bfrigon/alarm-clock-hardware/README.md

alarm-clock
===========

Project page at http://www.bfrigon.com/posts/projects/alarm-clock
