bfrigon/alarm-clock-hardware/drawings/schematics/README.md

Index
-----

Doc ID     | Part #            | Description
-----------|-------------------|-------------------------------------------------
CLK-SCH-01 | CLK-PC-01         | Led Matrix display board (Model A)
CLK-SCH-02 | CLK-PC-02         | Touch keypad
CLK-SCH-03 | CLK-PC-03         | Motherboard
CLK-SCH-04 | CLK-PC-04         | Left panel PCB
CLK-SCH-05 | CLK-PC-05         | Display (model B) - Segments PCB Schematic
CLK-SCH-06 | CLK-PC-06         | Display (model B) - Dots PCB Schematic
CLK-SCH-07 | CLK-PC-07         | Display (model B) - Base PCB Schematic
CLK-SCH-08 | CLK-PC-08         | Battery interface
CLK-SCH-50 | TST-CLK-PC-03-AUD | Test - PCM2704C + TPA2005 Eval board
CLK-SCH-51 | CLK-PC-01-PROG    | PIC programmer adapter for CLK-PC-01
