bfrigon/alarm-clock-hardware/drawings/design/README.md

Index
-----

Doc ID        | Part #            | Description
--------------|-------------------|-------------------------------------------------
CLK-DWG       | --                | Alarm clock (Model A)
CLK-DWG-MODEL-B | --              | Alarm clock (Model B)
CLK-DWG-01    | CLK-PC-01         | Led Matrix display board dimensions
CLK-DWG-02    | CLK-PC-02         | Touch keypad dimensions
CLK-DWG-03    | CLK-PC-03         | Motherboard dimensions
CLK-DWG-05    | CLK-PC-04         | Left panel PCB dimensions
CLK-DWG-06    | CLK-STR-01        | Display base
CLK-DWG-07    | CLK-OVL-01        | Keypad overlay
CLK-DWG-08    | CLK-PC-05         | Display (model B) - Segments PCB
CLK-DWG-09    | CLK-PC-06         | Display (model B) - Dots PCB
CLK-DWG-10    | CLK-PC-07         | Display (model B) - Base PCB
CLK-DWG-11    | CLK-STR-02        | Speaker holder
CLK-DWG-12    | CLK-PC-08         | Battery interface PCB
CLK-DWG-20    | CLK-AS-05         | Motherboard assembly
CLK-DWG-21    | CLK-AS-04         | Left panel PCB assembly
CLK-DWG-22    | CLK-AS-03         | Display (model A) - LED matrix
CLK-DWG-23    | CLK-AS-01         | Display (model A) - LED matrix PCB assembly
CLK-DWG-24    | CLK-AS-02         | Display (model A) - Assembly
CLK-DWG-25    | --                | Final assembly (Model A)
CLK-DWG-26    | CLK-AS-07         | Display (model B) - Segment PCB Assembly
CLK-DWG-27    | CLK-AS-08         | Display (model B) - Base PCB Assembly
CLK-DWG-28    | CLK-AS-06         | Display (model B) - Assembly
CLK-DWG-29    | CLK-AS-09         | Display (model B) - Dots PCB Assembly
CLK-DWG-30    | --                | Final assembly (Model B)
