bfrigon/alarm-clock-hardware/pcb/battery-interface/README.md

### Battery interface ###

```
Part #  : CLK-PC-08
REV.    : A
```

#### Documents ####

* [Schematic (PDF)](https://raw.githubusercontent.com/bfrigon/project-alarm-clock/master/drawings/schematics/clk-sch-08.pdf)
* [Bill of material](/pcb/battery-interface/bom/bom.md)
