bfrigon/alarm-clock-hardware/pcb/left-panel/README.md

### Left panel ###

```
Part #  : CLK-PC-04
REV.    : A
```

#### Documents ####

* [Schematic (PDF)](https://raw.githubusercontent.com/bfrigon/project-alarm-clock/master/drawings/schematics/clk-sch-04.pdf)
* [Bill of material](/pcb/left-panel/bom/bom.md)

#### 3D render ####

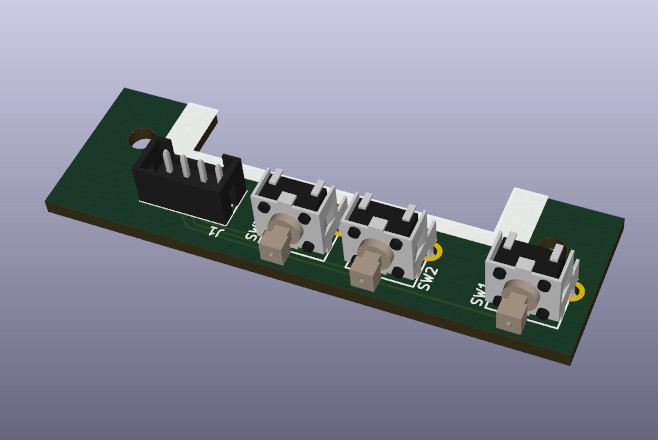
[picture p1: pcb/left-panel/3d/front.jpg]
Front view
