bfrigon/alarm-clock-hardware/pcb/motherboard/README.md

### Motherboard ###

```
Part #  : CLK-PC-03
REV.    : A
```

#### Documents ####

* [Schematic (PDF)](https://raw.githubusercontent.com/bfrigon/project-alarm-clock/master/drawings/schematics/clk-sch-03.pdf)
* [Bill of material](/pcb/motherboard/bom/bom.md)

#### 3D render ####

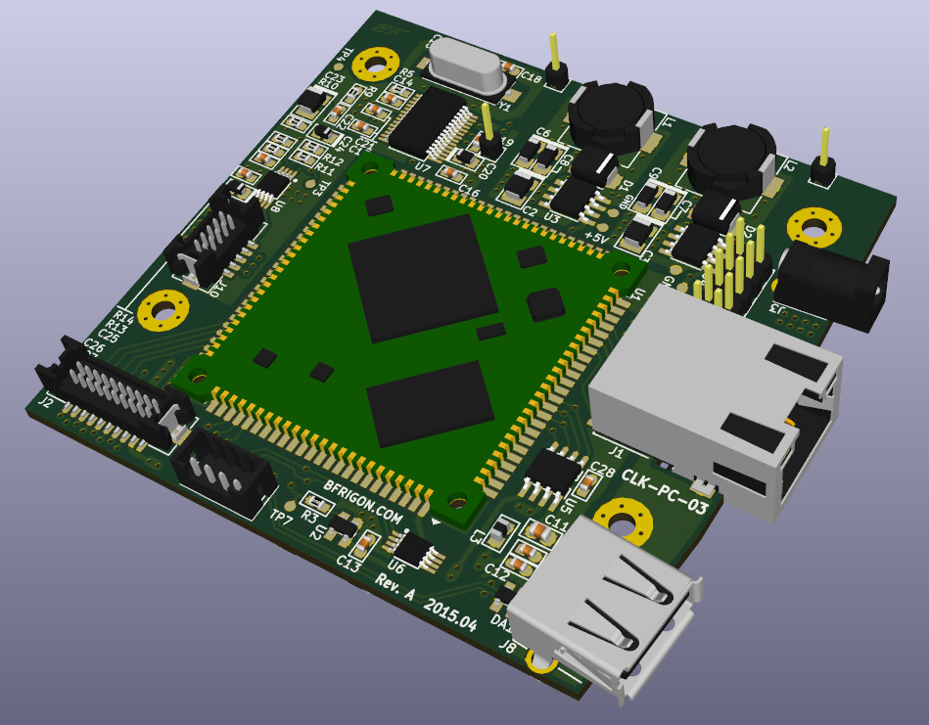
[picture p2: pcb/motherboard/3d/front.jpg]
Front view
