bfrigon/alarm-clock-hardware/docs/notes/psu.md

### Power requirements ###

Description        | 5V        |  3.3V
-------------------|-----------|----------------
USB A (external)   | 500 mA    | --
USB B (internal)   | 500 mA    | --
Display            | --        | 1250 mA
CPU                | --        | 400 mA
Audio DAC          | 50 mA     | --
Amplifier          | 400 mA    | --
Touch keypad       | --        | 65 mA
-------------------|-----------|----------------
Total              | 1450 mA   | 1700mA
-------------------|-----------|---------------
+~25% overhead     | 1800 mA   | 2125mA
