bfrigon/alarm-clock-hardware/drawings/artwork/overlay-rev-a.pdf

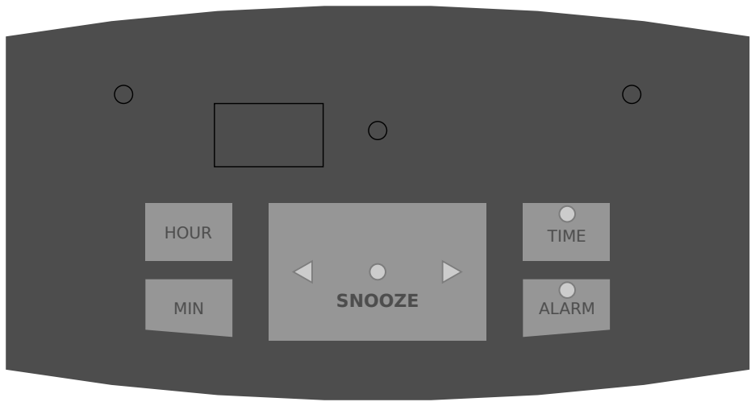
[picture p3: figure]
HOUR; MIN; TIME; ALARM SNOOZE
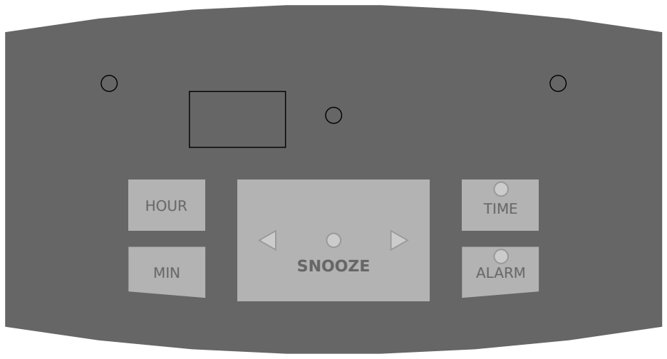
[picture p4: figure]
HOUR; MIN; TIME; ALARM SNOOZE
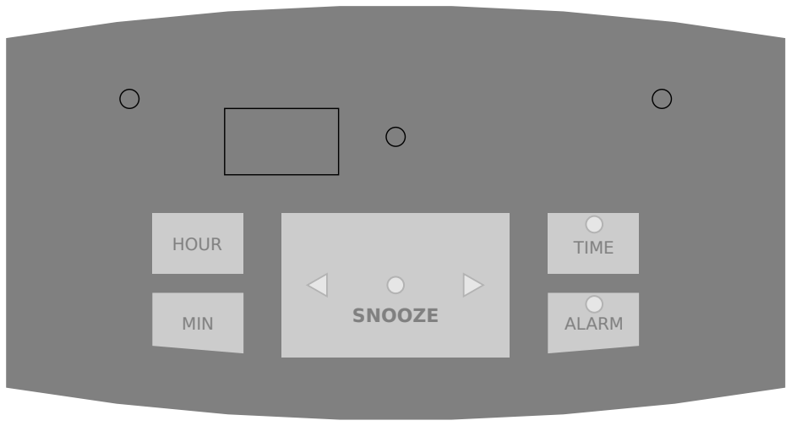
[picture p5: figure]
HOUR; MIN; TIME; ALARM SNOOZE
