bfrigon/alarm-clock-hardware/docs/model-render/concepts/concept.jpg

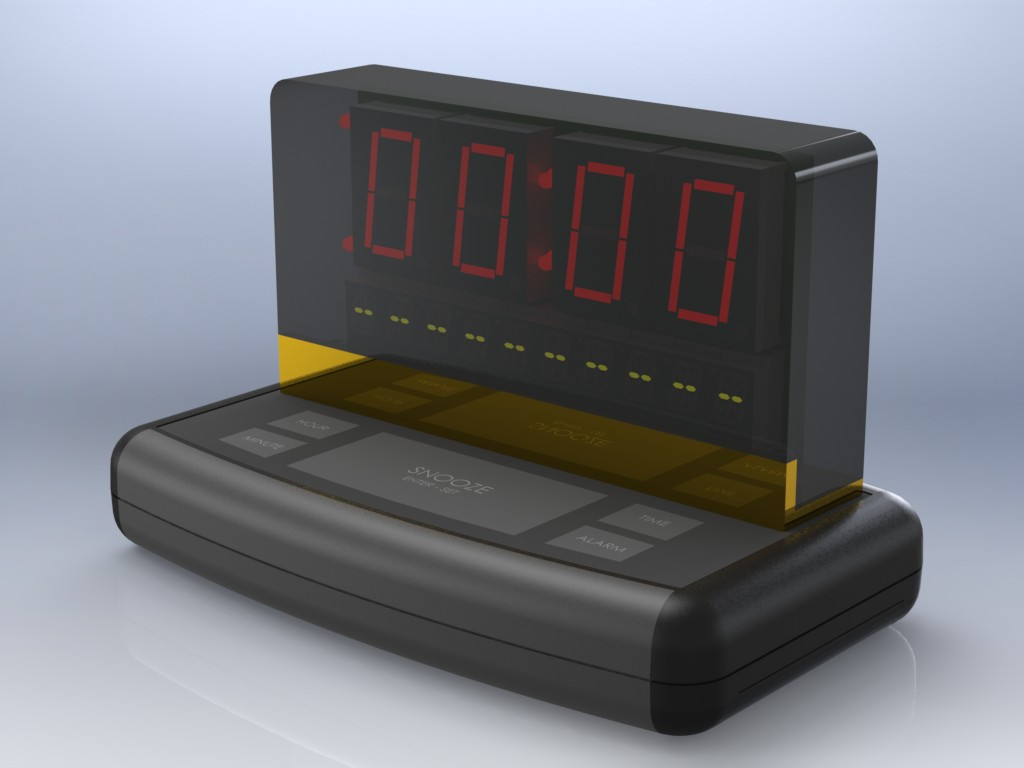
docs/model-render/concepts/concept.jpg
