bfrigon/alarm-clock-hardware/docs/model-render/concepts/concept_3.jpg

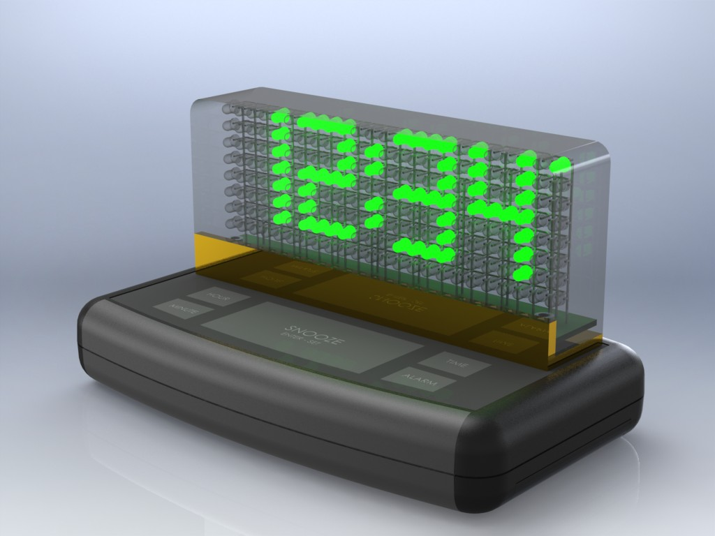
docs/model-render/concepts/concept_3.jpg
