bfrigon/alarm-clock-hardware/docs/model-render/model-a-back.jpg

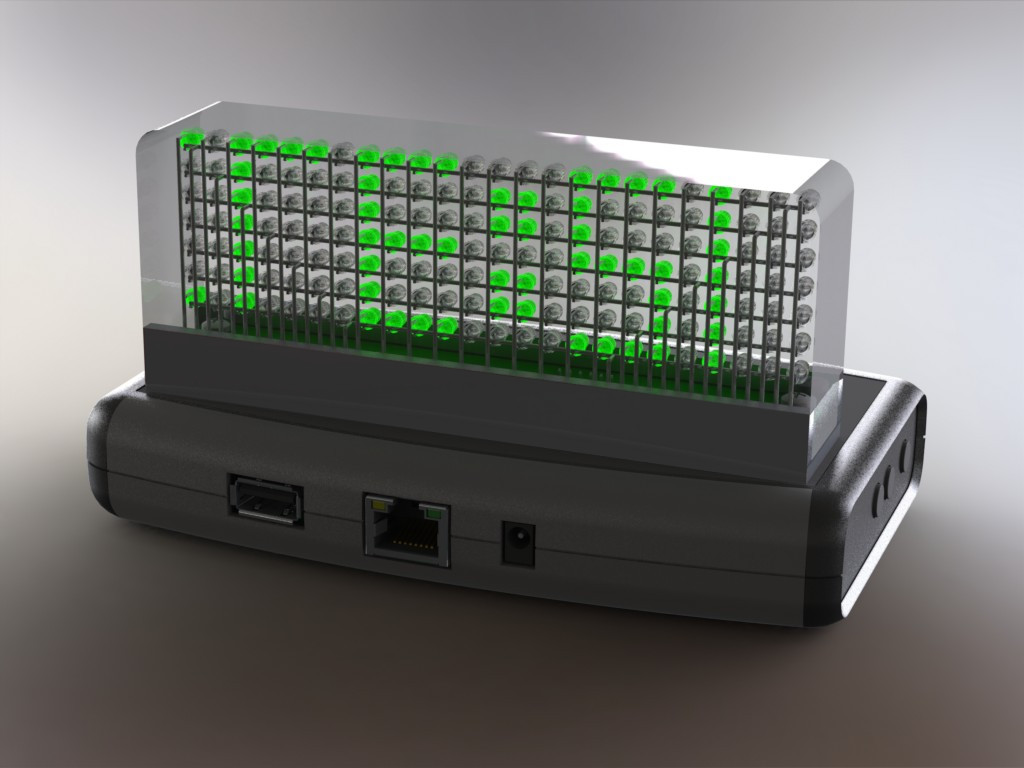
docs/model-render/model-a-back.jpg
