bfrigon/alarm-clock-hardware/docs/model-render/model-a-dark.jpg

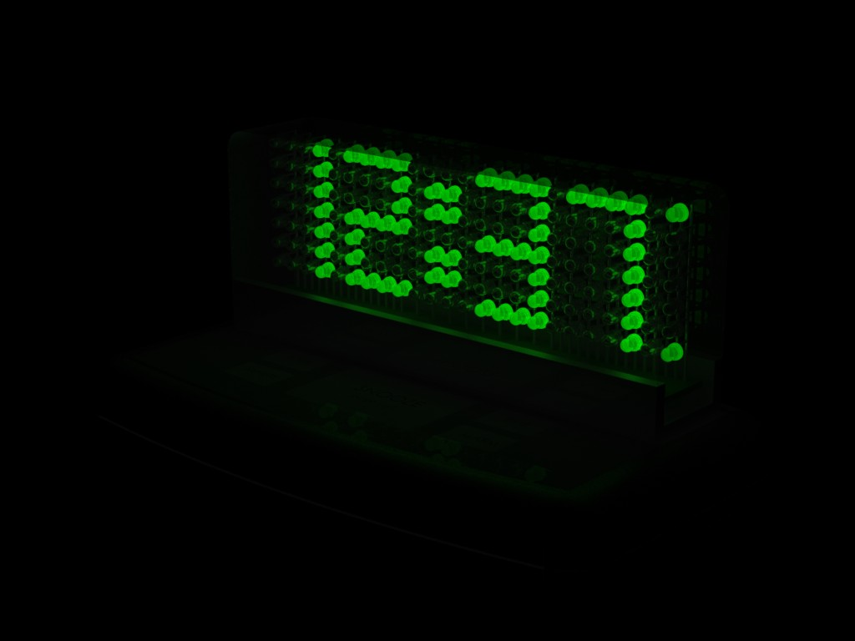
docs/model-render/model-a-dark.jpg
