bfrigon/alarm-clock-hardware/docs/model-render/model-a-mb.jpg

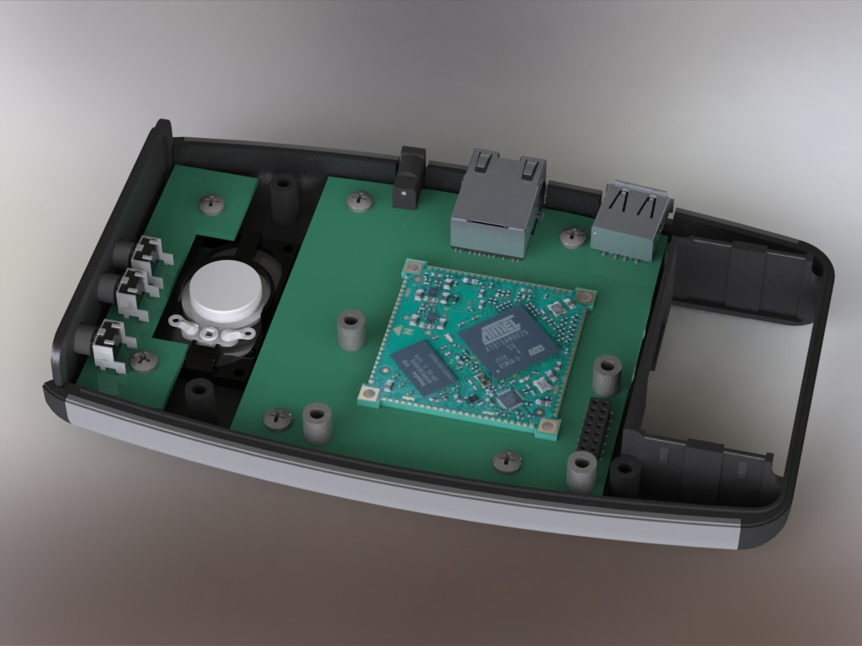
docs/model-render/model-a-mb.jpg
