bfrigon/alarm-clock-hardware/docs/model-render/model-a.jpg

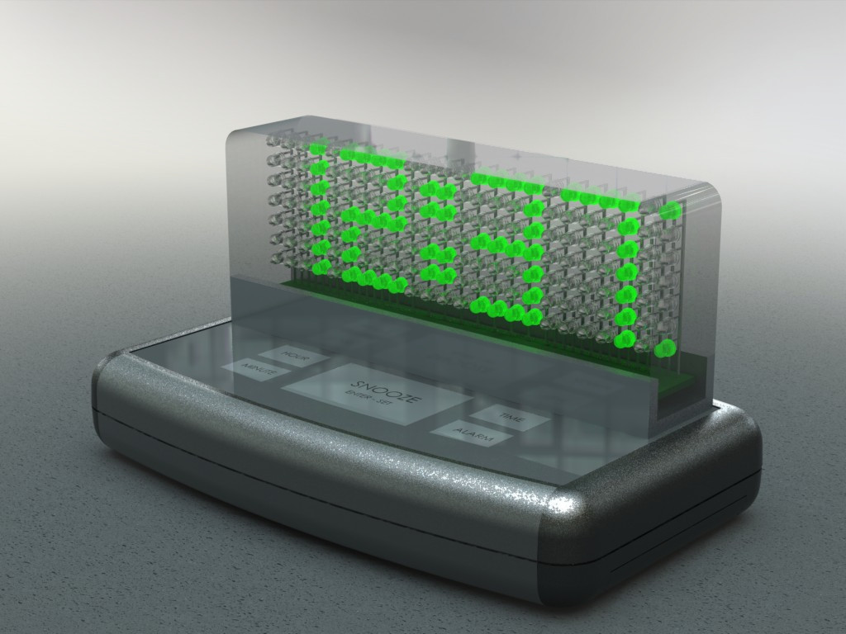
docs/model-render/model-a.jpg
