bfrigon/alarm-clock-hardware/docs/model-render/model-b.jpg

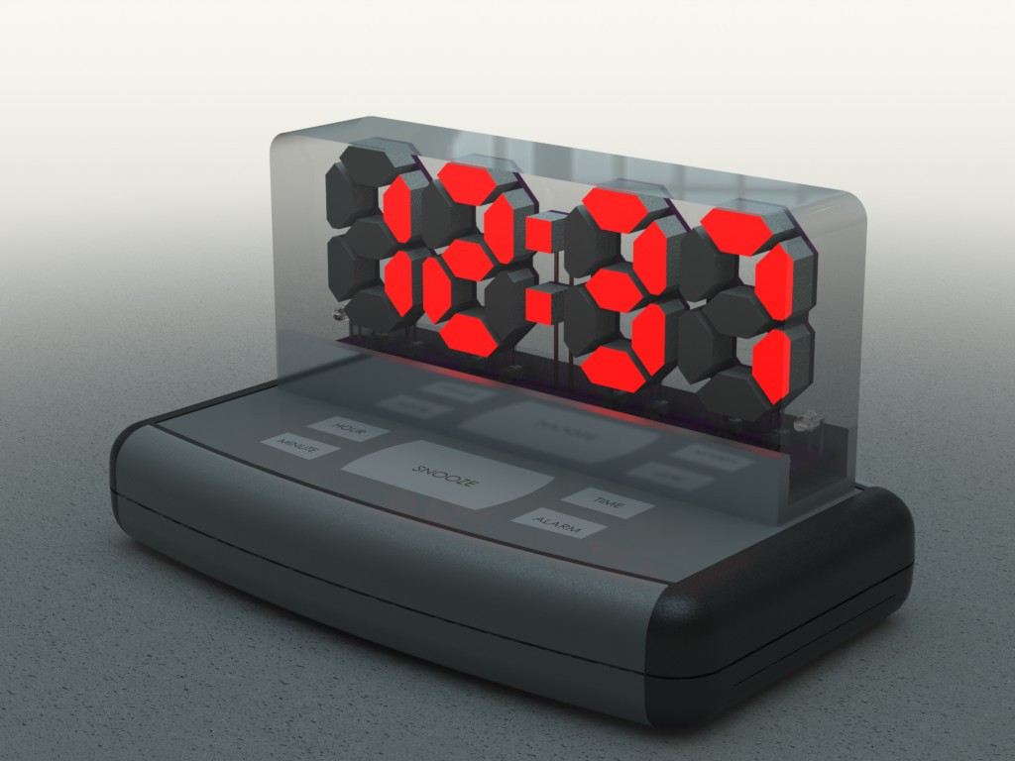
docs/model-render/model-b.jpg
