bfrigon/alarm-clock-hardware/pcb/motherboard/3d/back.jpg

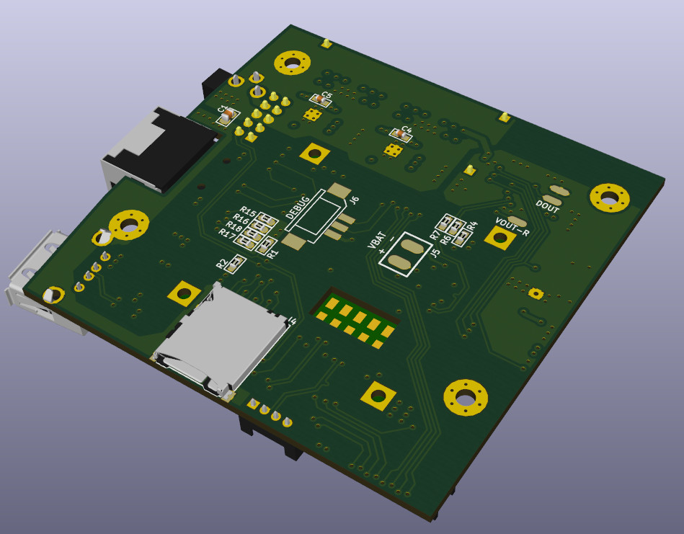
pcb/motherboard/3d/back.jpg
