bfrigon/alarm-clock-hardware/pcb/motherboard/bom/bom.md

### Bill of material ###

```
Date    : Sun 12 Apr 2015
Doc. ID : CLK-SCH-03
Project : Alarm Clock
Title   : Motherboard

Part #  : CLK-PC-03
REV.    : A

Components : 73
```

------------------------------------------------------------------------------------------------------------------------

| Qty | Ref. | Description | Value | Part # | Footprint |
|-----|---|---|---|---|---|
| 3 | J11-J12, J16 | Header - Single Row - 1 Pos | - | 103741-1 | HDR-M-1x01 |
| 1 | J9 | Header - Dual Row - 10 Pos | - | 103777-5 | HDR-M-2x05 |
| 1 | J8 | USB Connector - Type A | - | 292303-1 | USBA-TE-292303-1 |
| 1 | J1 | RJ45 Connector with magnetics and leds | - | 7498011122R | RJ45-WURTH-7498011122R  |
| 1 | J10 | Header - Dual Row - 10 Pos | - | DF13A-10DP-1.25V | DF13A-10DP-1.25 |
| 1 | J2 | Header - Dual Row - 20 Pos | - | DF13A-20DP-1.25V(25) | DF13A-20DP-1.25 |
| 1 | J7 | Header - Single Row - 4 Pos | - | DF3A-4P-2DSA | DF3A-4P-2DSA |
| 1 | J6 | Header - Single Row - 3 Pos | - | DF3DZ-3P-2V21 | DF3DZ-3P-2VXX |
| 1 | J4 | Micro SD card connector | - | DM3AT-SF-PEJM5 | HIROSE-MICROSD-DM3AT-SF |
| 1 | J3 | DC Barrel Jack | - | PJ-013C | CUI-PJ-031CH |
| 1 | U3 | 2A Step-down regulator | - | ADP2302ARDZ-5.0 | SOIC-8-EP |
| 1 | U4 | 3A Step-down regulator | - | ADP2303ARDZ-3.3 | SOIC-8-EP |
| 1 | U1 | AT91SAM9G25 SoM | - | ARIA-G25 | Misc:ARIA-G25 |
| 1 | U2 | 4-Pin Microprocessor Power Supply Supervisors | - | CAT811TTBI-T3 | SOT-143 |
| 1 | U5 | Dual port USB power switch with OC protection | - | LM3526M-H | SOIC-8 |
| 1 | U6 | Digital Temperature Sensor | - | MCP9804 | MSOP8 |
| 1 | U7 | Stereo Audio DAC with USB Interface | - | PCM2704C | SSOP28 |
| 1 | U8 | 1.4W Mono Class-D Audio Amplifier | - | TPA2005 | PPSOP8 |
| 1 | C22 | capacitor | 0.022uF (10V) | - | SMT-0603 |
| 2 | R4-R5 | Resistor | 1.5k | - | SMT-0603 |
| 6 | R11, R14-R18 | Resistor | 100k | - | SMT-0603 |
| 2 | C4-C5 | capacitor | 100nF 25V | - | SMT-0603 |
| 4 | C10, C12-C13, C28 | capacitor | 100nF | - | SMT-0603 |
| 1 | C23 | Electrolytic capacitor | 100uF (10V) | - | SMT-1210 |
| 1 | C11 | capacitor | 100uF | - | SMT-0805 |
| 2 | R1-R2 | Resistor | 10k | - | SMT-0603 |
| 2 | C20, C27 | Electrolytic capacitor | 10uF | - | SMT-0805 |
| 1 | Y1 | Crystal | 12.00 Mhz | - | HC49UP |
| 2 | R12-R13 | Resistor | 150k | - | SMT-0603 |
| 1 | R9 | Resistor | 16 (1%) | - | SMT-0603 |
| 2 | C15, C18 | capacitor | 18pF | - | SMT-0603 |
| 1 | L3 | Inductor | 1A | - | SMT-0805 |
| 1 | R8 | Resistor | 1M | - | SMT-0603 |
| 1 | C1 | capacitor | 1nF (1kV) | - | SMT-0805 |
| 1 | C24 | Electrolytic capacitor | 1uF (10V) | - | SMT-0805 |
| 7 | C14, C16-C17, C19, C21, C25-C26 | capacitor | 1uF | - | SMT-0603 |
| 1 | R3 | Resistor | 2.2k | - | SMT-0603 |
| 2 | R6-R7 | Resistor | 22 | - | SMT-0603 |
| 1 | R10 | Resistor | 330 | - | SMT-0603 |
| 1 | DA1 | TVS Diode Array | CD143A-SR05 | - | SOT-143 |
| 2 | L1-L2 | Inductor | 4.3uH | 7443552430 | SMT:IND-10X10 |
| 2 | D1-D2 | Diode | 30V 2A | B320B-13-F | SMT:DO-214-AA |
| 2 | C2-C3 | Electrolytic capacitor | 100uF (16v) | EMK325ABJ107MM-T | SMT-1210 |
| 2 | C7, C9 | Electrolytic capacitor | 47uF (6.3v) | GRM31CR60J476ME19K | SMT-1206 |
| 2 | C6, C8 | Electrolytic capacitor | 47uF (10v) | LMK316BJ476ML-T | SMT-1206 |
