bfrigon/alarm-clock-hardware/pcb/left-panel/bom/bom.md

### Bill of material ###

```
Date    : Thu 19 Mar 2015
Doc. ID : CLK-SCH-04
Project : Alarm Clock
Title   : Left Panel

Part #  : CLK-PC-04
REV.    : A

Components : 4
```

------------------------------------------------------------------------------------------------------------------------

| Qty | Ref. | Description | Value | Part # | Footprint |
|-----|---|---|---|---|---|
| 1 | J1 | Header - Single Row - 4 Pos | - | DF3A-4P-2DSA | DF3A-4P-2DSA |
| 3 | SW1-SW3 | Momentary SPST switch with ground tabs | - | B3F-3150 | Switches:B3F-315X |
