bfrigon/alarm-clock-hardware/pcb/display-model-a/bom/bom.ods

Bill of material - Title (Rev. A) Part #
Qty. | Part ID | Description | Mfg. SKU | Manufacturer | Package | Value
3
