bfrigon/alarm-clock-hardware/drawings/digits_segments_cuts.dxf

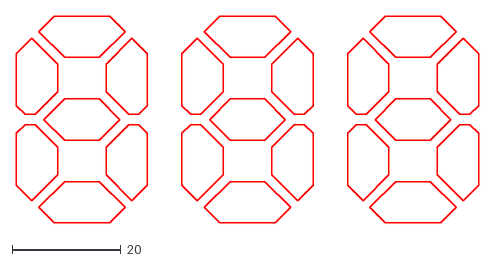
[picture p14: CAD file, 2014-10-28]
drawings/digits_segments_cuts.dxf
85.1 x 38.1
