bfrigon/alarm-clock-hardware/drawings/enclosure_cuts_back.dxf

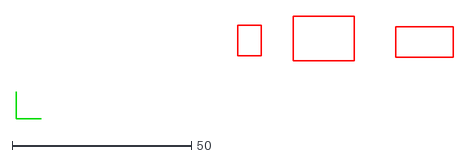
[picture p15: CAD file, 2014-10-28]
drawings/enclosure_cuts_back.dxf
121.8 x 28.7
