bfrigon/alarm-clock-hardware/drawings/design/clk-dwg-24.pdf

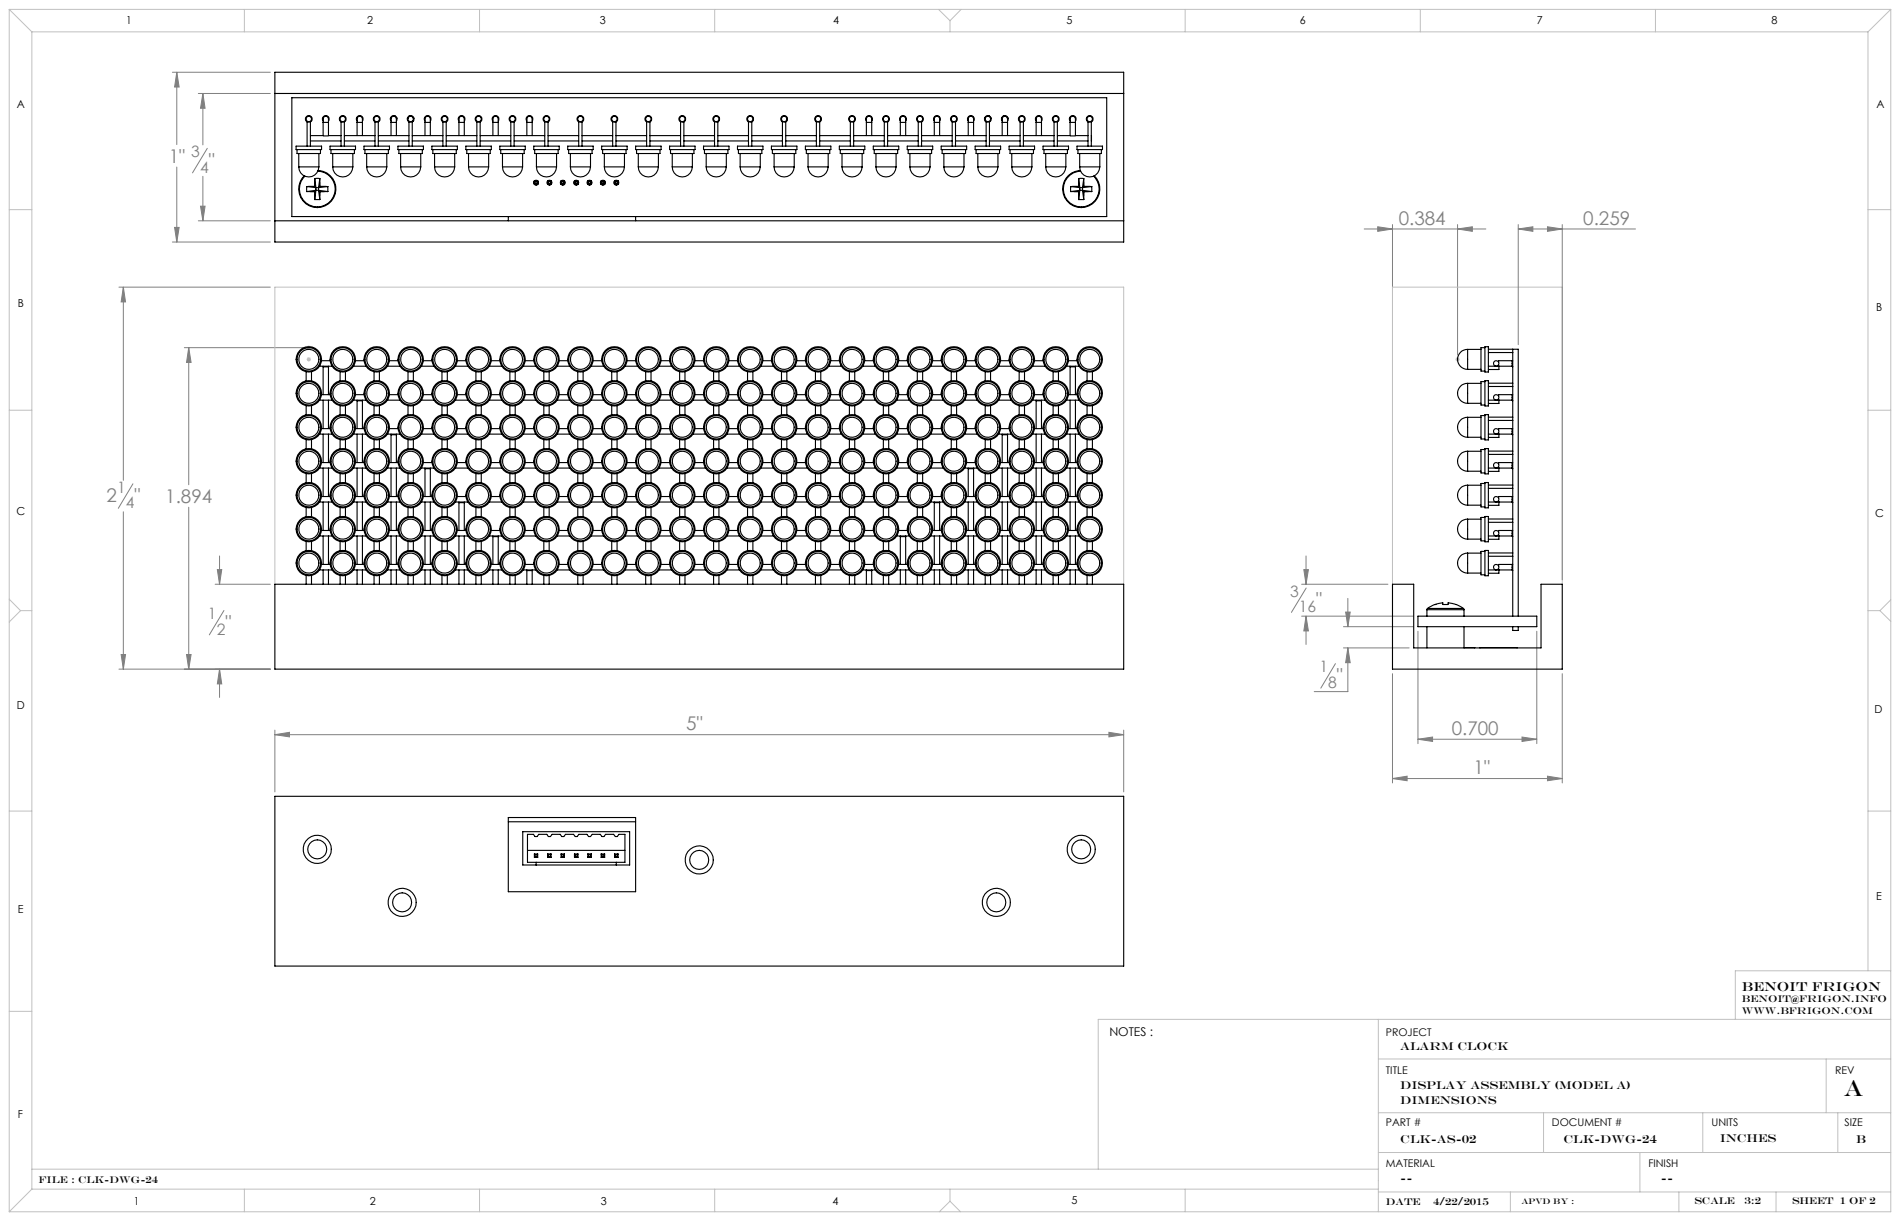
[picture p16: page 1]
SHEET 1 OF 2; Alarm Clock; Display Assembly (Model A); PART #; DOCUMENT #; UNITS; DATE 4/22/2015; SCALE 3:2; NOTES :; APVD BY :

BENOIT FRIGON
benoit@frigon.info
www.bfrigon.com

File : clk-dwg-24

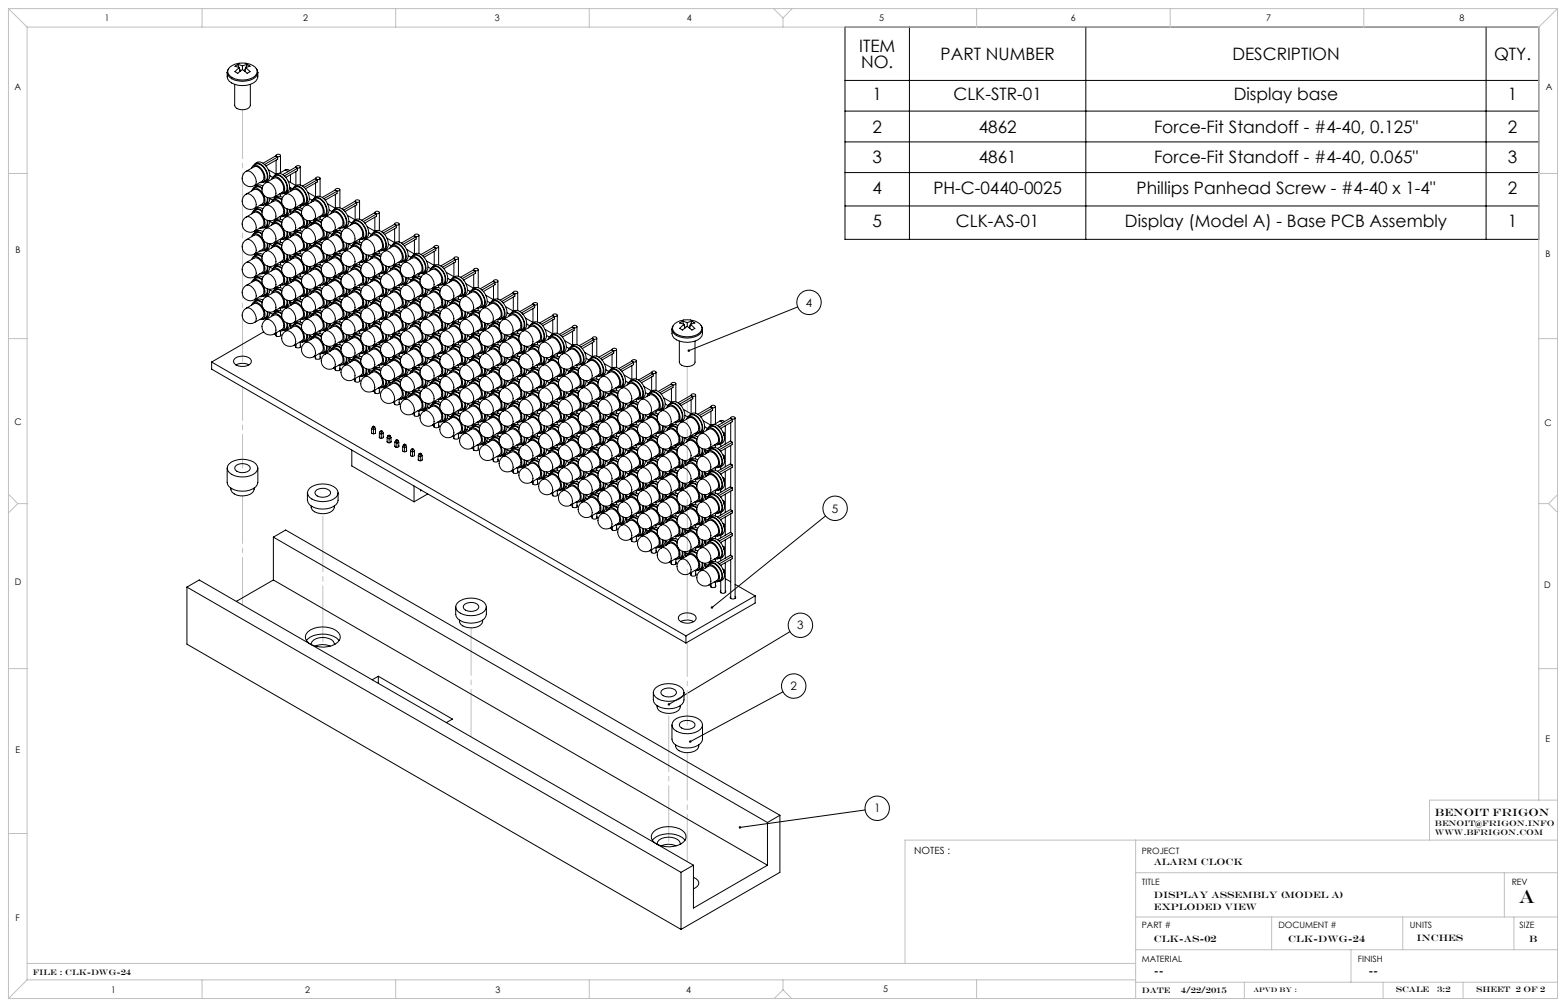
[picture p17: page 2]
SHEET 2 OF 2; Alarm Clock; Display Assembly (Model A); PART #; DOCUMENT #; UNITS; DATE 4/22/2015; SCALE 3:2; NOTES :; Exploded view; APVD BY :

ITEM NO. | PART NUMBER | DESCRIPTION | QTY.

1 | CLK-STR-01 | Display base | 1
2 | 4862 | Force-Fit Standoff - #4-40, 0.125" | 2
3 | 4861 | Force-Fit Standoff - #4-40, 0.065" | 3
4 | PH-C-0440-0025 | Phillips Panhead Screw - #4-40 x 1-4" | 2
5 | CLK-AS-01 | Display (Model A) - Base PCB Assembly | 1

BENOIT FRIGON
benoit@frigon.info
www.bfrigon.com

File : clk-dwg-24
