bfrigon/alarm-clock-hardware/drawings/design/clk-dwg-25.pdf

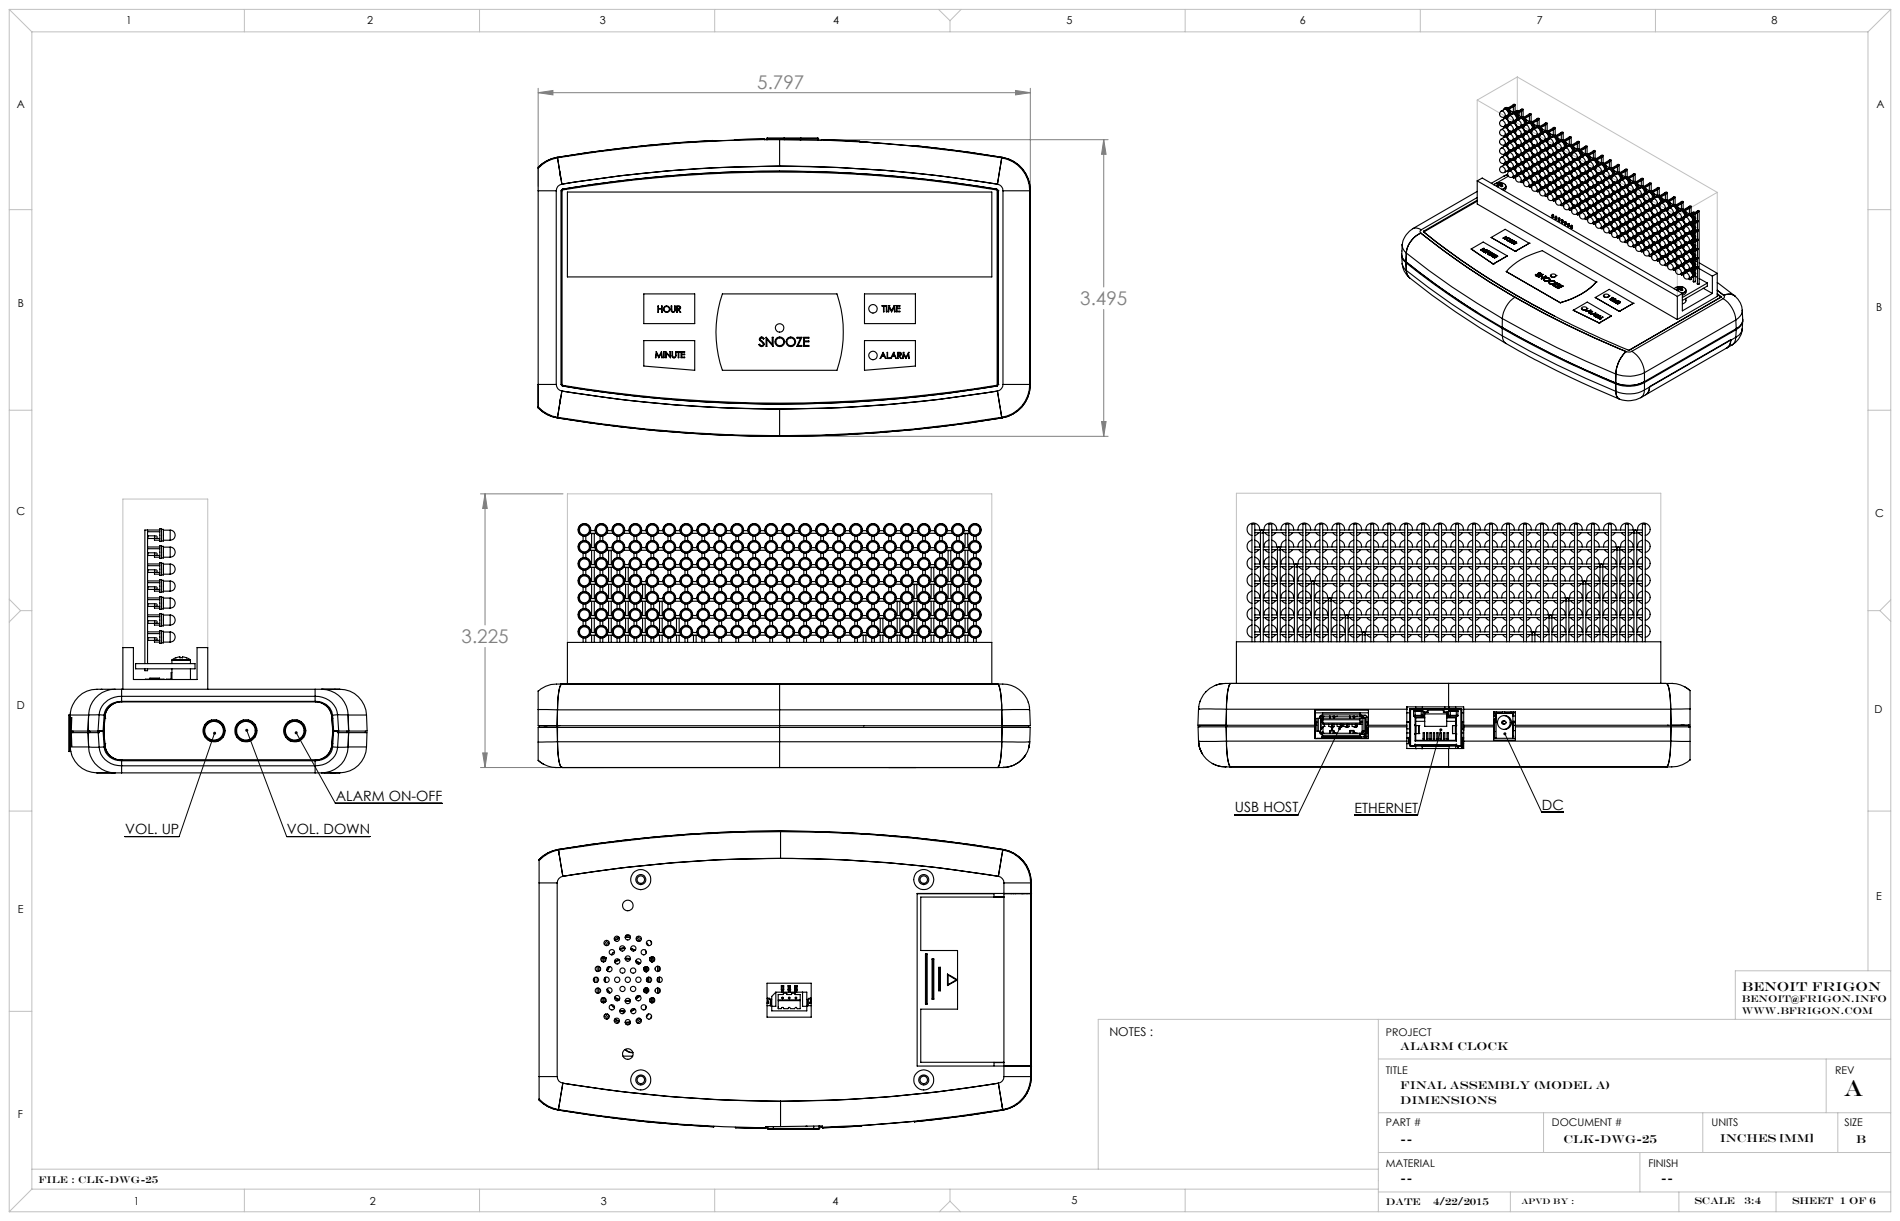
[picture p18: page 1]
VOL. UP; VOL. DOWN; USB HOST; ETHERNET; SHEET 1 OF 6; Alarm Clock; Final assembly (Model A); PART #; DOCUMENT #; UNITS; INCHES [MM]; DATE 4/22/2015; SCALE 3:4; NOTES :; APVD BY :

ALARM ON-OFF

BENOIT FRIGON
benoit@frigon.info
www.bfrigon.com

File : clk-dwg-25

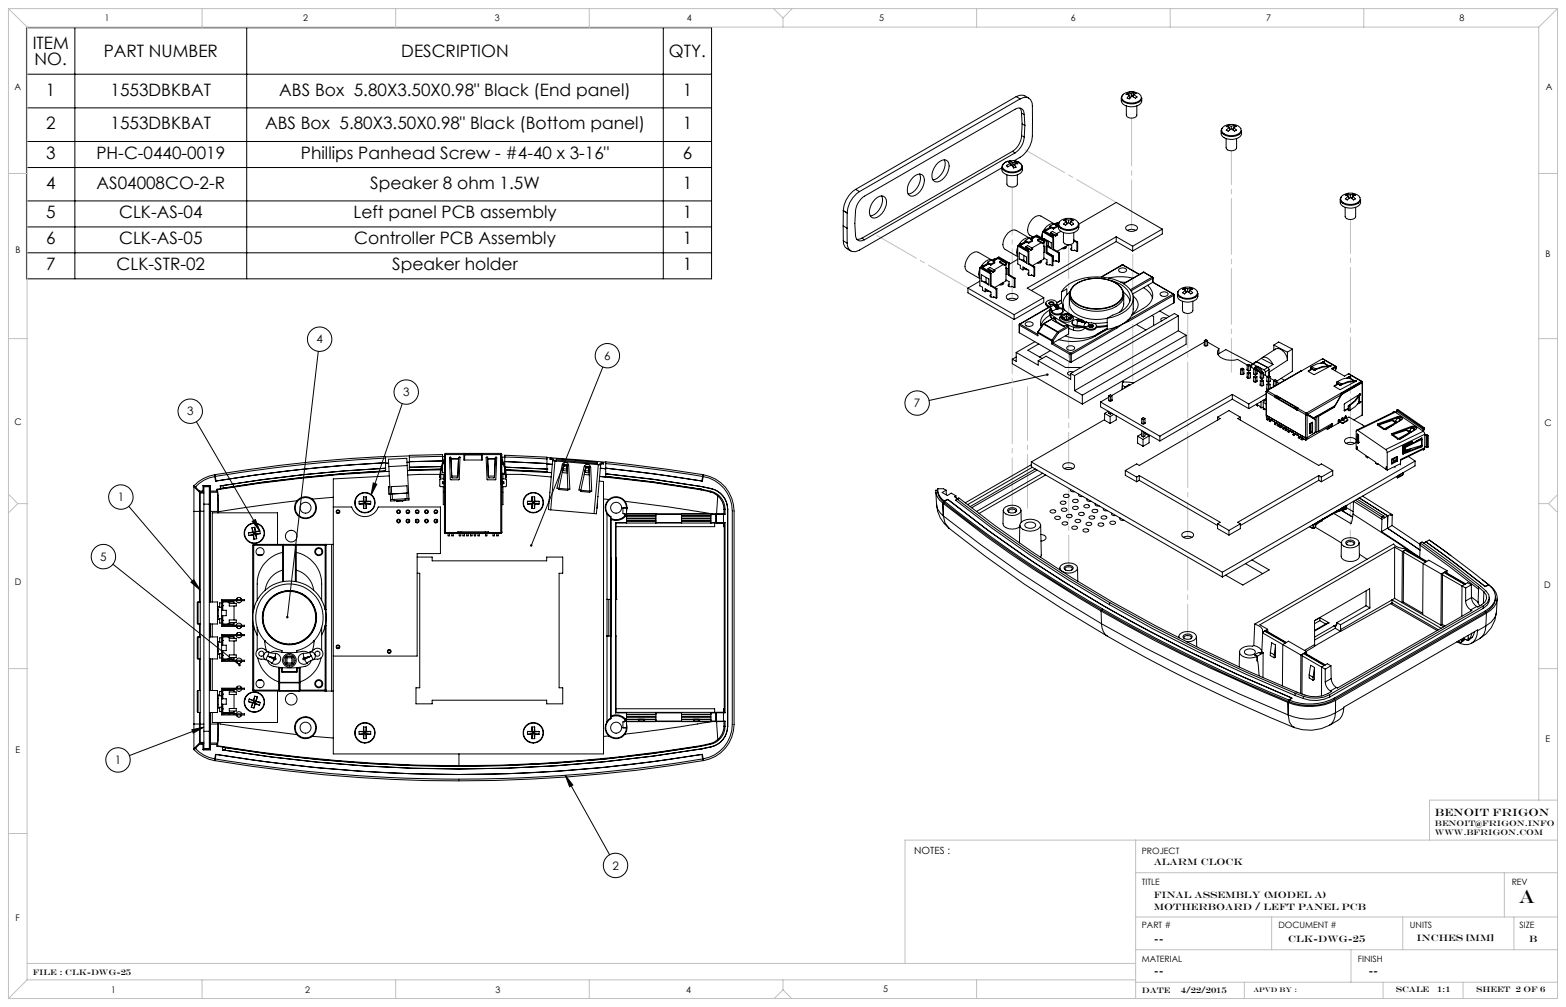
[picture p19: page 2]
SHEET 2 OF 6; DOCUMENT #; UNITS; SCALE 1:1; NOTES :

ITEM NO. | PART NUMBER | DESCRIPTION | QTY.

1 | 1553DBKBAT | ABS Box 5.80X3.50X0.98" Black (End panel) | 1
2 | 1553DBKBAT | ABS Box 5.80X3.50X0.98" Black (Bottom panel) | 1
3 | PH-C-0440-0019 | Phillips Panhead Screw - #4-40 x 3-16" | 6
4 | AS04008CO-2-R | Speaker 8 ohm 1.5W | 1
5 | CLK-AS-04 | Left panel PCB assembly | 1
6 | CLK-AS-05 | Controller PCB Assembly | 1
7 | CLK-STR-02 | Speaker holder | 1

BENOIT FRIGON
benoit@frigon.info
www.bfrigon.com

PROJECT
Alarm Clock
TITLE
Final assembly (Model A)
Motherboard / Left panel PCB
PART #

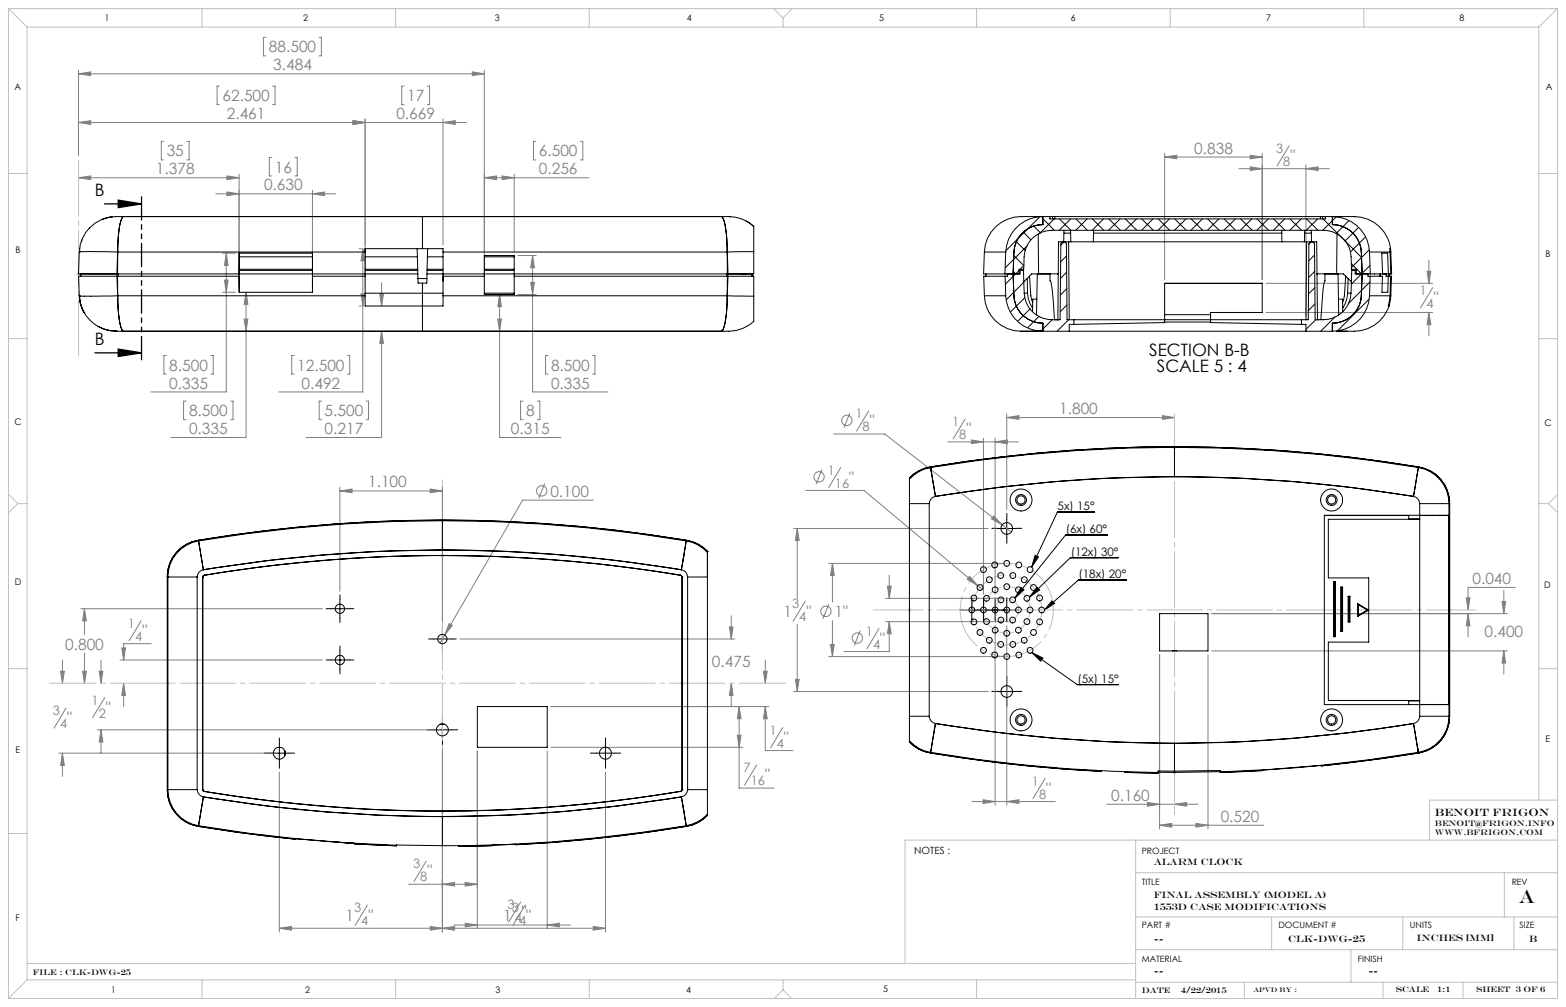
[picture p20: page 3]
SECTION B-B SCALE 5 : 4; SHEET 3 OF 6; DOCUMENT #; UNITS; NOTES :

BENOIT FRIGON
benoit@frigon.info
www.bfrigon.com

PROJECT
Alarm Clock
TITLE
Final assembly (Model A)
1553D Case modifications
PART #

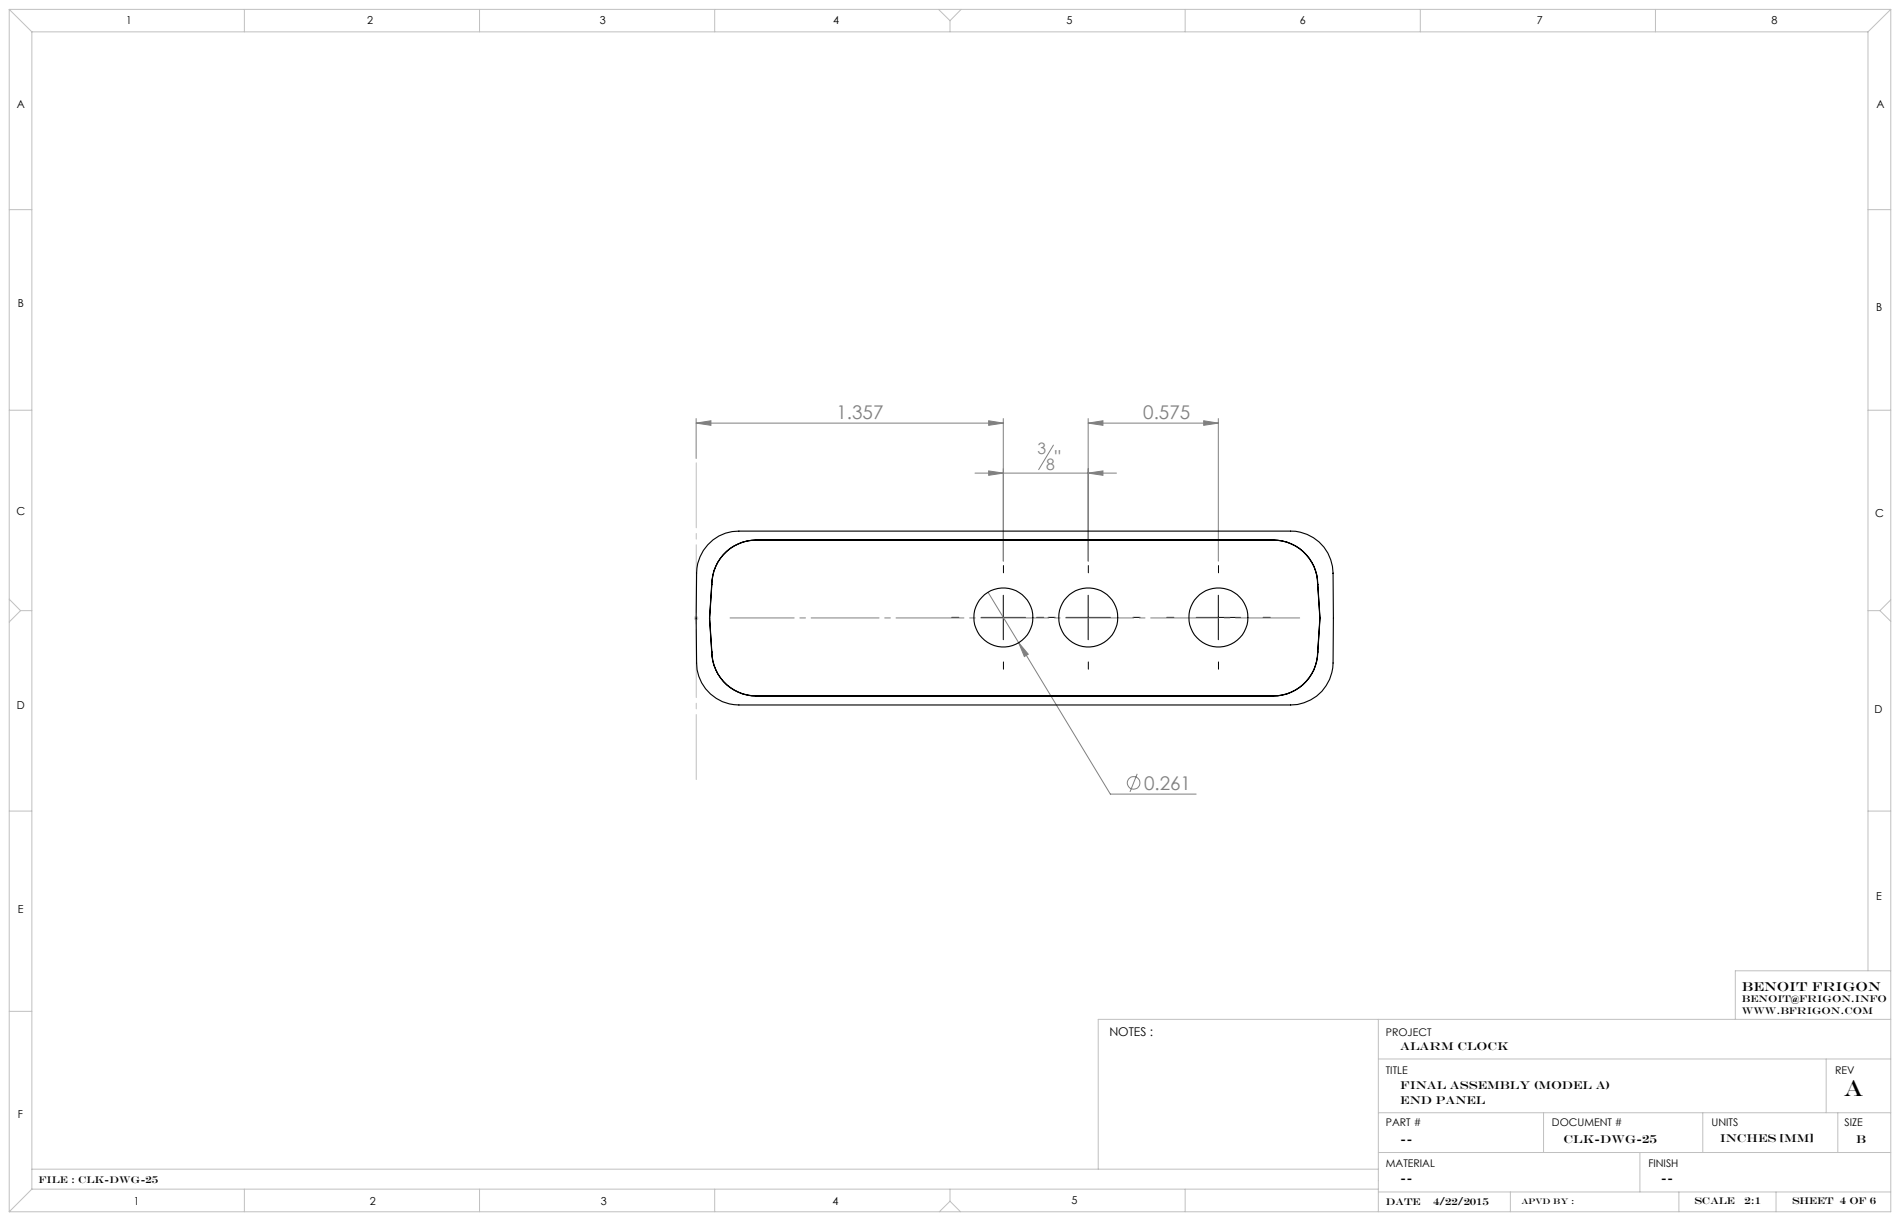
[picture p21: page 4]
SHEET 4 OF 6; DOCUMENT #; UNITS; SCALE 2:1; NOTES :

BENOIT FRIGON
benoit@frigon.info
www.bfrigon.com

PROJECT
Alarm Clock
TITLE
Final assembly (Model A)
End Panel
PART #

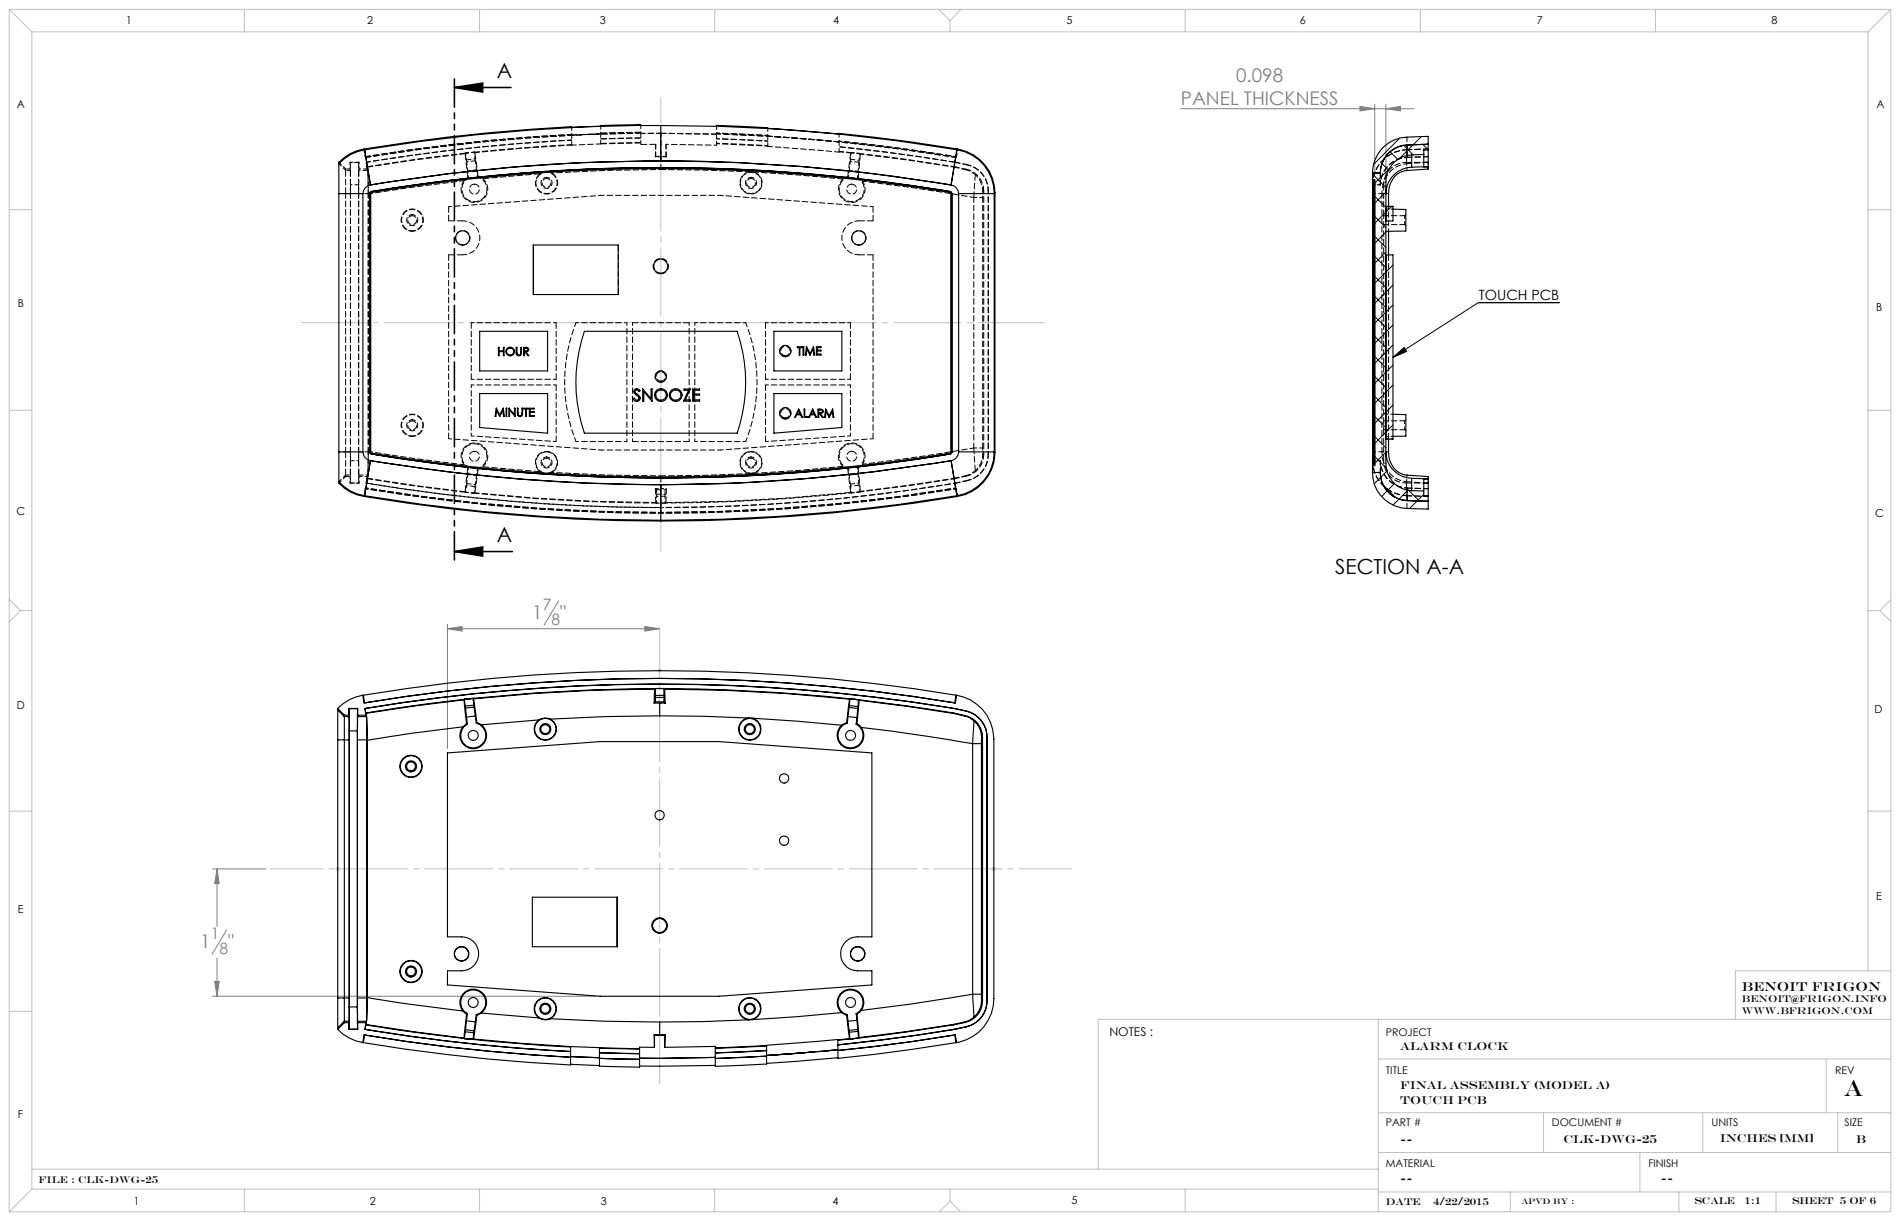
[picture p22: page 5]
PANEL THICKNESS; SECTION A-A; TOUCH PCB; SHEET 5 OF 6; DOCUMENT #; UNITS; NOTES :

BENOIT FRIGON
benoit@frigon.info
www.bfrigon.com

PROJECT
Alarm Clock
TITLE
Final assembly (Model A)
Touch PCB
PART #

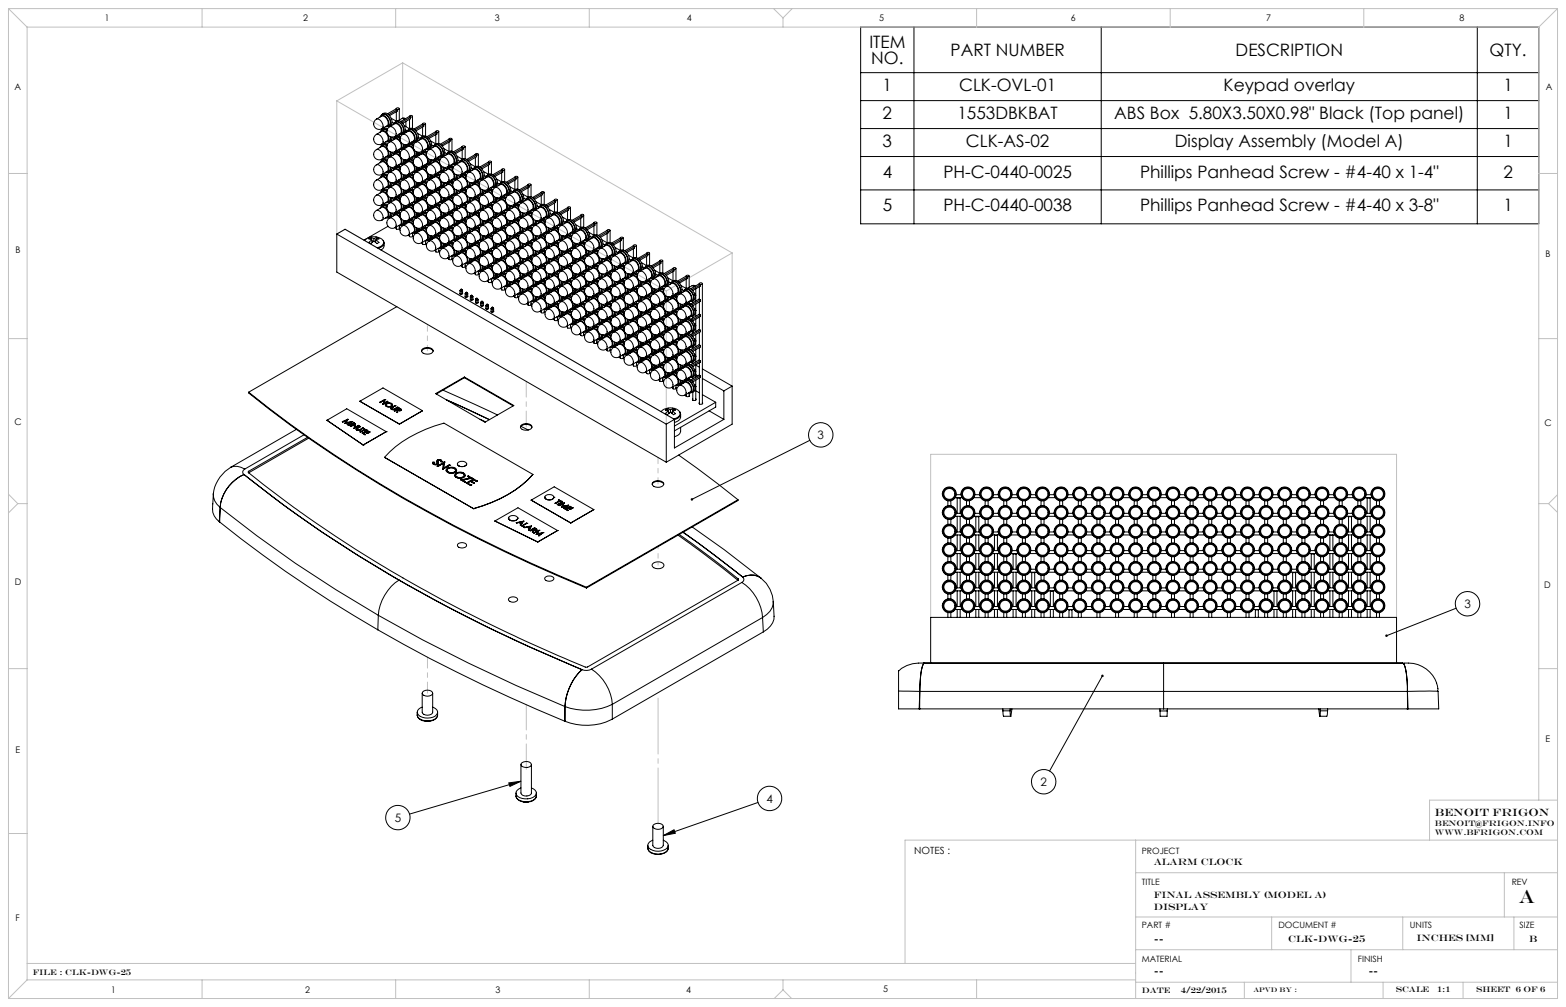
[picture p23: page 6]
SHEET 6 OF 6; DOCUMENT #; UNITS; NOTES :

ITEM NO. | PART NUMBER | DESCRIPTION | QTY.
1 | CLK-OVL-01 | Keypad overlay | 1
2 | 1553DBKBAT | ABS Box 5.80X3.50X0.98" Black (Top panel) | 1
3 | CLK-AS-02 | Display Assembly (Model A) | 1
4 | PH-C-0440-0025 | Phillips Panhead Screw - #4-40 x 1-4" | 2
5 | PH-C-0440-0038 | Phillips Panhead Screw - #4-40 x 3-8" | 1

BENOIT FRIGON
benoit@frigon.info
www.bfrigon.com

PROJECT
Alarm Clock
TITLE
Final assembly (Model A)
Display
PART #
