bfrigon/alarm-clock-hardware/drawings/design/clk-dwg-28.pdf

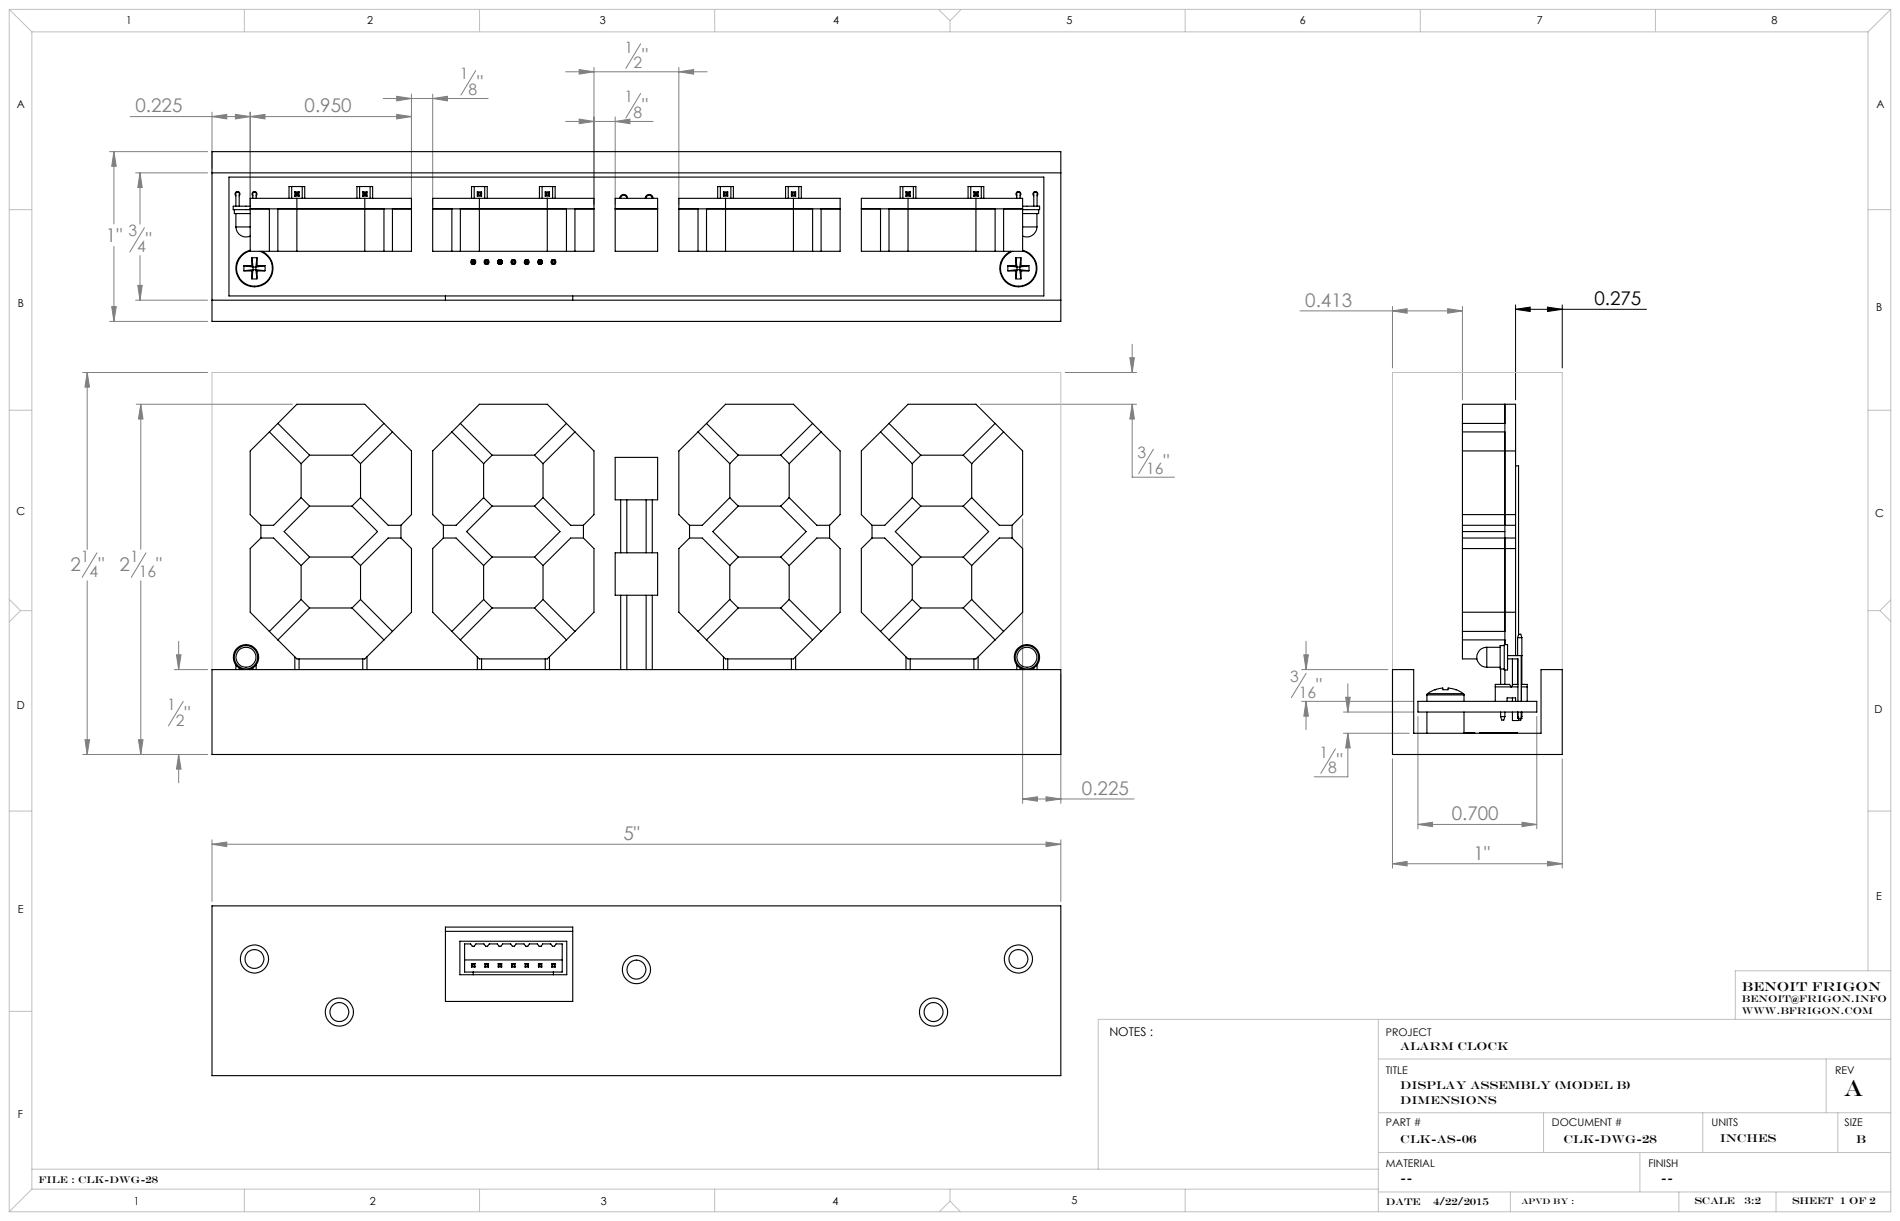
[picture p24: page 1]
SHEET 1 OF 2; Alarm Clock; Display Assembly (Model B); PART #; DOCUMENT #; UNITS; DATE 4/22/2015; SCALE 3:2; NOTES :; APVD BY :

BENOIT FRIGON
benoit@frigon.info
www.bfrigon.com

File : clk-dwg-28

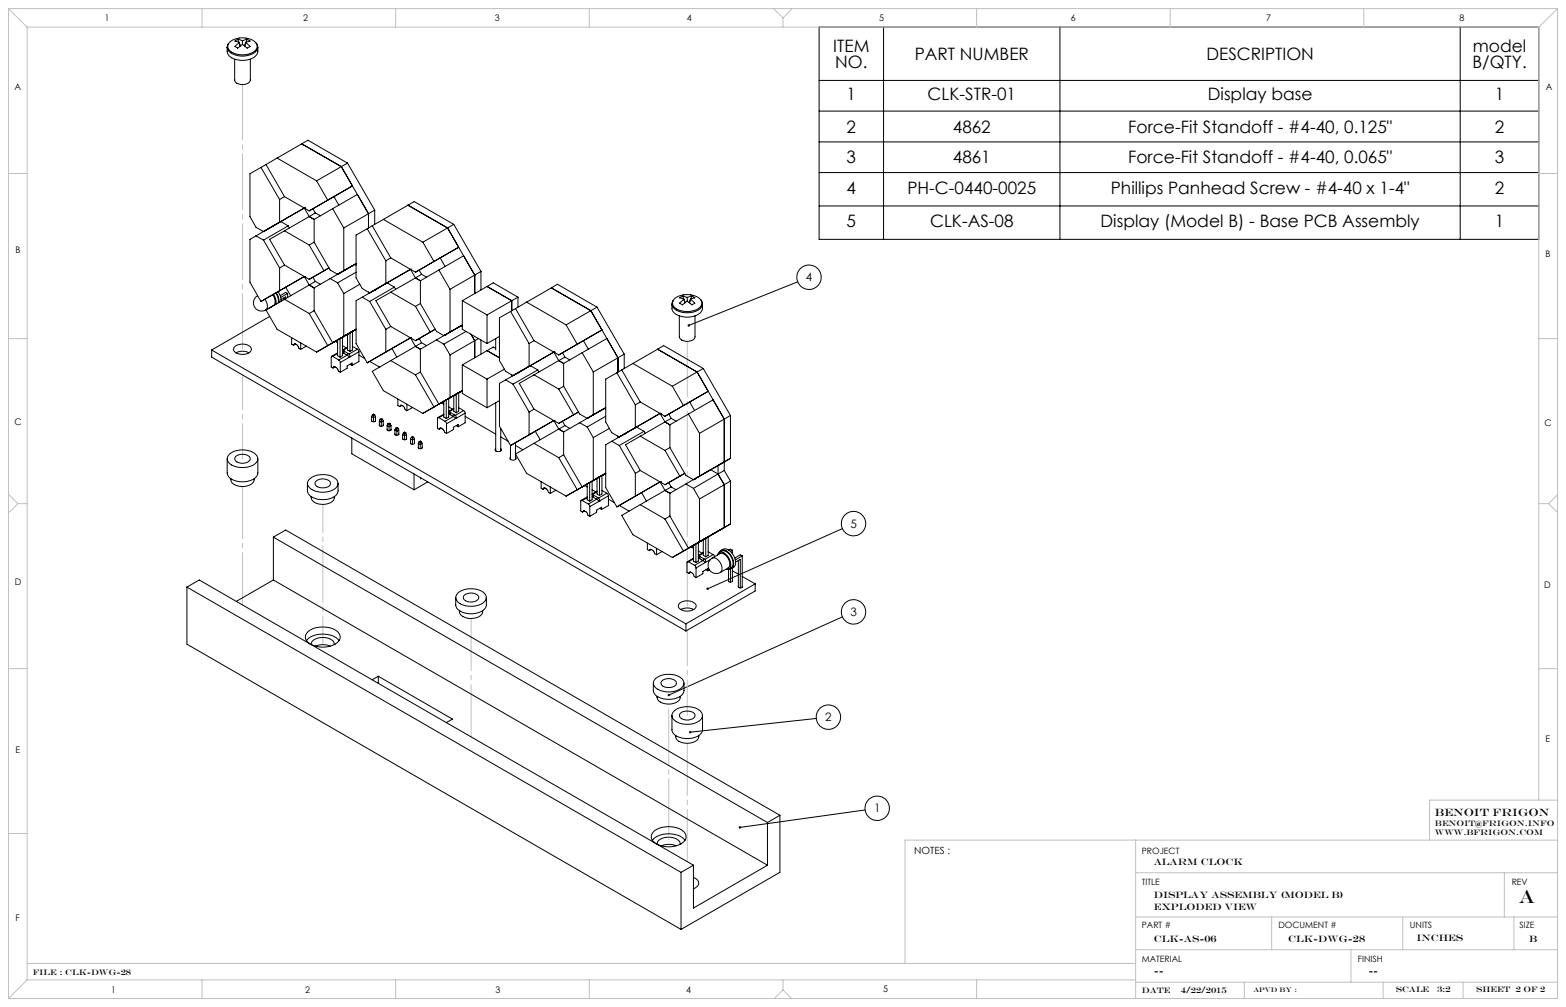
[picture p25: page 2]
SHEET 2 OF 2; Alarm Clock; Display Assembly (Model B); PART #; DOCUMENT #; UNITS; DATE 4/22/2015; SCALE 3:2; NOTES :; Exploded view; APVD BY :

ITEM NO. | PART NUMBER | DESCRIPTION | model B/QTY.

1 | CLK-STR-01 | Display base | 1
2 | 4862 | Force-Fit Standoff - #4-40, 0.125" | 2
3 | 4861 | Force-Fit Standoff - #4-40, 0.065" | 3
4 | PH-C-0440-0025 | Phillips Panhead Screw - #4-40 x 1-4" | 2
5 | CLK-AS-08 | Display (Model B) - Base PCB Assembly | 1

BENOIT FRIGON
benoit@frigon.info
www.bfrigon.com

File : clk-dwg-28
