bfrigon/alarm-clock-hardware/drawings/design/clk-dwg.pdf

VOL. UP; VOL. DOWN; USB HOST; ETHERNET; SHEET 1 OF 6; Alarm Clock; TITLE Final assembly (Model A); REV; PART # --; DOCUMENT #; UNITS; INCHES [MM]; SIZE B; DATE 4/22/2015; CLK-DWG-25; SCALE 3:4; PROJECT; MATERIAL; FINISH; NOTES :; Dimensions; APVD BY :

ALARM ON-OFF

BENOIT FRIGON
benoit@frigon.info
www.bfrigon.com

File : clk-dwg-25

SHEET 2 OF 6; REV; DOCUMENT #; UNITS; SIZE; DATE 4/22/2015; CLK-DWG-25; SCALE 1:1; NOTES :

ITEM NO. | PART NUMBER | DESCRIPTION | QTY.

1 | 1553DBKBAT | ABS Box 5.80X3.50X0.98" Black (End panel) | 1
2 | 1553DBKBAT | ABS Box 5.80X3.50X0.98" Black (Bottom panel) | 1
3 | PH-C-0440-0019 | Phillips Panhead Screw - #4-40 x 3-16" | 6
4 | AS04008CO-2-R | Speaker 8 ohm 1.5W | 1
5 | CLK-AS-04 | Left panel PCB assembly | 1
6 | CLK-AS-05 | Controller PCB Assembly | 1
7 | CLK-STR-02 | Speaker holder | 1

BENOIT FRIGON
benoit@frigon.info
www.bfrigon.com

PROJECT
Alarm Clock
TITLE
Final assembly (Model A)
Motherboard / Left panel PCB
PART #

File : clk-dwg-25

SECTION B-B SCALE 5 : 4; SHEET 3 OF 6; REV; DOCUMENT #; UNITS; SIZE; DATE 4/22/2015; CLK-DWG-25; SCALE 1:1; NOTES :

BENOIT FRIGON
benoit@frigon.info
www.bfrigon.com

PROJECT
Alarm Clock
TITLE
Final assembly (Model A)
1553D Case modifications
PART #

File : clk-dwg-25

SHEET 4 OF 6; REV; DOCUMENT #; UNITS; SIZE; DATE 4/22/2015; CLK-DWG-25; SCALE 2:1; NOTES :

BENOIT FRIGON
benoit@frigon.info
www.bfrigon.com

PROJECT
Alarm Clock
TITLE
Final assembly (Model A)
End Panel
PART #

File : clk-dwg-25

PANEL THICKNESS; SECTION A-A; TOUCH PCB; SHEET 5 OF 6; REV; DOCUMENT #; UNITS; SIZE; DATE 4/22/2015; CLK-DWG-25; SCALE 1:1; NOTES :

BENOIT FRIGON
benoit@frigon.info
www.bfrigon.com

PROJECT
Alarm Clock
TITLE
Final assembly (Model A)
Touch PCB
PART #

File : clk-dwg-25

SHEET 6 OF 6; REV; DOCUMENT #; UNITS; SIZE; DATE 4/22/2015; CLK-DWG-25; SCALE 1:1; NOTES :

ITEM NO. | PART NUMBER | DESCRIPTION | QTY.
1 | CLK-OVL-01 | Keypad overlay | 1
2 | 1553DBKBAT | ABS Box 5.80X3.50X0.98" Black (Top panel) | 1
3 | CLK-AS-02 | Display Assembly (Model A) | 1
4 | PH-C-0440-0025 | Phillips Panhead Screw - #4-40 x 1-4" | 2
5 | PH-C-0440-0038 | Phillips Panhead Screw - #4-40 x 3-8" | 1

BENOIT FRIGON
benoit@frigon.info
www.bfrigon.com

PROJECT
Alarm Clock
TITLE
Final assembly (Model A)
Display
PART #

File : clk-dwg-25

WALL THICKNESS : 1.5mm; EPOXY MIX: 25% CORNSTARCH, 75% CLEAR EPOXY; SHEET 1 OF 1; ALARM CLOCK; TITLE SPEAKER HOLDER; REV; PART # CLK-STR-02; DOCUMENT #; UNITS; SIZE; DATE 2/8/2015; CLK-DWG-11; SCALE 3:1; PROJECT; NOTES :; Dimensions

BENOIT FRIGON
benoit@frigon.info
www.bfrigon.com

File : clk-dwg-11

TRANSLUCENT WHITE EPOXY

0.300 MIN. CLEARANCE; Alarm Clock; TITLE Motherboard; REV; PART # CLK-PC-03; DOCUMENT #; UNITS; INCHES; SIZE; DATE 3/21/2015; CLK-DWG-03; SCALE 3:2; PROJECT; PCB FR-4; NOTES :; Dimensions

TAG | X LOC | Y LOC | SIZE
A1 | 0.05 | 1.15
A2 | 0.05 | 2.60
A3 | 0.70 | 2¹ 2"
A4 | 0.70 | 2.60
A5 | 0.60 | 1.10
A6 | 0.80 | 2¹ 2"
A7 | 0.80 | 2.60
A8 | 0.90 | 2¹ 2"
A9 | 0.90 | 2.60
A10 | 1" | 2¹ 2"
A11 | 1" | 2.60
A12 | 1.10 | 2¹ 2"
A13 | 1.10 | 2.60
B1 | 0.34 | 0.23 | 0.129 THRU ALL
B2 | 0.34 | 2.70
B3 | 2.15 | 0.23

BENOIT FRIGON
benoit@frigon.info
www.bfrigon.com

File : clk-dwg-03

0.040 THRU ALL; REV; DOCUMENT #; UNITS; SIZE; DATE 4/12/2015; CLK-DWG-12; SCALE 3:1; PCB FR4; NOTES :

TAG | X LOC | Y LOC | SIZE
A1 | 0.050 | 0.100
A2 | 0.050 | 1.550

A4 | 0.700 | 1.550
A5 | 0.600 | 0.050
A6 | 0.800 | 1.450
A7 | 0.800 | 1.550
A8 | 0.900 | 1.450
A9 | 0.900 | 1.550
A10 | 1" | 1.450
A11 | 1" | 1.550
A12 | 1.100 | 1.450
A13 | 1.100 | 1.550

BENOIT FRIGON
benoit@frigon.info
www.bfrigon.com

PROJECT
ALARM CLOCK
TITLE
Battery interface PCB
Dimensions
PART #
CLK-PC-08

File : clk-dwg-12

REV; DOCUMENT #; UNITS; SIZE; DATE 4/14/2015; CLK-DWG-20; SCALE 3:2; NOTES :

ITEM NO. | PART NUMBER | MFG | DESCRIPTION | QTY.
1 | 7498011122R | Wurth Electronics | Modular connector - RJ45 - w/ magnetics | 1
2 | Aria G25 | ACME Systems | ARM System-On-Module | 1
3 | DM3AT-SF-PEJM5 | Hirose Electric | Micro SD card connector | 1
4 | PJ-031CH | CUI inc | DC barrel jack - 1.1mm I.D / 3.5 mm O.D | 1
5 | CLK-PC-03 | | Controller PCB | 1
6 | 292303-1 | TE Connectivity | USB Connector - Type A - Through hole | 1
7 | CLK-PC-08 | | Battery interface PCB | 1
8 | 103741-1 | TE Connectivity | 1 pos. header - 0.1" pitch - male | 3
9 | 103777-5 | TE Connectivity | 2 row, 10 pos. header - 0.1" pitch - male | 1
10 | DF3DZ-3P-2V(21) | Hirose Electric | Conn Header 3 Pos 2mm SMT | 1

BENOIT FRIGON
benoit@frigon.info
www.bfrigon.com

PROJECT
Alarm Clock
TITLE
Controller PCB assembly
Components layout
PART #
CLK-AS-05

File : clk-dwg-20

DETAIL A SCALE 6 : 1; REV; DOCUMENT #; UNITS; SIZE; DATE 3/21/2015; CLK-DWG-05; SCALE 5:2; PCB FR-4; NOTES :

BENOIT FRIGON
benoit@frigon.info
www.bfrigon.com

PROJECT
Alarm Clock
TITLE
PCB - Left panel
Dimensions
PART #
CLK-PC-04

File : clk-dwg-05

REV; DOCUMENT #; UNITS; SIZE; CLK-DWG-21; SCALE 2:1; NOTES :

ITEM NO. | PART NUMBER | CompanyName | DESCRIPTION | QTY.

1 | B3F_3150 | Omron | Tactile switch R/A - SPST | 3
2 | B32-2010 | Omron | 6mm Round Keycap for B3F - Black | 3
3 | CLK-PC-04 | | Left panel PCB | 1

BENOIT FRIGON
benoit@frigon.info
www.bfrigon.com

PROJECT
Alarm Clock
TITLE
Left panel PCB Assembly
Components layout
PART #
CLK-AS-04

File : clk-dwg-21

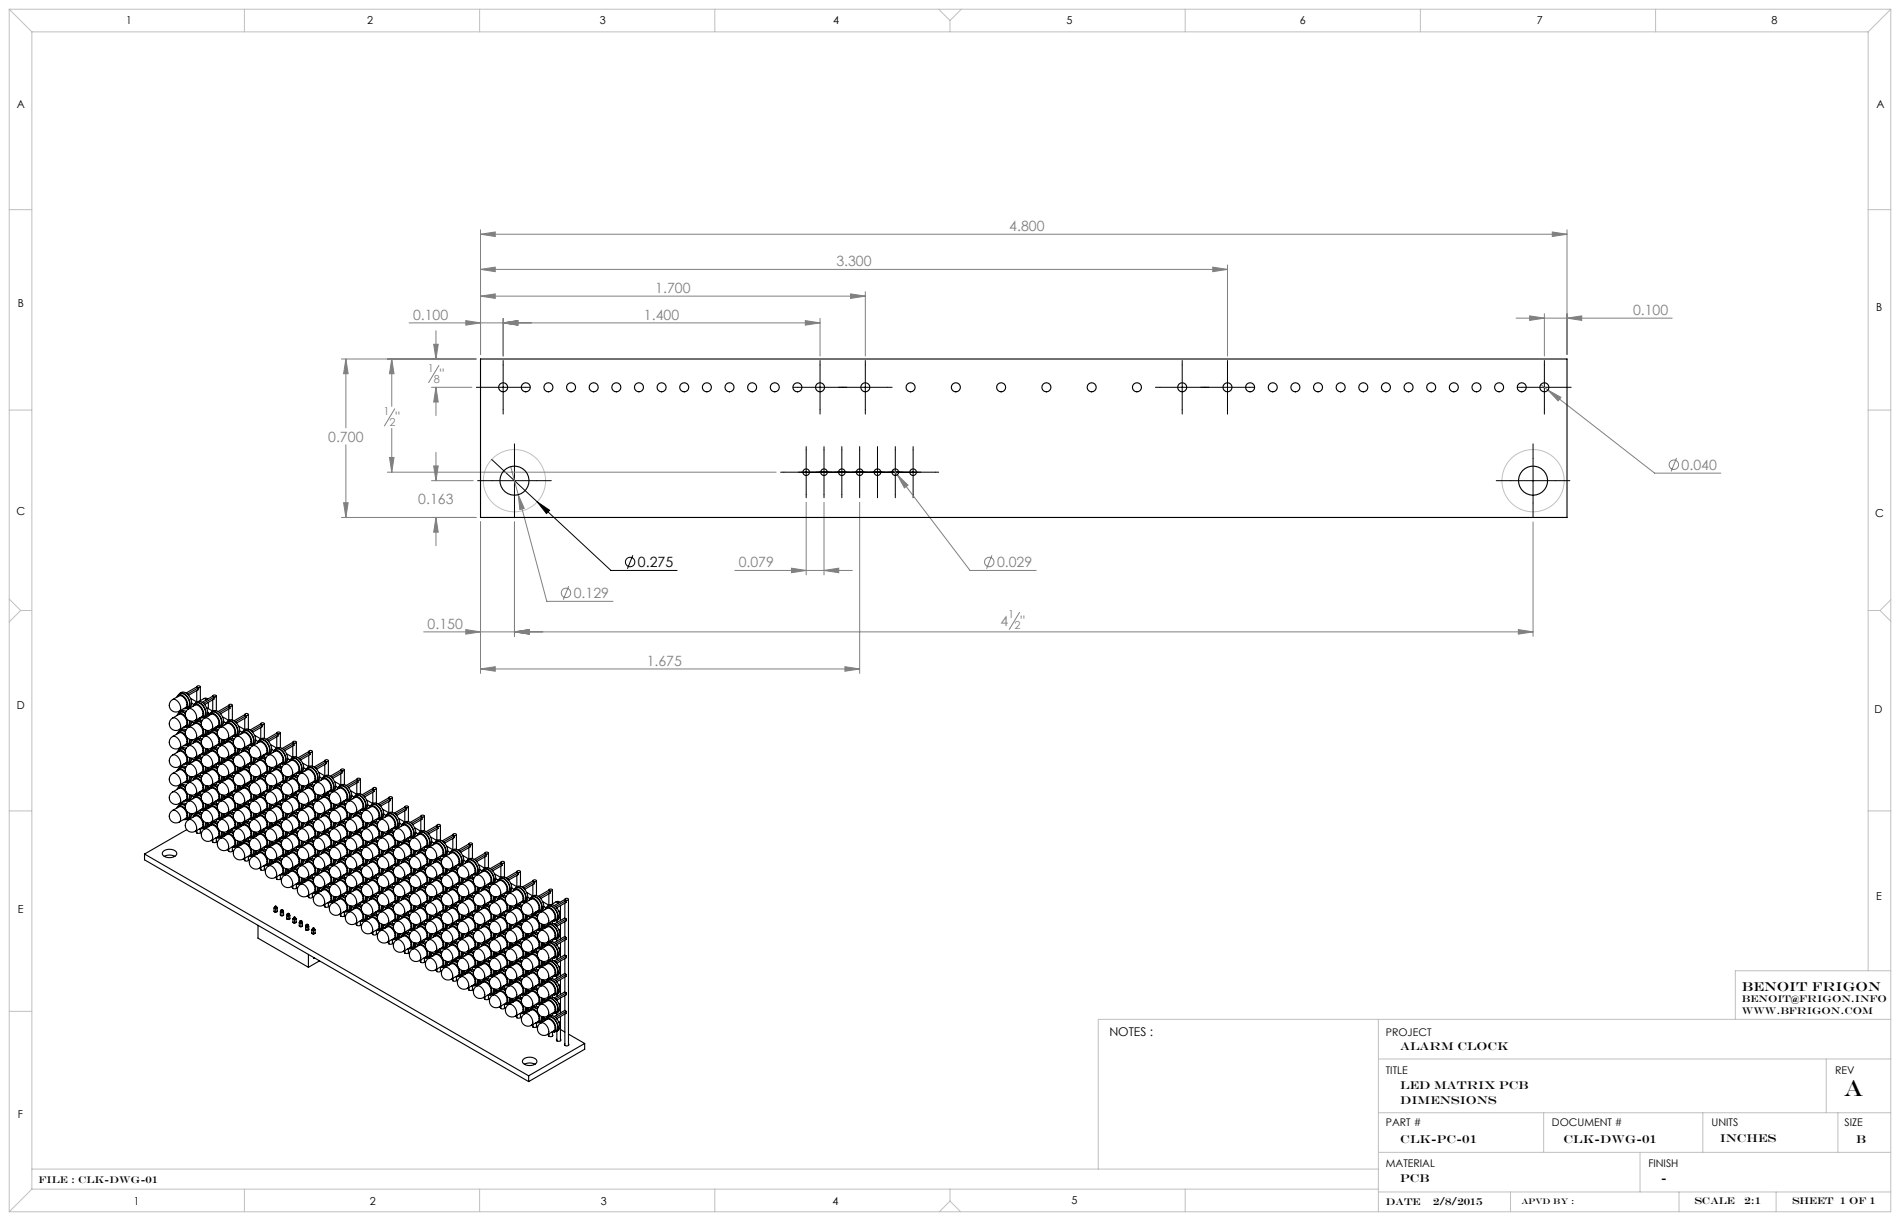
[picture p48: page 13]
REV; DOCUMENT #; UNITS; SIZE; CLK-DWG-01; SCALE 2:1; PCB; NOTES :

BENOIT FRIGON
benoit@frigon.info
www.bfrigon.com

PROJECT
Alarm Clock
TITLE
Led matrix PCB
Dimensions
PART #
CLK-PC-01

File : clk-dwg-01

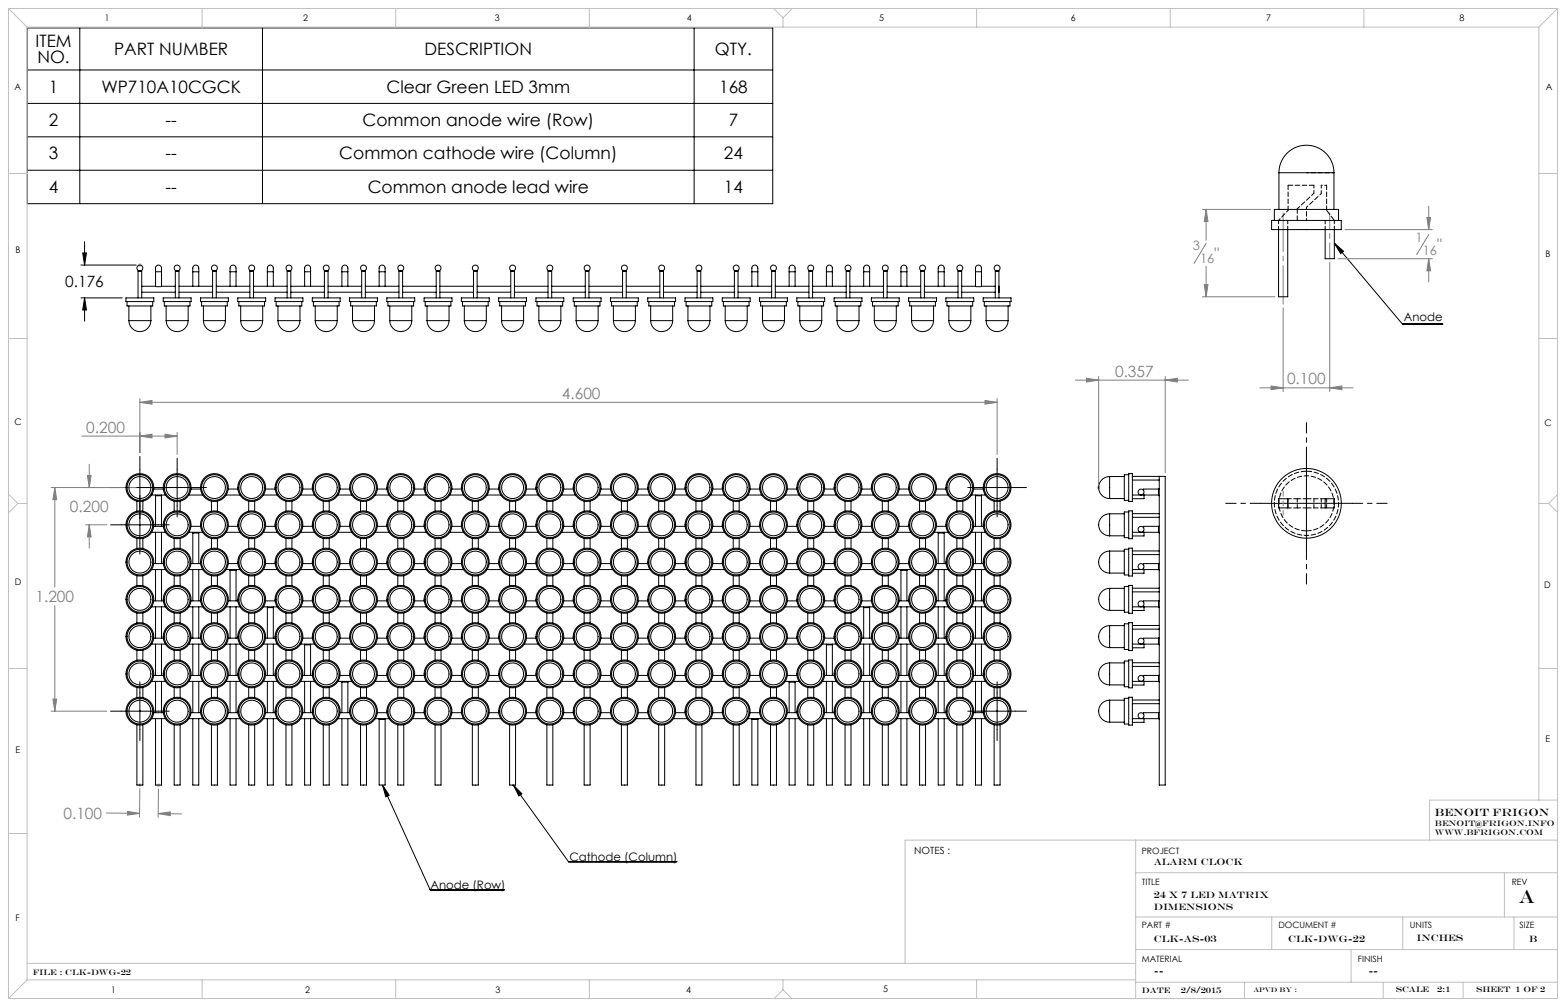
[picture p49: page 14]
Cathode (Column); Anode (Row); Anode; SHEET 1 OF 2; Alarm Clock; TITLE 24 x 7 Led Matrix; REV; PART # CLK-AS-03; DOCUMENT #; UNITS; SIZE; CLK-DWG-22; SCALE 2:1; PROJECT; NOTES :; Dimensions

ITEM NO. | PART NUMBER | DESCRIPTION | QTY.

1 | WP710A10CGCK | Clear Green LED 3mm | 168
2 | -- | Common anode wire (Row) | 7
3 | -- | Common cathode wire (Column) | 24
4 | -- | Common anode lead wire | 14

BENOIT FRIGON
benoit@frigon.info
www.bfrigon.com

File : clk-dwg-22

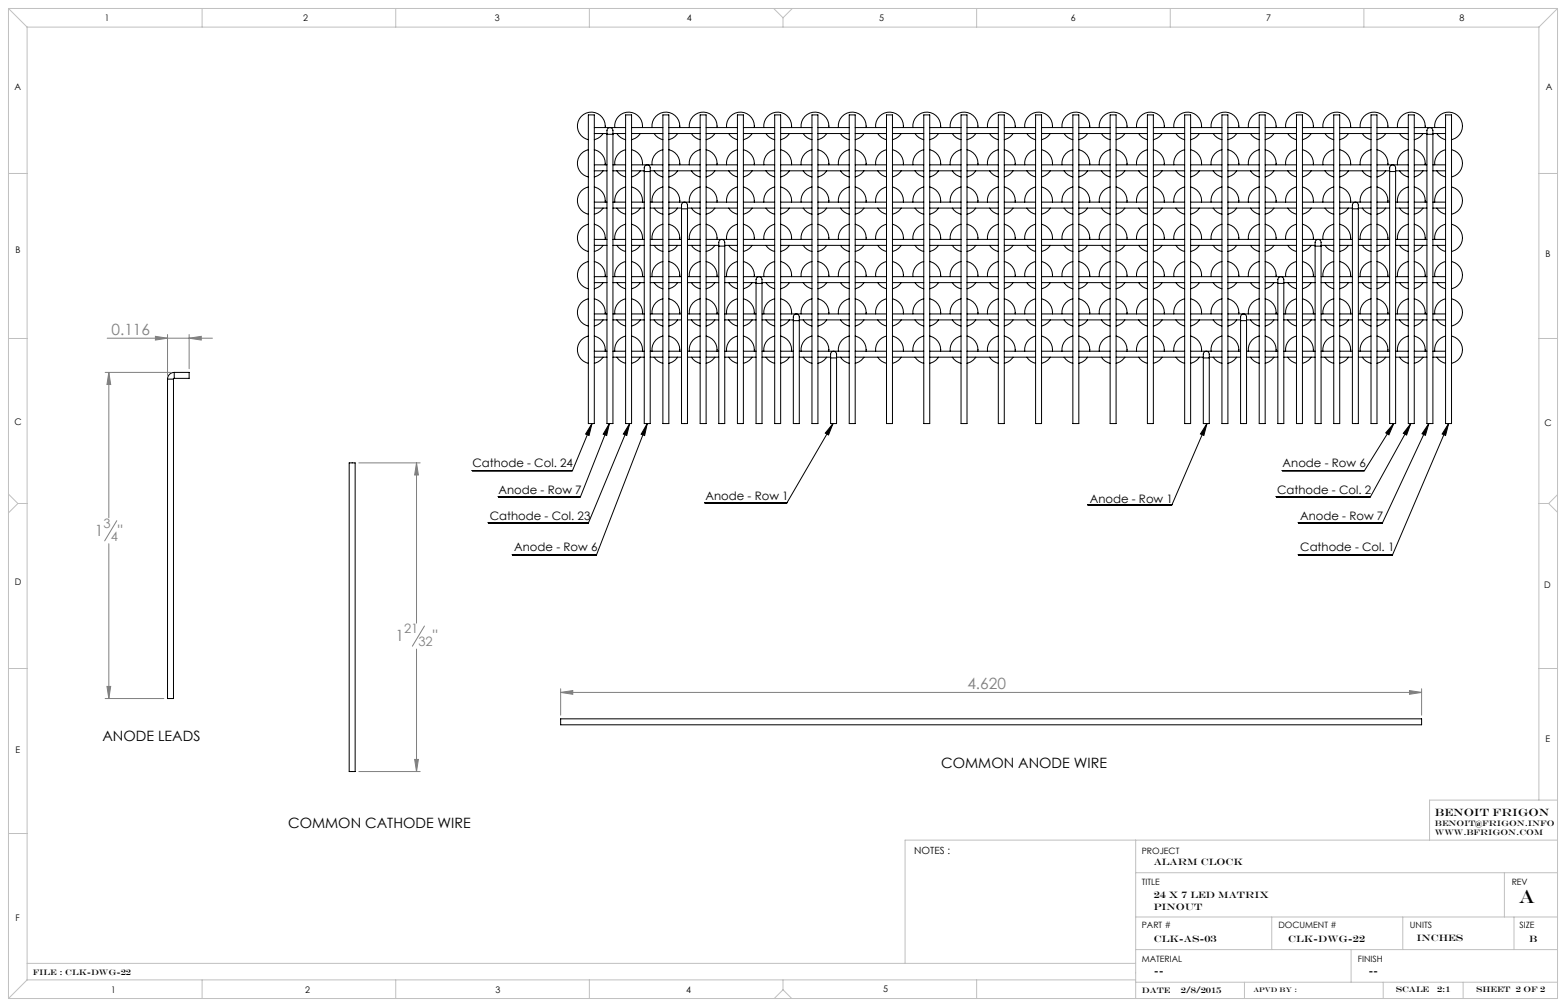
[picture p50: page 15]
Cathode - Col. 24; Cathode - Col. 1; Anode - Row 7; Cathode - Col. 23; Anode - Row 1; Anode - Row 6; ANODE LEADS; SHEET 2 OF 2; Alarm Clock; TITLE 24 x 7 Led Matrix; REV; PART # CLK-AS-03; DOCUMENT #; UNITS; SIZE; CLK-DWG-22; SCALE 2:1; PROJECT; NOTES :; Pinout

Cathode - Col. 2 Anode - Row 1

COMMON ANODE WIRE

COMMON CATHODE WIRE

BENOIT FRIGON
benoit@frigon.info
www.bfrigon.com

File : clk-dwg-22

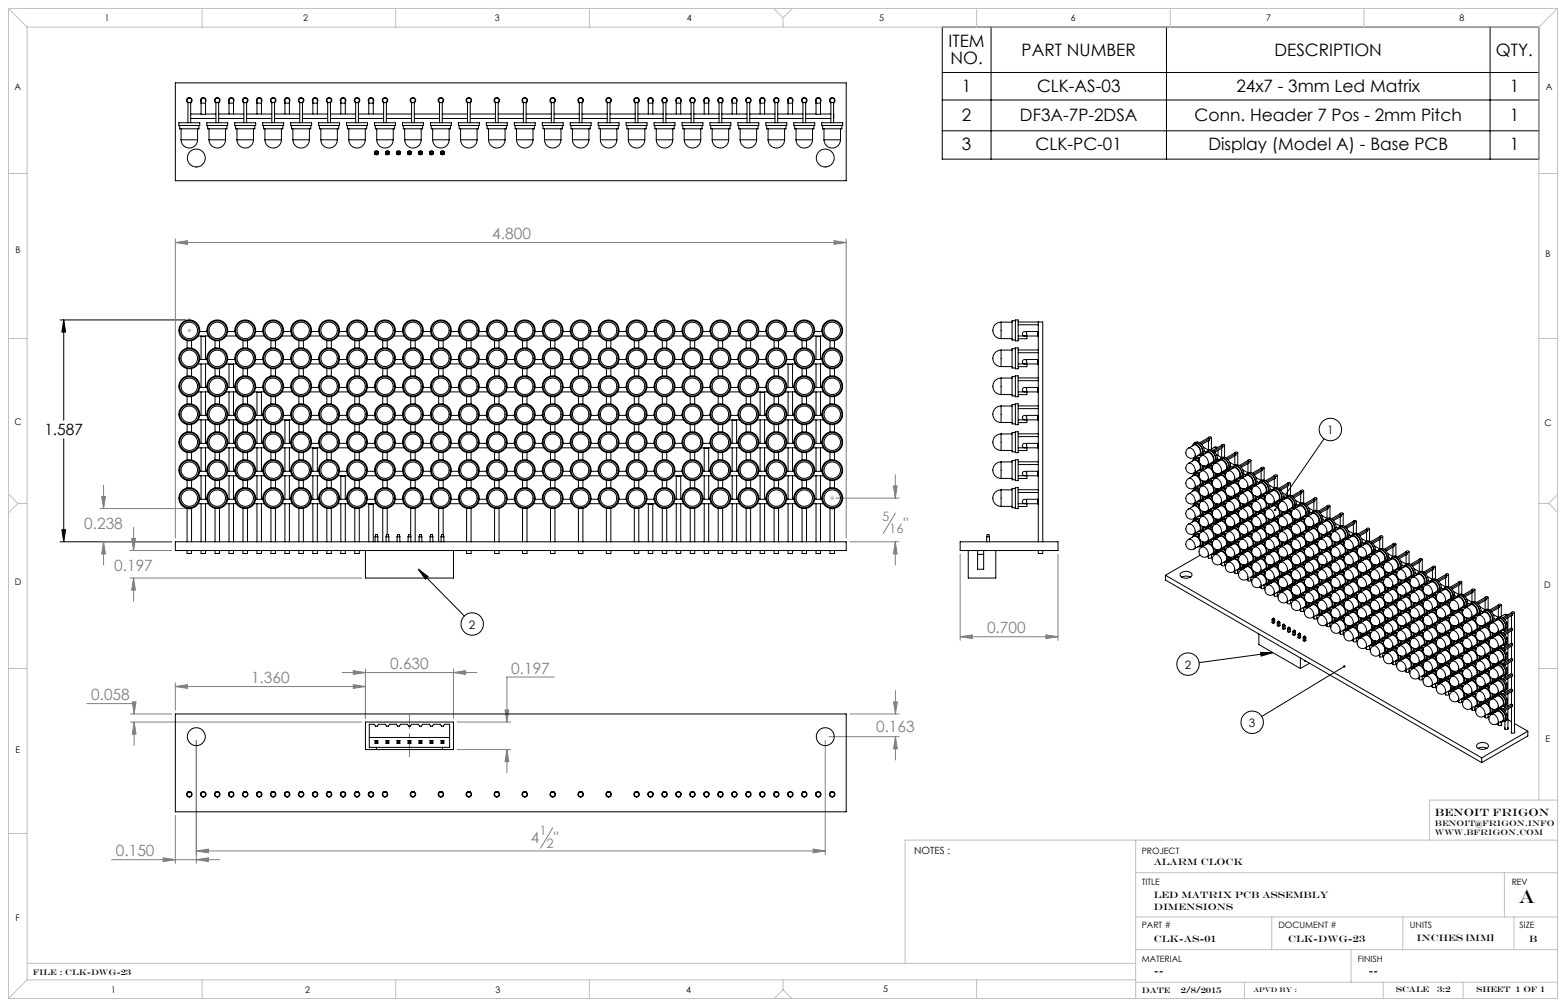
[picture p51: page 16]
REV; DOCUMENT #; UNITS; SIZE; CLK-DWG-23; SCALE 3:2; NOTES :

ITEM NO. | PART NUMBER | DESCRIPTION | QTY.

1 | CLK-AS-03 | 24x7 - 3mm Led Matrix | 1
2 | DF3A-7P-2DSA | Conn. Header 7 Pos - 2mm Pitch | 1
3 | CLK-PC-01 | Display (Model A) - Base PCB | 1

BENOIT FRIGON
benoit@frigon.info
www.bfrigon.com

PROJECT
Alarm Clock
TITLE
Led Matrix PCB Assembly
Dimensions
PART #
CLK-AS-01

File : clk-dwg-23

Alarm Clock; TITLE Display base; REV; PART # CLK-STR-01; DOCUMENT #; UNITS; SIZE; CLK-DWG-06; SCALE 5:2; PROJECT; 1" x 0.5" aluminum "U" channel; NOTES :; Dimensions

TAG | X LOC | Y LOC | SIZE
A1 | 5 16" | 1 4" | 0.166 THRU ALL
A2 | 5 16" | 4³ 4"
B1 | 3 8" | 2¹ 2" | 0.166 THRU ALL 1

BENOIT FRIGON
benoit@frigon.info
www.bfrigon.com

File : clk-dwg-06

SHEET 1 OF 2; REV; DOCUMENT #; UNITS; SIZE; DATE 4/22/2015; CLK-DWG-24; SCALE 3:2; NOTES :

BENOIT FRIGON
benoit@frigon.info
www.bfrigon.com

PROJECT
Alarm Clock
TITLE
Display Assembly (Model A)
Dimensions
PART #
CLK-AS-02

File : clk-dwg-24

SHEET 2 OF 2; REV; DOCUMENT #; UNITS; SIZE; DATE 4/22/2015; CLK-DWG-24; SCALE 3:2; NOTES :

ITEM NO. | PART NUMBER | DESCRIPTION | QTY.

1 | CLK-STR-01 | Display base | 1
2 | 4862 | Force-Fit Standoff - #4-40, 0.125" | 2
3 | 4861 | Force-Fit Standoff - #4-40, 0.065" | 3
4 | PH-C-0440-0025 | Phillips Panhead Screw - #4-40 x 1-4" | 2
5 | CLK-AS-01 | Display (Model A) - Base PCB Assembly | 1

BENOIT FRIGON
benoit@frigon.info
www.bfrigon.com

PROJECT
Alarm Clock
TITLE
Display Assembly (Model A)
Exploded view
PART #
CLK-AS-02

File : clk-dwg-24

SHEET 1 OF 2; Alarm Clock; TITLE Keypad overlay; REV; PART # CLK-OVL-01; DOCUMENT #; UNITS; SIZE; CLK-DWG-07; SCALE 3:2; PROJECT; NOTES :; Cutout

BENOIT FRIGON
benoit@frigon.info
www.bfrigon.com

File : clk-dwg-07

SHEET 2 OF 2; Alarm Clock; TITLE Keypad overlay; REV; PART # CLK-OVL-01; DOCUMENT #; UNITS; SIZE; CLK-DWG-07; SCALE 3:2; PROJECT; NOTES :; Buttons layout

BENOIT FRIGON
benoit@frigon.info
www.bfrigon.com

File : clk-dwg-07

REV; DOCUMENT #; UNITS; SIZE; CLK-DWG-02; SCALE 2:1; PCB FR-4; NOTES :

BENOIT FRIGON
benoit@frigon.info
www.bfrigon.com

PROJECT
Alarm Clock
TITLE
Touch keypad PCB
Dimensions
PART #
CLK-PC-02

File : clk-dwg-02
