bfrigon/alarm-clock-hardware/drawings/schematics/clk-sch-03.pdf

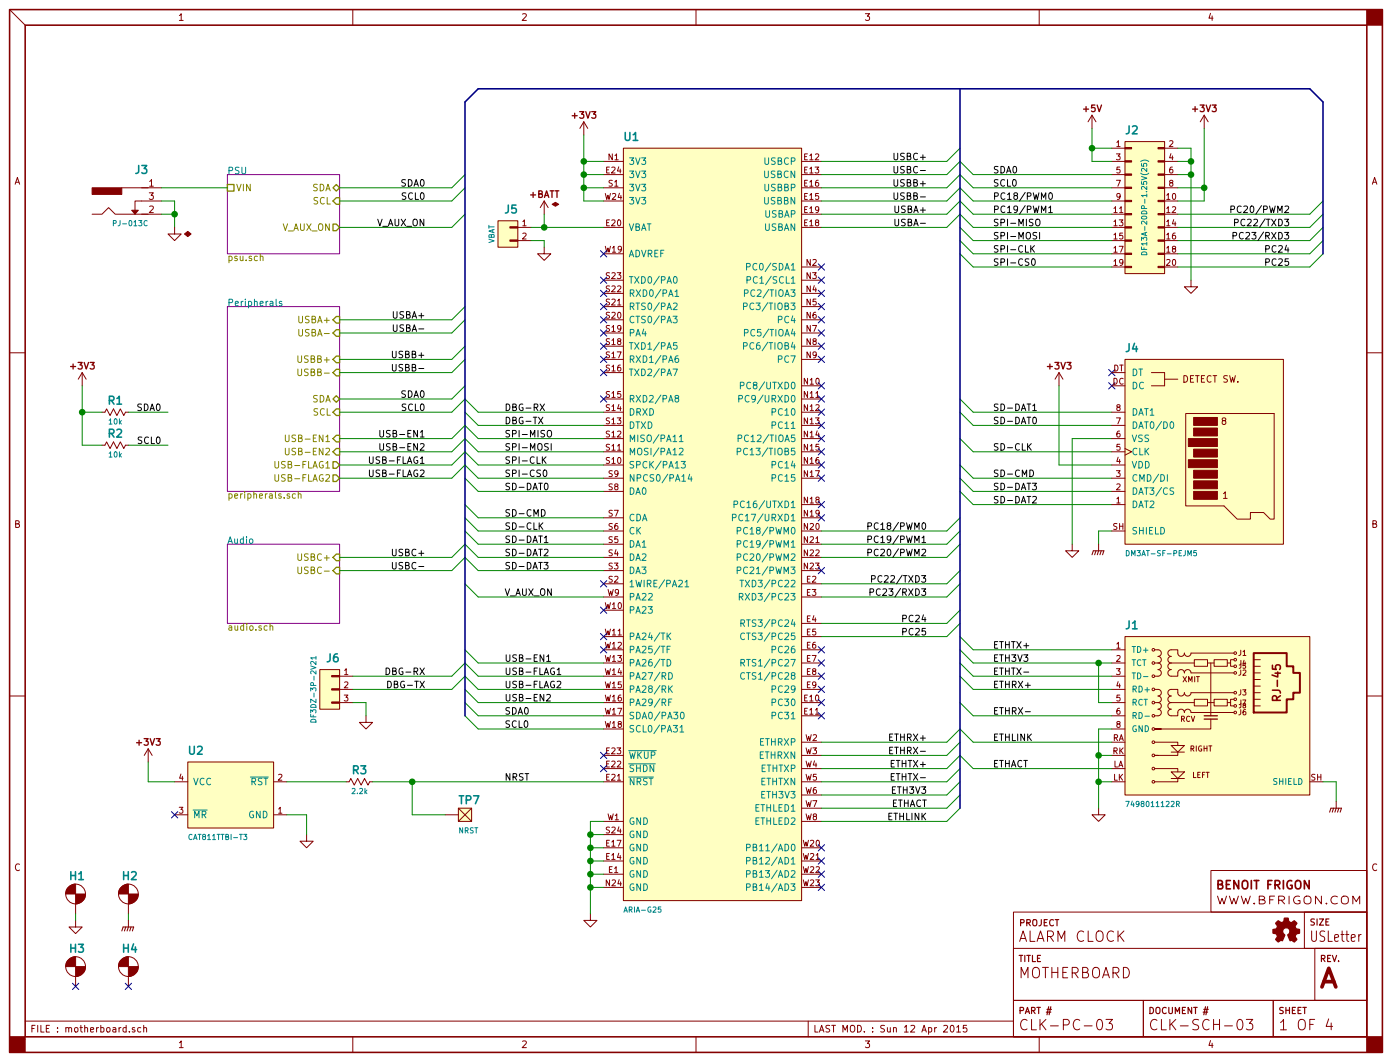
[picture p52: page 1]

2 J5 VBAT DBG-RX DBG-TX

SPI-MOSI SPI-MISO

peripherals.sch USBA+ USBA- USBB+ USBB- SDA

DBG-TX DBG-RX
SD-DAT1 SD-DAT2 SD-DAT3 SD-DAT0 SPI-CS0 SPI-CLK

SD-DAT3 SD-DAT2 SD-CMD

ETHTX+ ETH3V3 ETHTX- ETHRX+ ETHRX- ETHLINK

7498011122R ETHRX+ ETHRX- ETHTX+ ETHTX- ETH3V3 ETHACT ETHLINK

TITLE WWW.BFRIGON.COM

PART # | | A

DOCUMENT # CLK-PC-03 | SHEET CLK-SCH-03

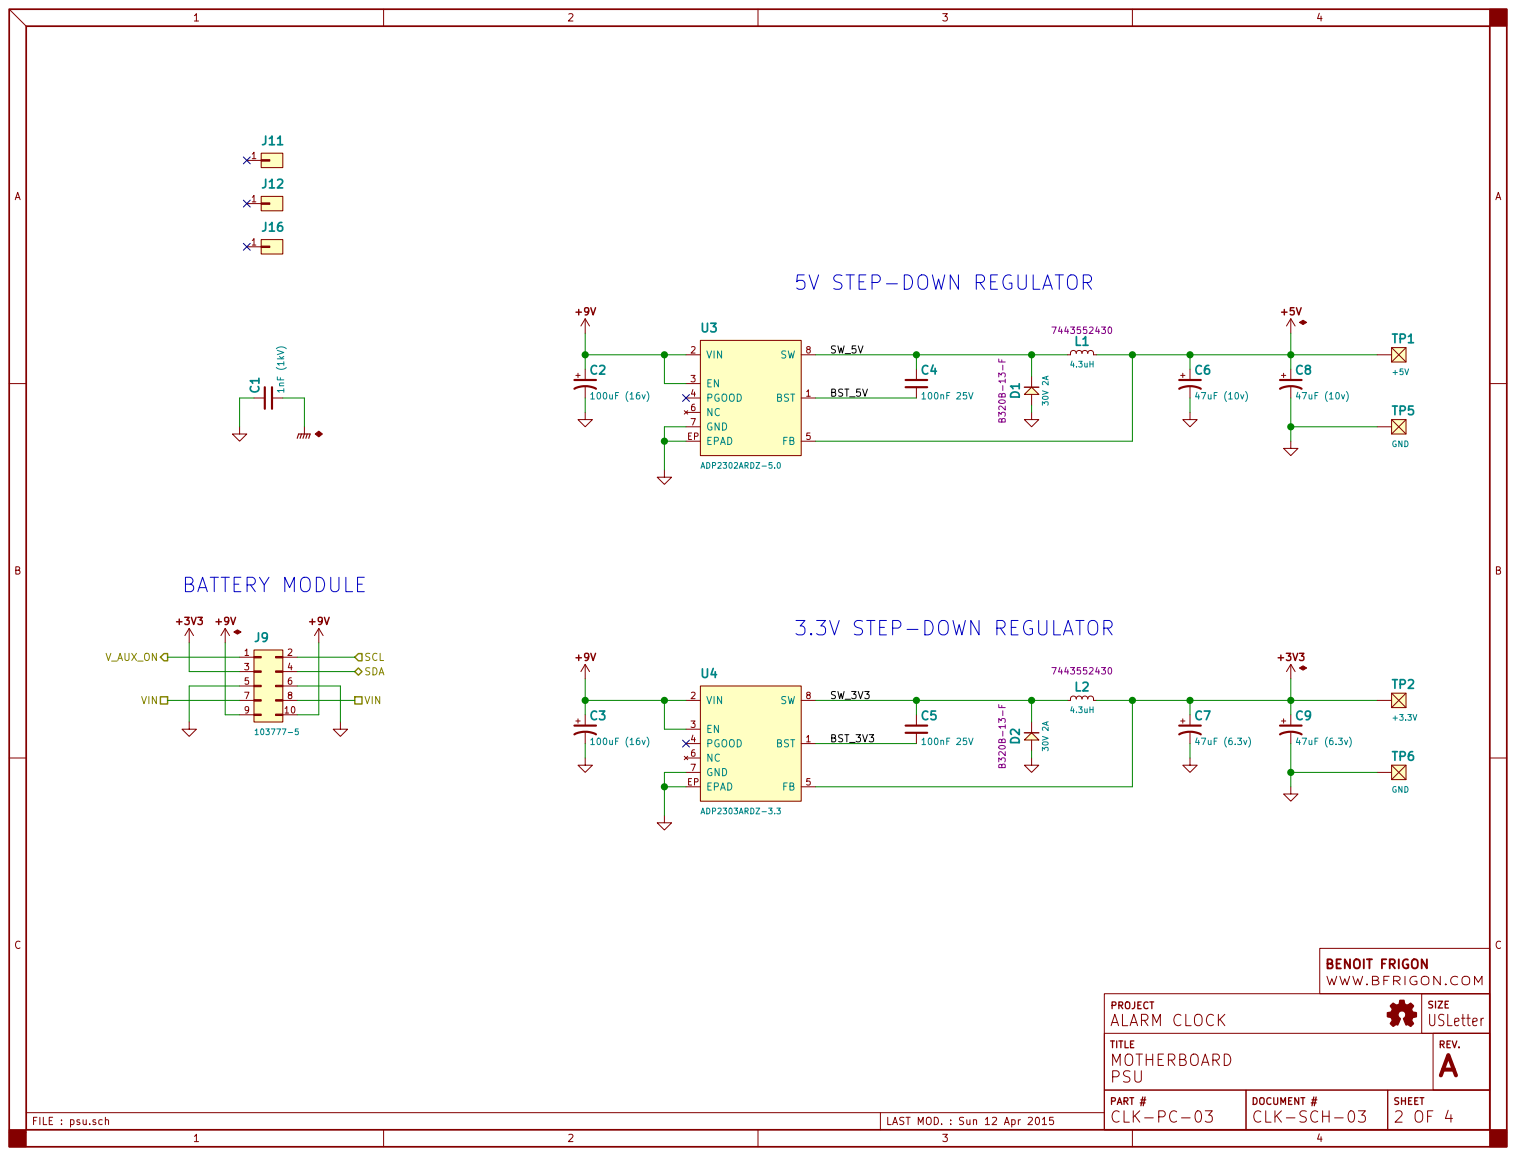
[picture p53: page 2]

GND 5V STEP-DOWN REGULATOR

TITLE WWW.BFRIGON.COM

PART # | A

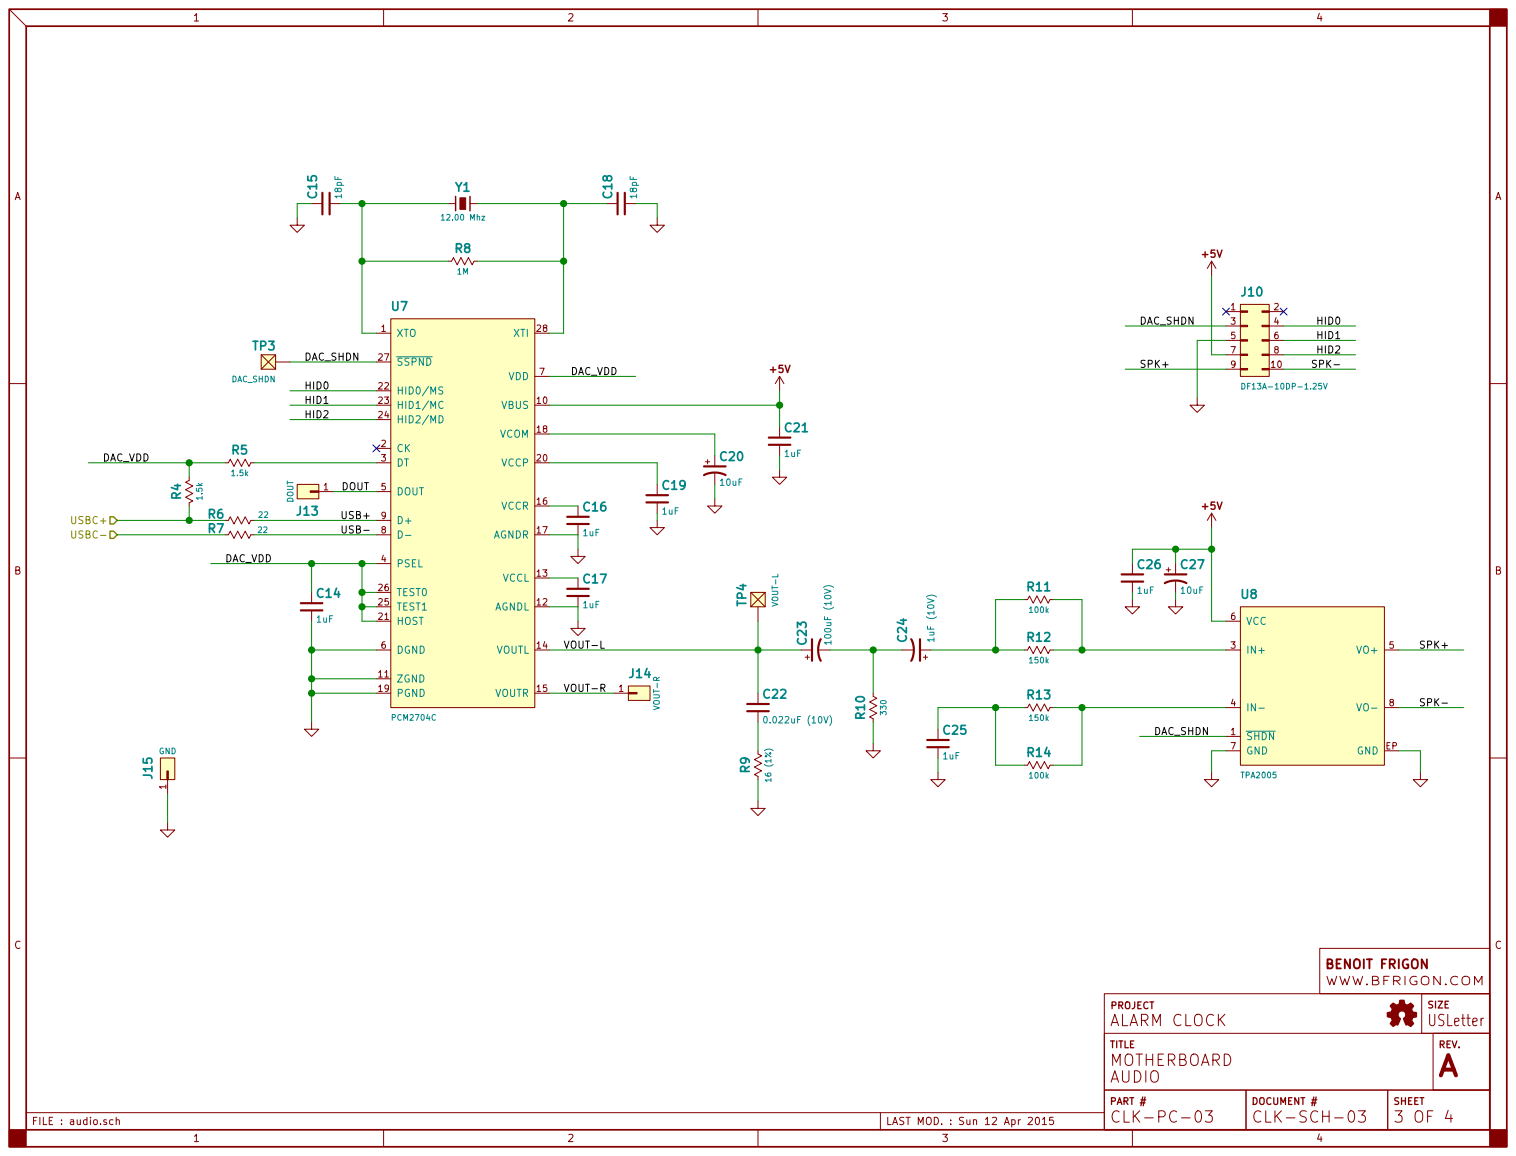
[picture p54: page 3]

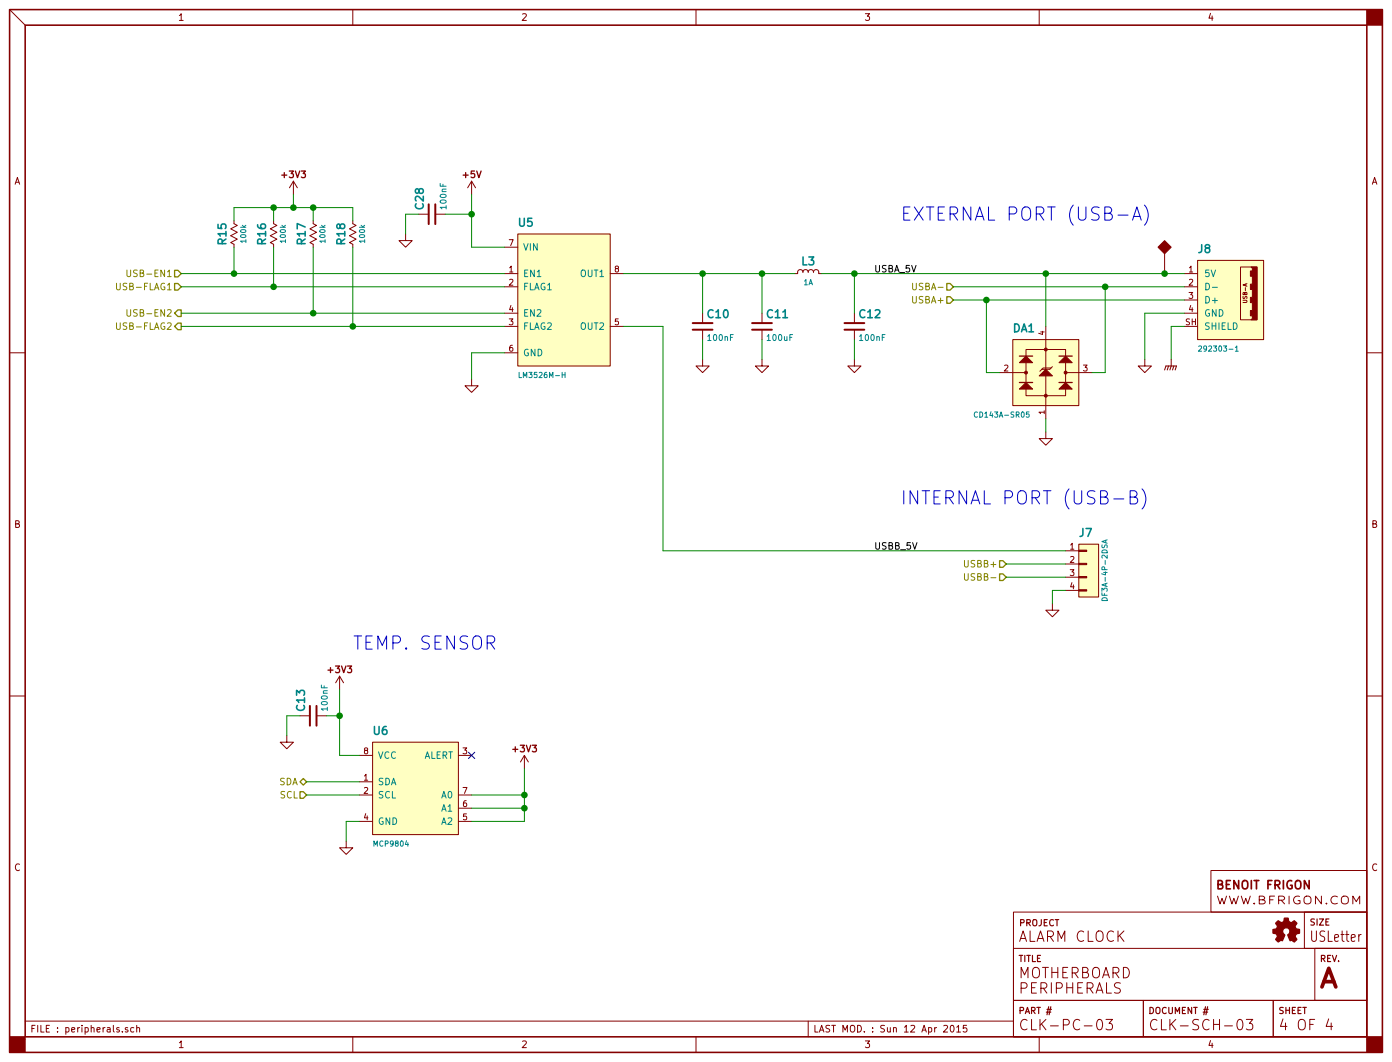
[picture p55: page 4]
