bfrigon/alarm-clock-hardware/drawings/design/clk-dwg-05.pdf

DETAIL A SCALE 6 : 1; SHEET 1 OF 1; DOCUMENT #; UNITS; INCHES [MM]; DATE 3/21/2015; SCALE 5:2; NOTES :; APVD BY :

BENOIT FRIGON
benoit@frigon.info
www.bfrigon.com

PROJECT
Alarm Clock
TITLE
PCB - Left panel
Dimensions
PART #
CLK-PC-04
MATERIAL
PCB FR-4

File : clk-dwg-05
