bfrigon/alarm-clock-hardware/drawings/design/clk-dwg-01.pdf

SHEET 1 OF 1; Alarm Clock; Led matrix PCB; PART #; DOCUMENT #; UNITS; DATE 2/8/2015; SCALE 2:1; NOTES :; APVD BY :

BENOIT FRIGON
benoit@frigon.info
www.bfrigon.com

File : clk-dwg-01
