bfrigon/alarm-clock-hardware/drawings/design/clk-dwg-02.pdf

SHEET 1 OF 1; DOCUMENT #; UNITS; DATE 2/8/2015; SCALE 2:1; NOTES :; APVD BY :

BENOIT FRIGON
benoit@frigon.info
www.bfrigon.com

PROJECT
Alarm Clock
TITLE
Touch keypad PCB
Dimensions
PART #
CLK-PC-02
MATERIAL
PCB FR-4

File : clk-dwg-02
