bfrigon/alarm-clock-hardware/drawings/design/clk-dwg-08.pdf

DETAIL A SCALE 10 : 1; SHEET 1 OF 1; DOCUMENT #; UNITS; DATE 2/8/2015; SCALE 4:1; NOTES :; APVD BY :

BENOIT FRIGON
benoit@frigon.info
www.bfrigon.com

PROJECT
Alarm Clock
TITLE
Display (Model B) - 7-Segment PCB
Dimensions
PART #
CLK-PC-05
MATERIAL
PCB

File : clk-dwg-08
