bfrigon/alarm-clock-hardware/drawings/design/clk-dwg-09.pdf

SHEET 1 OF 1; DOCUMENT #; UNITS; DATE 2/8/2015; SCALE 10:1; NOTES :; APVD BY :

BENOIT FRIGON
benoit@frigon.info
www.bfrigon.com

PROJECT
Alarm Clock
TITLE
Display (Model B) - Dots PCB
Dimensions
PART #
CLK-PC-06
MATERIAL
PCB

File : clk-dwg-09
