bfrigon/alarm-clock-hardware/drawings/design/clk-dwg-11.pdf

WALL THICKNESS : 1.5mm; EPOXY MIX: 25% CORNSTARCH, 75% CLEAR; SHEET 1 OF 1; DOCUMENT #; UNITS; INCHES [MM]; DATE 2/8/2015; SCALE 3:1; NOTES :; APVD BY :

BENOIT FRIGON
benoit@frigon.info
www.bfrigon.com

PROJECT
ALARM CLOCK
TITLE
SPEAKER HOLDER
Dimensions
PART #
CLK-STR-02
MATERIAL
TRANSLUCENT WHITE EPOXY

File : clk-dwg-11
