bfrigon/alarm-clock-hardware/drawings/design/clk-dwg-22.pdf

Cathode (Column); Anode (Row); SHEET 1 OF 2; Alarm Clock; 24 x 7 Led Matrix; PART #; DOCUMENT #; UNITS; DATE 2/8/2015; SCALE 2:1; NOTES :; APVD BY :

ITEM NO. | PART NUMBER | DESCRIPTION | QTY.

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

BENOIT FRIGON
benoit@frigon.info
www.bfrigon.com

File : clk-dwg-22

Cathode - Col. 24; Cathode - Col. 1; Anode - Row 7; Cathode - Col. 23; Anode - Row 1; Anode - Row 6; ANODE LEADS; SHEET 2 OF 2; Alarm Clock; 24 x 7 Led Matrix; PART #; DOCUMENT #; UNITS; DATE 2/8/2015; SCALE 2:1; NOTES :; APVD BY :

Cathode - Col. 2 Anode - Row 1

COMMON ANODE WIRE

COMMON CATHODE WIRE

BENOIT FRIGON
benoit@frigon.info
www.bfrigon.com

File : clk-dwg-22
