bfrigon/alarm-clock-hardware/drawings/schematics/clk-sch-01.pdf

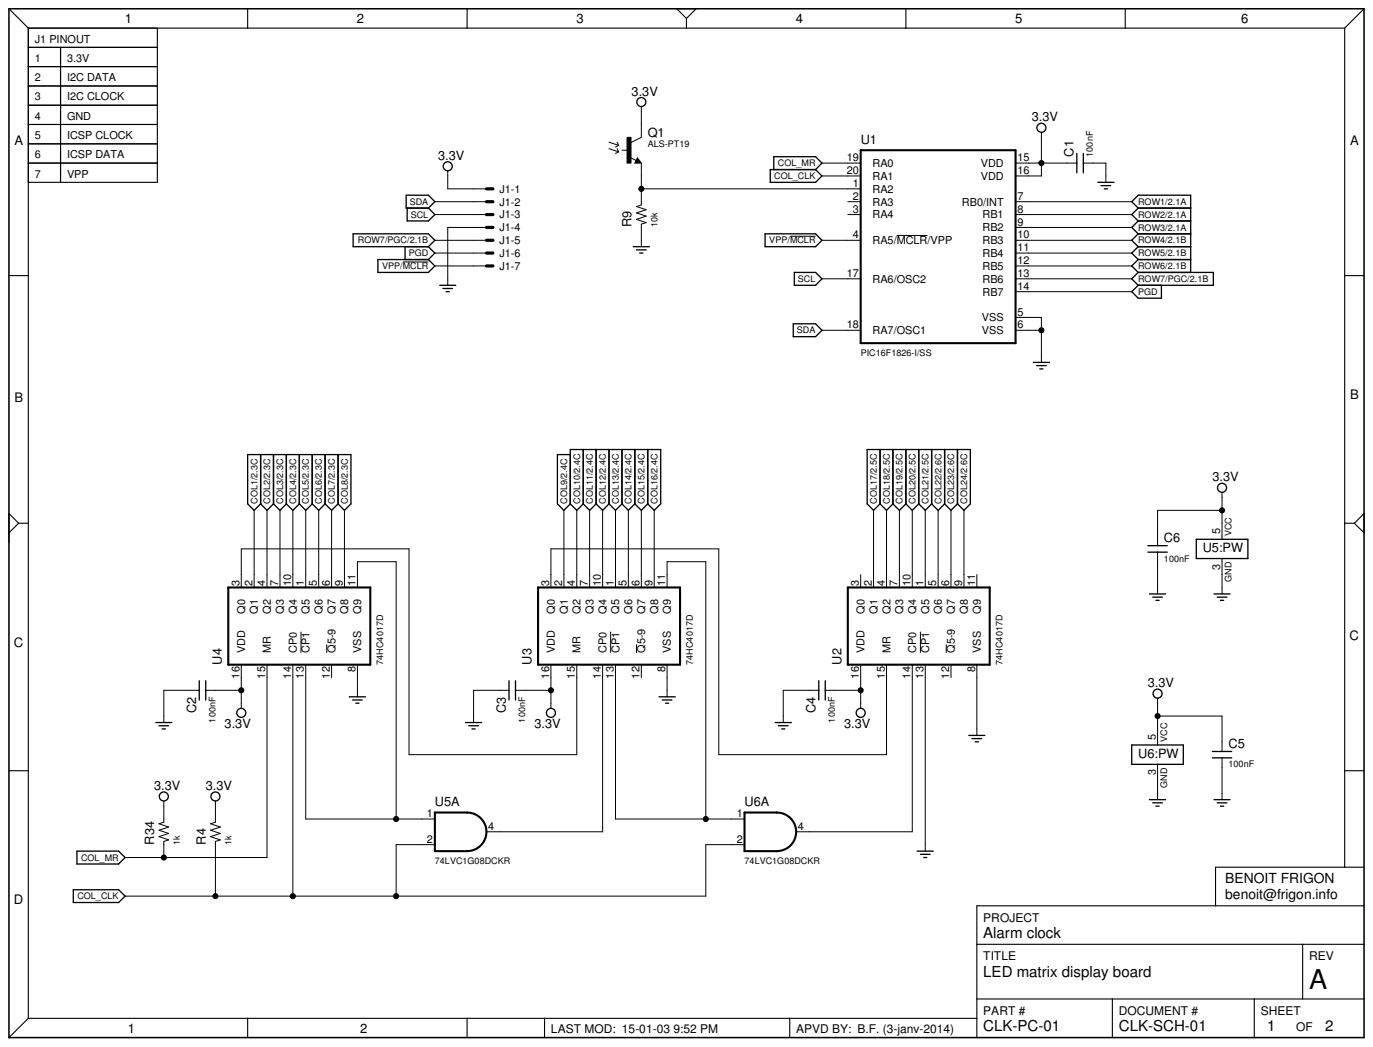
[picture p56: page 1]

J1 PINOUT
1 | 3.3V
2 | I2C DATA
3 | I2C CLOCK GND
5 | ICSP CLOCK
6 | ICSP DATA

PROJECT
Alarm clock
TITLE
LED matrix display board

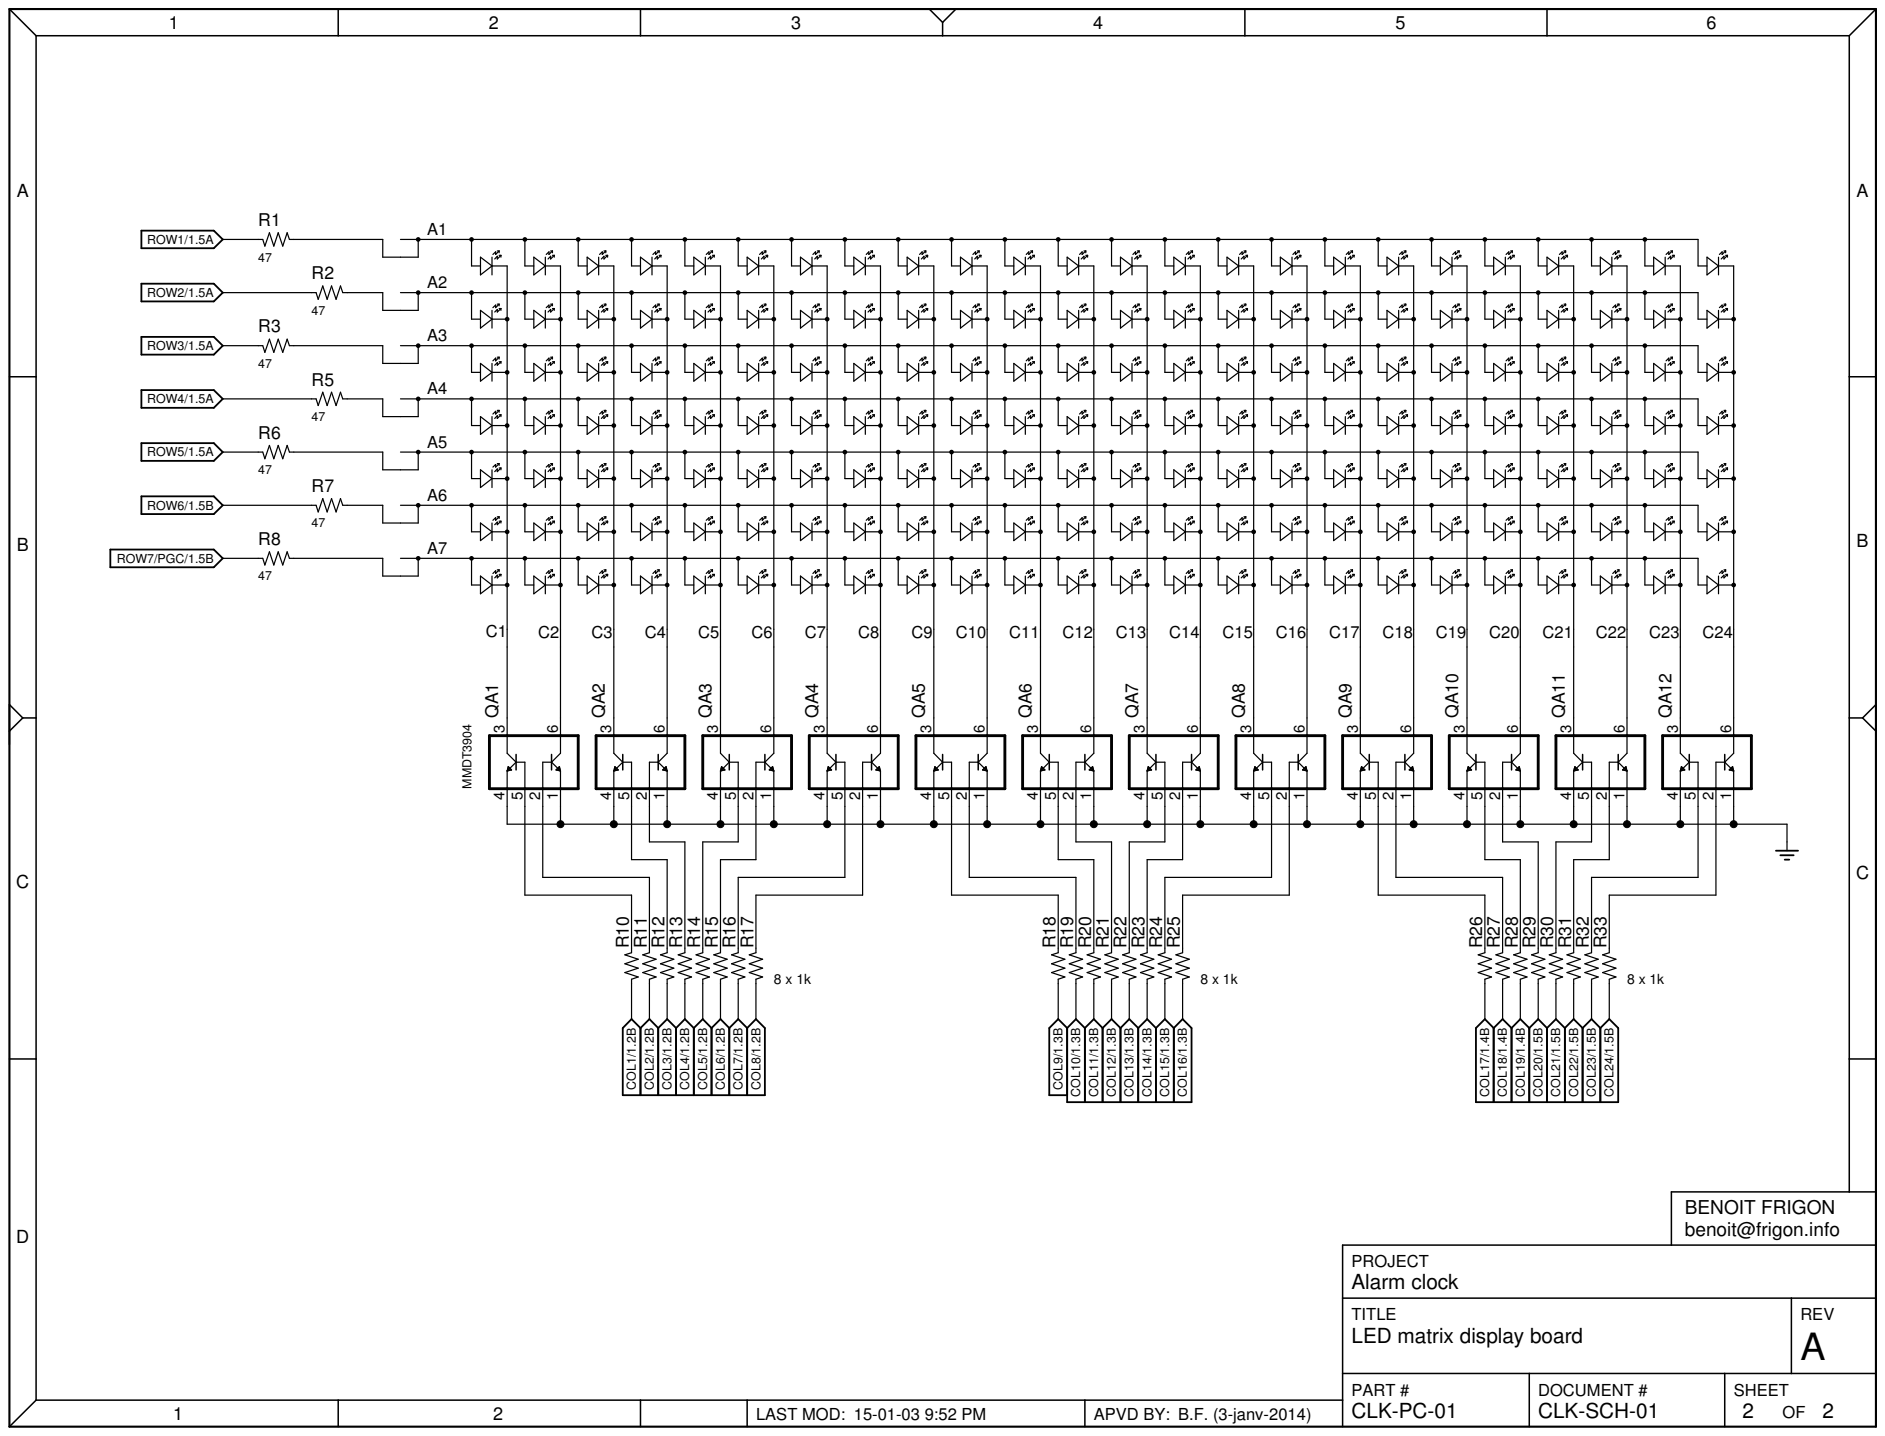
[picture p57: page 2]

PROJECT
Alarm clock
TITLE
LED matrix display board
