bfrigon/alarm-clock-hardware/drawings/schematics/clk-sch-02.pdf

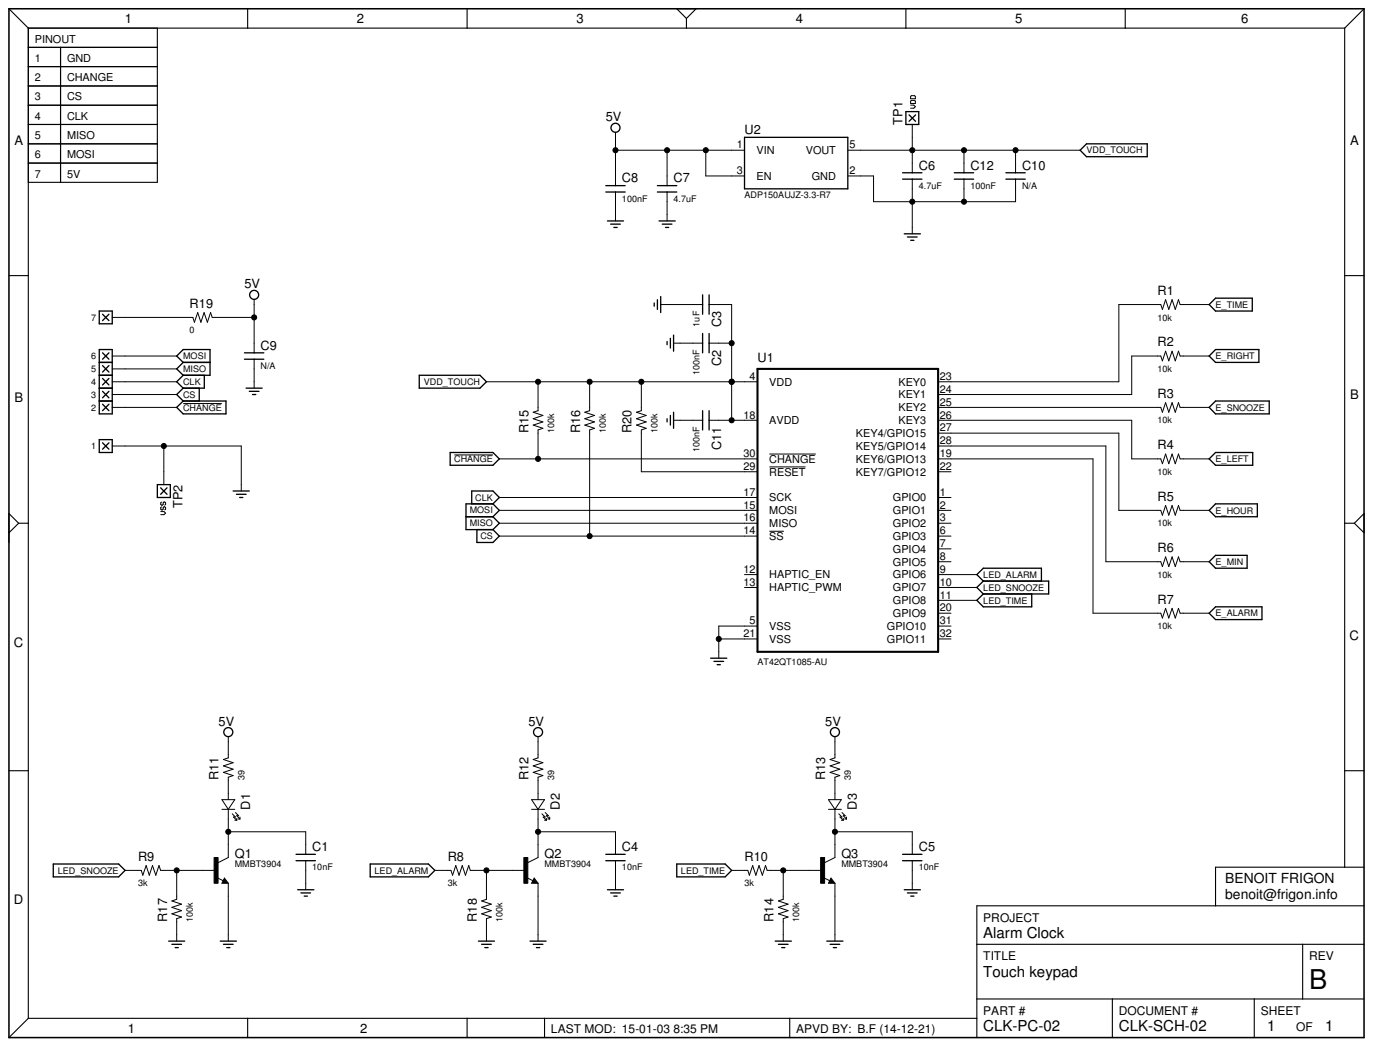
[picture p58: page 1]

PINOUT | 5V
1 | GND
2 | CHANGE CS

5 | CLK MISO MOSI

7 | 5V
