bfrigon/alarm-clock-hardware/drawings/schematics/clk-sch-51.pdf

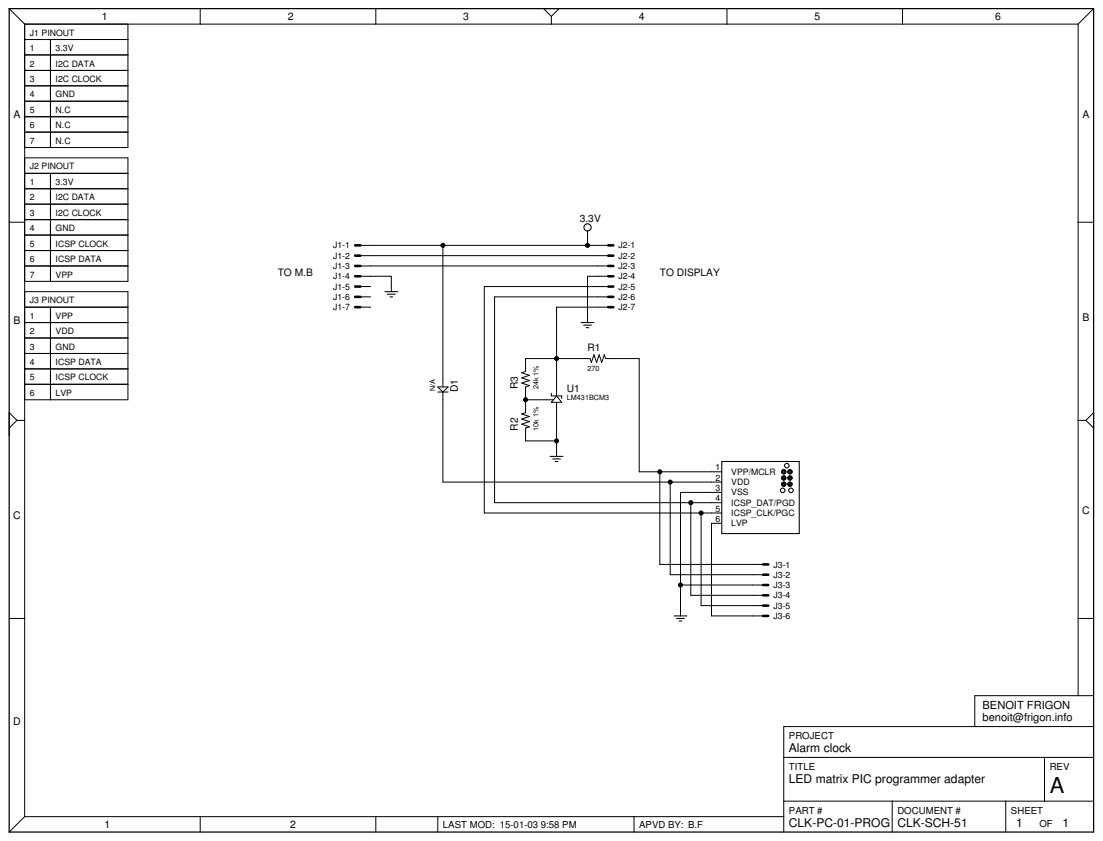
[picture p59: page 1]

J1 PINOUT
1 | 3.3V
2 | I2C DATA
3 | I2C CLOCK GND
5 | N.C
6 | N.C
7 | N.C

5 | ICSP CLOCK
6 | ICSP DATA
7 | VPP

1 | VPP
2 | VDD GND
4 | ICSP DATA
6 | LVP
