bfrigon/alarm-clock-hardware/drawings/schematics/clk-sch-04.pdf

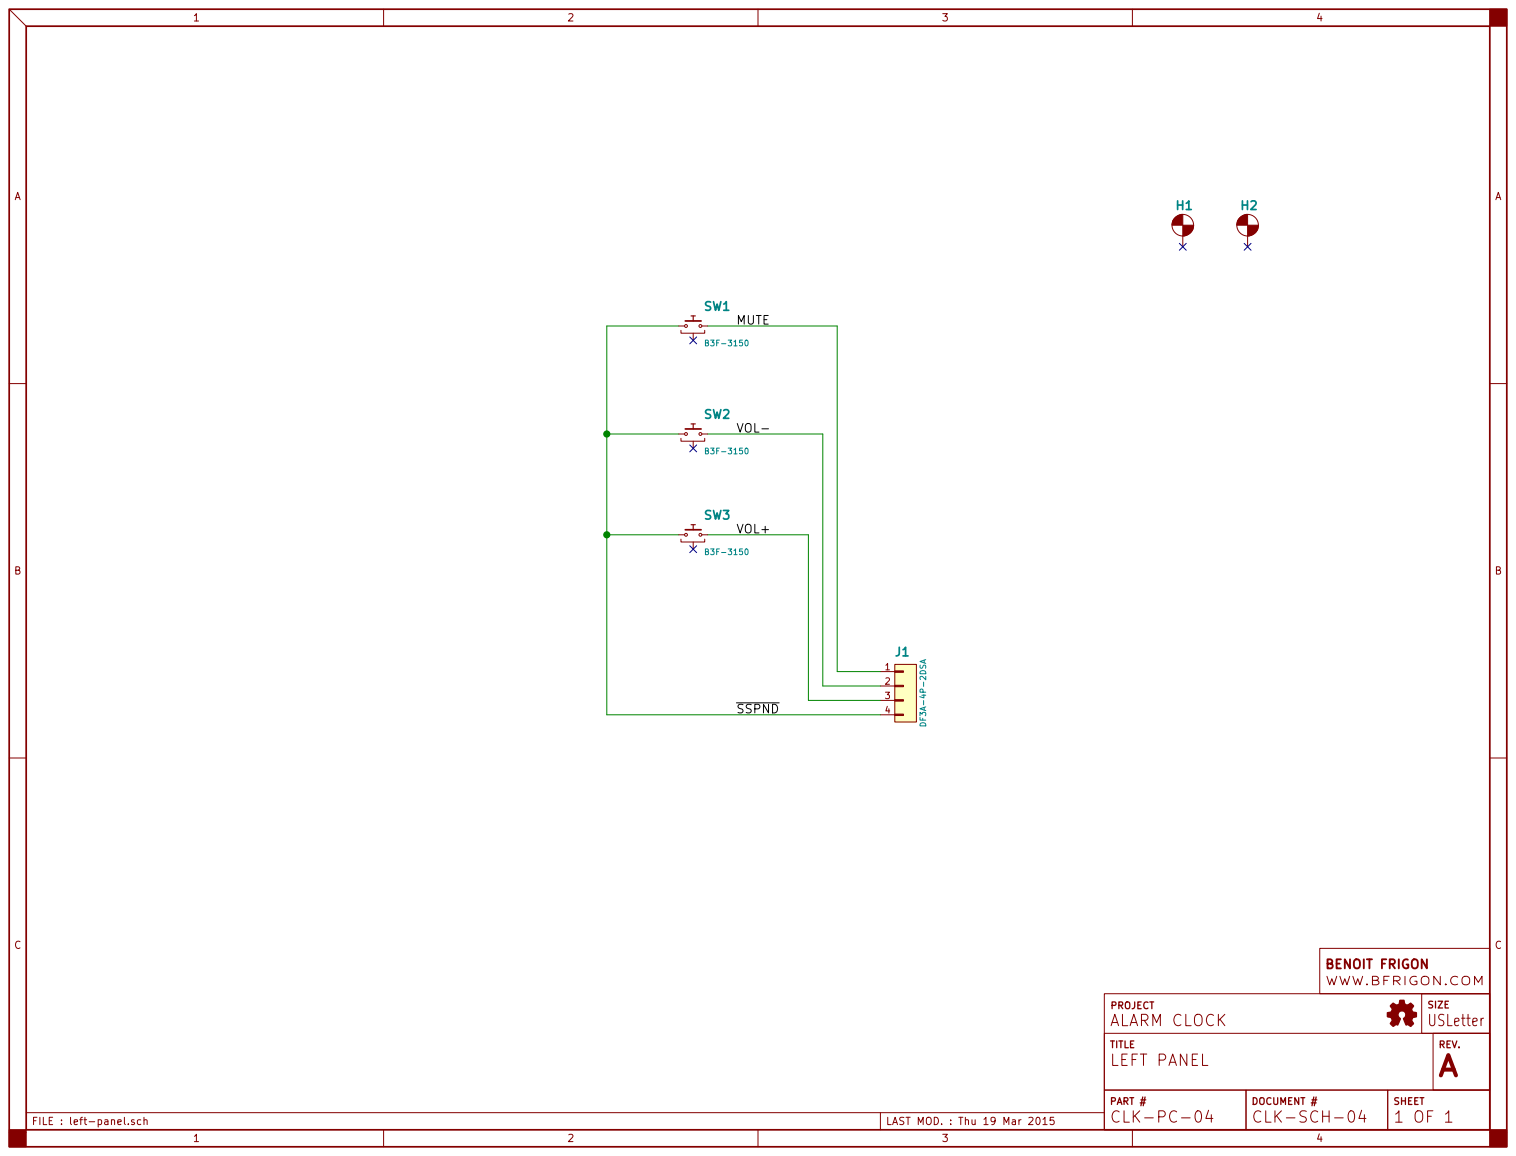
[picture p60: page 1]

TITLE WWW.BFRIGON.COM

REV. PROJECT LEFT PANEL

PART # | | A

DOCUMENT # CLK-PC-04 | SHEET CLK-SCH-04
