bfrigon/alarm-clock-hardware/drawings/design/clk-dwg-03.pdf

MIN. CLEARANCE; SHEET 1 OF 1; Alarm Clock; PART #; DOCUMENT #; UNITS; DATE 3/21/2015; SCALE 3:2; PCB FR-4; NOTES :; APVD BY :

TAG | X LOC | Y LOC | SIZE
A1 | 0.05 | 1.15
A2 | 0.05 | 2.60
A3 | 0.70 | 21 2"
A4 | 0.70 | 2.60
A5 | 0.60 | 1.10
A6 | 0.80 | 21 2"
A7 | 0.80 | 2.60
A8 | 0.90 | 21 2"
A9 | 0.90 | 2.60
A10 | 1" | 21 2"
A11 | 1" | 2.60
A12 | 1.10 | 21 2"
A13 | 1.10 | 2.60
B1 | 0.34 | 0.23 | 0.129 THRU ALL
B2 | 0.34 | 2.70
B3 | 2.15 | 0.23

BENOIT FRIGON
benoit@frigon.info
www.bfrigon.com

File : clk-dwg-03
