bfrigon/alarm-clock-hardware/drawings/design/clk-dwg-06.pdf

SHEET 1 OF 1; Alarm Clock; Display base; PART #; DOCUMENT #; UNITS; DATE 2/8/2015; SCALE 5:2; 1" x 0.5" aluminum "U"; NOTES :; APVD BY :

TAG | X LOC | Y LOC | SIZE
A1 | 5 16" | 1 4" | 0.166 THRU ALL
A2 | 5 16" | 43 4"
B1 | 3 8" | 21 2" | 0.166 THRU ALL 1

BENOIT FRIGON
benoit@frigon.info
www.bfrigon.com

File : clk-dwg-06
