bfrigon/alarm-clock-hardware/drawings/design/clk-dwg-07.pdf

SHEET 1 OF 2; Alarm Clock; Keypad overlay; PART #; DOCUMENT #; UNITS; DATE 2/8/2015; SCALE 3:2; NOTES :; APVD BY :

BENOIT FRIGON
benoit@frigon.info
www.bfrigon.com

File : clk-dwg-07

SHEET 2 OF 2; Alarm Clock; Keypad overlay; PART #; DOCUMENT #; UNITS; DATE 2/8/2015; SCALE 3:2; NOTES :; Buttons layout; APVD BY :

BENOIT FRIGON
benoit@frigon.info
www.bfrigon.com

File : clk-dwg-07
