bfrigon/alarm-clock-hardware/drawings/schematics/clk-sch-05.pdf

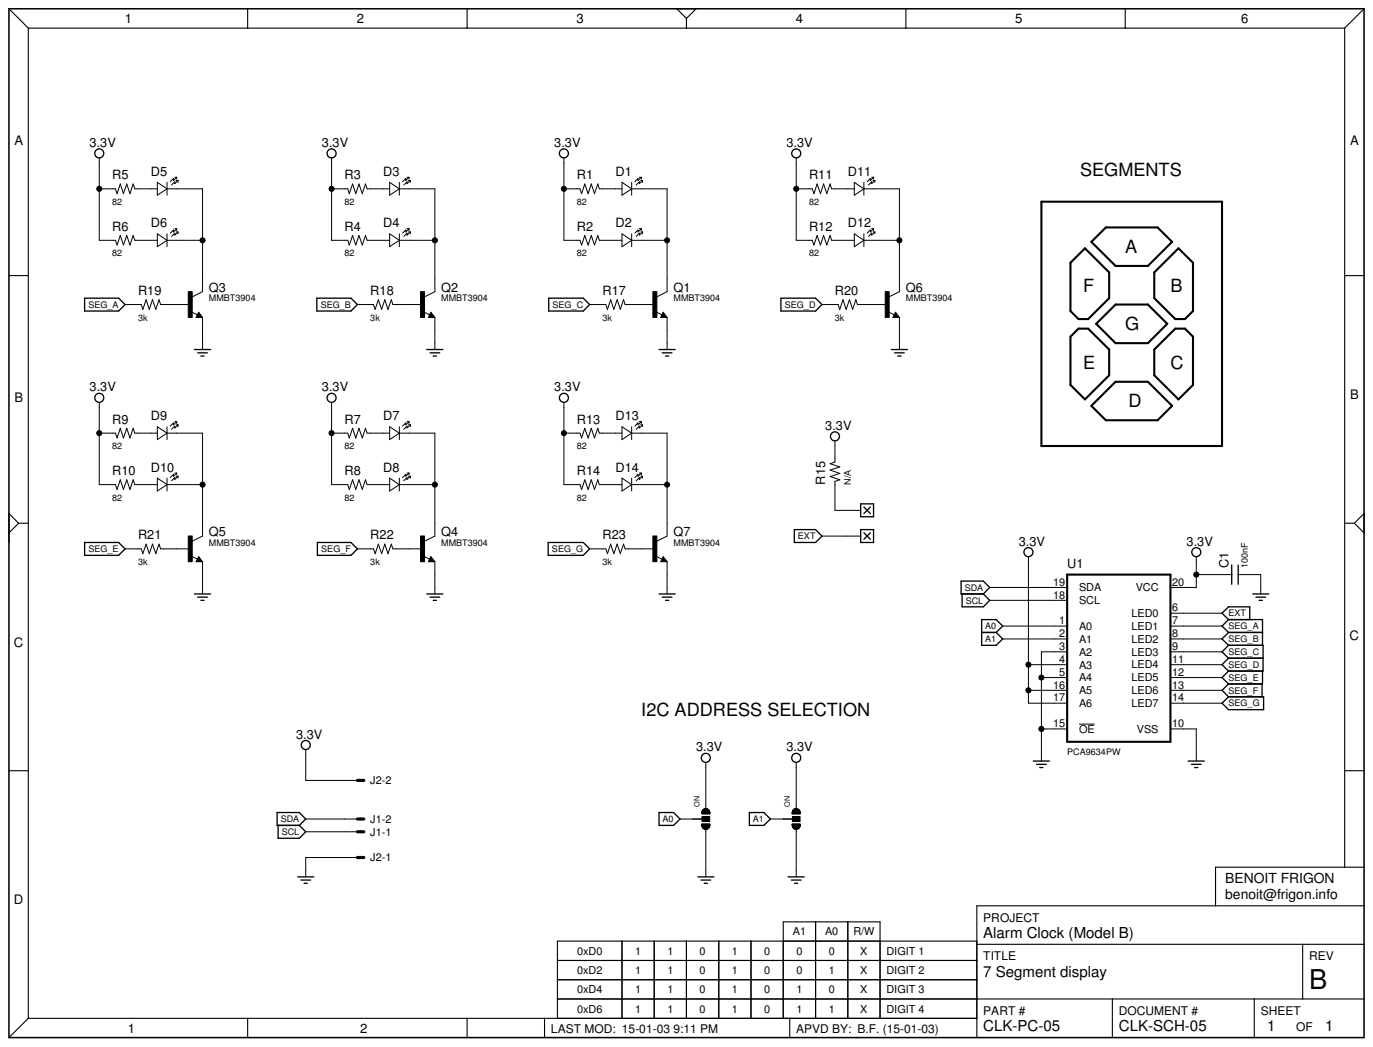
[picture p61: page 1]

0xD0 | 1 | 1 | 0 | 1 | 0 | 0 | 0 | X | | TITLE 7 Segment display | REV B

0xD2 | 1 | 1 | 0 | 1 | 0 0 | 1 0 | 1 1 | X | DIGIT 1 DIGIT 2 DIGIT 3 DIGIT 4
