bfrigon/alarm-clock-hardware/drawings/schematics/clk-sch-06.pdf

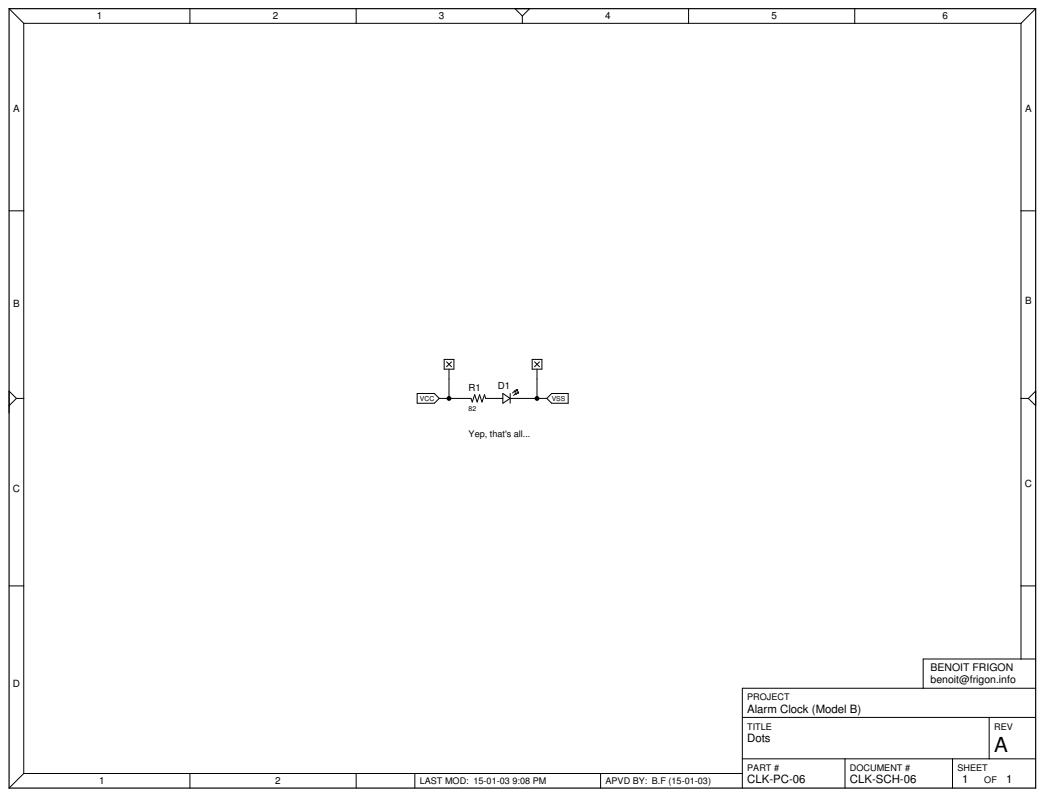
[picture p62: page 1]
