bfrigon/alarm-clock-hardware/drawings/schematics/clk-sch-07.pdf

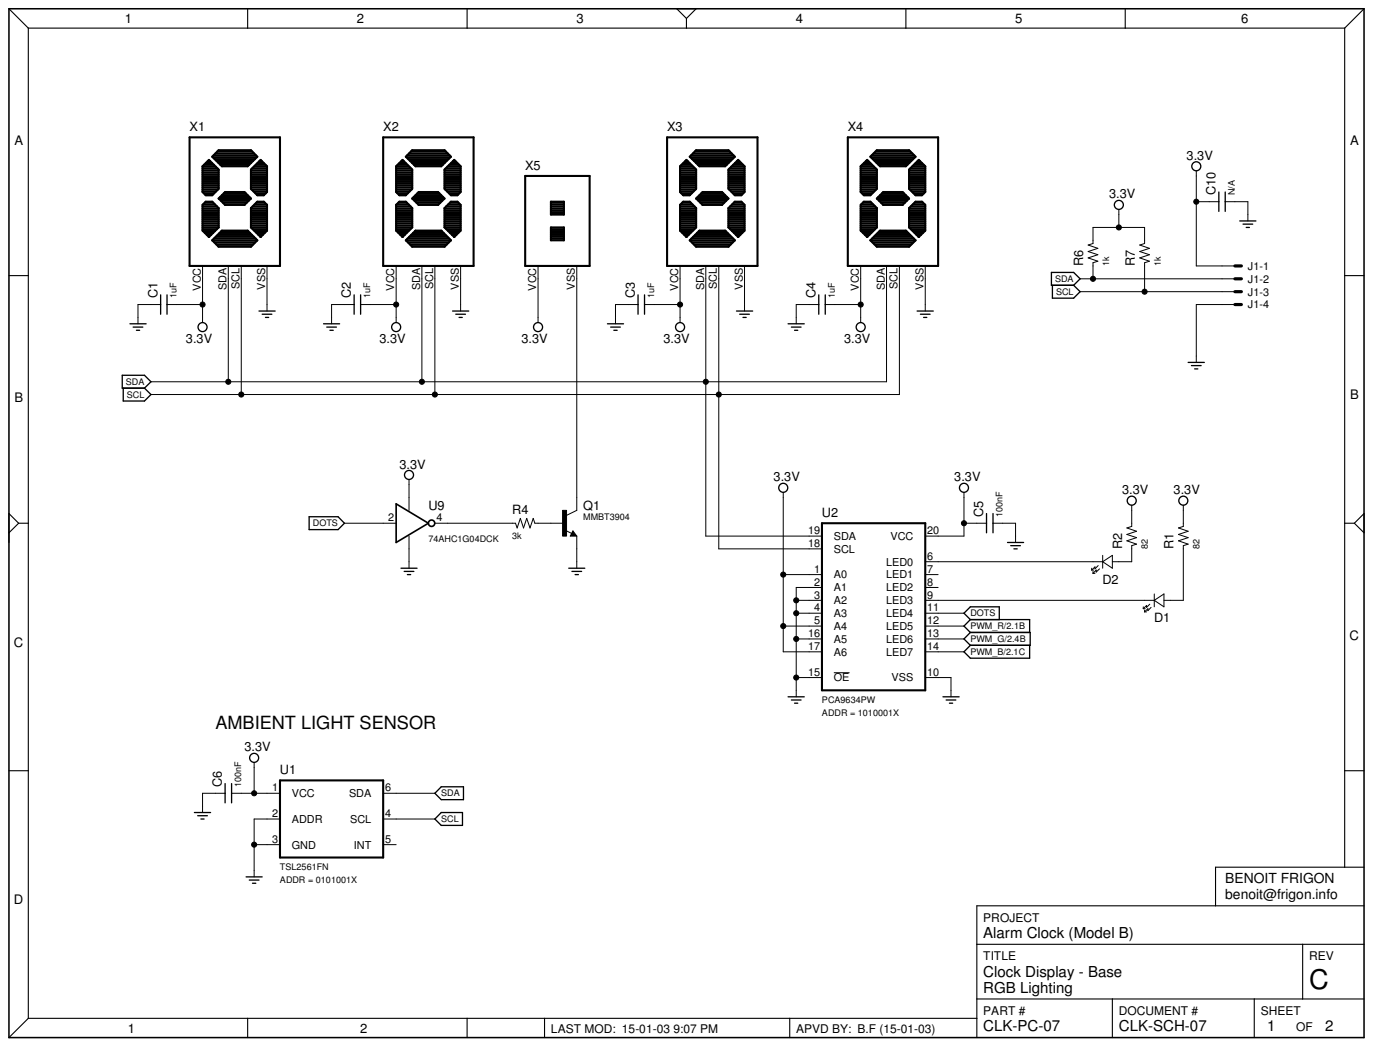
[picture p63: page 1]

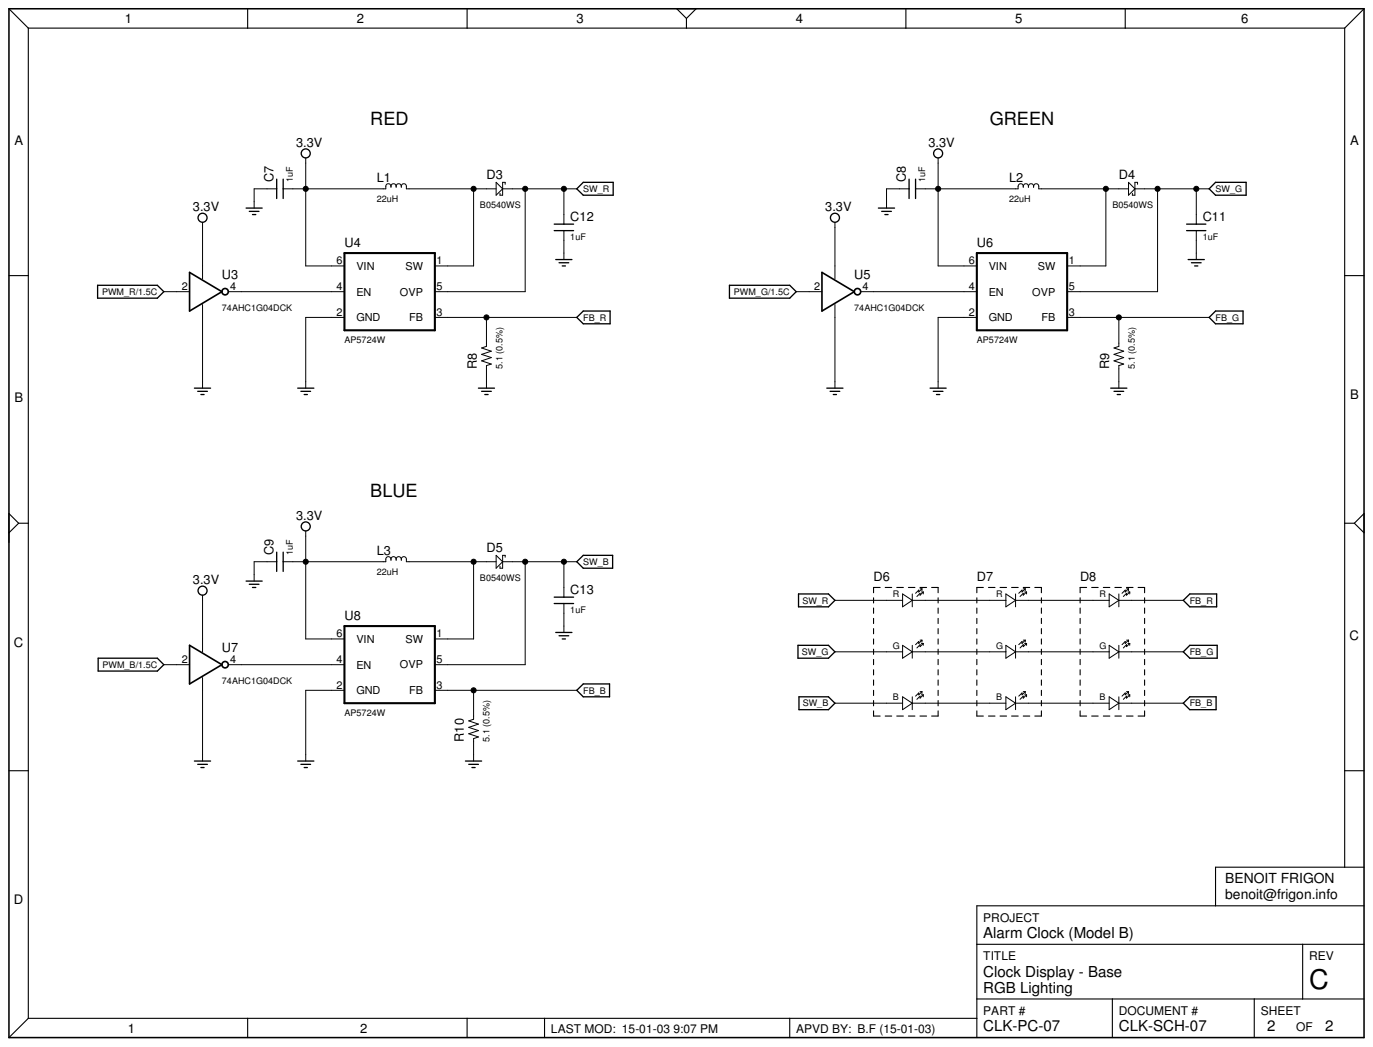
[picture p64: page 2]
