bfrigon/alarm-clock-hardware/drawings/schematics/clk-sch-50.pdf

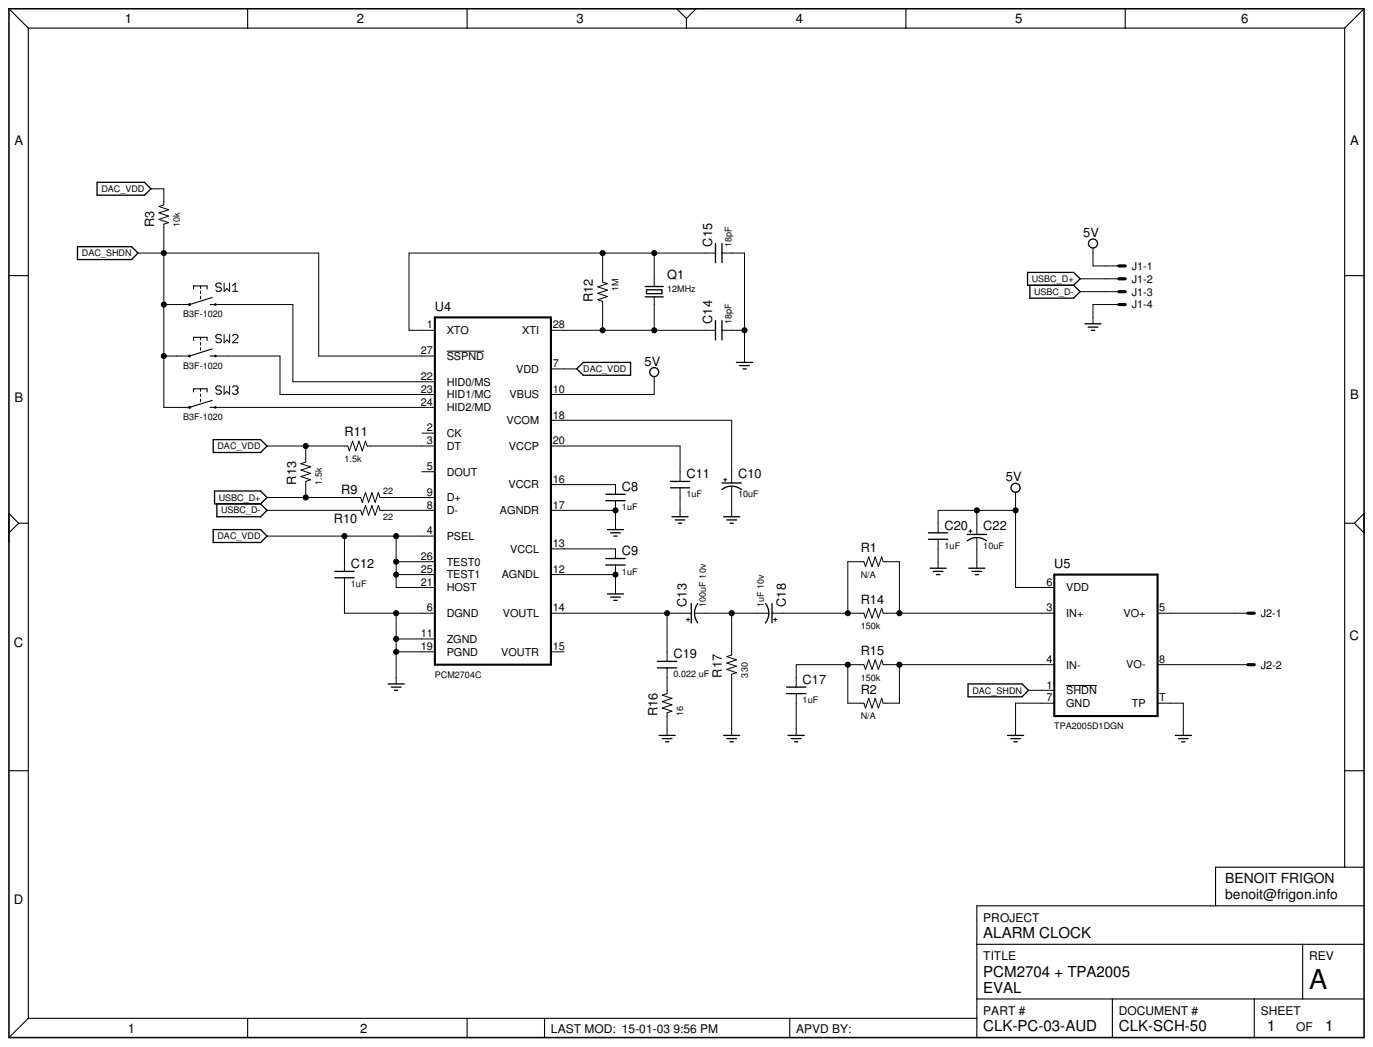
[picture p65: page 1]
