bfrigon/alarm-clock-hardware/pcb/motherboard/motherboard.kicad_pcb

## KiCad design pcb/motherboard/motherboard.kicad_pcb (2015-05-03)

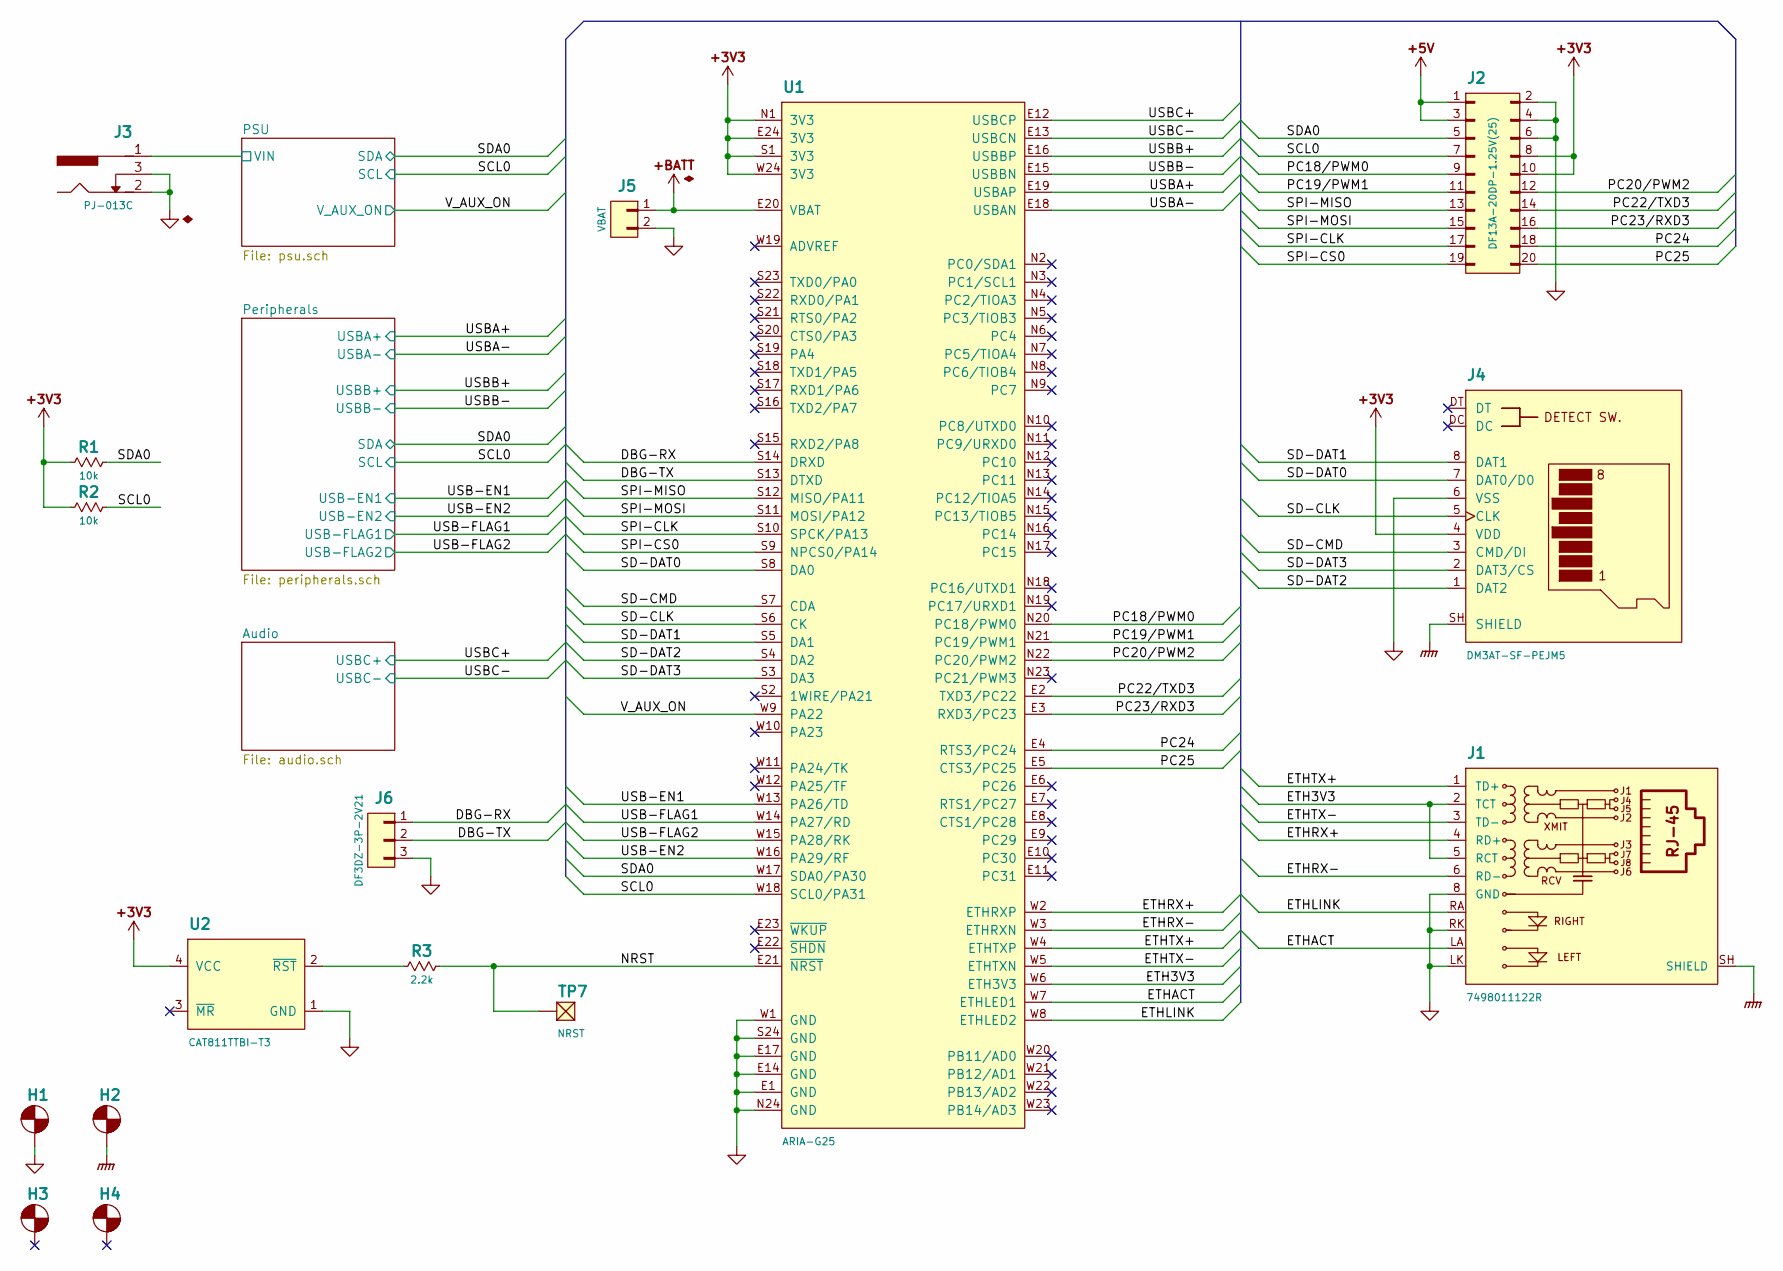
[picture p66: schematic motherboard.sch]

Parts:
H1, H2, H3, H4: Hole; Hole-Screw-#4
J1: 7498011122R; RJ45-WURTH-7498011122R
J2: DF13A-20DP-1.25V(25); DF13A-20DP-1.25
J3: PJ-013C; CUI-PJ-031CH
J4: DM3AT-SF-PEJM5; HIROSE-MICROSD-DM3AT-SF
J5: VBAT; WP-75mil-1x02
J6: DF3DZ-3P-2V21; DF3DZ-3P-2VXX
R1, R2: 10k; R-0603
R3: 2.2k; R-0603
TP7: NRST; TEST-POINT-50
U1: ARIA-G25
U2: CAT811TTBI-T3; SOT-143

Connections:
+BATT: J5.1, U1.E20 (VBAT)
/Audio/USBC+: U1.E12 (USBCP); also elsewhere on the board
/Audio/USBC-: U1.E13 (USBCN); also elsewhere on the board
/DBG-RX: J6.1, U1.S14 (DRXD)
/DBG-TX: J6.2, U1.S13 (DTXD)
/ETH3V3: J1.2 (TCT), J1.5 (RCT), U1.W6 (ETH3V3)
/ETHACT: J1.LA, U1.W7 (ETHLED1)
/ETHLINK: J1.RA, U1.W8 (ETHLED2)
/ETHRX+: J1.4 (RD+), U1.W2 (ETHRXP)
/ETHRX-: J1.6 (RD-), U1.W3 (ETHRXN)
/ETHTX+: J1.1 (TD+), U1.W4 (ETHTXP)
/ETHTX-: J1.3 (TD-), U1.W5 (ETHTXN)
/NRST: R3.2, TP7.1, U1.E21 (~NRST)
/PC18/PWM0: J2.9, U1.N20 (PC18/PWM0)
/PC19/PWM1: J2.11, U1.N21 (PC19/PWM1)
/PC20/PWM2: J2.12, U1.N22 (PC20/PWM2)
/PC22/TXD3: J2.14, U1.E2 (TXD3/PC22)
/PC23/RXD3: J2.16, U1.E3 (RXD3/PC23)
/PC24: J2.18, U1.E4 (RTS3/PC24)
/PC25: J2.20, U1.E5 (CTS3/PC25)
/PSU/SCL: J2.7, R2.2, U1.W18 (SCL0/PA31); also elsewhere on the board
/PSU/SDA: J2.5, R1.2, U1.W17 (SDA0/PA30); also elsewhere on the board
/PSU/VIN: J3.1; also elsewhere on the board
/PSU/V_AUX_ON: U1.W9 (PA22); also elsewhere on the board
/Peripherals/USB-EN1: U1.W13 (PA26/TD); also elsewhere on the board
/Peripherals/USB-EN2: U1.W16 (PA29/RF); also elsewhere on the board
/Peripherals/USB-FLAG1: U1.W14 (PA27/RD); also elsewhere on the board
/Peripherals/USB-FLAG2: U1.W15 (PA28/RK); also elsewhere on the board
/Peripherals/USBA+: U1.E19 (USBAP); also elsewhere on the board
/Peripherals/USBA-: U1.E18 (USBAN); also elsewhere on the board
/Peripherals/USBB+: U1.E16 (USBBP); also elsewhere on the board
/Peripherals/USBB-: U1.E15 (USBBN); also elsewhere on the board
/SD-CLK: J4.5 (CLK), U1.S6 (CK)
/SD-CMD: J4.3 (CMD/DI), U1.S7 (CDA)
/SD-DAT0: J4.7 (DAT0/D0), U1.S8 (DA0)
/SD-DAT1: J4.8 (DAT1), U1.S5 (DA1)
/SD-DAT2: J4.1 (DAT2), U1.S4 (DA2)
/SD-DAT3: J4.2 (DAT3/CS), U1.S3 (DA3)
/SPI-CLK: J2.17, U1.S10 (SPCK/PA13)
/SPI-CS0: J2.19, U1.S9 (NPCS0/PA14)
/SPI-MISO: J2.13, U1.S12 (MISO/PA11)
/SPI-MOSI: J2.15, U1.S11 (MOSI/PA12)
unnamed: R3.1, U2.2 (~RST)

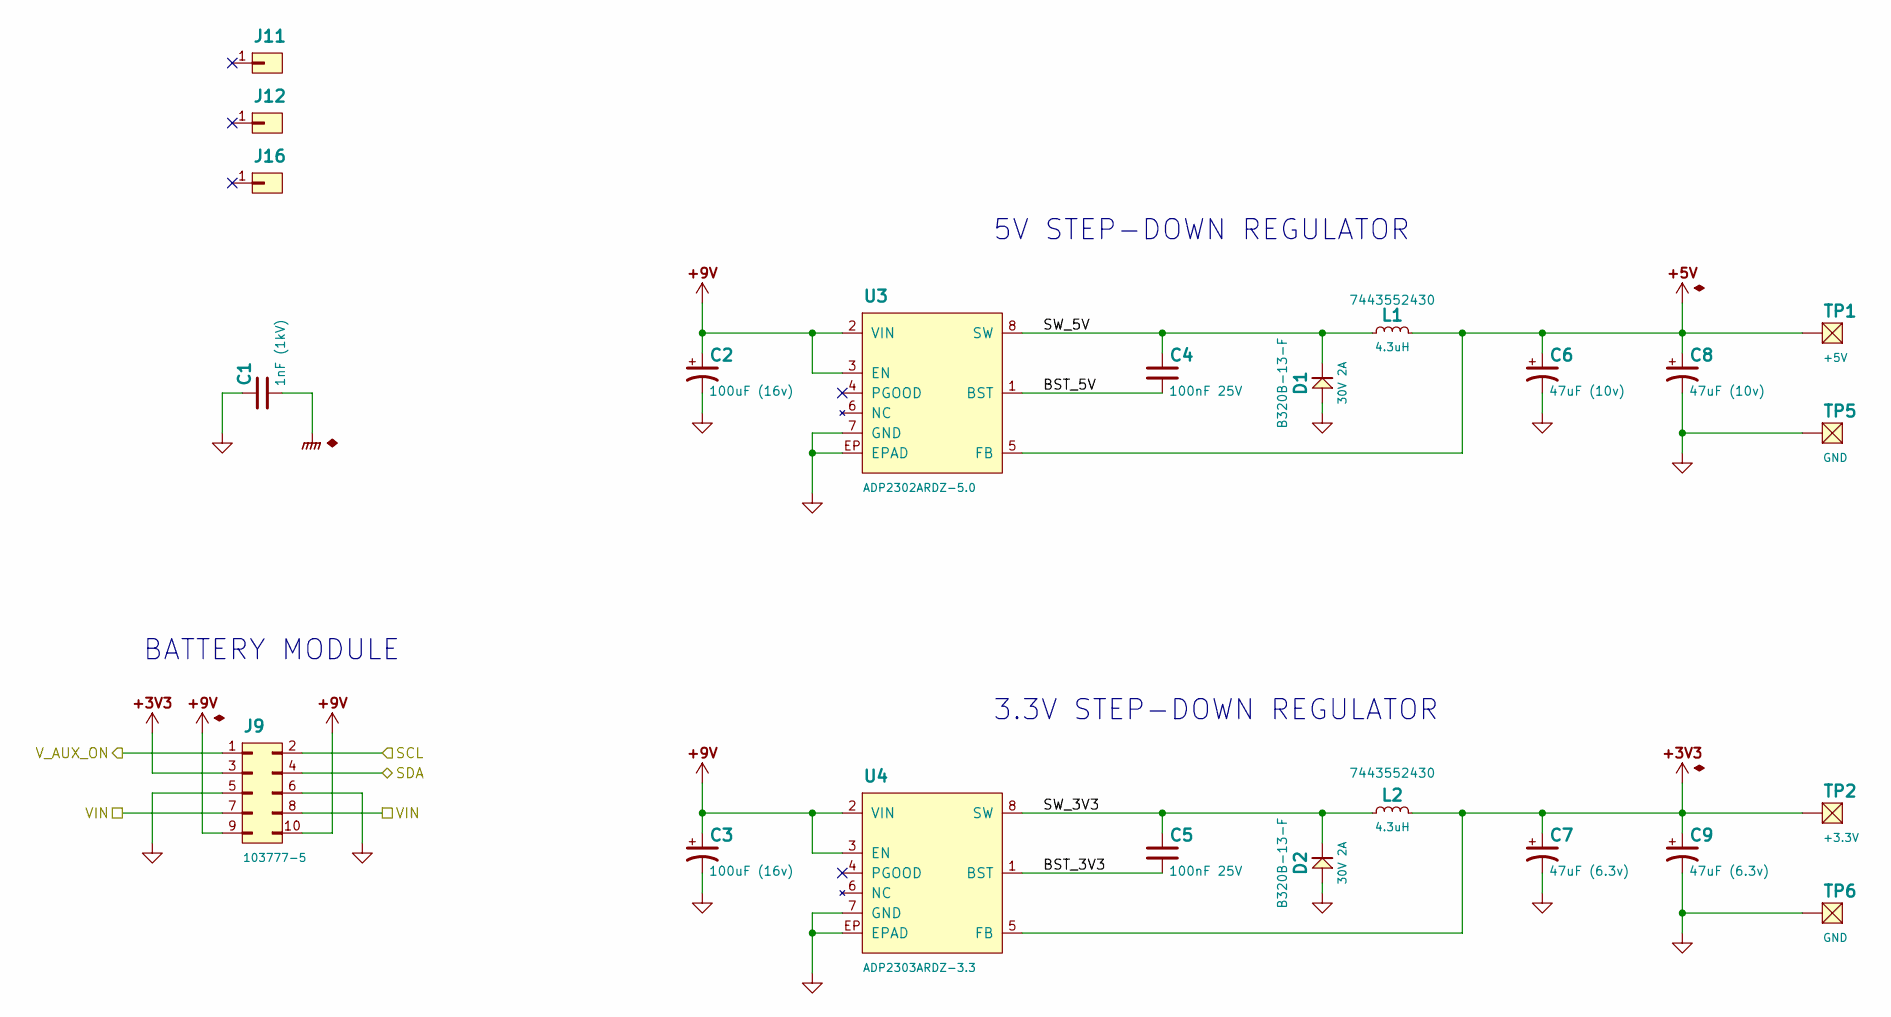
[picture p67: schematic psu.sch, MOTHERBOARD\\nPSU]

Parts:
C1: 1nF (1kV); C-0805
C2, C3: 100uF (16v); CPL-1210; Part EMK325ABJ107MM-T
C4, C5: 100nF 25V; C-0603
C6, C8: 47uF (10v); CPL-1206; Part LMK316BJ476ML-T
C7, C9: 47uF (6.3v); CPL-1206; Part GRM31CR60J476ME19K
D1: 30V 2A; DO-214-AA; PART B320B-13-F
D2: 30V 2A; DO-214-AA; Part B320B-13-F
J9: 103777-5; HDR-M-2x05
J11, J12, J16: 103741-1; HDR-M-1x01
L1, L2: 4.3uH; IND-10X10; PART 7443552430
TP1: +5V; TEST-POINT-50
TP2: +3.3V; TEST-POINT-50
TP5, TP6: GND; TEST-POINT-50
U3: ADP2302ARDZ-5.0; 8-EP
U4: ADP2303ARDZ-3.3; 8-EP

Connections:
/PSU/BST_3V3: C5.1, U4.1 (BST)
/PSU/BST_5V: C4.1, U3.1 (BST)
/PSU/SCL: J9.2; also elsewhere on the board
/PSU/SDA: J9.4; also elsewhere on the board
/PSU/SW_3V3: C5.2, D2.K, L2.1, U4.8 (SW)
/PSU/SW_5V: C4.2, D1.K, L1.1, U3.8 (SW)
/PSU/VIN: J9.7, J9.8; also elsewhere on the board
/PSU/V_AUX_ON: J9.1; also elsewhere on the board

Notes on the sheet:
5V STEP-DOWN REGULATOR
3.3V STEP-DOWN REGULATOR
BATTERY MODULE

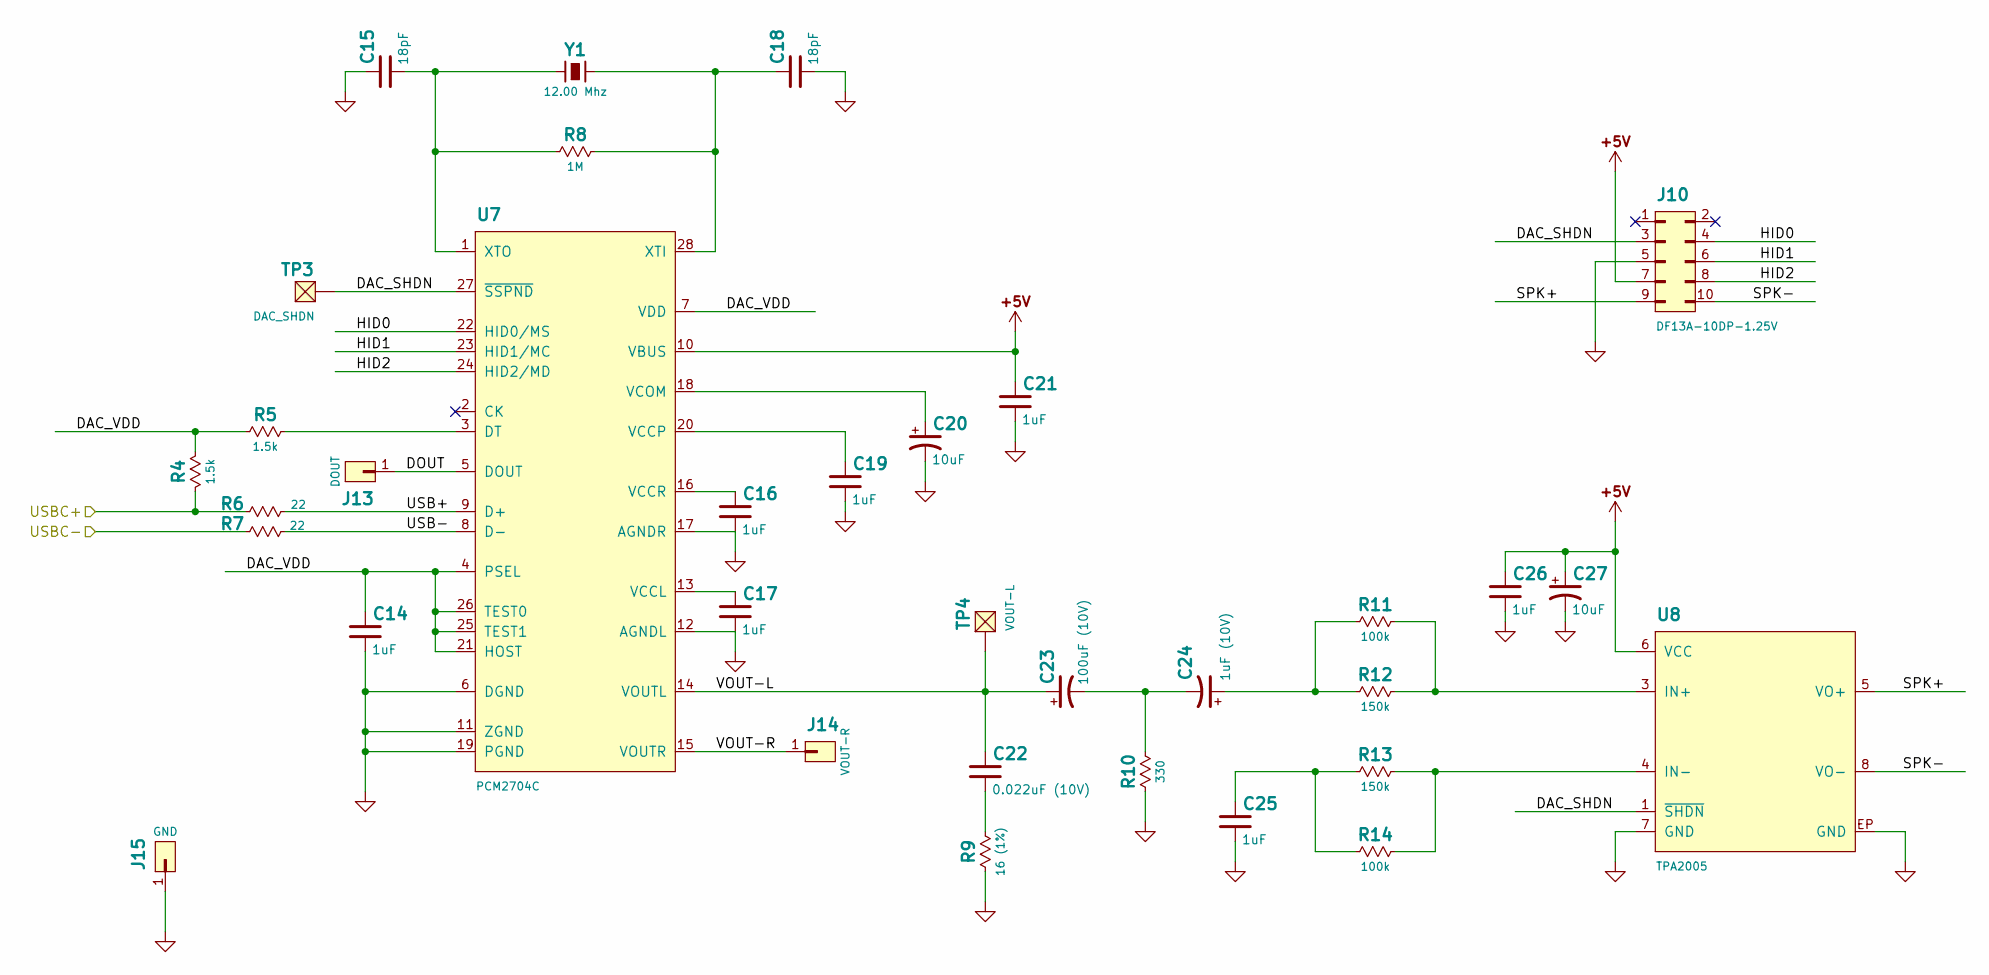
[picture p68: schematic audio.sch, MOTHERBOARD\\nAUDIO]

Parts:
C14, C16, C17, C19, C21, C25, C26: 1uF; C-0603
C15, C18: 18pF; C-0603
C20, C27: 10uF; CPL-0805
C22: 0.022uF (10V); C-0603
C23: 100uF (10V); CPL-1210
C24: 1uF (10V); CPL-0805
J10: DF13A-10DP-1.25V; DF13A-10DP-1.25
J13: DOUT; WP-50mil-1x01
J14: VOUT-R; WP-50mil-1x01
J15: GND; WP-50mil-1x01
R4, R5: 1.5k; R-0603
R6, R7: 22; R-0603
R8: 1M; R-0603
R9: 16 (1%); R-0603
R10: 330; R-0603
R11, R14: 100k; R-0603
R12, R13: 150k; R-0603
TP3: DAC_SHDN; TEST-POINT-50
TP4: VOUT-L; TEST-POINT-50
U7: PCM2704C; SSOP28
U8: TPA2005; PPSOP8
Y1: 12.00 Mhz; HC49UP

Connections:
/Audio/DAC_SHDN: J10.3, TP3.1, U7.27 (~SSPND), U8.1 (~SHDN)
/Audio/DAC_VDD: C14.2, R4.1, R5.1, U7.4 (PSEL), U7.7 (VDD), U7.21 (HOST), U7.25 (TEST1), U7.26 (TEST0)
/Audio/DOUT: J13.1, U7.5 (DOUT)
/Audio/HID0: J10.4, U7.22 (HID0/MS)
/Audio/HID1: J10.6, U7.23 (HID1/MC)
/Audio/HID2: J10.8, U7.24 (HID2/MD)
/Audio/SPK+: J10.9, U8.5 (VO+)
/Audio/SPK-: J10.10, U8.8 (VO-)
/Audio/USB+: R6.2, U7.9 (D+)
/Audio/USB-: R7.2, U7.8 (D-)
/Audio/USBC+: R4.2, R6.1; also elsewhere on the board
/Audio/USBC-: R7.1; also elsewhere on the board
/Audio/VOUT-L: C22.2, C23.A, TP4.1, U7.14 (VOUTL)
/Audio/VOUT-R: J14.1, U7.15 (VOUTR)
unnamed: C15.1, R8.1, U7.1 (XTO), Y1.1
unnamed: C16.2, U7.16 (VCCR)
unnamed: C17.2, U7.13 (VCCL)
unnamed: C18.2, R8.2, U7.28 (XTI), Y1.2
unnamed: C19.2, U7.20 (VCCP)
unnamed: C20.A, U7.18 (VCOM)
unnamed: C22.1, R9.2
unnamed: C23.K, C24.K, R10.2
unnamed: C24.A, R11.1, R12.1
unnamed: C25.2, R13.1, R14.1
unnamed: R5.2, U7.3 (DT)
unnamed: R11.2, R12.2, U8.3 (IN+)
unnamed: R13.2, R14.2, U8.4 (IN-)

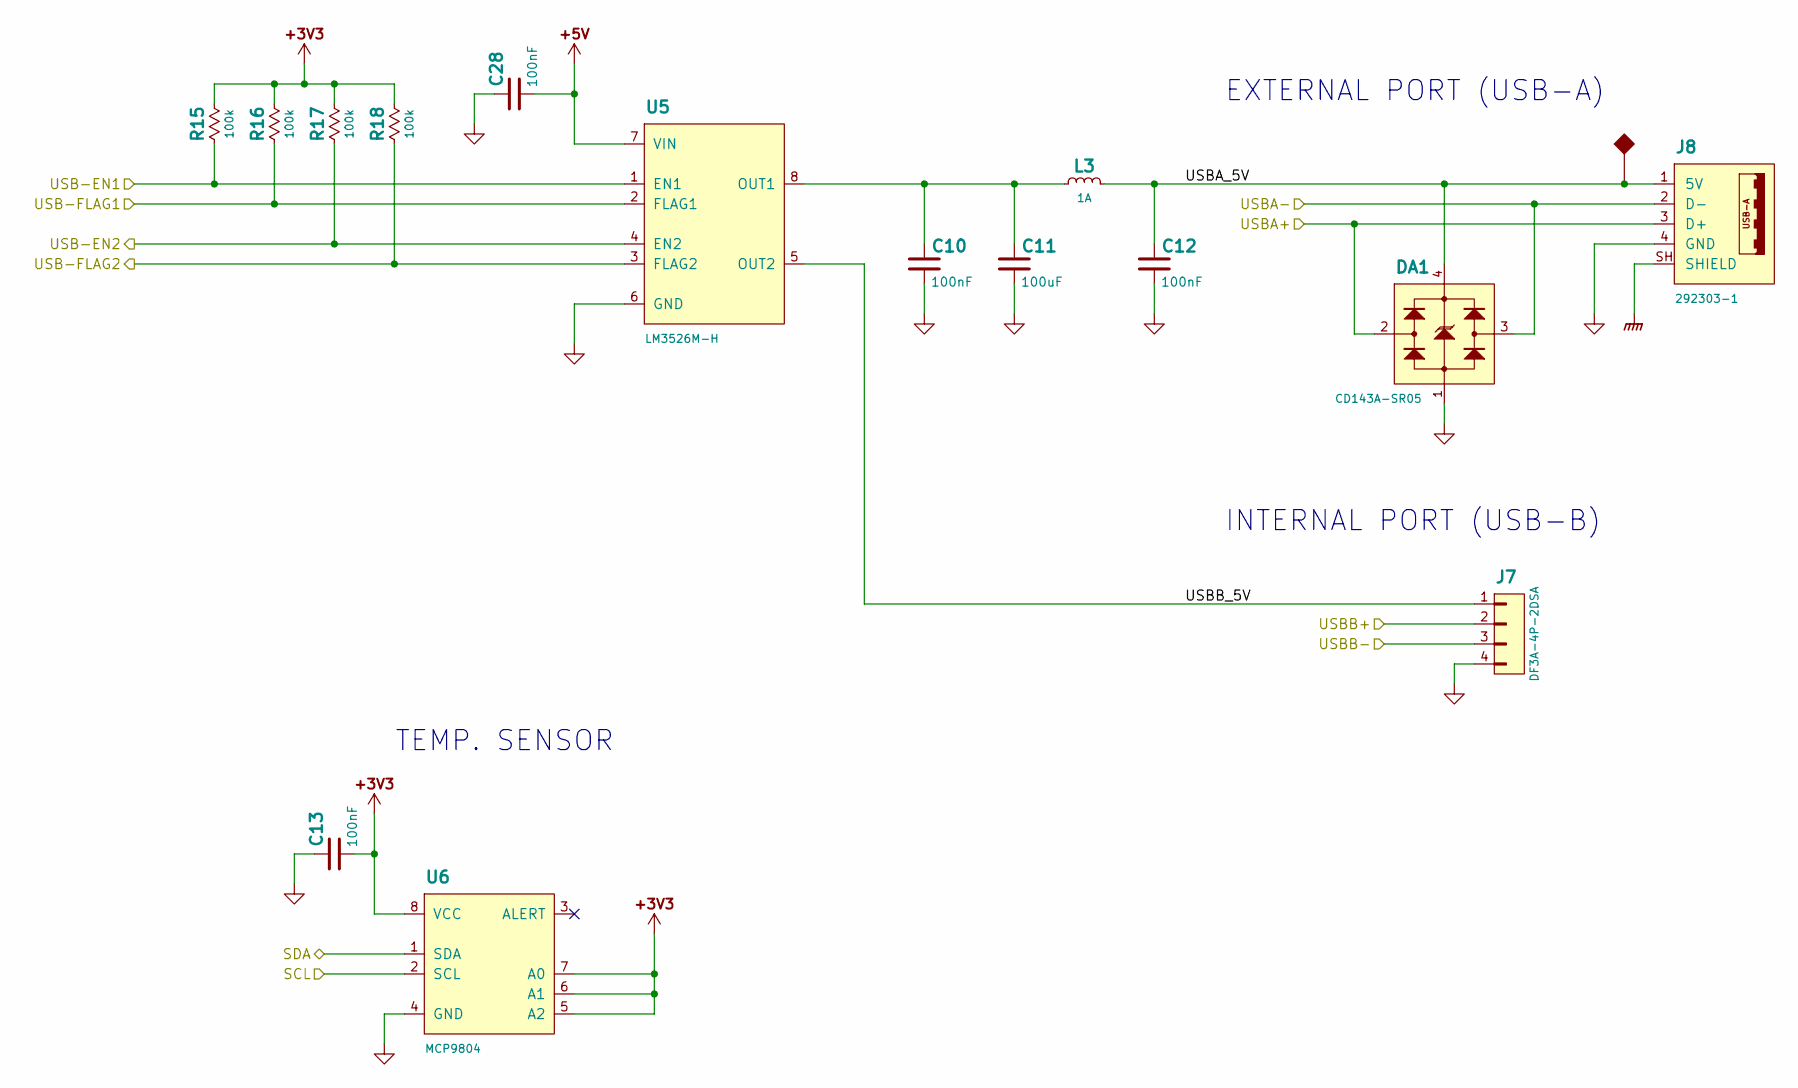
[picture p69: schematic peripherals.sch, MOTHERBOARD\\nPERIPHERALS]

Parts:
C10, C12, C13, C28: 100nF; C-0603
C11: 100uF; C-0805
DA1: CD143A-SR05; SOT-143
J7: DF3A-4P-2DSA
J8: 292303-1; USBA-TE-292303-1
L3: 1A; FER-0805
R15, R16, R17, R18: 100k; R-0603
U5: LM3526M-H; 8
U6: MCP9804; MSOP8

Connections:
/PSU/SCL: U6.2 (SCL); also elsewhere on the board
/PSU/SDA: U6.1 (SDA); also elsewhere on the board
/Peripherals/USB-EN1: R15.1, U5.1 (EN1); also elsewhere on the board
/Peripherals/USB-EN2: R17.1, U5.4 (EN2); also elsewhere on the board
/Peripherals/USB-FLAG1: R16.1, U5.2 (FLAG1); also elsewhere on the board
/Peripherals/USB-FLAG2: R18.1, U5.3 (FLAG2); also elsewhere on the board
/Peripherals/USBA+: DA1.2, J8.3 (D+); also elsewhere on the board
/Peripherals/USBA-: DA1.3, J8.2 (D-); also elsewhere on the board
/Peripherals/USBA_5V: C12.2, DA1.4, J8.1 (5V), L3.2
/Peripherals/USBB+: J7.2; also elsewhere on the board
/Peripherals/USBB-: J7.3; also elsewhere on the board
/Peripherals/USBB_5V: J7.1, U5.5 (OUT2)
unnamed: C10.2, C11.2, L3.1, U5.8 (OUT1)

Notes on the sheet:
INTERNAL PORT (USB-B)
EXTERNAL PORT (USB-A)
TEMP. SENSOR

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
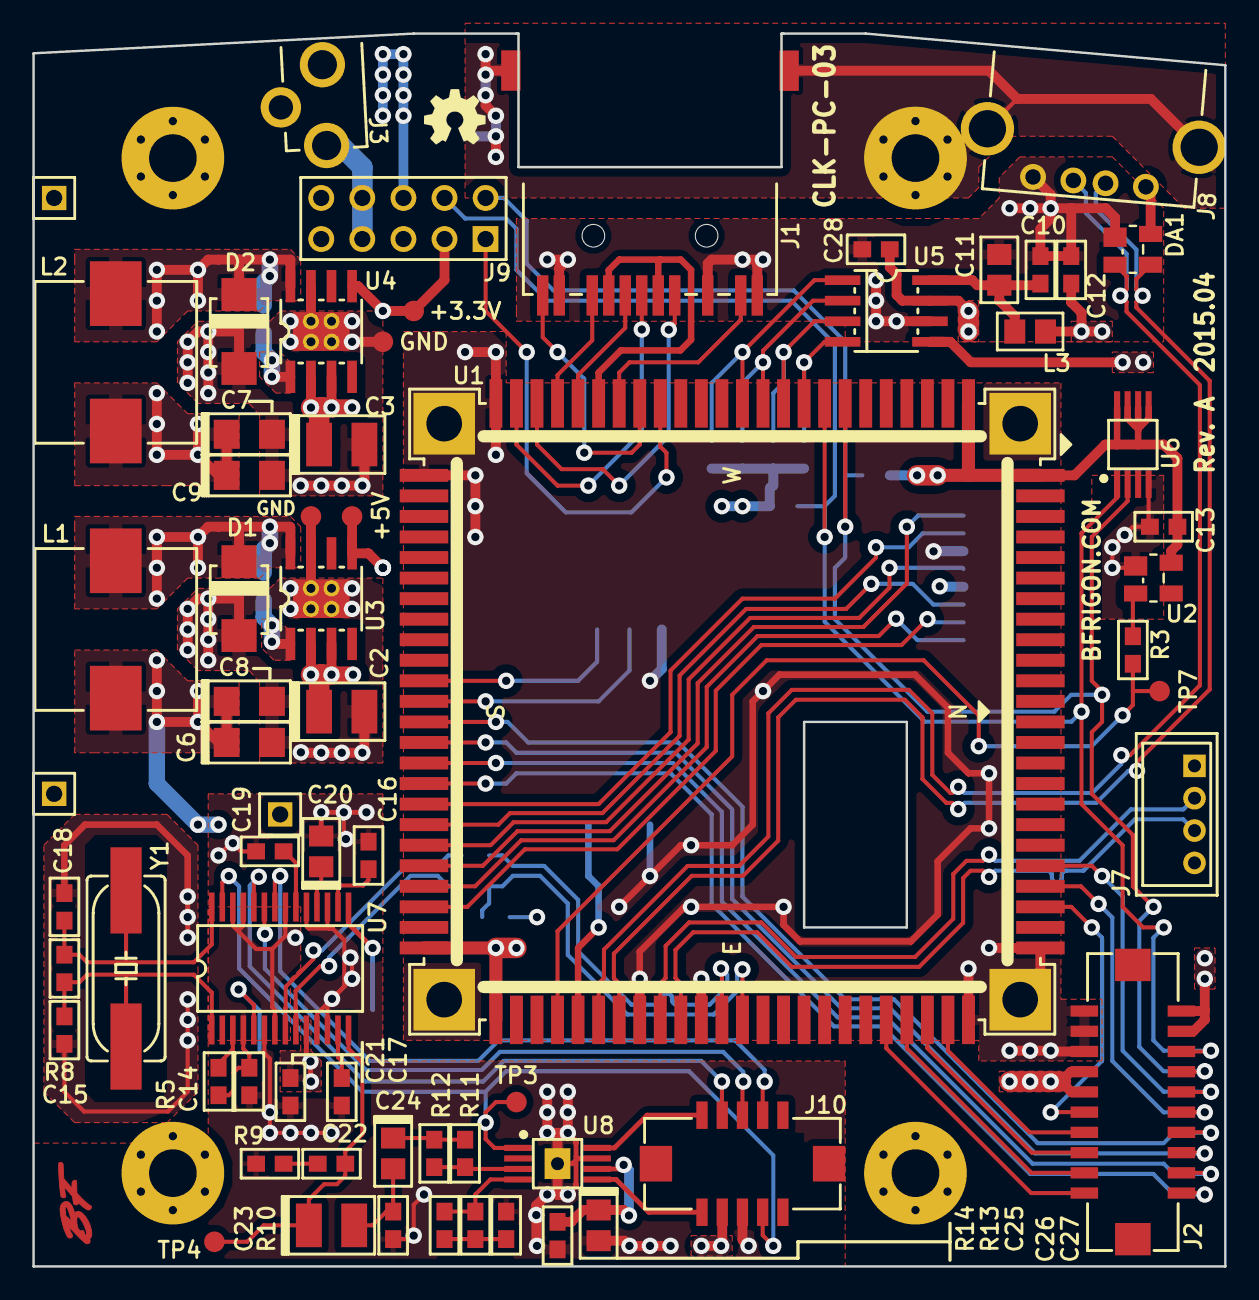
[picture p70: board motherboard.kicad_pcb from above]

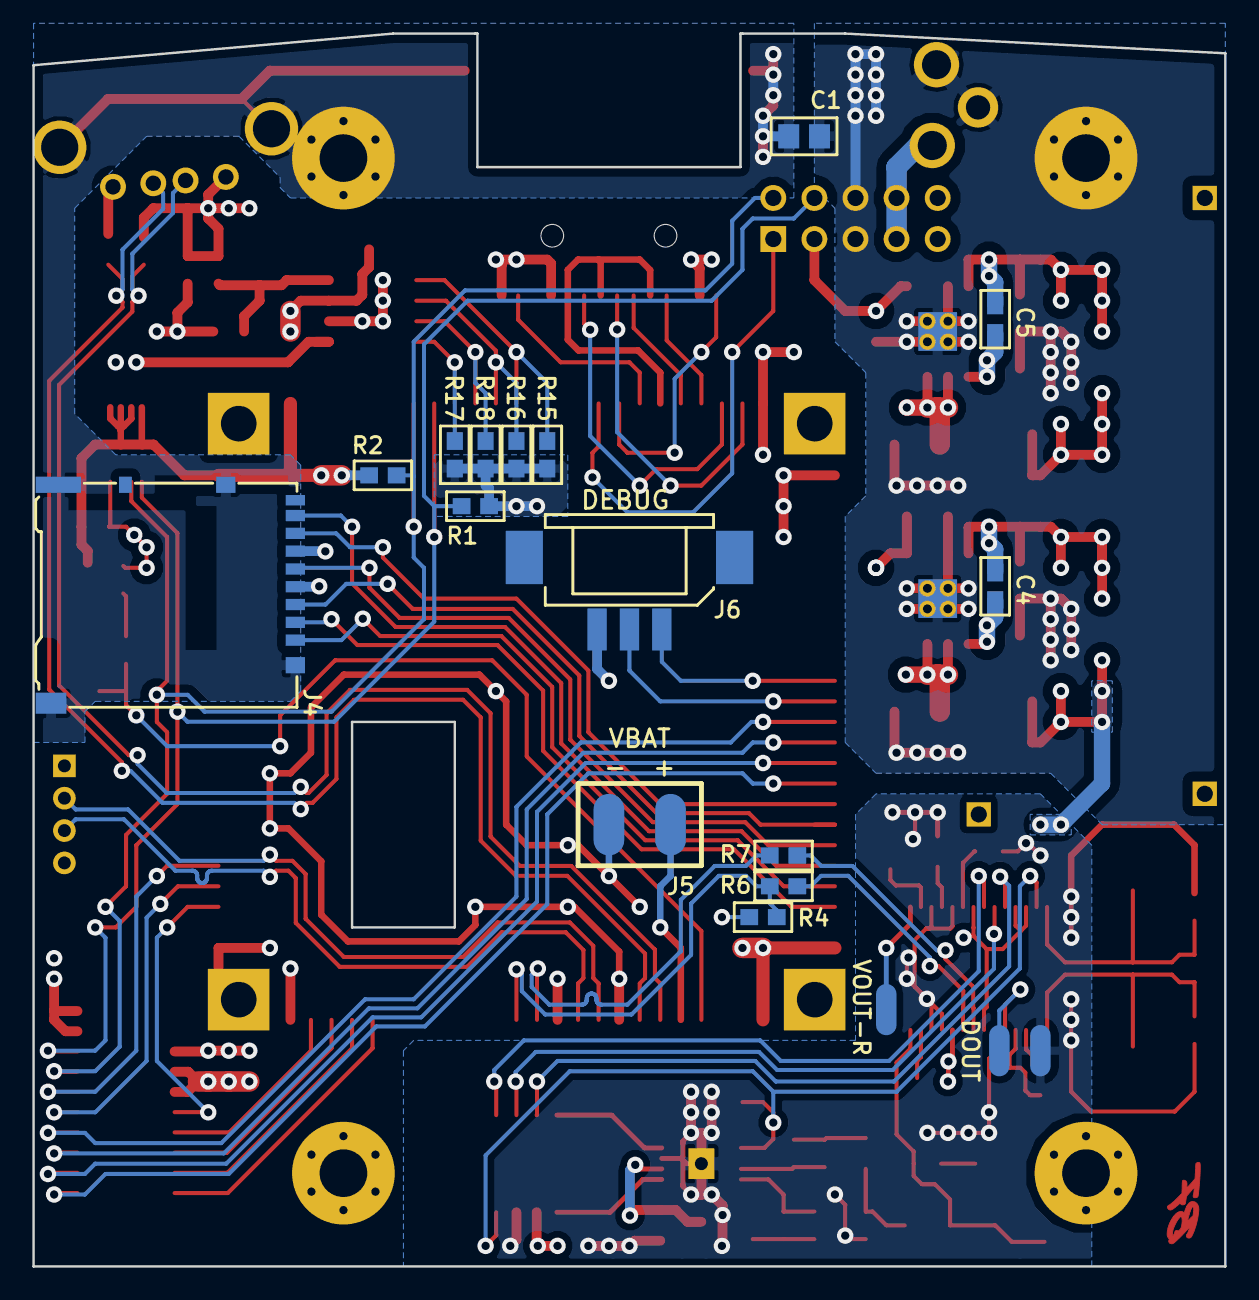
[picture p71: board motherboard.kicad_pcb from below]

Board: 4 copper layers, 73.7 x 76.2 mm, 89 parts (18 on the bottom side), 80 nets.

Other parts of the board:
LOGO-OSHW-150: OSHW; LOGO-OSHW-150
