bfrigon/alarm-clock-hardware/pcb/left-panel/left-panel.kicad_pcb

## KiCad design pcb/left-panel/left-panel.kicad_pcb (2015-04-12)

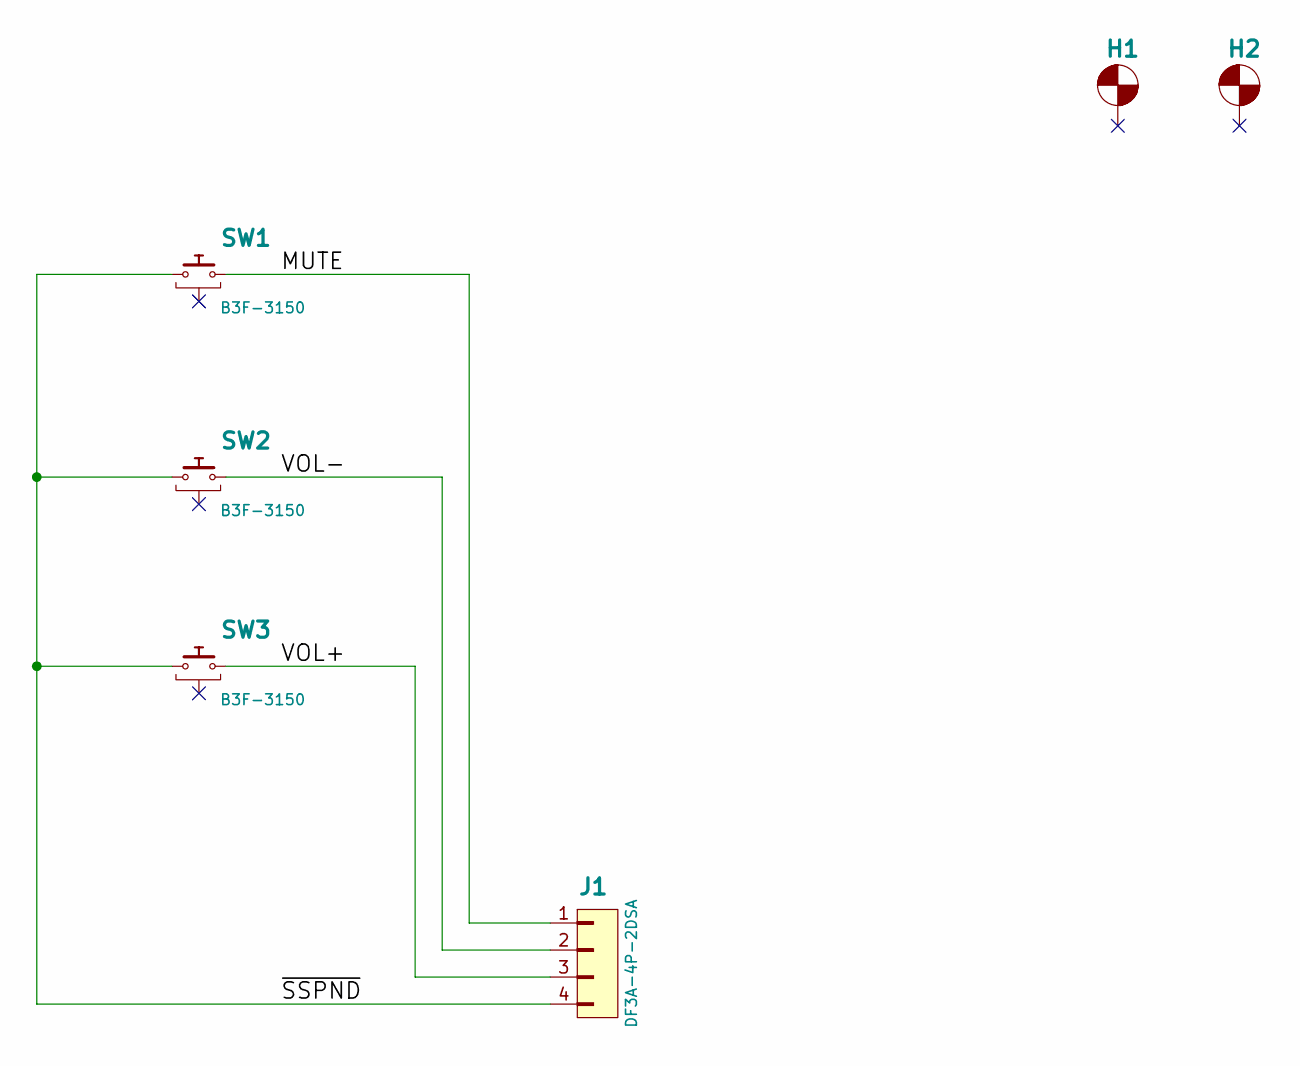
[picture p72: schematic left-panel.sch, LEFT PANEL]

Parts:
H1, H2: Hole; Hole-Screw-NP-#4
J1: DF3A-4P-2DSA
SW1, SW2, SW3: B3F-3150; B3F-315X

Connections:
/MUTE: J1.1, SW1.2
/VOL+: J1.3, SW3.2
/VOL-: J1.2, SW2.2
/~SSPND: J1.4, SW1.1, SW2.1, SW3.1

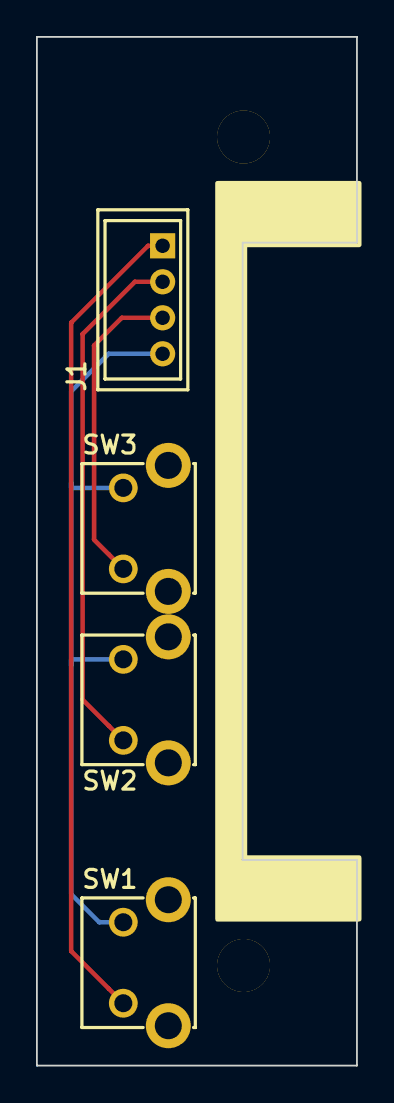
[picture p73: board left-panel.kicad_pcb from above]

Board: 2 copper layers, 17.8 x 57.2 mm, 6 parts (0 on the bottom side), 4 nets.
