bfrigon/alarm-clock-hardware/pcb/old-eagle-files/motherboard/controller.brd

## EAGLE design pcb/old-eagle-files/motherboard/controller.brd (2015-03-19, an earlier design)

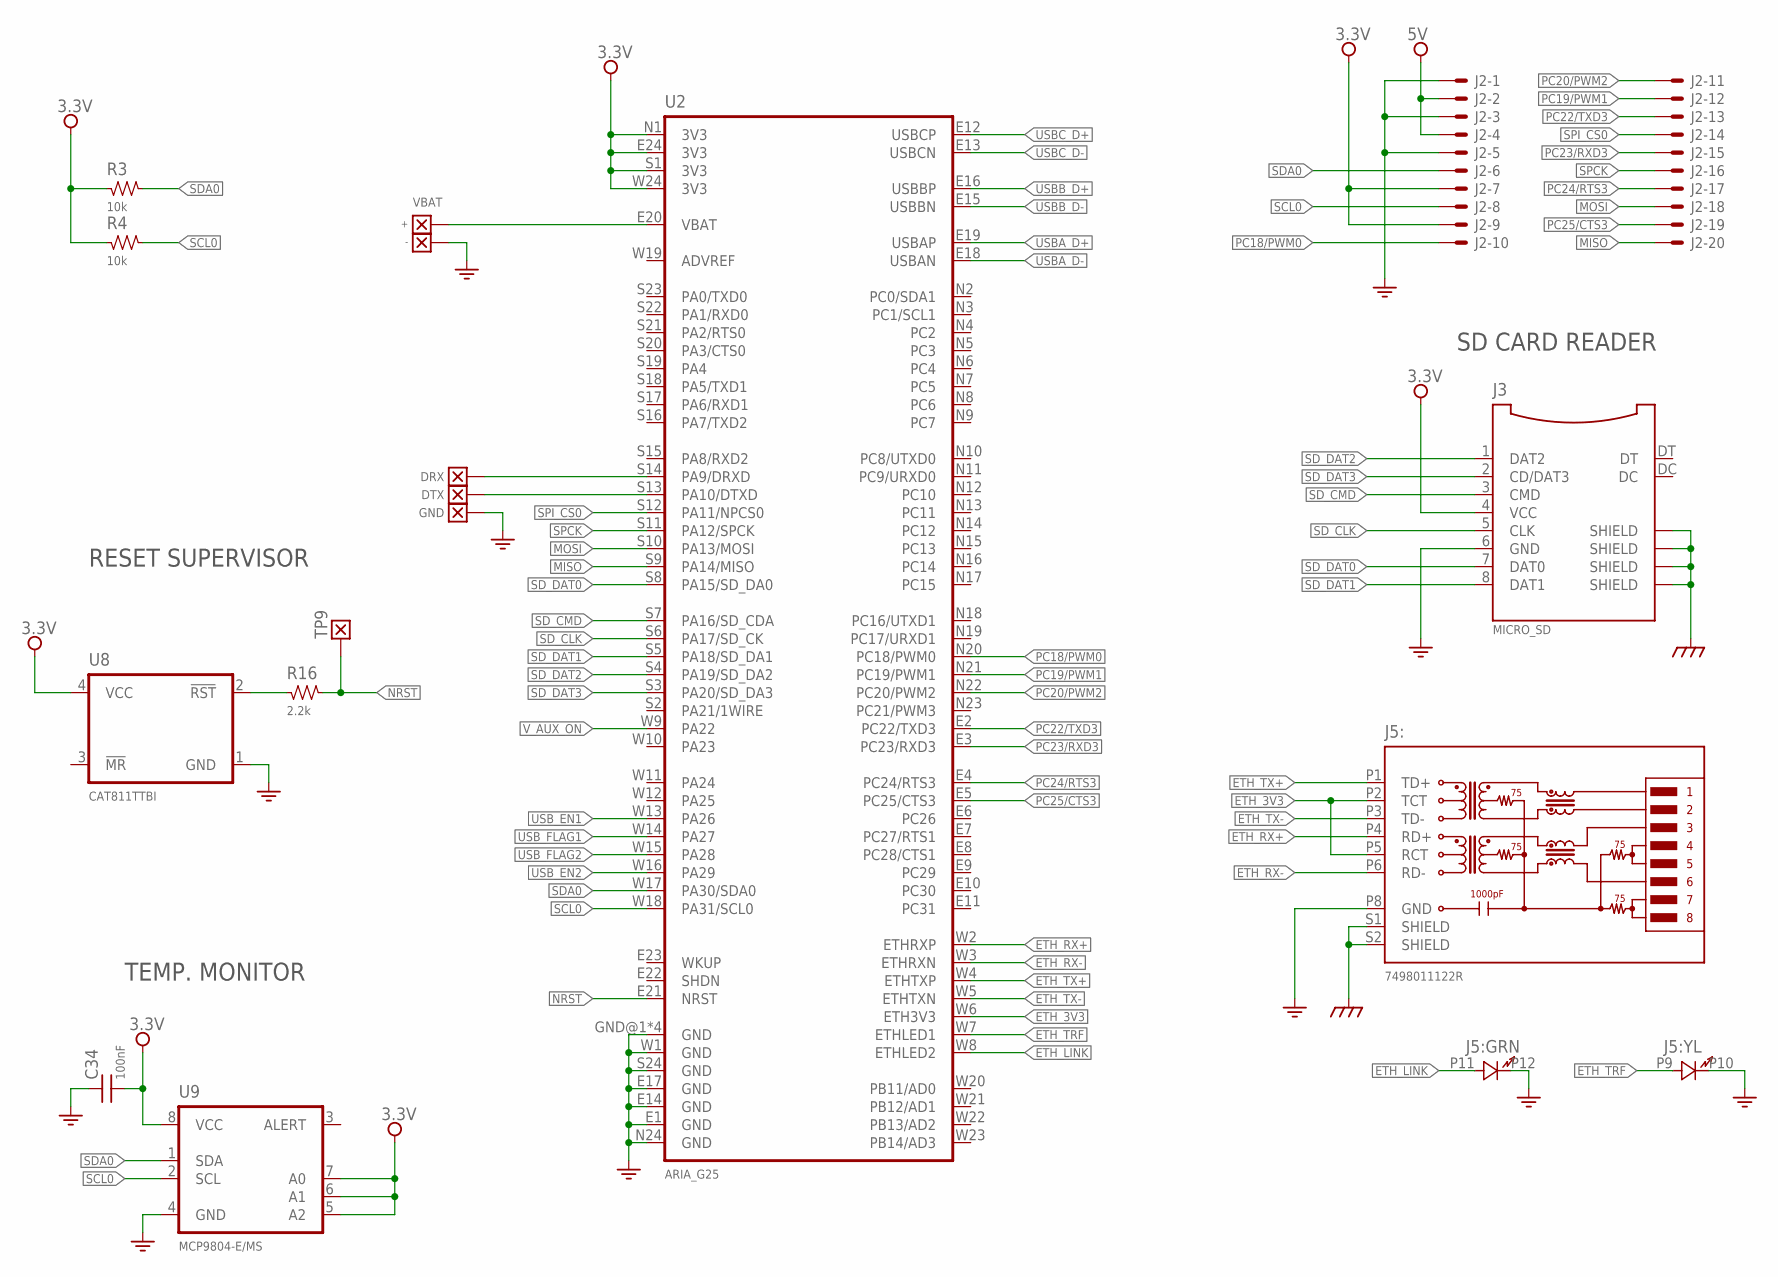
[picture p74: schematic controller.sch, sheet 1, CPU]

Parts:
C34: 100nF; SMD_0603
J2: DL-1.25MM-HEADER-20; DF13A-20DP-1.25
J3: MICRO_SD; 5027020891
J5: 7498011122R
R3, R4: 10k; SMD_0603
R16: 2.2k; SMD_0603
TP1: +; WIRE_SMT_150X75
TP2: -; WIRE_SMT_150X75
TP9: TEST_POINT-050; TP_050
U2: ARIA_G25
U8: CAT811TTBI; SOT143
U9: MCP9804-E/MS; MSOP8
W2: DRX; WIRE_SMT_150X75
W3: DTX; WIRE_SMT_150X75
W4: GND; WIRE_SMT_150X75

Connections:
3.3V: C34.2, J2.7, J2.9, J3.4 (VCC), R3.1, R4.1, U2.E24 (3V3), U2.N1 (3V3), U2.S1 (3V3), U2.W24 (3V3), U8.4 (VCC), U9.5 (A2), U9.6 (A1), U9.7 (A0), U9.8 (VCC); also elsewhere on the board
5V: J2.2, J2.4; also elsewhere on the board
DRX: U2.S14 (PA9/DRXD), W2.1
DTX: U2.S13 (PA10/DTXD), W3.1
EARTH: J3.SHDL@3 (SHIELD), J3.SHLD@1 (SHIELD), J3.SHLD@2 (SHIELD), J3.SHLD@4 (SHIELD), J5.S1 (SHIELD), J5.S2 (SHIELD); also elsewhere on the board
ETH_3V3: J5.P2 (TCT), J5.P5 (RCT), U2.W6 (ETH3V3)
ETH_LINK: J5.P11 (A), U2.W8 (ETHLED2)
ETH_RX+: J5.P4 (RD+), U2.W2 (ETHRXP)
ETH_RX-: J5.P6 (RD-), U2.W3 (ETHRXN)
ETH_TRF: J5.P9 (A), U2.W7 (ETHLED1)
ETH_TX+: J5.P1 (TD+), U2.W4 (ETHTXP)
ETH_TX-: J5.P3 (TD-), U2.W5 (ETHTXN)
GND: C34.1, J2.1, J2.3, J2.5, J3.6 (GND), J5.P8 (GND), J5.P10 (K), J5.P12 (K), TP2.1, U2.E1 (GND), U2.E14 (GND), U2.E17 (GND), U2.GND@1 (GND), U2.GND@2 (GND), U2.GND@3 (GND), U2.GND@4 (GND), U2.N24 (GND), U2.S24 (GND), U2.W1 (GND), U8.1 (GND), U9.4 (GND), W4.1; also elsewhere on the board
MISO: J2.20, U2.S9 (PA14/MISO)
MOSI: J2.18, U2.S10 (PA13/MOSI)
unnamed: TP1.1, U2.E20 (VBAT)
unnamed: R16.1, U8.2 (!RST)
NRST: R16.2, TP9.1, U2.E21 (NRST)
PC18/PWM0: J2.10, U2.N20 (PC18/PWM0)
PC19/PWM1: J2.12, U2.N21 (PC19/PWM1)
PC20/PWM2: J2.11, U2.N22 (PC20/PWM2)
PC22/TXD3: J2.13, U2.E2 (PC22/TXD3)
PC23/RXD3: J2.15, U2.E3 (PC23/RXD3)
PC24/RTS3: J2.17, U2.E4 (PC24/RTS3)
PC25/CTS3: J2.19, U2.E5 (PC25/CTS3)
SCL0: J2.8, R4.2, U2.W18 (PA31/SCL0), U9.2 (SCL); also elsewhere on the board
SDA0: J2.6, R3.2, U2.W17 (PA30/SDA0), U9.1 (SDA); also elsewhere on the board
SD_CLK: J3.5 (CLK), U2.S6 (PA17/SD_CK)
SD_CMD: J3.3 (CMD), U2.S7 (PA16/SD_CDA)
SD_DAT0: J3.7 (DAT0), U2.S8 (PA15/SD_DA0)
SD_DAT1: J3.8 (DAT1), U2.S5 (PA18/SD_DA1)
SD_DAT2: J3.1 (DAT2), U2.S4 (PA19/SD_DA2)
SD_DAT3: J3.2 (CD/DAT3), U2.S3 (PA20/SD_DA3)
SPCK: J2.16, U2.S11 (PA12/SPCK)
SPI_CS0: J2.14, U2.S12 (PA11/NPCS0)
USBA_D+: U2.E19 (USBAP); also elsewhere on the board
USBA_D-: U2.E18 (USBAN); also elsewhere on the board
USBB_D+: U2.E16 (USBBP); also elsewhere on the board
USBB_D-: U2.E15 (USBBN); also elsewhere on the board
USBC_D+: U2.E12 (USBCP); also elsewhere on the board
USBC_D-: U2.E13 (USBCN); also elsewhere on the board
USB_EN1: U2.W13 (PA26); also elsewhere on the board
USB_EN2: U2.W16 (PA29); also elsewhere on the board
USB_FLAG1: U2.W14 (PA27); also elsewhere on the board
USB_FLAG2: U2.W15 (PA28); also elsewhere on the board
V_AUX_ON: U2.W9 (PA22); also elsewhere on the board

Notes on the sheet:
VBAT
RESET SUPERVISOR
TEMP. MONITOR
SD CARD READER

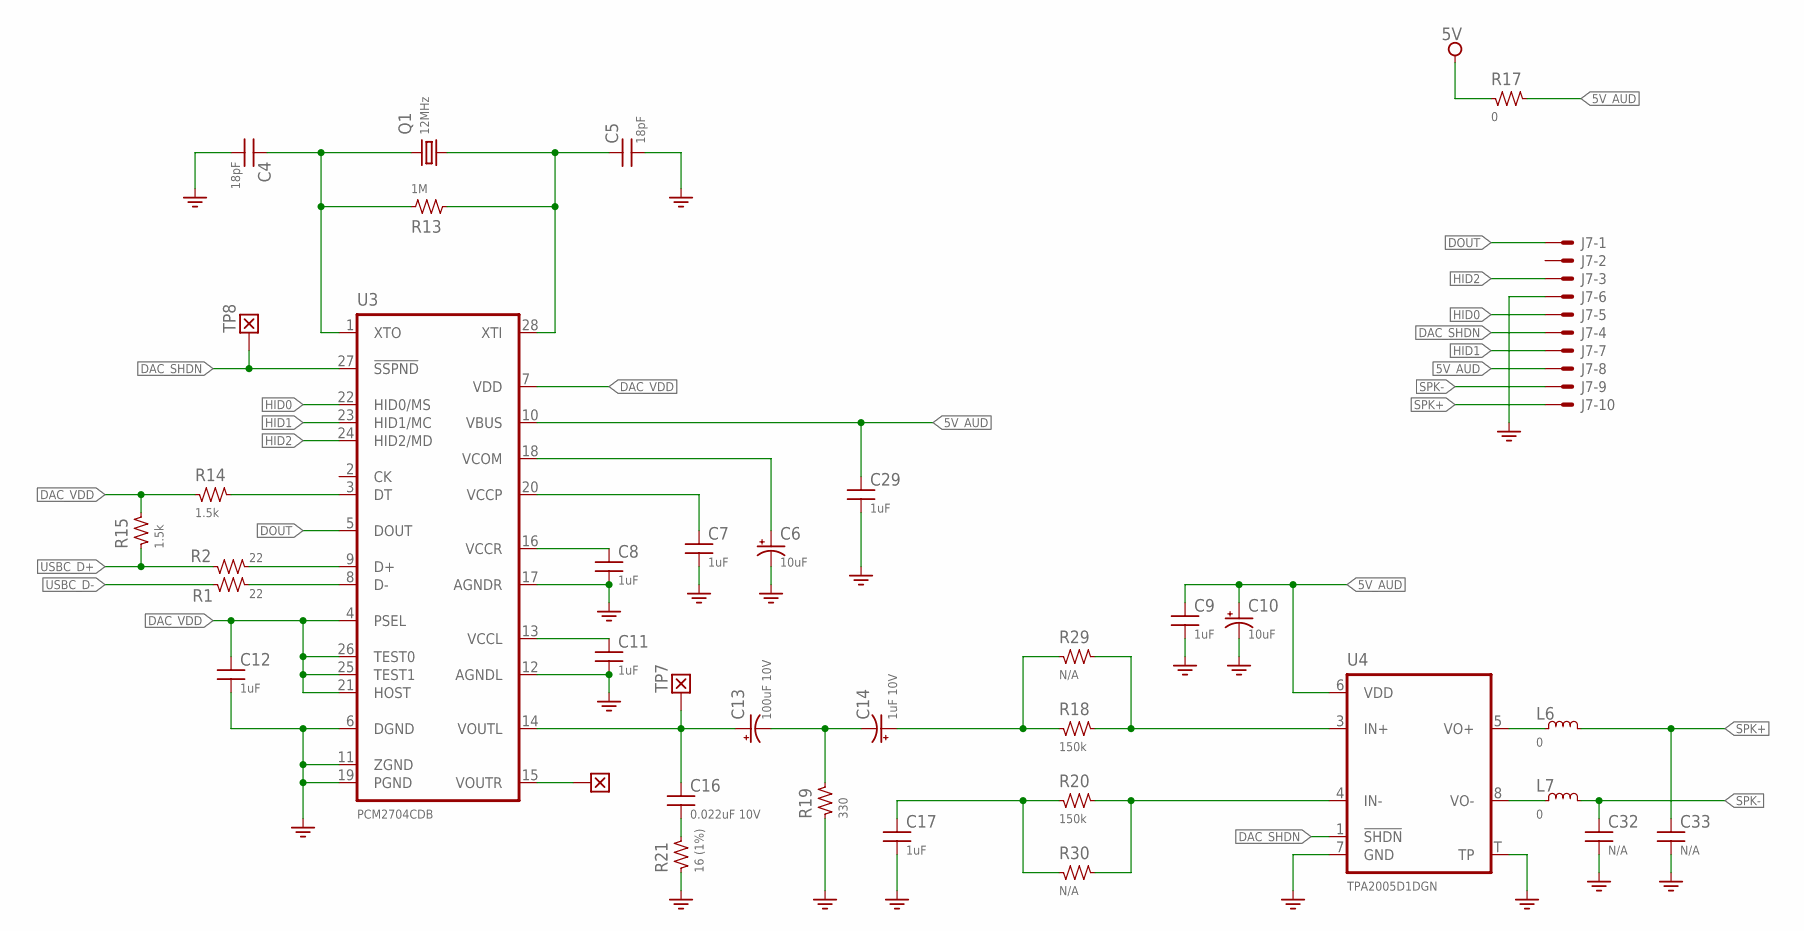
[picture p75: schematic controller.sch, sheet 2, Audio]

Parts:
C4, C5: 18pF; SMD_0603
C6, C10: 10uF; CAP_S0805
C7, C8, C9, C11, C12, C17, C29: 1uF; SMD_0603
C13: 100uF 10V; CAP_S1210
C14: 1uF 10V; CAP_S0805
C16: 0.022uF 10V; SMD_0603
C32, C33: N/A; SMD_0603
J7: DL-1.25MM-HEADER-10; DF13A-10DP-1.25
L6, L7: 0; SMD_0603
Q1: 12MHz; HC49UP
R1, R2: 22; SMD_0603
R13: 1M; SMD_0603
R14, R15: 1.5k; SMD_0603
R17: 0; SMD_1206
R18, R20: 150k; SMD_0603
R19: 330; SMD_0603
R21: 16 (1%); SMD_0603
R29, R30: N/A; SMD_0603
TP7, TP8: TEST_POINT-050; TP_050
U3: PCM2704CDB; SSOP28
U4: TPA2005D1DGN; PPSOP8
W1: WIRE-150X75; WIRE_SMT_150X75

Connections:
5V: R17.1; also elsewhere on the board
5V_AUD: C9.1, C10.+, C29.1, J7.8, R17.2, U3.10 (VBUS), U4.6 (VDD)
DAC_SHDN: J7.4, TP8.1, U3.27 (!SSPND), U4.1 (!SHDN)
DAC_VDD: C12.1, R14.1, R15.2, U3.4 (PSEL), U3.7 (VDD), U3.21 (HOST), U3.25 (TEST1), U3.26 (TEST0)
DOUT: J7.1, U3.5 (DOUT)
GND: C4.2, C5.2, C6.-, C7.2, C8.2, C9.2, C10.-, C11.2, C12.2, C17.2, C29.2, C32.2, C33.2, J7.6, R19.1, R21.1, U3.6 (DGND), U3.11 (ZGND), U3.12 (AGNDL), U3.17 (AGNDR), U3.19 (PGND), U4.7 (GND), U4.T (TP); also elsewhere on the board
HID0: J7.5, U3.22 (HID0/MS)
HID1: J7.7, U3.23 (HID1/MC)
HID2: J7.3, U3.24 (HID2/MD)
unnamed: R2.2, U3.9 (D+)
unnamed: R1.2, U3.8 (D-)
unnamed: C11.1, U3.13 (VCCL)
unnamed: C6.+, U3.18 (VCOM)
unnamed: C7.1, U3.20 (VCCP)
unnamed: C8.1, U3.16 (VCCR)
unnamed: C14.+, R18.1, R29.1
unnamed: R14.2, U3.3 (DT)
unnamed: U3.15 (VOUTR), W1.1
unnamed: L6.1, U4.5 (VO+)
unnamed: L7.1, U4.8 (VO-)
unnamed: R18.2, R29.2, U4.3 (IN+)
unnamed: R20.2, R30.2, U4.4 (IN-)
unnamed: C17.1, R20.1, R30.1
unnamed: C13.-, C14.-, R19.2
unnamed: C16.2, R21.2
SPK+: C33.1, J7.10, L6.2
SPK-: C32.1, J7.9, L7.2
USBC_D+: R2.1, R15.1; also elsewhere on the board
USBC_D-: R1.1; also elsewhere on the board
VOUTL: C13.+, C16.1, TP7.1, U3.14 (VOUTL)
XTI: C5.1, Q1.2, R13.2, U3.28 (XTI)
XTO: C4.1, Q1.1, R13.1, U3.1 (XTO)

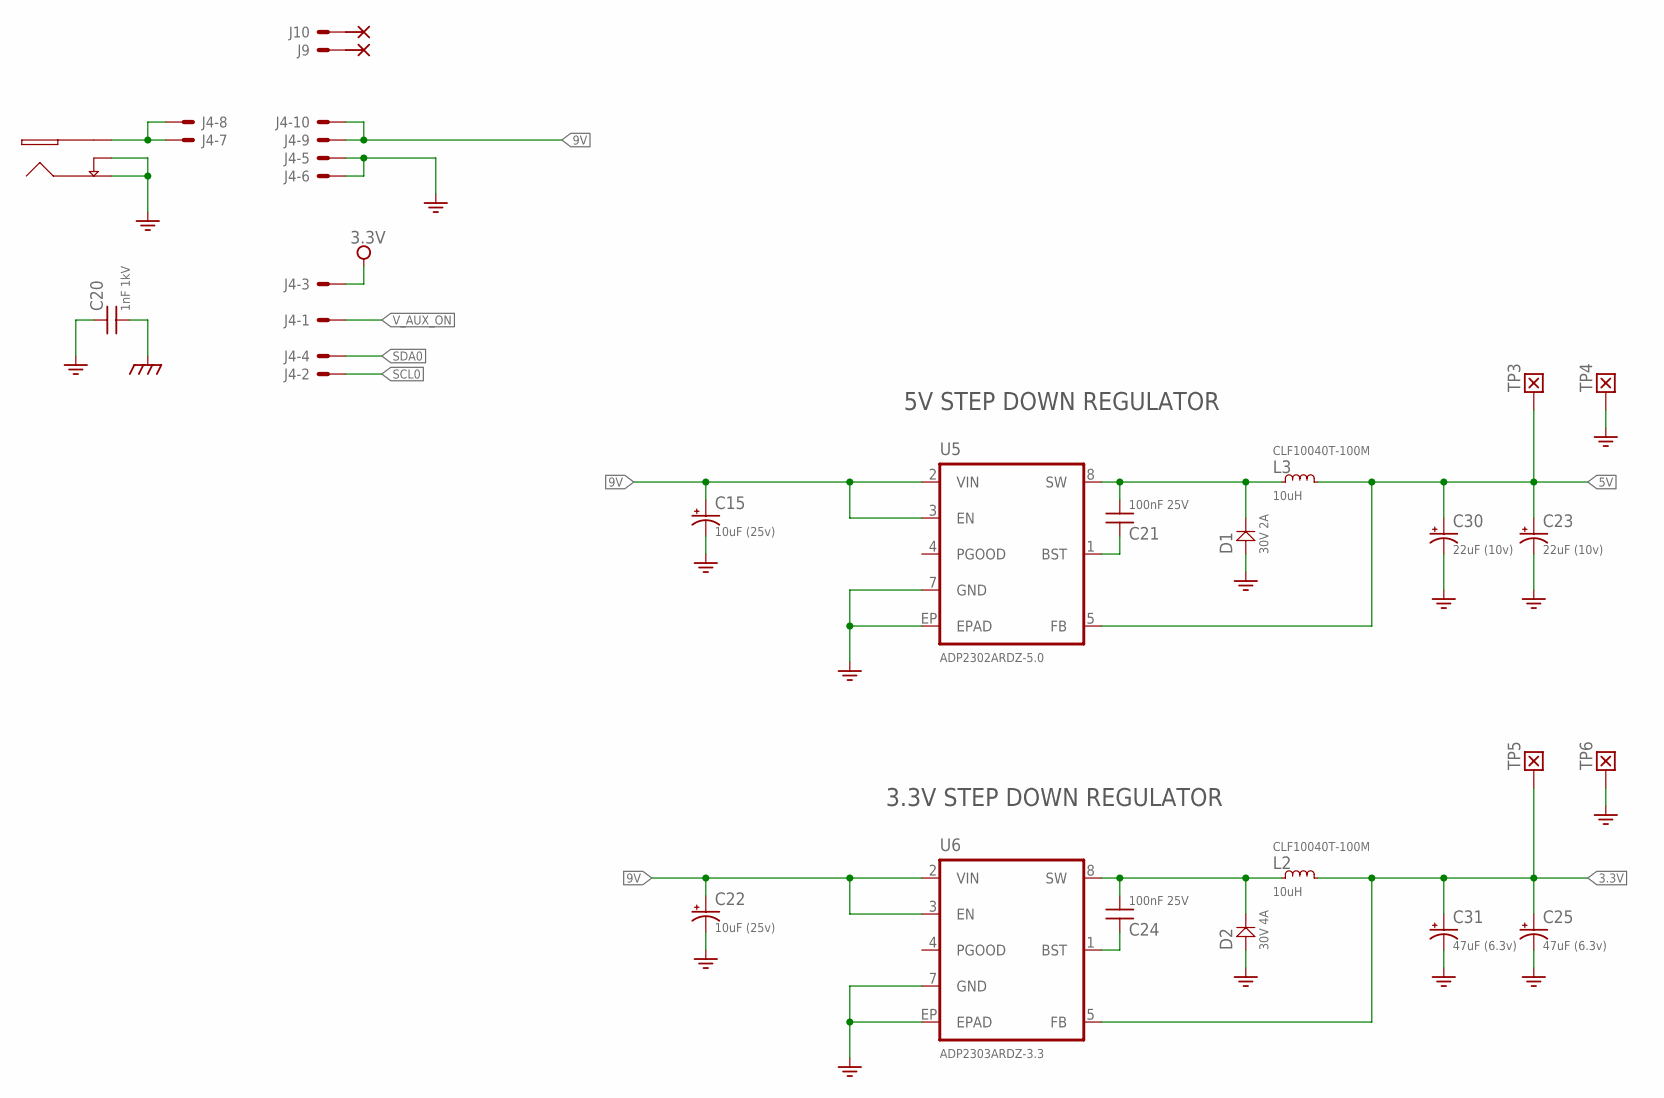
[picture p76: schematic controller.sch, sheet 3, Power supply]

Parts:
C15, C22: 10uF (25v); CAP_S1210; PART_NO TPSB106K025R1800
C20: 1nF 1kV; SMD_0805
C21, C24: 100nF 25V; SMD_0603
C23, C30: 22uF (10v); CAP_S1206; PART_NO TPSA226M010R0900
C25, C31: 47uF (6.3v); CAP_S1206; PART_NO TPSA476K006R0800
D1: 30V 2A; DIODE_DO214-AA
D2: 30V 4A; DIODE_DO214-AA
J4: DL-100-HEADER-10-V; 534206-5
J8: CUI-PJ-013C
J9, J10: SNG-100-HEADER-01-HDR-V; HDR_M_1
L2, L3: 10uH; IND-10X10; PART_NO CLF10040T-100M
TP3, TP4, TP5, TP6: TEST_POINT-050; TP_050
U5: ADP2302ARDZ-5.0; SOIC8-EP
U6: ADP2303ARDZ-3.3; SOIC8-EP

Connections:
3.3V: C25.+, C31.+, J4.3, L2.2, TP5.1, U6.5 (FB); also elsewhere on the board
5V: C23.+, C30.+, L3.2, TP3.1, U5.5 (FB); also elsewhere on the board
9V: C15.+, C22.+, J4.9, J4.10, U5.2 (VIN), U5.3 (EN), U6.2 (VIN), U6.3 (EN)
BST_3.3V: C24.1, U6.1 (BST)
BST_5V: C21.1, U5.1 (BST)
EARTH: C20.2; also elsewhere on the board
GND: C15.-, C20.1, C22.-, C23.-, C25.-, C30.-, C31.-, D1.A, D2.A, J4.5, J4.6, J8.2 (GND), J8.3 (SW), TP4.1, TP6.1, U5.7 (GND), U5.EP (EPAD), U6.7 (GND), U6.EP (EPAD); also elsewhere on the board
unnamed: J4.7, J4.8, J8.1 (V+)
SCL0: J4.2; also elsewhere on the board
SDA0: J4.4; also elsewhere on the board
SW_3.3: C24.2, D2.K, L2.1, U6.8 (SW)
SW_5V: C21.2, D1.K, L3.1, U5.8 (SW)
V_AUX_ON: J4.1; also elsewhere on the board

Notes on the sheet:
5V STEP DOWN REGULATOR
3.3V STEP DOWN REGULATOR

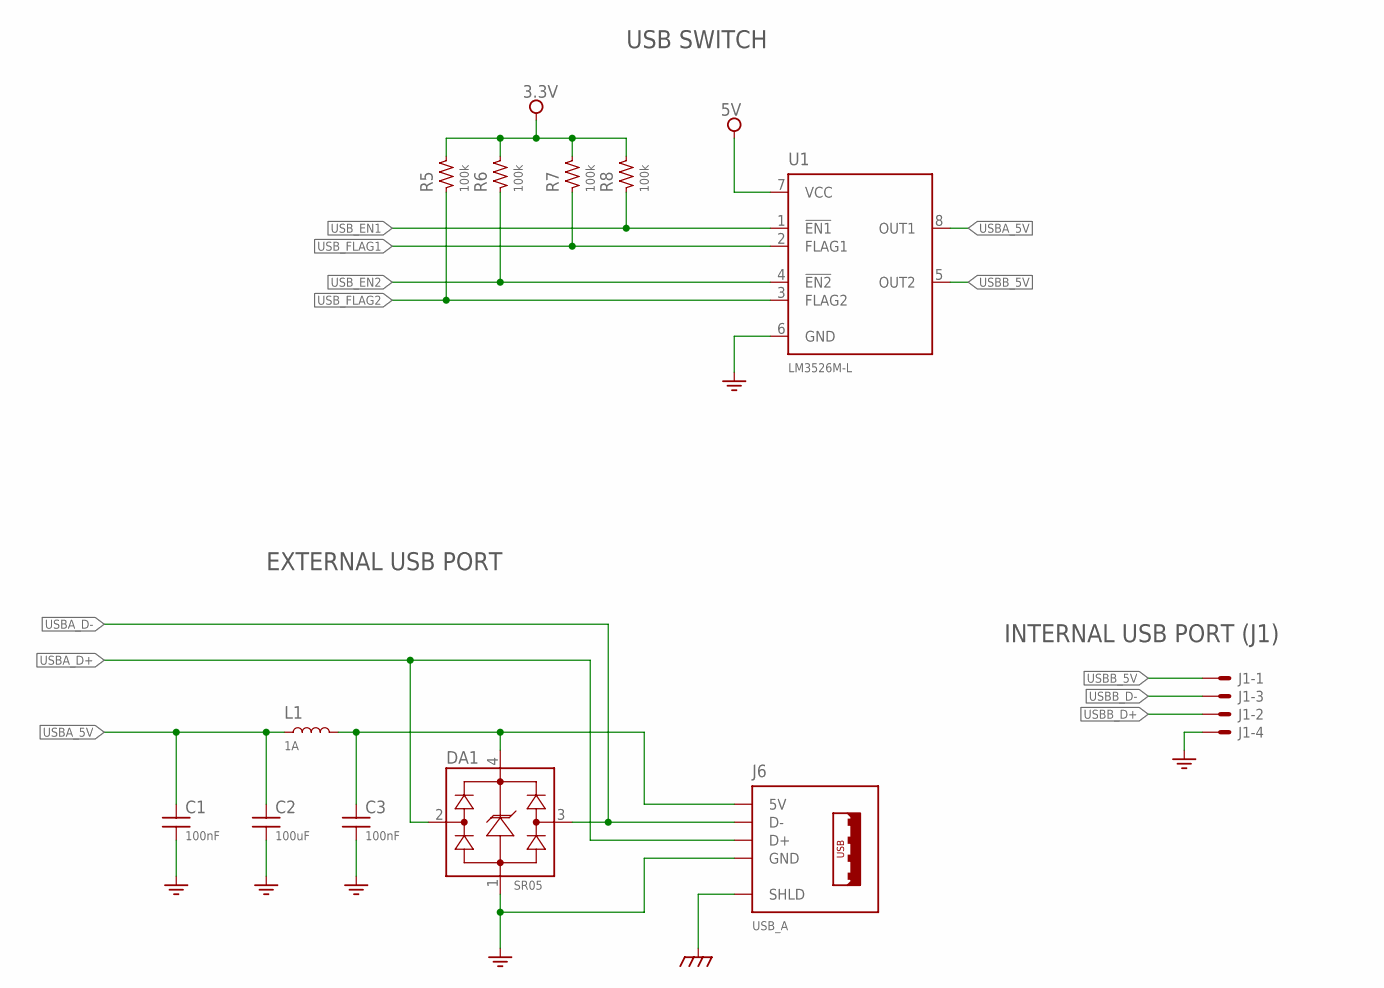
[picture p77: schematic controller.sch, sheet 4, USB]

Parts:
C1, C3: 100nF; SMD_0603
C2: 100uF; SMD_0805
DA1: SR05; SOT143
J1: SNG-2MM-HEADER-04-V; DF3X-4P-2DSA
J6: USB_A; 292303-1
L1: 1A; SMD_0805
R5, R6, R7, R8: 100k; SMD_0603
U1: LM3526M-L; SOIC8

Connections:
3.3V: R5.2, R6.2, R7.2, R8.2; also elsewhere on the board
5V: U1.7 (VCC); also elsewhere on the board
EARTH: J6.SHLD@1 (SHLD), J6.SHLD@2 (SHLD); also elsewhere on the board
GND: C1.2, C2.2, C3.2, DA1.1, J1.4, J6.4 (GND), U1.6 (GND); also elsewhere on the board
unnamed: C3.1, DA1.4, J6.1 (5V), L1.2
USBA_5V: C1.1, C2.1, L1.1, U1.8 (OUT1)
USBA_D+: DA1.2, J6.3 (D+); also elsewhere on the board
USBA_D-: DA1.3, J6.2 (D-); also elsewhere on the board
USBB_5V: J1.1, U1.5 (OUT2)
USBB_D+: J1.2; also elsewhere on the board
USBB_D-: J1.3; also elsewhere on the board
USB_EN1: R8.1, U1.1 (!EN1); also elsewhere on the board
USB_EN2: R6.1, U1.4 (!EN2); also elsewhere on the board
USB_FLAG1: R7.1, U1.2 (FLAG1); also elsewhere on the board
USB_FLAG2: R5.1, U1.3 (FLAG2); also elsewhere on the board

Notes on the sheet:
USB SWITCH
EXTERNAL USB PORT
INTERNAL USB PORT (J1)

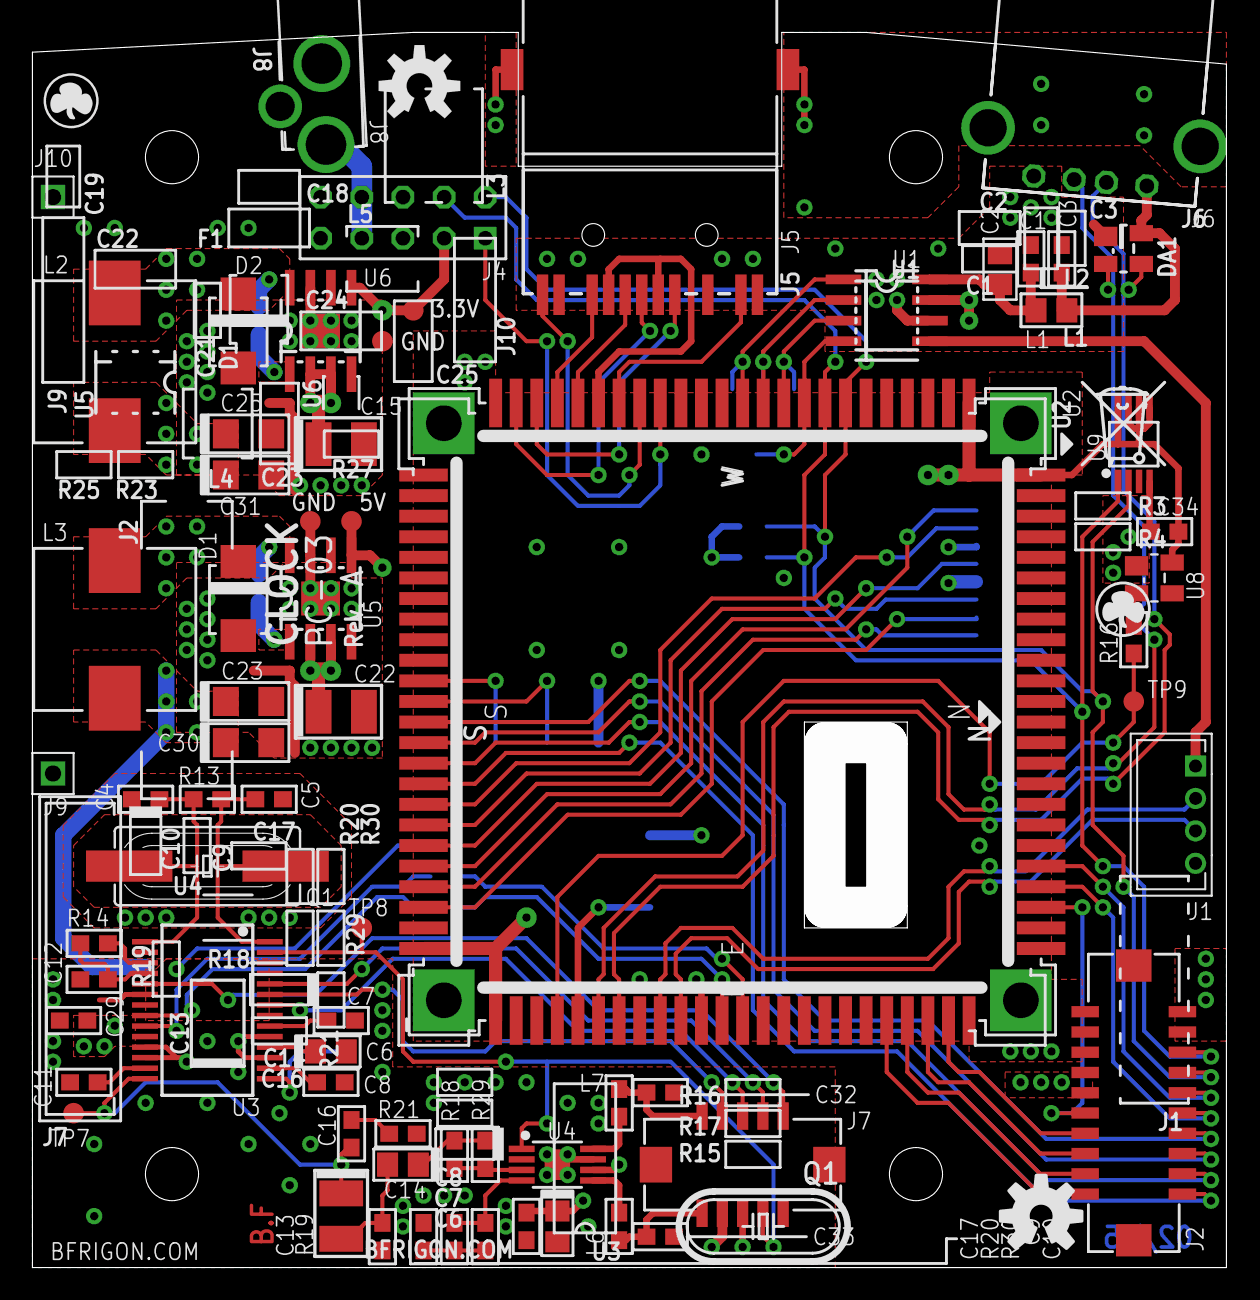
[picture p78: board controller.brd from above]

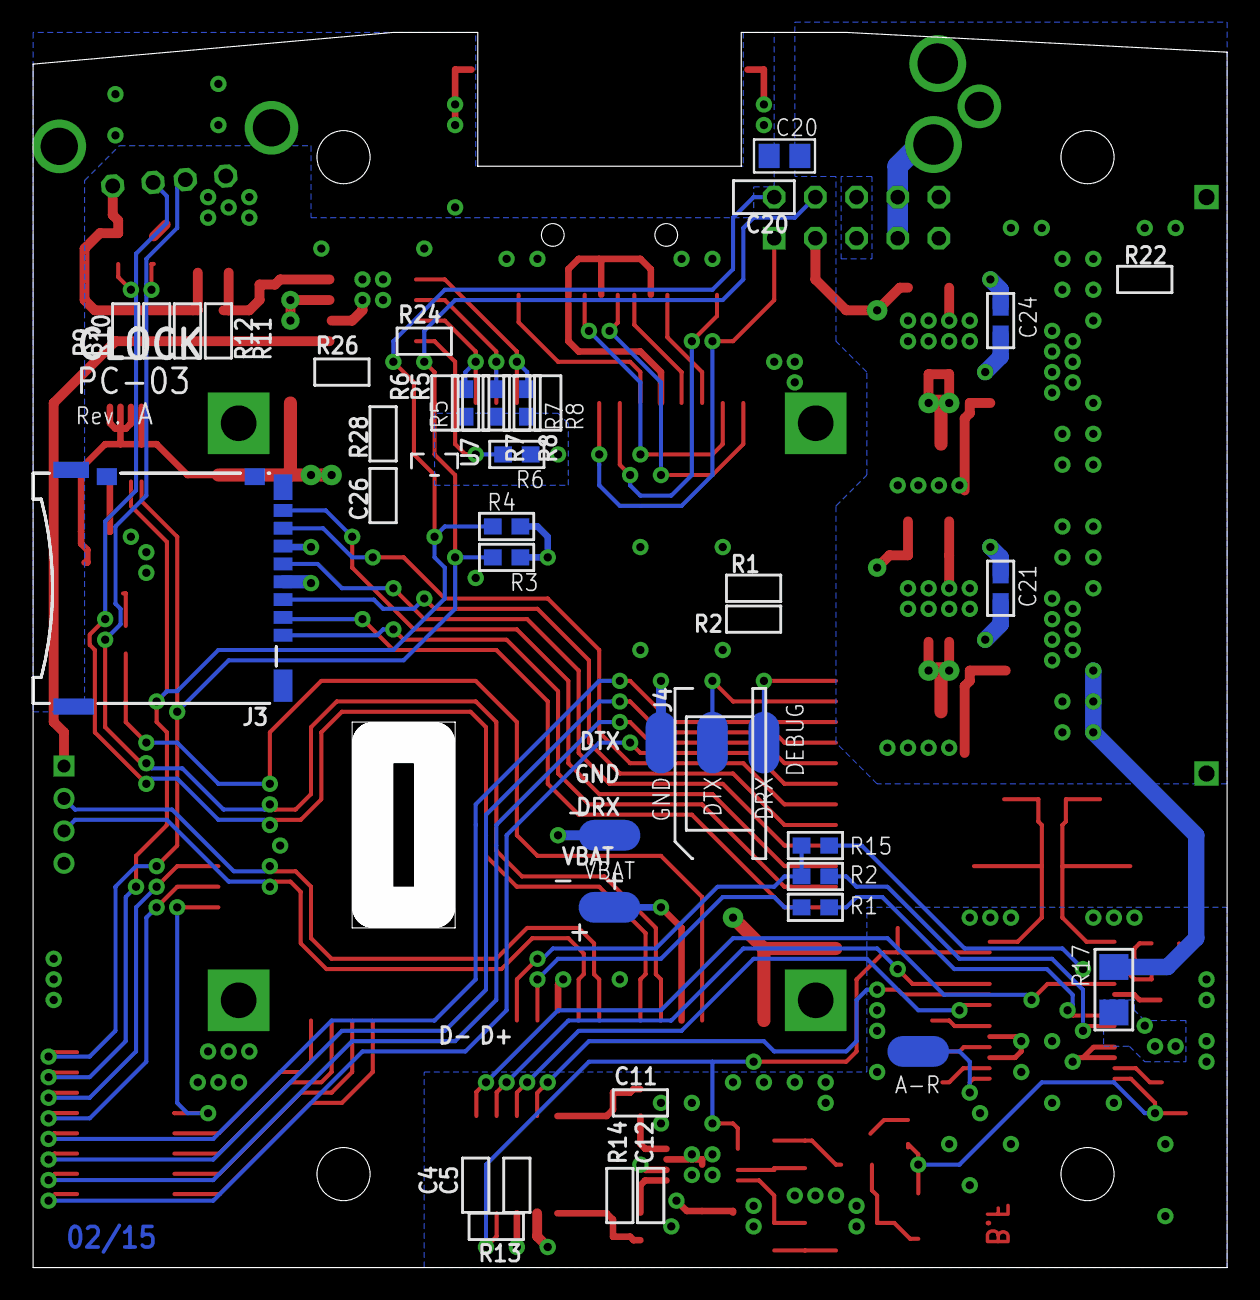
[picture p79: board controller.brd from below]

Board: 4 copper layers, 73.7 x 76.2 mm, 93 parts (22 on the bottom side), 83 nets.

Other parts of the board:
U$1: OPENHW_LOGO_200
U$2: INFO_DATE
U$3: INFO_COMPACT
U$4: LOGO2
U$6: INFO_AUTHOR
