bfrigon/alarm-clock-hardware/pcb/left-panel/left.brd

## EAGLE design pcb/old-eagle-files/left-panel/left.brd (2015-02-12, an earlier design)

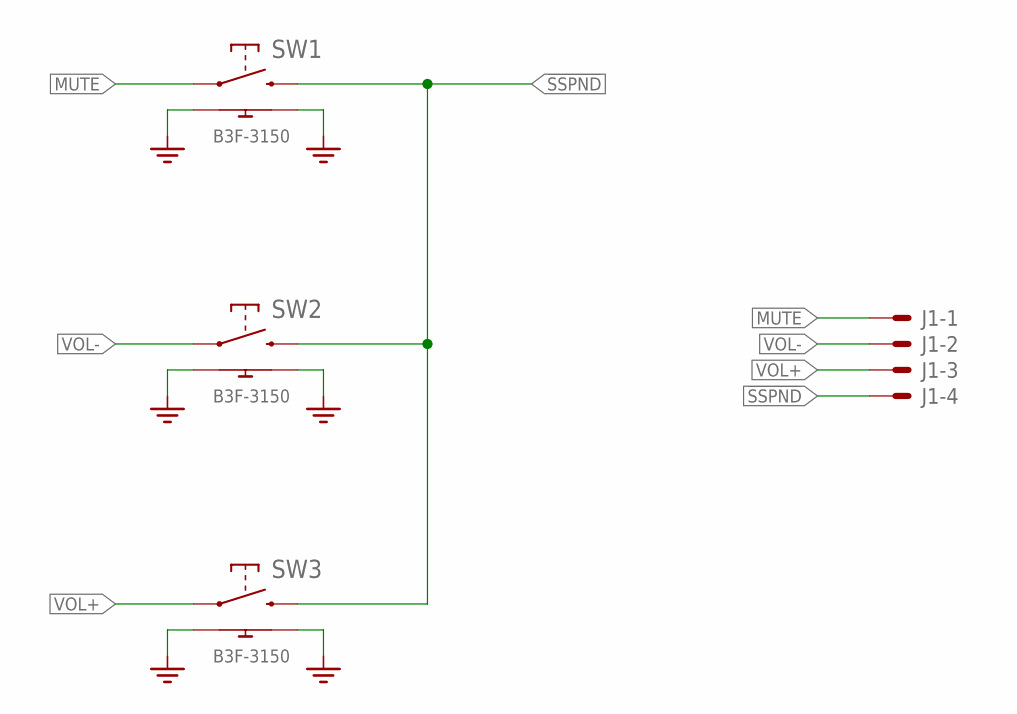
[picture p80: schematic left.sch]

Parts:
J1: SNG-2MM-HEADER-04-V; DF3X-4P-2DSA
SW1, SW2, SW3: B3F-3150; B3F-315X

Connections:
!SSPND: J1.4, SW1.2, SW2.2, SW3.2
GND: SW1.3, SW1.4, SW2.3, SW2.4, SW3.3, SW3.4
MUTE: J1.1, SW1.1
VOL+: J1.3, SW3.1
VOL-: J1.2, SW2.1

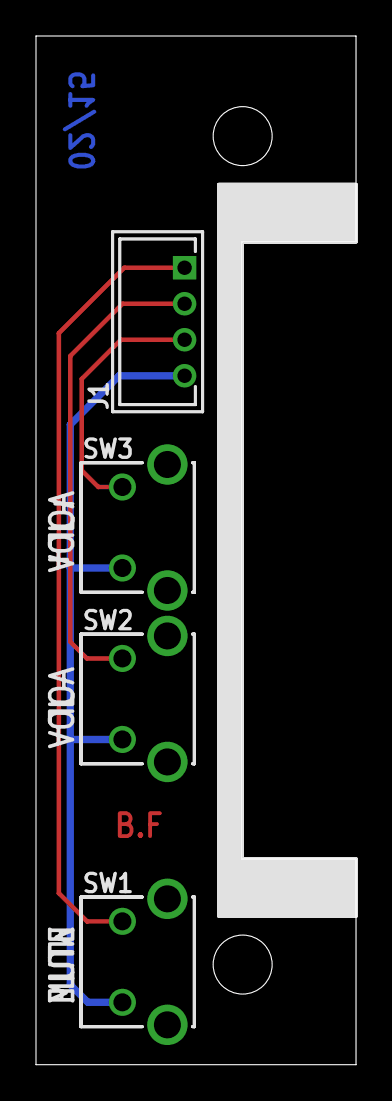
[picture p81: board left.brd from above]

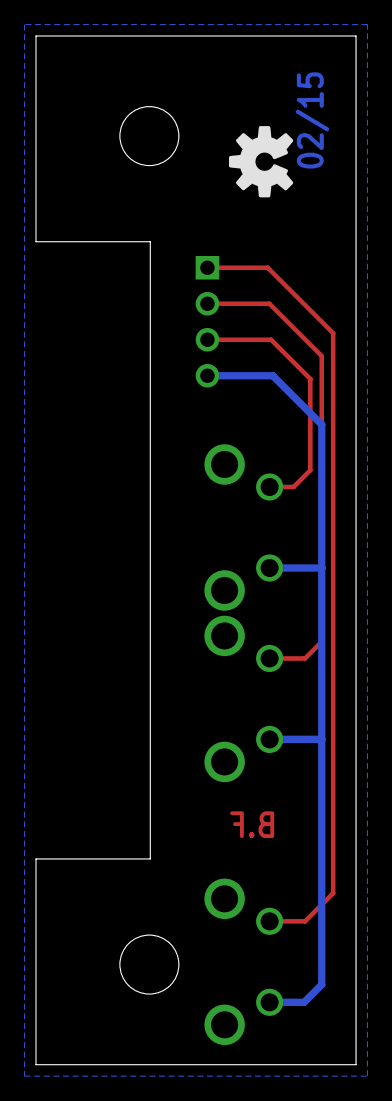
[picture p82: board left.brd from below]

Board: 2 copper layers, 17.8 x 57.1 mm, 7 parts (2 on the bottom side), 5 nets.

Other parts of the board:
U$1: INFO_AUTHOR
U$2: INFO_DATE
U$3: OPENHW_LOGO_150
