bfrigon/alarm-clock-hardware/pcb/display-model-b/digit/digit.brd

## EAGLE design pcb/display-model-b/digit/digit.brd (2015-01-04)

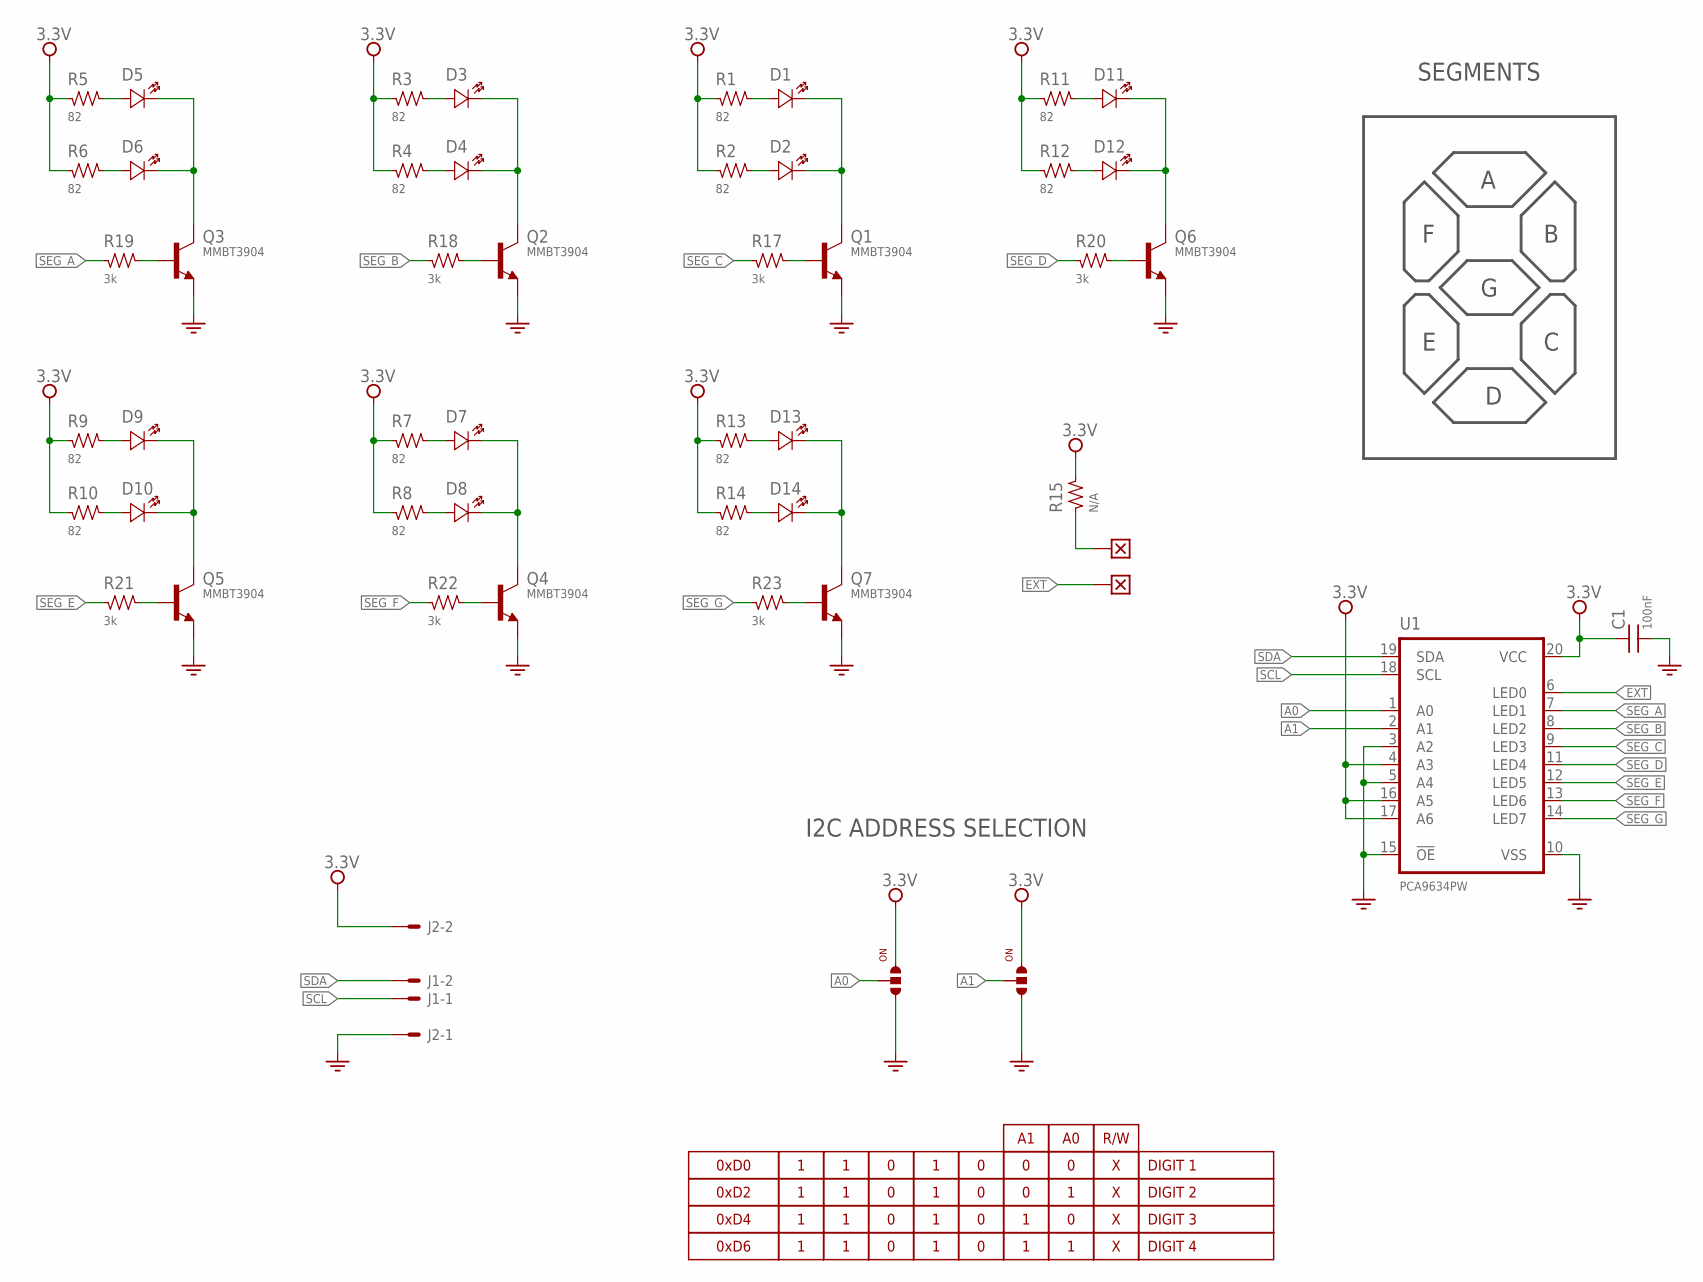
[picture p83: schematic digit.sch]

Parts:
C1: 100nF; SMD_0603
D1, D2, D3, D4, D7, D8, D9, D10, D11, D12, D13, D14: Orange; CHIPLED_0805; PART_NO APT2012SECK/J4-PRV
D5: Red; CHIPLED_0805; PART_NO APT2012SECK/J4-PRV
D6: orange; CHIPLED_0805; PART_NO APT2012SECK/J4-PRV
J1, J2: DL-100-HEADER-02-EDGE; HDR100-EDGE-2; PART_NO 3-644456-2
J10, J11: SOLDER_JUMPER_3
Q1, Q2, Q3, Q4, Q5, Q6, Q7: MMBT3904; SOT23
R1, R2, R3, R4, R5, R6, R7, R8, R9, R10, R11, R12, R13, R14: 82; SMD_0603
R15: N/A; SMD_0603
R17, R18, R19, R20, R21, R22, R23: 3k; SMD_0603
U1: PCA9634PW; TSSOP20
W5, W6: WIRE; WIRE_SMT

Connections:
3.3V: C1.1, J2.2, J10.1, J11.1, R1.1, R2.1, R3.1, R4.1, R5.1, R6.1, R7.1, R8.1, R9.1, R10.1, R11.1, R12.1, R13.1, R14.1, R15.2, U1.4 (A3), U1.16 (A5), U1.17 (A6), U1.20 (VCC)
A0: J10.2, U1.1 (A0)
A1: J11.2, U1.2 (A1)
EXT: U1.6 (LED0), W5.1
GND: C1.2, J2.1, J10.3, J11.3, Q1.2 (E), Q2.2 (E), Q3.2 (E), Q4.2 (E), Q5.2 (E), Q6.2 (E), Q7.2 (E), U1.3 (A2), U1.5 (A4), U1.10 (VSS), U1.15 (!OE)
unnamed: Q1.1 (B), R17.2
unnamed: D7.K, D8.K, Q4.3 (C)
unnamed: D13.K, D14.K, Q7.3 (C)
unnamed: D1.K, D2.K, Q1.3 (C)
unnamed: D3.K, D4.K, Q2.3 (C)
unnamed: D5.K, D6.K, Q3.3 (C)
unnamed: D3.A, R3.2
unnamed: D4.A, R4.2
unnamed: D14.A, R14.2
unnamed: D13.A, R13.2
unnamed: D2.A, R2.2
unnamed: D1.A, R1.2
unnamed: D5.A, R5.2
unnamed: D6.A, R6.2
unnamed: D11.A, R11.2
unnamed: D9.K, D10.K, Q5.3 (C)
unnamed: D11.K, D12.K, Q6.3 (C)
unnamed: D12.A, R12.2
unnamed: D10.A, R10.2
unnamed: D9.A, R9.2
unnamed: D7.A, R7.2
unnamed: D8.A, R8.2
unnamed: Q2.1 (B), R18.2
unnamed: Q3.1 (B), R19.2
unnamed: Q6.1 (B), R20.2
unnamed: Q5.1 (B), R21.2
unnamed: Q4.1 (B), R22.2
unnamed: Q7.1 (B), R23.2
unnamed: R15.1, W6.1
SCL: J1.1, U1.18 (SCL)
SDA: J1.2, U1.19 (SDA)
SEG_A: R19.1, U1.7 (LED1)
SEG_B: R18.1, U1.8 (LED2)
SEG_C: R17.1, U1.9 (LED3)
SEG_D: R20.1, U1.11 (LED4)
SEG_E: R21.1, U1.12 (LED5)
SEG_F: R22.1, U1.13 (LED6)
SEG_G: R23.1, U1.14 (LED7)

Notes on the sheet:
I2C ADDRESS SELECTION
SEGMENTS

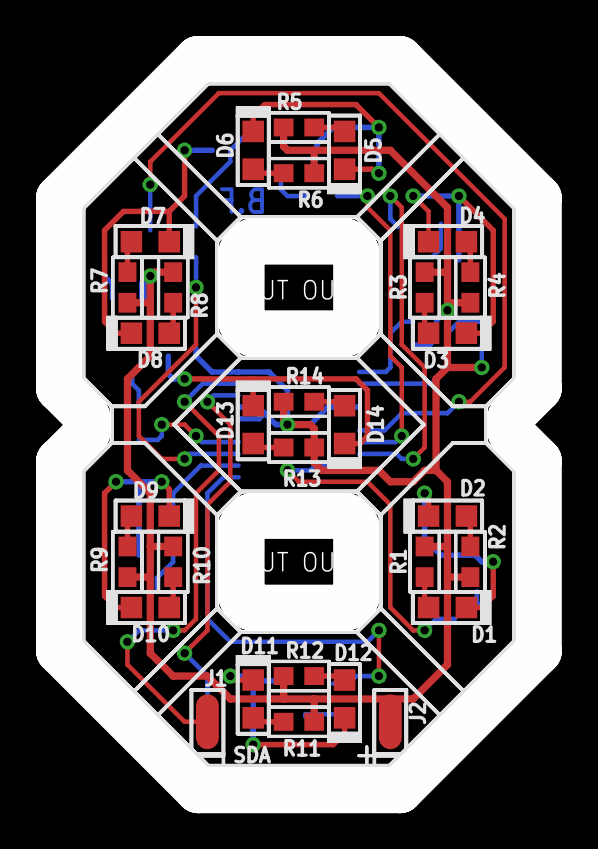
[picture p84: board digit.brd from above]

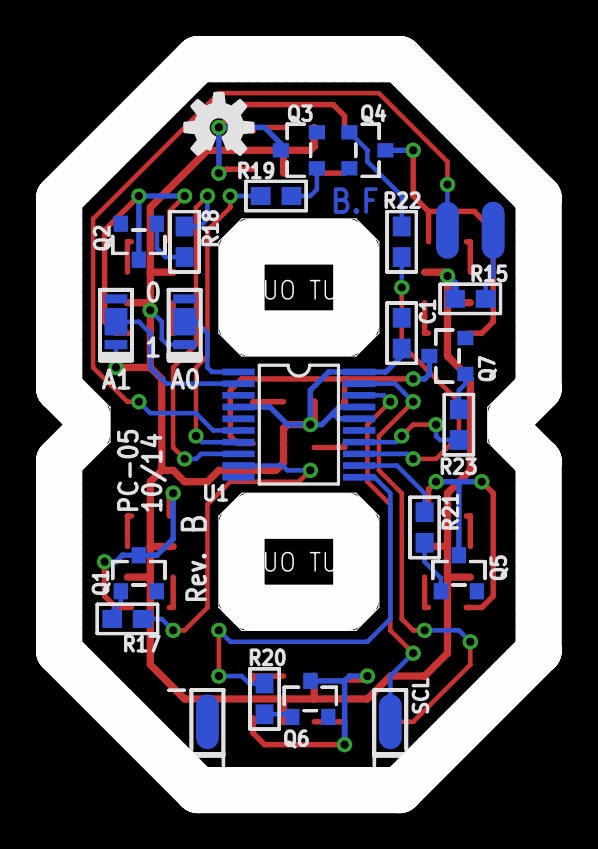
[picture p85: board digit.brd from below]

Board: 2 copper layers, 26.7 x 40.6 mm, 54 parts (24 on the bottom side), 43 nets.

Other parts of the board:
U$1: OPENHW_LOGO_150
U$2: INFO_AUTHOR
U$3: INFO_REV
