bfrigon/alarm-clock-hardware/pcb/touch/touch.brd

## EAGLE design pcb/touch/touch.brd (2015-01-04)

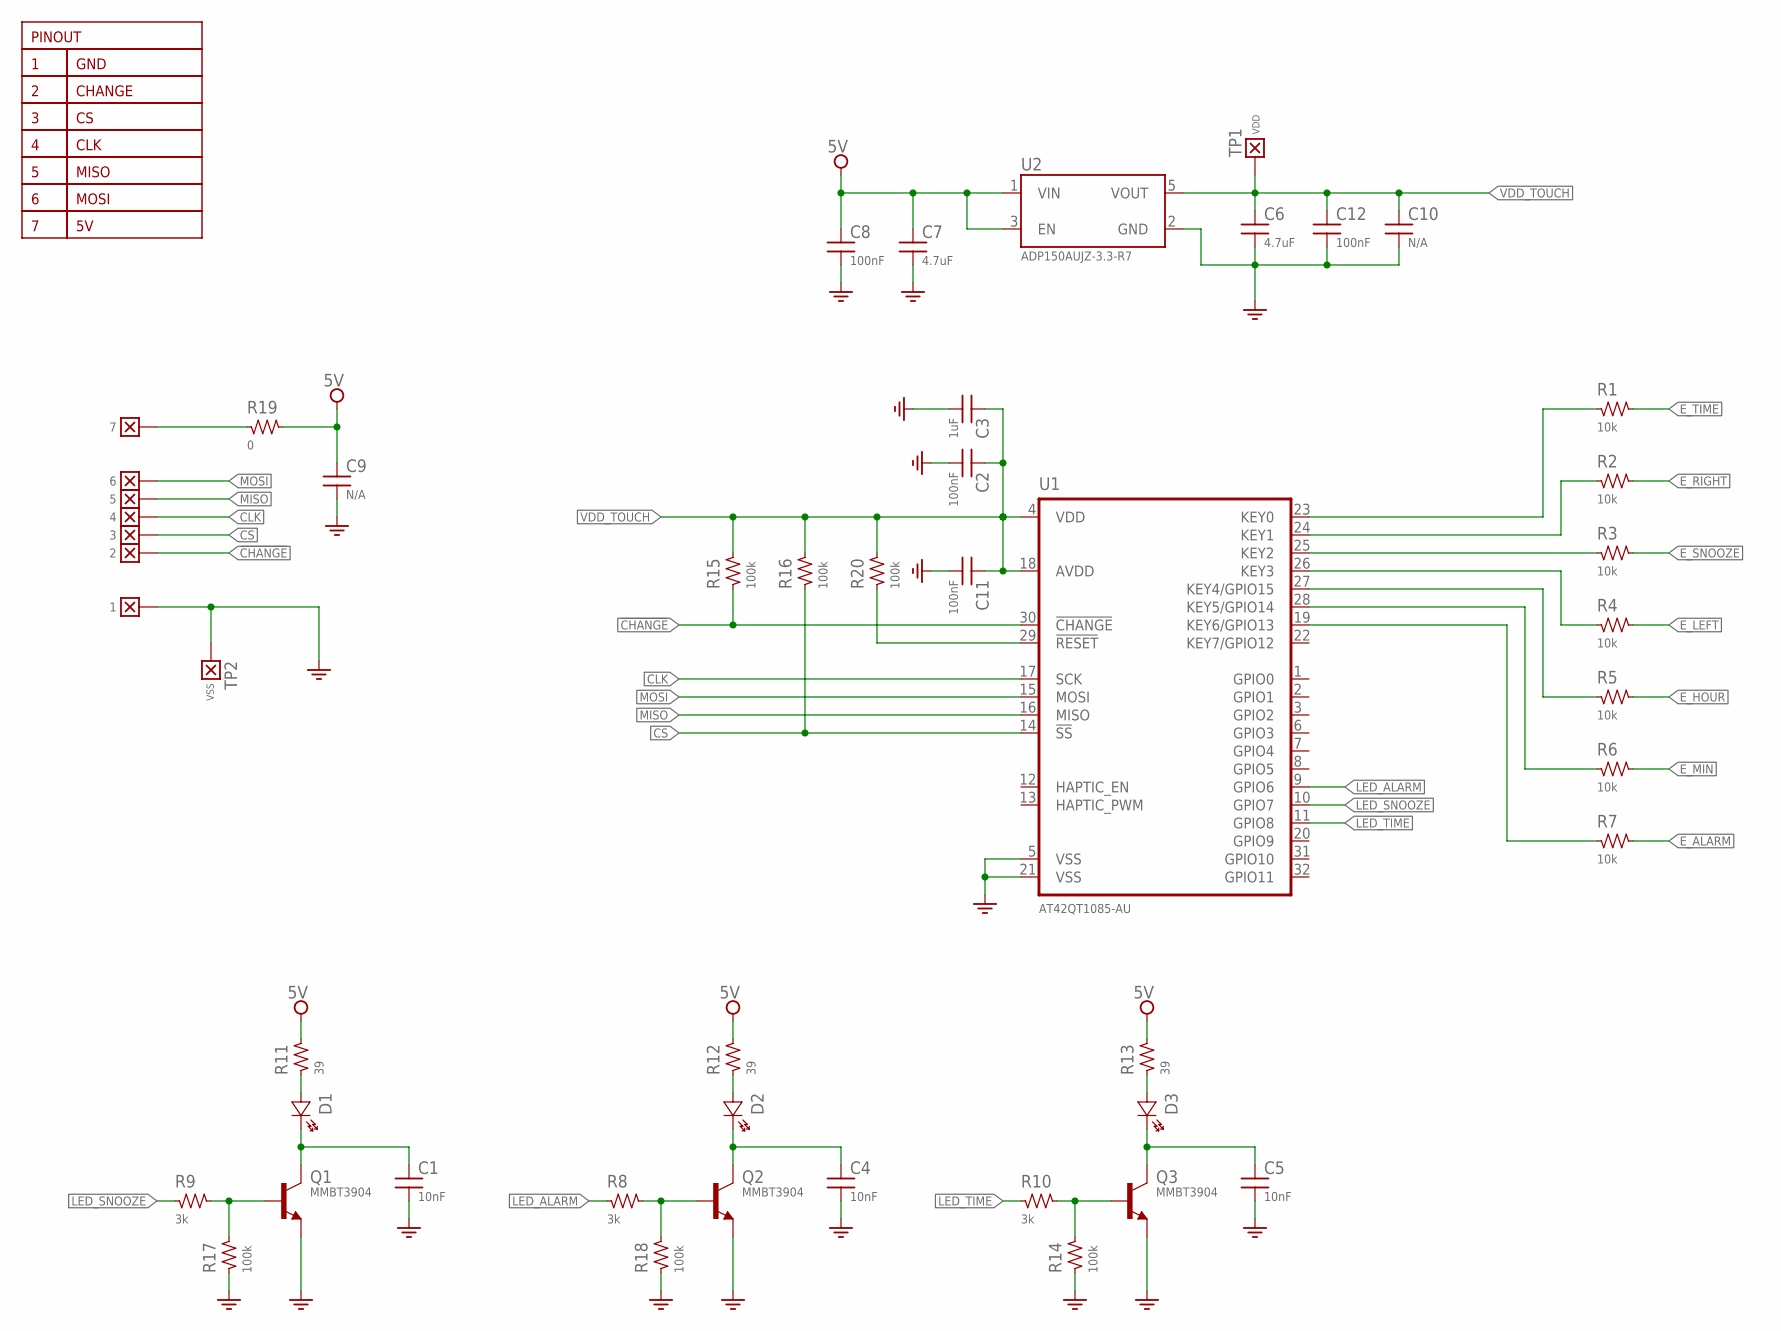
[picture p86: schematic touch.sch]

Parts:
5V: 7; WIRE_SMT_150X75
!CHANGE: 2; WIRE_SMT_125X50
C1, C4, C5: 10nF; SMD_0603
C2, C8, C11, C12: 100nF; SMD_0603
C3: 1uF; SMD_1206
C6, C7: 4.7uF; SMD_1206
C9, C10: N/A; SMD_1206
CLK: 4; WIRE_SMT_125X50
CS: 3; WIRE_SMT_125X50
D1, D2, D3: {ATTR:COLOR}; P47F
GND: 1; WIRE_SMT_150X75
MISO: 5; WIRE_SMT_125X50
MOSI: 6; WIRE_SMT_125X50
Q1, Q2, Q3: MMBT3904; SOT23
R1, R2, R3, R4, R5, R6, R7: 10k; SMD_0603
R8, R9, R10: 3k; SMD_0603
R11, R12, R13: 39; SMD_0603
R14, R15, R16, R17, R18, R20: 100k; SMD_0603
R19: 0; SMD_1206
TP1: VDD; TP_050
TP2: VSS; TP_050
U1: AT42QT1085-AU; TQFP-7X7-32
U2: ADP150AUJZ-3.3-R7; SOT23-5

Connections:
5V: C7.1, C8.1, C9.1, R11.2, R12.2, R13.2, R19.2, U2.1 (VIN), U2.3 (EN)
!CHANGE: !CHANGE.1, R15.1, U1.30 (!CHANGE)
CLK: CLK.1, U1.17 (SCK)
CS: CS.1, R16.1, U1.14 (!SS)
E_ALARM: R7.2
E_HOUR: R5.2
E_LEFT: R4.2
E_MIN: R6.2
E_RIGHT: R2.2
E_SNOOZE: R3.2
E_TIME: R1.2
GND: C1.2, C2.2, C3.2, C4.2, C5.2, C6.2, C7.2, C8.2, C9.2, C10.2, C11.2, C12.2, GND.1, Q1.2 (E), Q2.2 (E), Q3.2 (E), R14.1, R17.1, R18.1, TP2.1, U1.5 (VSS), U1.21 (VSS), U2.2 (GND)
LED_ALARM: R8.1, U1.9 (GPIO6)
LED_SNOOZE: R9.1, U1.10 (GPIO7)
LED_TIME: R10.1, U1.11 (GPIO8)
MISO: MISO.1, U1.16 (MISO)
MOSI: MOSI.1, U1.15 (MOSI)
unnamed: C1.1, D1.K, Q1.3 (C)
unnamed: C4.1, D2.K, Q2.3 (C)
unnamed: C5.1, D3.K, Q3.3 (C)
unnamed: D1.A, R11.1
unnamed: D2.A, R12.1
unnamed: D3.A, R13.1
unnamed: R1.1, U1.23 (KEY0)
unnamed: R2.1, U1.24 (KEY1)
unnamed: R3.1, U1.25 (KEY2)
unnamed: R4.1, U1.26 (KEY3)
unnamed: R5.1, U1.27 (KEY4/GPIO15)
unnamed: R6.1, U1.28 (KEY5/GPIO14)
unnamed: R7.1, U1.19 (KEY6/GPIO13)
unnamed: Q3.1 (B), R10.2, R14.2
unnamed: Q2.1 (B), R8.2, R18.2
unnamed: Q1.1 (B), R9.2, R17.2
unnamed: 5V.1, R19.1
unnamed: R20.1, U1.29 (!RESET)
VDD_TOUCH: C2.1, C3.1, C6.1, C10.1, C11.1, C12.1, R15.2, R16.2, R20.2, TP1.1, U1.4 (VDD), U1.18 (AVDD), U2.5 (VOUT)

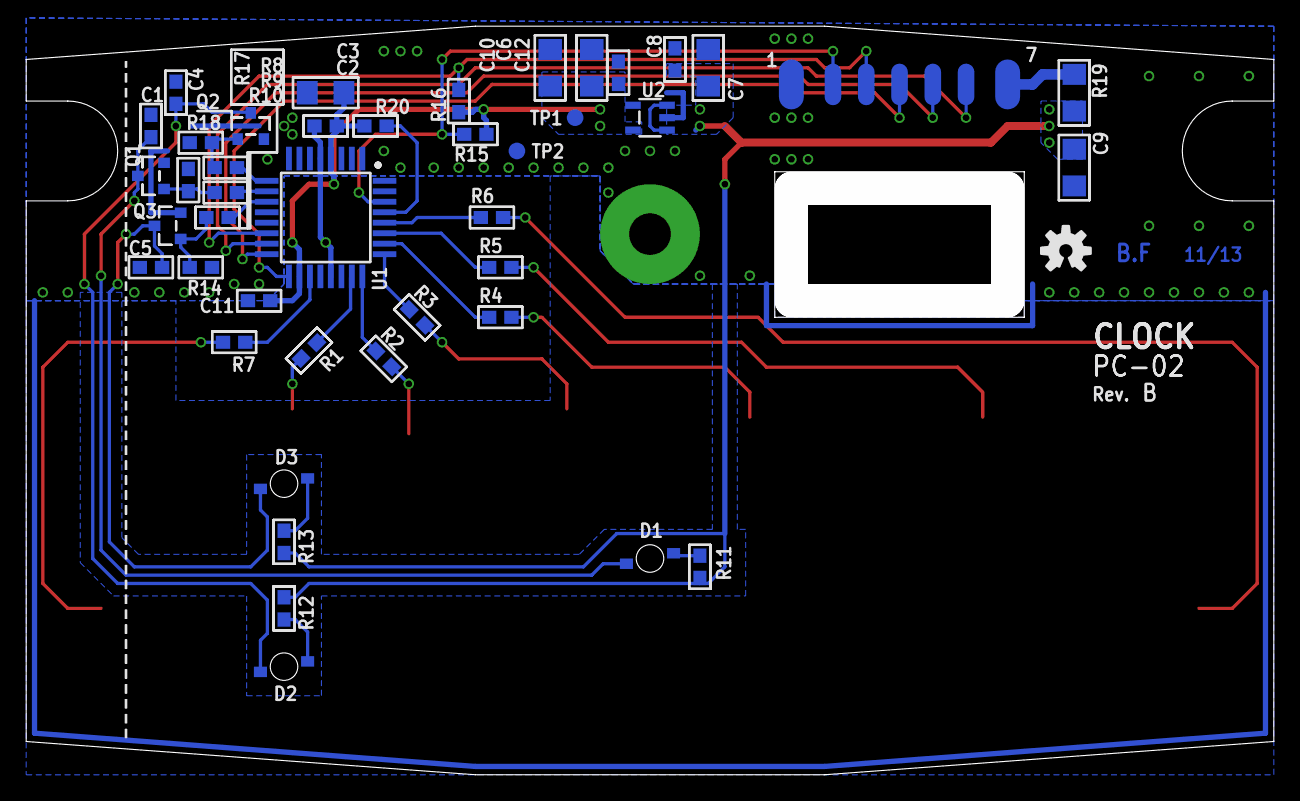
[picture p87: board pcb/touch/touch.brd from below]

Board: 2 copper layers, 95.2 x 57.1 mm, 51 parts (51 on the bottom side), 29 nets.

Other parts of the board:
U$3: INFO_COMPACT
U$5: OPENHW_LOGO_150
