bfrigon/alarm-clock-hardware/pcb/display-model-a/display.brd

## EAGLE design pcb/display-model-a/display.brd (2015-01-04)

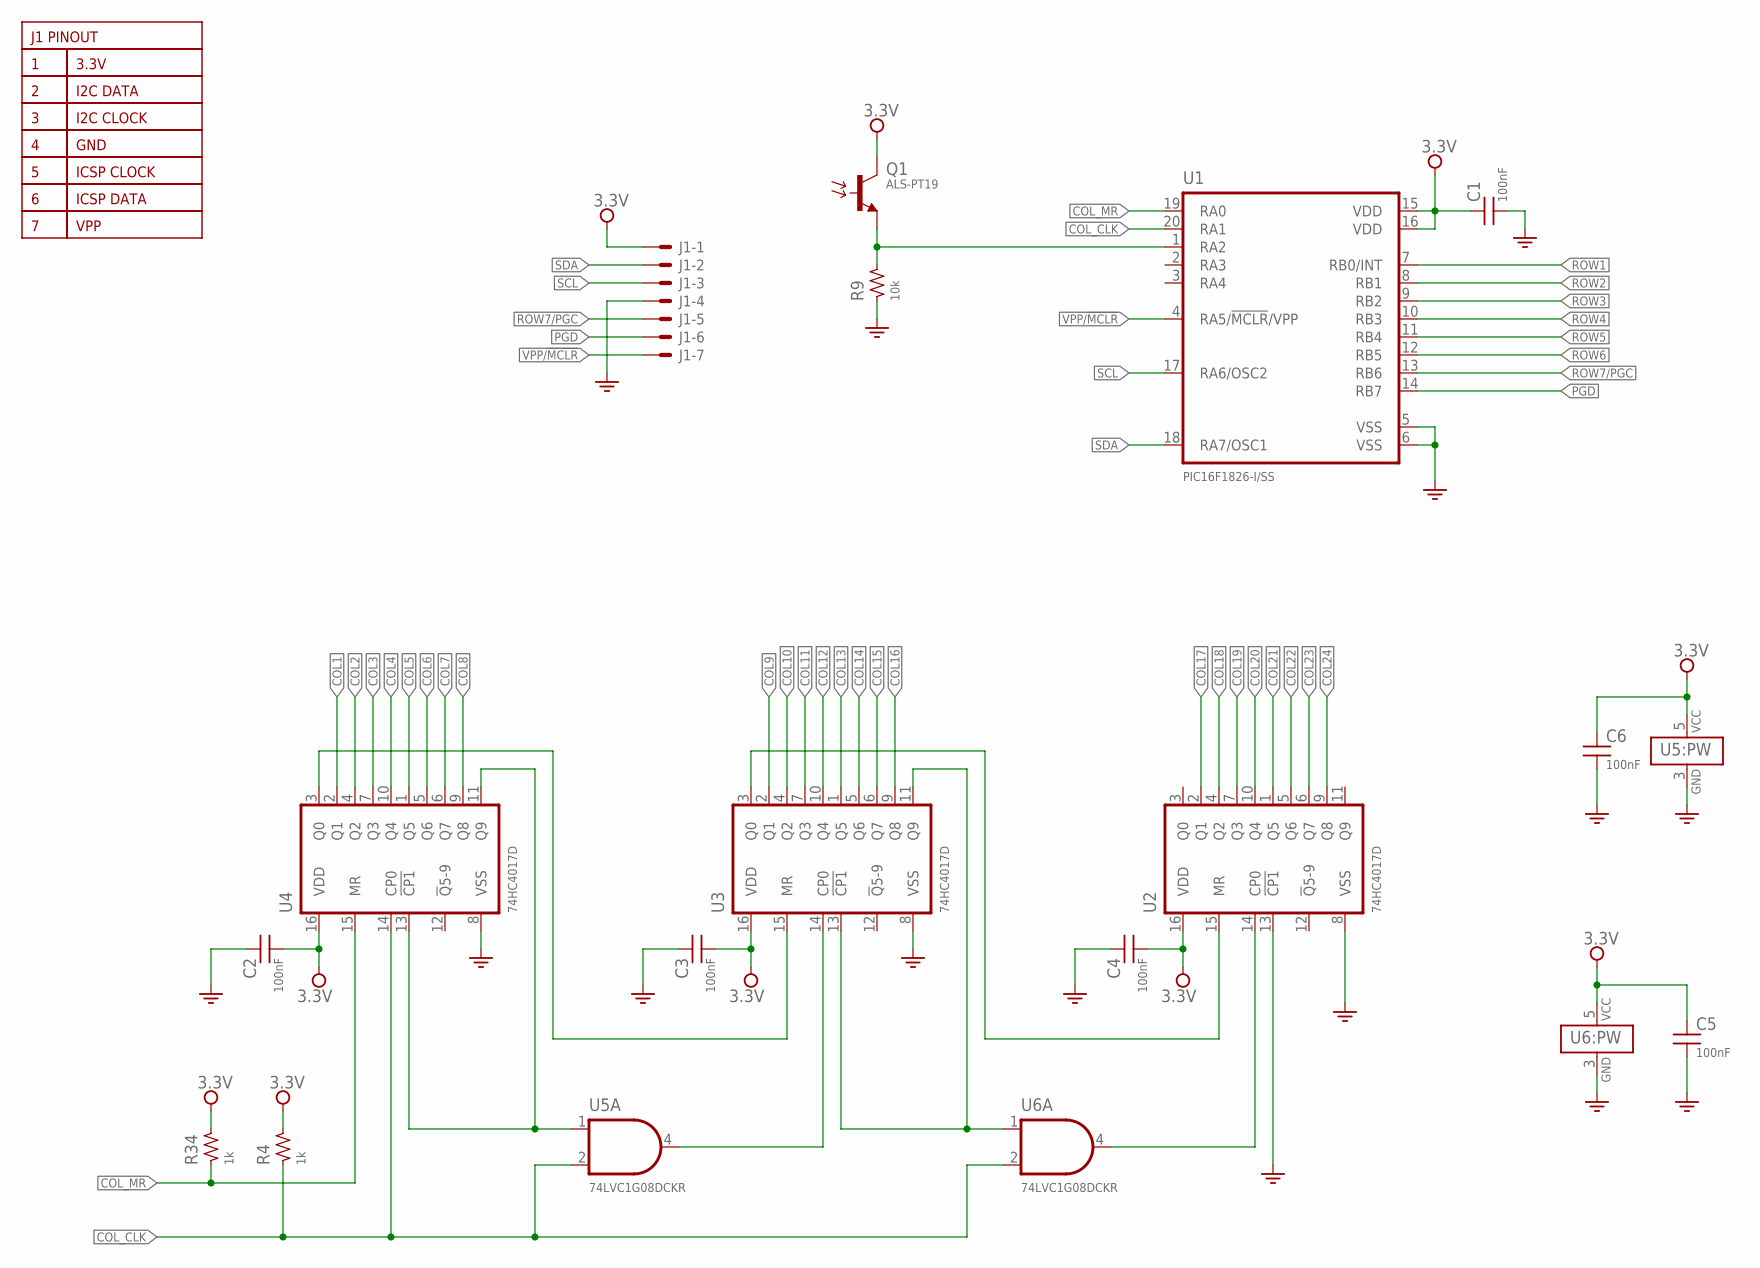
[picture p88: schematic display.sch, sheet 1]

Parts:
C1, C2, C3, C4, C5, C6: 100nF; SMD_0603
J1: SNG-2MM-HEADER-07-V; DF3X-7P-2DSA; PART_NO DF3A-7P-2DSA
Q1: ALS-PT19; PART_NO ALS-PT19-315C/L177/TR8
R4, R34: 1k; SMD_0603
R9: 10k; SMD_0603
U1: PIC16F1826-I/SS; SSOP20
U2, U3, U4: 74HC4017D; SOIC16N; PART_NO 74HC4017D,653
U5, U6: 74LVC1G08DCKR; SC70-5

Connections:
3.3V: C1.1, C2.2, C3.2, C4.2, C5.1, C6.1, J1.1, Q1.C, R4.2, R34.2, U1.15 (VDD), U1.16 (VDD), U2.16 (VDD), U3.16 (VDD), U4.16 (VDD), U5.5 (VCC), U6.5 (VCC)
COL1: U4.2 (Q1); also elsewhere on the board
COL2: U4.4 (Q2); also elsewhere on the board
COL3: U4.7 (Q3); also elsewhere on the board
COL4: U4.10 (Q4); also elsewhere on the board
COL5: U4.1 (Q5); also elsewhere on the board
COL6: U4.5 (Q6); also elsewhere on the board
COL7: U4.6 (Q7); also elsewhere on the board
COL8: U4.9 (Q8); also elsewhere on the board
COL9: U3.2 (Q1); also elsewhere on the board
COL10: U3.4 (Q2); also elsewhere on the board
COL11: U3.7 (Q3); also elsewhere on the board
COL12: U3.10 (Q4); also elsewhere on the board
COL13: U3.1 (Q5); also elsewhere on the board
COL14: U3.5 (Q6); also elsewhere on the board
COL15: U3.6 (Q7); also elsewhere on the board
COL16: U3.9 (Q8); also elsewhere on the board
COL17: U2.2 (Q1); also elsewhere on the board
COL18: U2.4 (Q2); also elsewhere on the board
COL19: U2.7 (Q3); also elsewhere on the board
COL20: U2.10 (Q4); also elsewhere on the board
COL21: U2.1 (Q5); also elsewhere on the board
COL22: U2.5 (Q6); also elsewhere on the board
COL23: U2.6 (Q7); also elsewhere on the board
COL24: U2.9 (Q8); also elsewhere on the board
COL_CLK: R4.1, U1.20 (RA1), U4.14 (CP0), U5.2 (I1), U6.2 (I1)
COL_MR: R34.1, U1.19 (RA0), U4.15 (MR)
GND: C1.2, C2.1, C3.1, C4.1, C5.2, C6.2, J1.4, R9.1, U1.5 (VSS), U1.6 (VSS), U2.8 (VSS), U2.13 (!CP1), U3.8 (VSS), U4.8 (VSS), U5.3 (GND), U6.3 (GND); also elsewhere on the board
unnamed: Q1.E, R9.2, U1.1 (RA2)
unnamed: U4.11 (Q9), U4.13 (!CP1), U5.1 (I0)
unnamed: U3.14 (CP0), U5.4 (O)
unnamed: U3.15 (MR), U4.3 (Q0)
unnamed: U2.15 (MR), U3.3 (Q0)
unnamed: U3.11 (Q9), U3.13 (!CP1), U6.1 (I0)
unnamed: U2.14 (CP0), U6.4 (O)
PGD: J1.6, U1.14 (RB7)
ROW1: U1.7 (RB0/INT); also elsewhere on the board
ROW2: U1.8 (RB1); also elsewhere on the board
ROW3: U1.9 (RB2); also elsewhere on the board
ROW4: U1.10 (RB3); also elsewhere on the board
ROW5: U1.11 (RB4); also elsewhere on the board
ROW6: U1.12 (RB5); also elsewhere on the board
ROW7/PGC: J1.5, U1.13 (RB6); also elsewhere on the board
SCL: J1.3, U1.17 (RA6/OSC2)
SDA: J1.2, U1.18 (RA7/OSC1)
VPP/!MCLR: J1.7, U1.4 (RA5/!MCLR!/VPP)

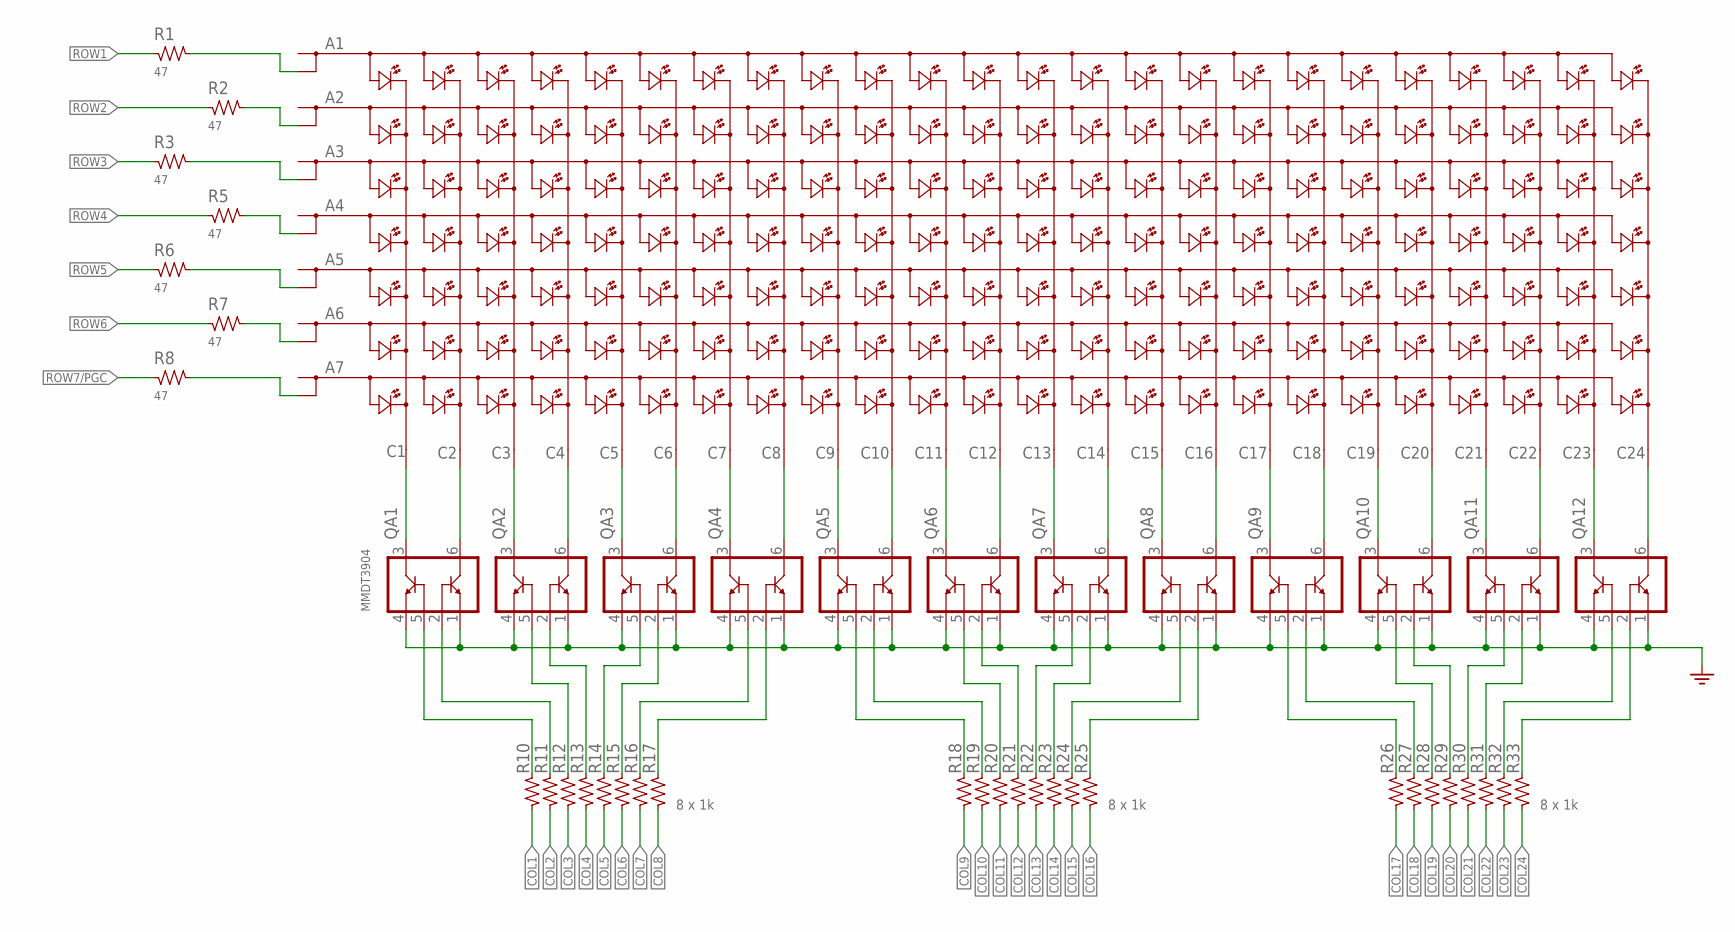
[picture p89: schematic display.sch, sheet 2, LED Matrix]

Parts:
QA1, QA2, QA3, QA4, QA5, QA6, QA7, QA8, QA9, QA10, QA11, QA12: MMDT3904; SOT363
R1, R2, R3, R5, R6, R7, R8: 47; SMD_0603
R10, R11, R12, R13, R14, R15, R16, R17, R18, R19, R20, R21, R22, R23, R24, R25, R26, R27, R28, R29, R30, R31, R32, R33: 1k; SMD_0603
U$1: LED_MATRIX_V_24X7

Connections:
COL1: R10.1; also elsewhere on the board
COL2: R11.1; also elsewhere on the board
COL3: R12.1; also elsewhere on the board
COL4: R13.1; also elsewhere on the board
COL5: R14.1; also elsewhere on the board
COL6: R15.1; also elsewhere on the board
COL7: R16.1; also elsewhere on the board
COL8: R17.1; also elsewhere on the board
COL9: R18.1; also elsewhere on the board
COL10: R19.1; also elsewhere on the board
COL11: R20.1; also elsewhere on the board
COL12: R21.1; also elsewhere on the board
COL13: R22.1; also elsewhere on the board
COL14: R23.1; also elsewhere on the board
COL15: R24.1; also elsewhere on the board
COL16: R25.1; also elsewhere on the board
COL17: R26.1; also elsewhere on the board
COL18: R27.1; also elsewhere on the board
COL19: R28.1; also elsewhere on the board
COL20: R29.1; also elsewhere on the board
COL21: R30.1; also elsewhere on the board
COL22: R31.1; also elsewhere on the board
COL23: R32.1; also elsewhere on the board
COL24: R33.1; also elsewhere on the board
GND: QA1.1 (E2), QA1.4 (E1), QA2.1 (E2), QA2.4 (E1), QA3.1 (E2), QA3.4 (E1), QA4.1 (E2), QA4.4 (E1), QA5.1 (E2), QA5.4 (E1), QA6.1 (E2), QA6.4 (E1), QA7.1 (E2), QA7.4 (E1), QA8.1 (E2), QA8.4 (E1), QA9.1 (E2), QA9.4 (E1), QA10.1 (E2), QA10.4 (E1), QA11.1 (E2), QA11.4 (E1), QA12.1 (E2), QA12.4 (E1); also elsewhere on the board
unnamed: R8.2, U$1.A7@2 (A7)
unnamed: R7.2, U$1.A6@2 (A6)
unnamed: R6.2, U$1.A5@2 (A5)
unnamed: R5.2, U$1.A4@2 (A4)
unnamed: R3.2, U$1.A3@2 (A3)
unnamed: R2.2, U$1.A2@2 (A2)
unnamed: R1.2, U$1.A1@2 (A1)
unnamed: QA12.6 (C2), U$1.C24
unnamed: QA12.3 (C1), U$1.C23
unnamed: QA11.6 (C2), U$1.C22
unnamed: QA11.3 (C1), U$1.C21
unnamed: QA10.6 (C2), U$1.C20
unnamed: QA10.3 (C1), U$1.C19
unnamed: QA9.6 (C2), U$1.C18
unnamed: QA9.3 (C1), U$1.C17
unnamed: QA8.6 (C2), U$1.C16
unnamed: QA8.3 (C1), U$1.C15
unnamed: QA7.6 (C2), U$1.C14
unnamed: QA7.3 (C1), U$1.C13
unnamed: QA6.6 (C2), U$1.C12
unnamed: QA6.3 (C1), U$1.C11
unnamed: QA5.6 (C2), U$1.C10
unnamed: QA5.3 (C1), U$1.C9
unnamed: QA4.6 (C2), U$1.C8
unnamed: QA4.3 (C1), U$1.C7
unnamed: QA3.6 (C2), U$1.C6
unnamed: QA3.3 (C1), U$1.C5
unnamed: QA2.6 (C2), U$1.C4
unnamed: QA2.3 (C1), U$1.C3
unnamed: QA1.6 (C2), U$1.C2
unnamed: QA1.3 (C1), U$1.C1
unnamed: QA9.5 (B1), R26.2
unnamed: QA9.2 (B2), R27.2
unnamed: QA10.5 (B1), R28.2
unnamed: QA10.2 (B2), R29.2
unnamed: QA11.5 (B1), R30.2
unnamed: QA11.2 (B2), R31.2
unnamed: QA12.5 (B1), R32.2
unnamed: QA12.2 (B2), R33.2
unnamed: QA8.2 (B2), R25.2
unnamed: QA8.5 (B1), R24.2
unnamed: QA7.2 (B2), R23.2
unnamed: QA7.5 (B1), R22.2
unnamed: QA6.2 (B2), R21.2
unnamed: QA6.5 (B1), R20.2
unnamed: QA5.2 (B2), R19.2
unnamed: QA5.5 (B1), R18.2
unnamed: QA4.2 (B2), R17.2
unnamed: QA4.5 (B1), R16.2
unnamed: QA3.2 (B2), R15.2
unnamed: QA3.5 (B1), R14.2
unnamed: QA2.2 (B2), R13.2
unnamed: QA2.5 (B1), R12.2
unnamed: QA1.2 (B2), R11.2
unnamed: QA1.5 (B1), R10.2
ROW1: R1.1; also elsewhere on the board
ROW2: R2.1; also elsewhere on the board
ROW3: R3.1; also elsewhere on the board
ROW4: R5.1; also elsewhere on the board
ROW5: R6.1; also elsewhere on the board
ROW6: R7.1; also elsewhere on the board
ROW7/PGC: R8.1; also elsewhere on the board

Notes on the sheet:
8 x 1k

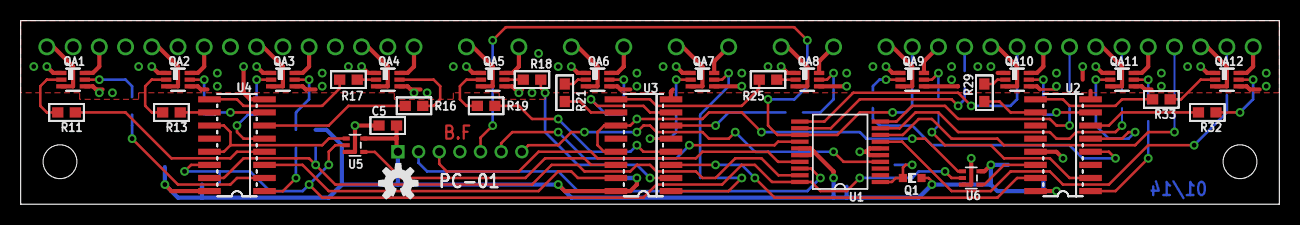
[picture p90: board display.brd from above]

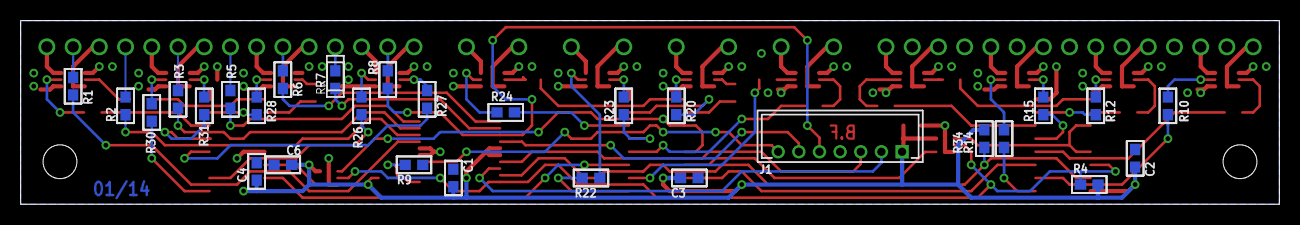
[picture p91: board display.brd from below]

Board: 2 copper layers, 121.9 x 17.8 mm, 64 parts (30 on the bottom side), 101 nets.

Other parts of the board:
U$3: OPENHW_LOGO_150
U$6: INFO_DATE
U$7: INFO_AUTHOR
