bfrigon/alarm-clock-hardware/pcb/display-model-b/dots/dots.brd

## EAGLE design pcb/display-model-b/dots/dots.brd (2014-12-29)

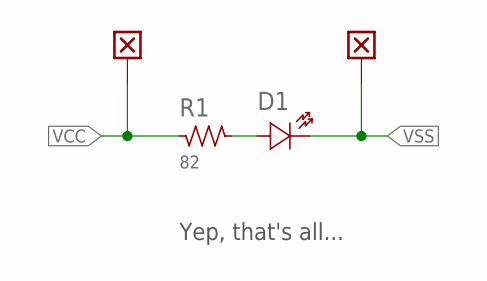
[picture p92: schematic dots.sch]

Parts:
D1: {ATTR:COLOR}; CHIPLED_0805; PART_NO APT2012SECK/J4-PRV
R1: 82; SMD_0603
W1, W2: WIRE; WIRE_SMT

Connections:
unnamed: D1.A, R1.2
VCC: R1.1, W1.1
VSS: D1.K, W2.1

Notes on the sheet:
Yep, that's all...

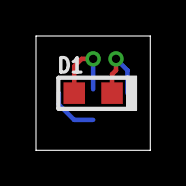
[picture p93: board dots.brd from above]

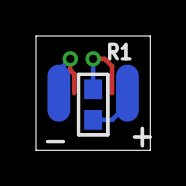
[picture p94: board dots.brd from below]

Board: 2 copper layers, 6.3 x 6.3 mm, 4 parts (3 on the bottom side), 3 nets.
