bfrigon/alarm-clock-hardware/pcb/display-model-b/base/rev-b/base.brd

## EAGLE design pcb/display-model-b/base/rev-b/base.brd (2014-10-19)

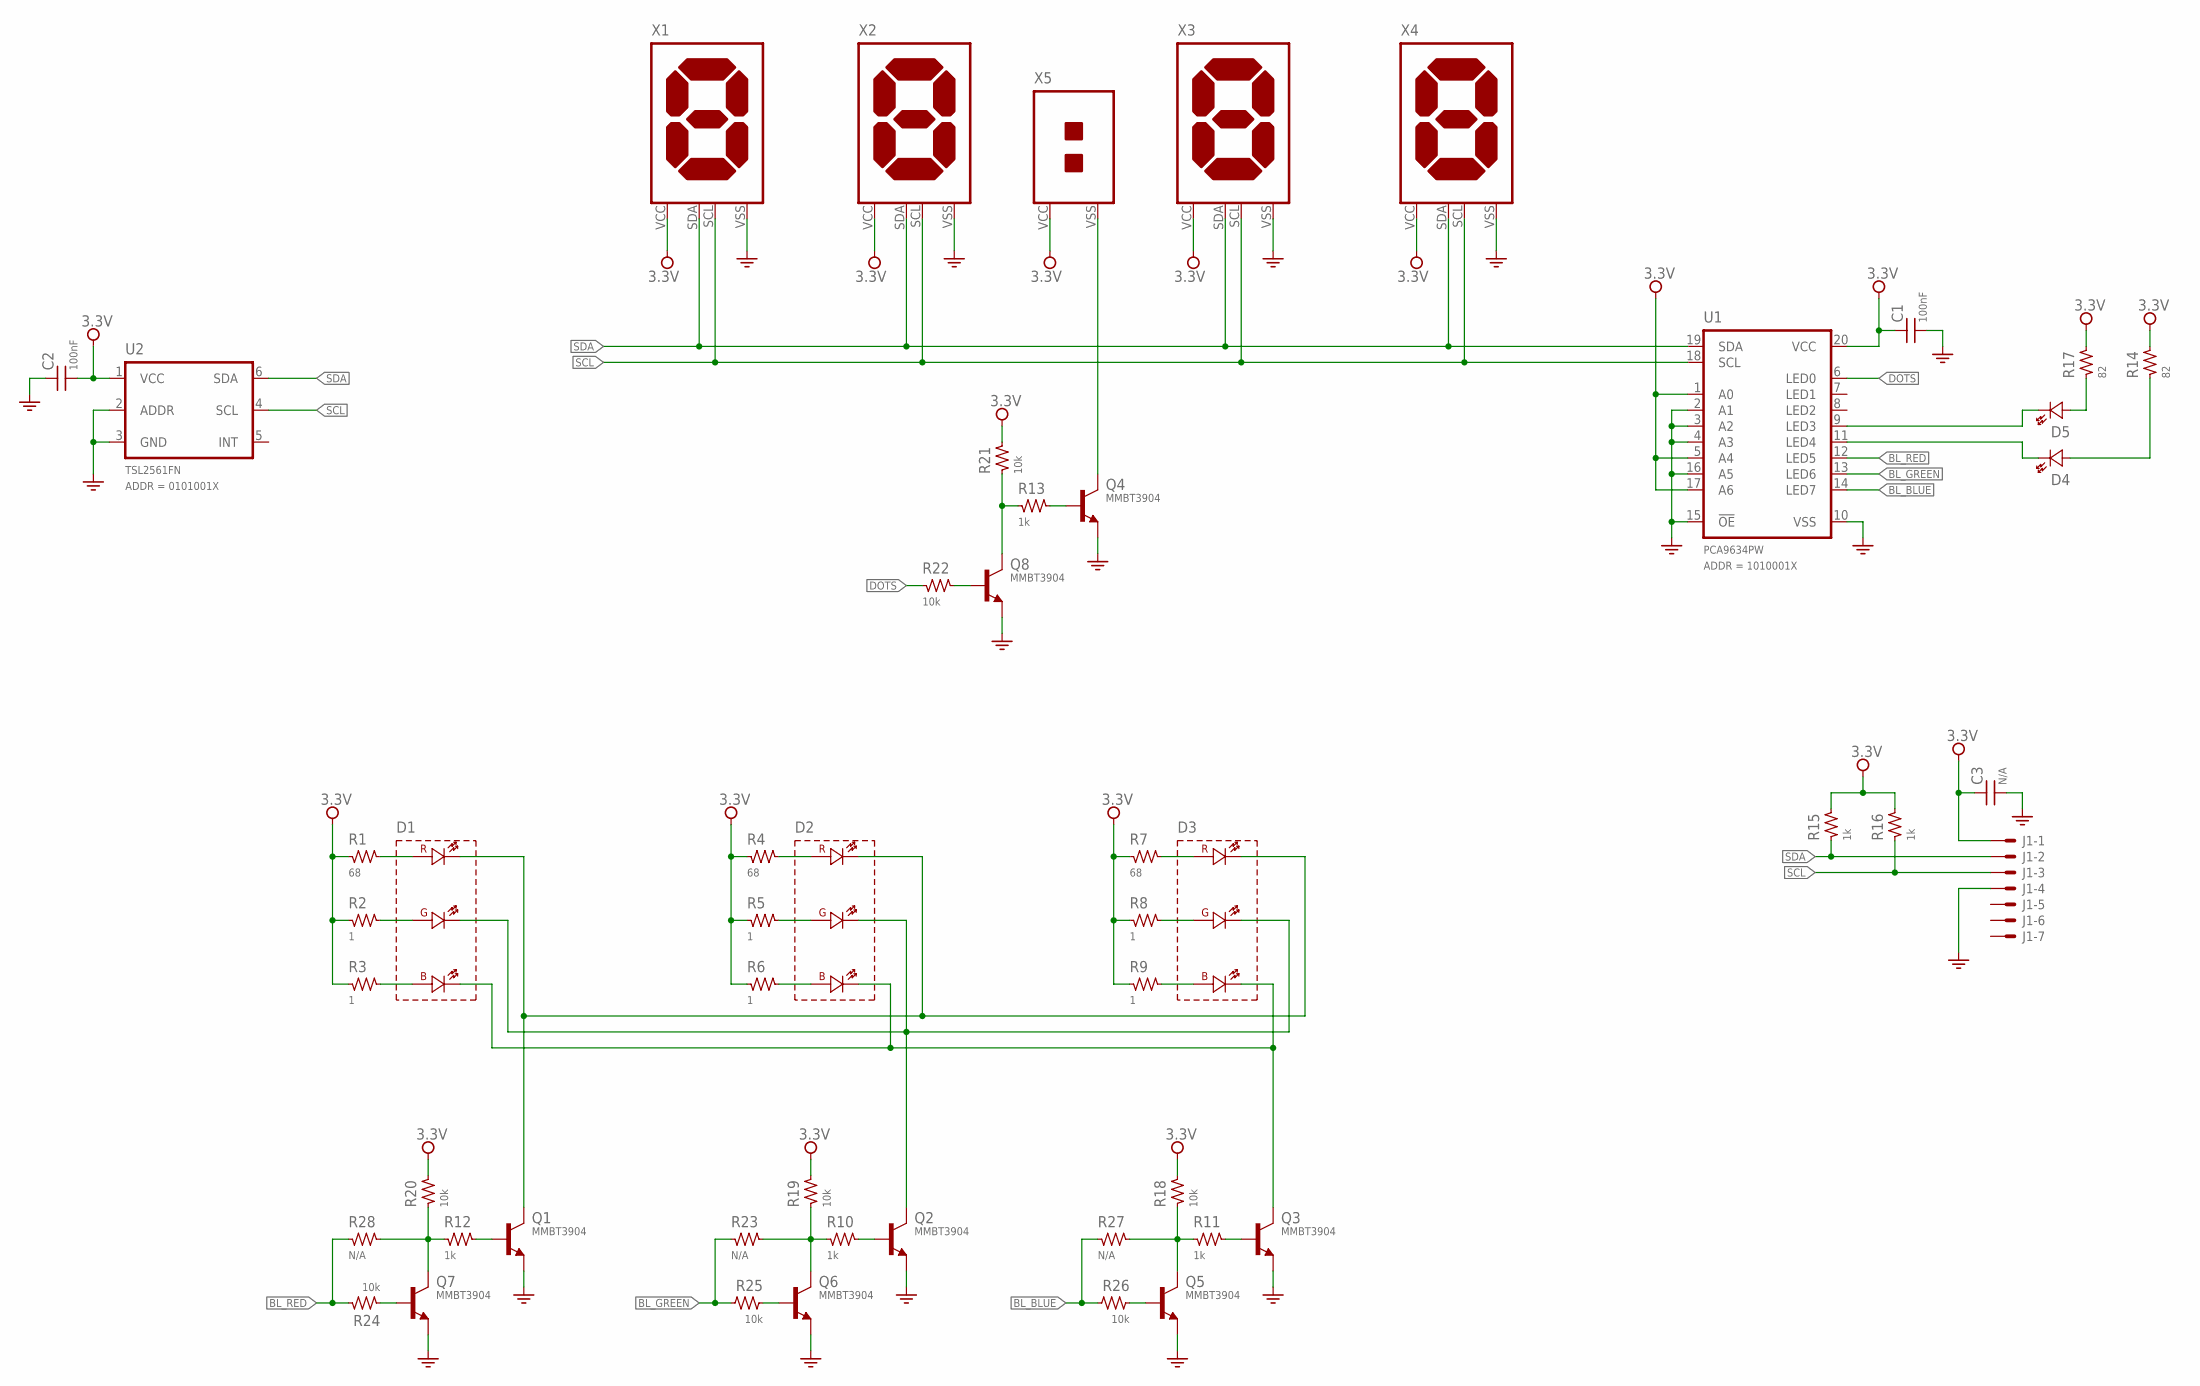
[picture p95: schematic base.sch]

Parts:
C1, C2: 100nF; SMD_0603
C3: N/A; SMD_0805
D1, D2, D3: SMP6-RGB; LED_RGB_PLCC6
D4, D5: {ATTR:COLOR}; LED_3MM
J1: SNG-2MM-HEADER-07-V; DF3X-7P-2DSA; PART_NO DF3A-7P-2DSA
Q1, Q2, Q3, Q4, Q5, Q6, Q7, Q8: MMBT3904; SOT23
R1, R4, R7: 68; SMD_0603
R2, R3, R5, R6, R8, R9: 1; SMD_0603
R10, R11, R12, R13, R15, R16: 1k; SMD_0603
R14, R17: 82; SMD_0603
R18, R19, R20, R21, R22, R24, R25, R26: 10k; SMD_0603
R23, R27, R28: N/A; SMD_0603
U1: PCA9634PW; TSSOP20
U2: TSL2561FN; DFN-6
X1, X2, X3, X4: CLOCK_LED_SEGMENT
X5: CLOCK_LED_DOTS

Connections:
3.3V: C1.1, C2.2, C3.1, J1.1, R1.1, R2.1, R3.1, R4.1, R5.1, R6.1, R7.1, R8.1, R9.1, R14.2, R15.2, R16.2, R17.2, R18.2, R19.2, R20.2, R21.2, U1.1 (A0), U1.5 (A4), U1.17 (A6), U1.20 (VCC), U2.1 (VCC), X1.VCC, X2.VCC, X3.VCC, X4.VCC, X5.VCC
BL_BLUE: R26.2, R27.1, U1.14 (LED7)
BL_GREEN: R23.1, R25.2, U1.13 (LED6)
BL_RED: R24.2, R28.1, U1.12 (LED5)
DOTS: R22.1, U1.6 (LED0)
GND: C1.2, C2.1, C3.2, J1.4, Q1.2 (E), Q2.2 (E), Q3.2 (E), Q4.2 (E), Q5.2 (E), Q6.2 (E), Q7.2 (E), Q8.2 (E), U1.2 (A1), U1.3 (A2), U1.4 (A3), U1.10 (VSS), U1.15 (!OE), U1.16 (A5), U2.2 (ADDR), U2.3 (GND), X1.VSS, X2.VSS, X3.VSS, X4.VSS
unnamed: D1.2 (GA), R2.2
unnamed: D1.4 (RA), R1.2
unnamed: D1.6 (BA), R3.2
unnamed: D2.4 (RA), R4.2
unnamed: D1.1 (GK), D2.1 (GK), D3.1 (GK), Q2.3 (C)
unnamed: D1.5 (BK), D2.5 (BK), D3.5 (BK), Q3.3 (C)
unnamed: D2.2 (GA), R5.2
unnamed: D2.6 (BA), R6.2
unnamed: D3.6 (BA), R9.2
unnamed: D3.2 (GA), R8.2
unnamed: D3.4 (RA), R7.2
unnamed: D1.3 (RK), D2.3 (RK), D3.3 (RK), Q1.3 (C)
unnamed: Q2.1 (B), R10.2
unnamed: Q3.1 (B), R11.2
unnamed: Q4.3 (C), X5.VSS
unnamed: Q4.1 (B), R13.2
unnamed: Q1.1 (B), R12.2
unnamed: D4.K, U1.11 (LED4)
unnamed: D4.A, R14.1
unnamed: D5.A, R17.1
unnamed: D5.K, U1.9 (LED3)
unnamed: Q6.3 (C), R10.1, R19.1, R23.2
unnamed: Q5.3 (C), R11.1, R18.1, R27.2
unnamed: Q7.3 (C), R12.1, R20.1, R28.2
unnamed: Q5.1 (B), R26.1
unnamed: Q8.3 (C), R13.1, R21.1
unnamed: Q8.1 (B), R22.2
unnamed: Q6.1 (B), R25.1
unnamed: Q7.1 (B), R24.1
SCL: J1.3, R16.1, U1.18 (SCL), U2.4 (SCL), X1.SCL, X2.SCL, X3.SCL, X4.SCL
SDA: J1.2, R15.1, U1.19 (SDA), U2.6 (SDA), X1.SDA, X2.SDA, X3.SDA, X4.SDA

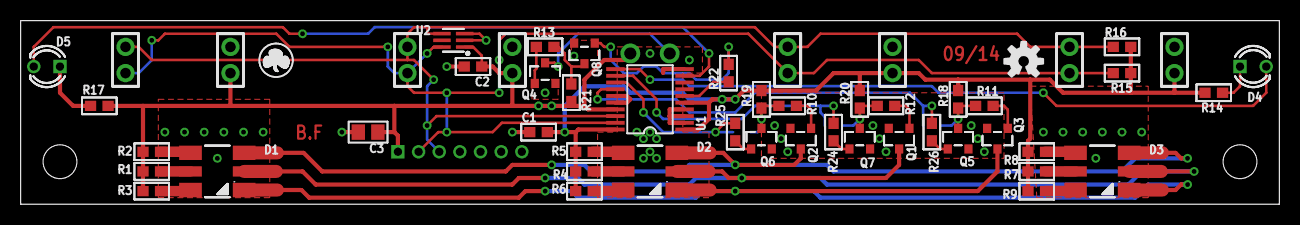
[picture p96: board pcb/display-model-b/base/rev-b/base.brd from above]

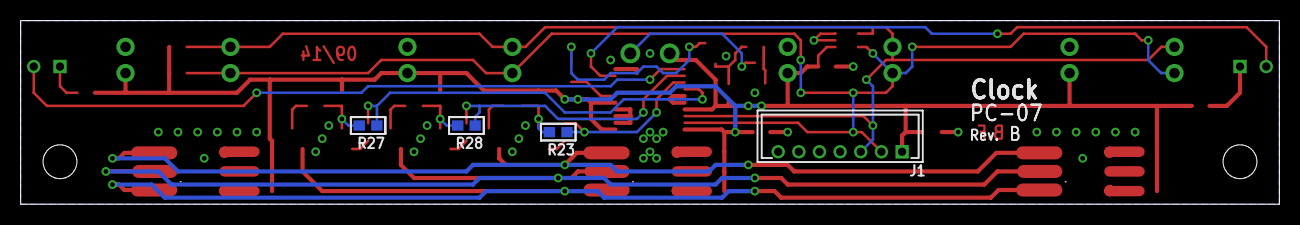
[picture p97: board pcb/display-model-b/base/rev-b/base.brd from below]

Board: 2 copper layers, 121.9 x 17.8 mm, 57 parts (5 on the bottom side), 37 nets.

Other parts of the board:
U$1: INFO_DATE
U$2: LOGO2
U$3: OPENHW_LOGO_150
U$4: INFO_COMPACT
U$5: INFO_AUTHOR
