bfrigon/alarm-clock-hardware/pcb/touch/rev-a/touch.brd

## EAGLE design pcb/touch/rev-a/touch.brd (2014-12-29)

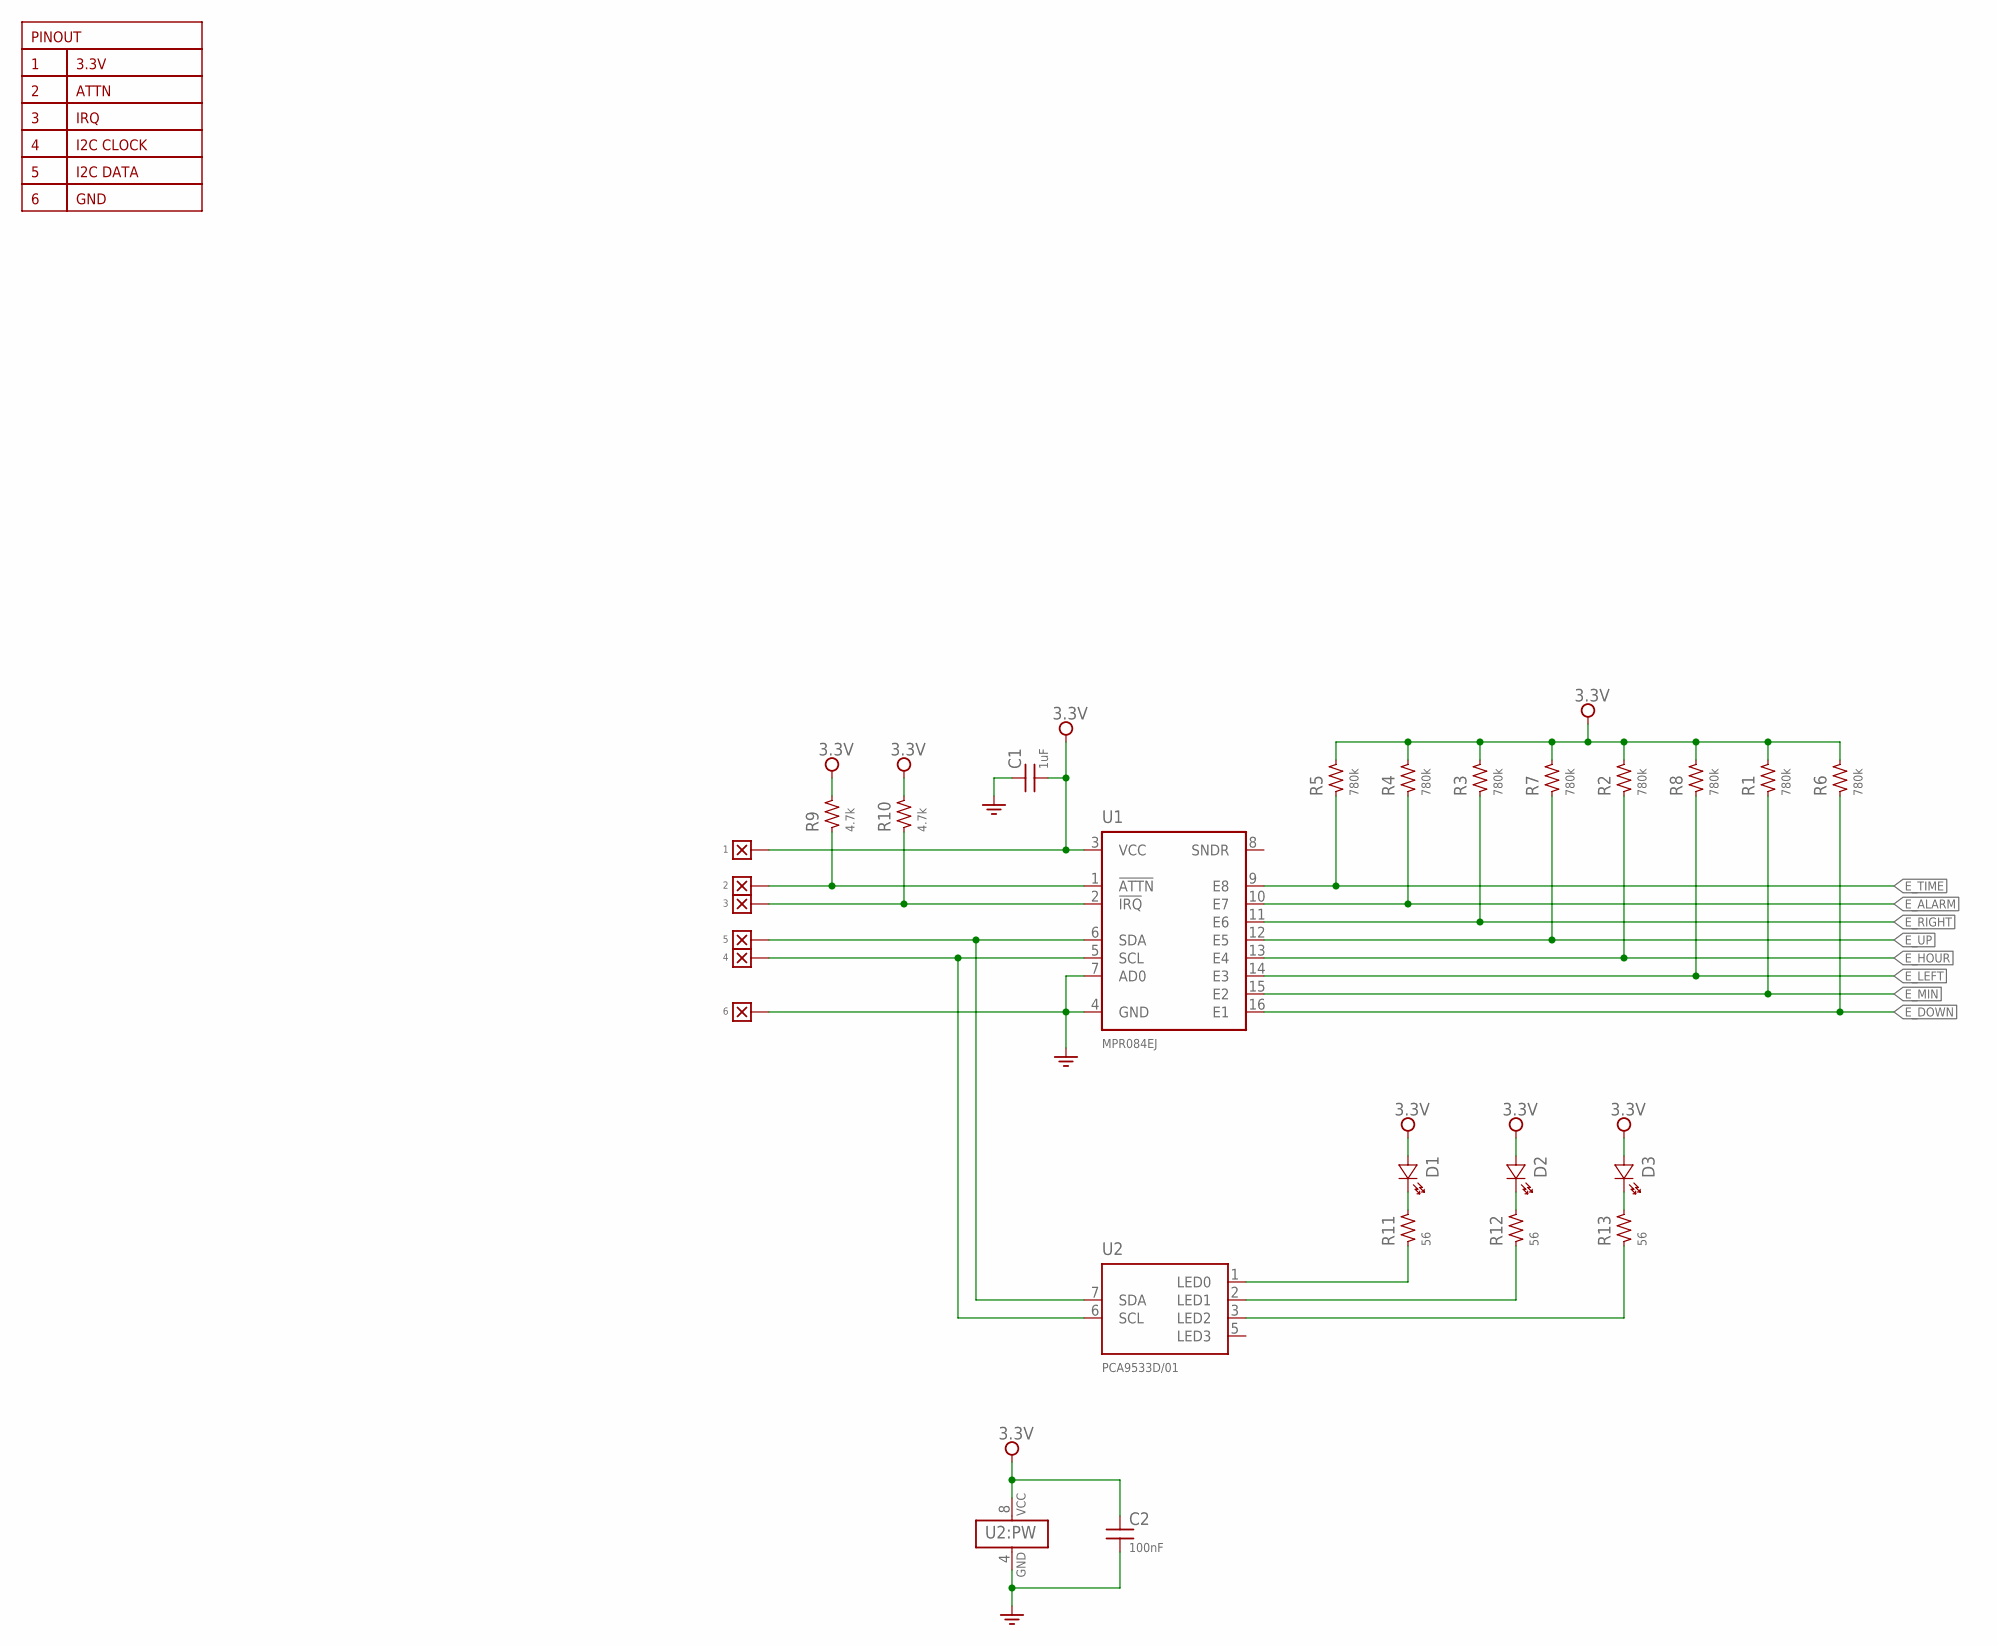
[picture p98: schematic touch.sch]

Parts:
3.3V: 1; WIRE_SMT
!ATTN: 2; WIRE_SMT
!IRQ: 3; WIRE_SMT
C1: 1uF; SMD_0603
C2: 100nF; SMD_0603
D1, D2, D3: {ATTR:COLOR}; CHIPLED_0805
R1, R2, R3, R4, R5, R6, R7, R8: 780k; SMD_0603
R9, R10: 4.7k; SMD_0603
R11, R12, R13: 56; SMD_0603
SCL: 4; WIRE_SMT
SDA: 5; WIRE_SMT
U1: MPR084EJ; TSSOP16
U2: PCA9533D/01; SOIC8
W6: 6; WIRE_SMT

Connections:
3.3V: 3.3V.1, C1.2, C2.1, D1.A, D2.A, D3.A, R1.2, R2.2, R3.2, R4.2, R5.2, R6.2, R7.2, R8.2, R9.2, R10.2, U1.3 (VCC), U2.8 (VCC)
!ATTN: !ATTN.1, R9.1, U1.1 (!ATTN)
!IRQ: !IRQ.1, R10.1, U1.2 (!IRQ)
E_ALARM: R4.1, U1.10 (E7)
E_DOWN: R6.1, U1.16 (E1)
E_HOUR: R2.1, U1.13 (E4)
E_LEFT: R8.1, U1.14 (E3)
E_MIN: R1.1, U1.15 (E2)
E_RIGHT: R3.1, U1.11 (E6)
E_TIME: R5.1, U1.9 (E8)
E_UP: R7.1, U1.12 (E5)
GND: C1.1, C2.2, U1.4 (GND), U1.7 (AD0), U2.4 (GND), W6.1
unnamed: D1.K, R11.2
unnamed: D2.K, R12.2
unnamed: D3.K, R13.2
unnamed: R11.1, U2.1 (LED0)
unnamed: R12.1, U2.2 (LED1)
unnamed: R13.1, U2.3 (LED2)
SCL: SCL.1, U1.5 (SCL), U2.6 (SCL)
SDA: SDA.1, U1.6 (SDA), U2.7 (SDA)
