bfrigon/alarm-clock-hardware/pcb/touch/rev-a/touch.brd

## EAGLE design pcb/touch/rev-a/touch.brd (continued)

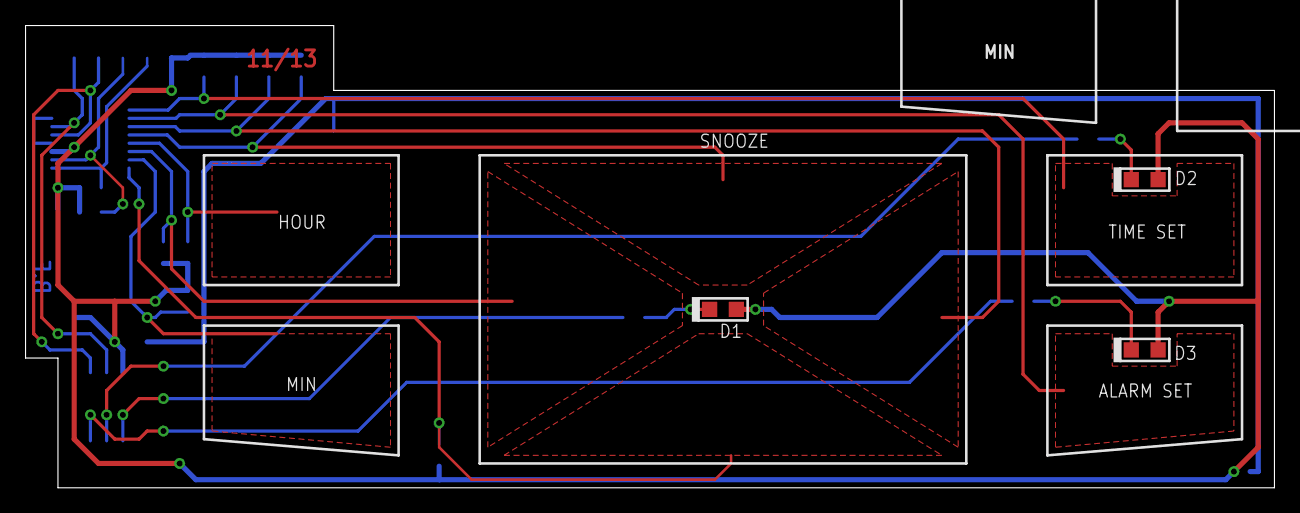
[picture p99: board pcb/touch/rev-a/touch.brd from above]

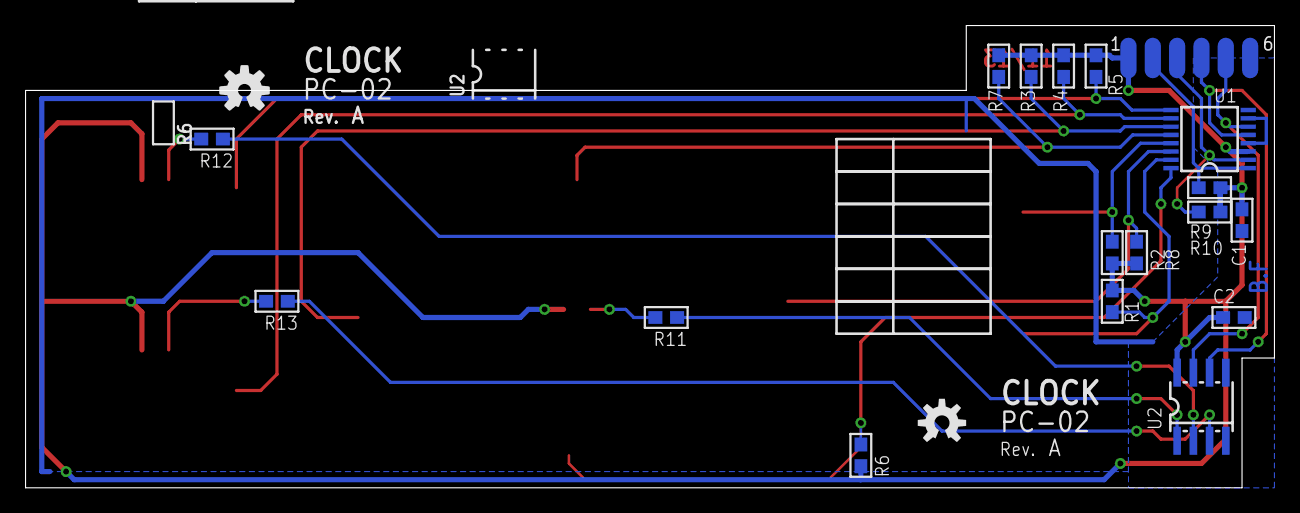
[picture p100: board pcb/touch/rev-a/touch.brd from below]

Board: 2 copper layers, 97.8 x 36.2 mm, 36 parts (32 on the bottom side), 20 nets.

Other parts of the board:
U$1: INFO_AUTHOR
U$2: INFO_DATE
U$3: INFO_COMPACT
U$5: OPENHW_LOGO_150
U$11, U$12, U$13, U$14, U$15, U$16: LEGEND_ROW_30
