bfrigon/alarm-clock-hardware/pcb/display-model-b/base/base.brd

## EAGLE design pcb/display-model-b/base/base.brd (2014-12-29)

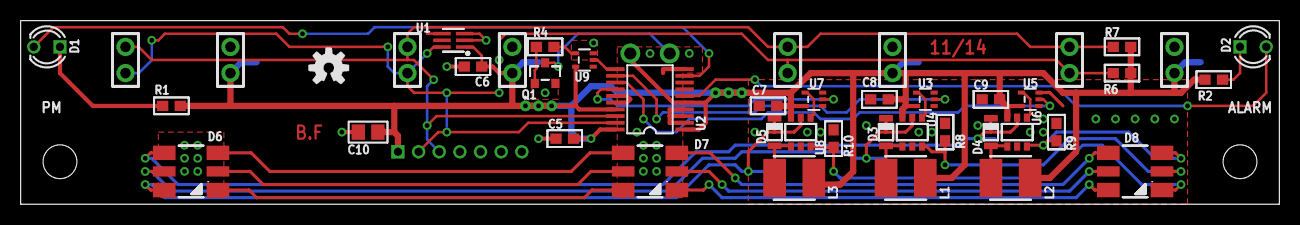
[picture p101: board pcb/display-model-b/base/base.brd from above]

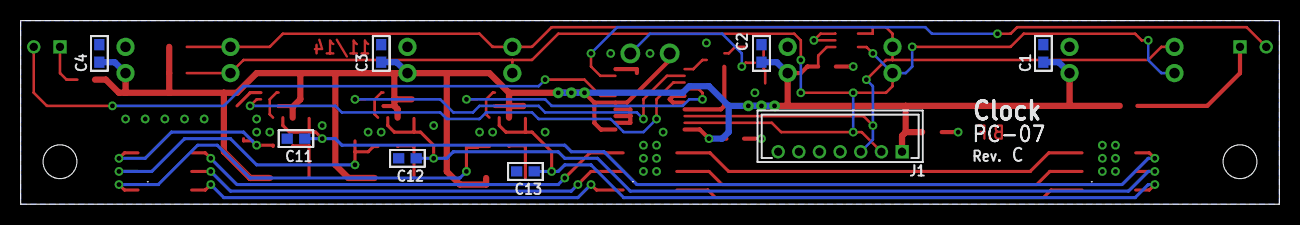
[picture p102: board pcb/display-model-b/base/base.brd from below]

Board: 2 copper layers, 121.9 x 17.8 mm, 52 parts (9 on the bottom side), 33 nets.

Parts:
C1, C2, C3, C4, C7, C8, C9, C11, C12, C13: 1uF; SMD_0603
C5, C6: 100nF; SMD_0603
C10: N/A; SMD_0805
D1, D2: {ATTR:COLOR}; LED_3MM
D3, D4, D5: SOD-323
D6, D7, D8: SMP6-RGB; LED_RGB_PLCC6
J1: SNG-2MM-HEADER-07-V; DF3X-7P-2DSA
L1, L2, L3: 22uH; IND-4X4
Q1: MMBT3904; SOT23
R1, R2: 82; SMD_0603
R4: 3k; SMD_0603
R6, R7: 1k; SMD_0603
R8, R9, R10: 5.1 (0.5%); SMD_0603
U1: TSL2561FN; DFN-6
U2: PCA9634PW; TSSOP20
U3, U5, U7, U9: 74AHC1G04DCK; SC70-5
U4, U6, U8: AP5724W; SOT23-6
U$1: INFO_DATE
U$3: OPENHW_LOGO_150
U$4: INFO_COMPACT
U$5: INFO_AUTHOR
X1, X2, X3, X4: CLOCK_LED_SEGMENT
X5: CLOCK_LED_DOTS

Connections:
3.3V: C1.2, C2.2, C3.2, C4.2, C5.1, C6.2, C7.2, C8.2, C9.2, C10.1, J1.1, L1.1, L2.1, L3.1, R1.2, R2.2, R6.2, R7.2, U1.1, U2.1, U2.5, U2.17, U2.20, U3.5, U4.6, U5.5, U6.6, U7.5, U8.6, U9.5, X1.VCC, X2.VCC, X3.VCC, X4.VCC, X5.VCC
DOTS: U2.11, U9.2
FB_B: D8.5, R10.2, U8.3
FB_G: D8.1, R9.2, U6.3
FB_R: D8.3, R8.2, U4.3
GND: C1.1, C2.1, C3.1, C4.1, C5.2, C6.1, C7.1, C8.1, C9.1, C10.2, C11.2, C12.2, C13.2, J1.4, Q1.2, R8.1, R9.1, R10.1, U1.2, U1.3, U2.2, U2.3, U2.4, U2.10, U2.15, U2.16, U3.3, U4.2, U5.3, U6.2, U7.3, U8.2, U9.3, X1.VSS, X2.VSS, X3.VSS, X4.VSS
unnamed: D6.3, D7.4
unnamed: D7.3, D8.4
unnamed: D7.1, D8.2
unnamed: D6.1, D7.2
unnamed: D6.5, D7.6
unnamed: D7.5, D8.6
unnamed: D3.A, L1.2, U4.1
unnamed: D4.A, L2.2, U6.1
unnamed: D5.A, L3.2, U8.1
unnamed: Q1.3, X5.VSS
unnamed: Q1.1, R4.2
unnamed: D2.K, U2.6
unnamed: D2.A, R2.1
unnamed: D1.A, R1.1
unnamed: D1.K, U2.9
unnamed: U3.4, U4.4
unnamed: R4.1, U9.4
unnamed: U5.4, U6.4
unnamed: U7.4, U8.4
PWM_B: U2.14, U7.2
PWM_G: U2.13, U5.2
PWM_R: U2.12, U3.2
SCL: J1.3, R7.1, U1.4, U2.18, X1.SCL, X2.SCL, X3.SCL, X4.SCL
SDA: J1.2, R6.1, U1.6, U2.19, X1.SDA, X2.SDA, X3.SDA, X4.SDA
SW_B: C13.1, D5.K, D6.6, U8.5
SW_G: C11.1, D4.K, D6.2, U6.5
SW_R: C12.1, D3.K, D6.4, U4.5
