bfrigon/alarm-clock-hardware/pcb/tests/psu/psu_test.brd

## EAGLE design pcb/tests/psu/psu_test.brd (2014-10-19)

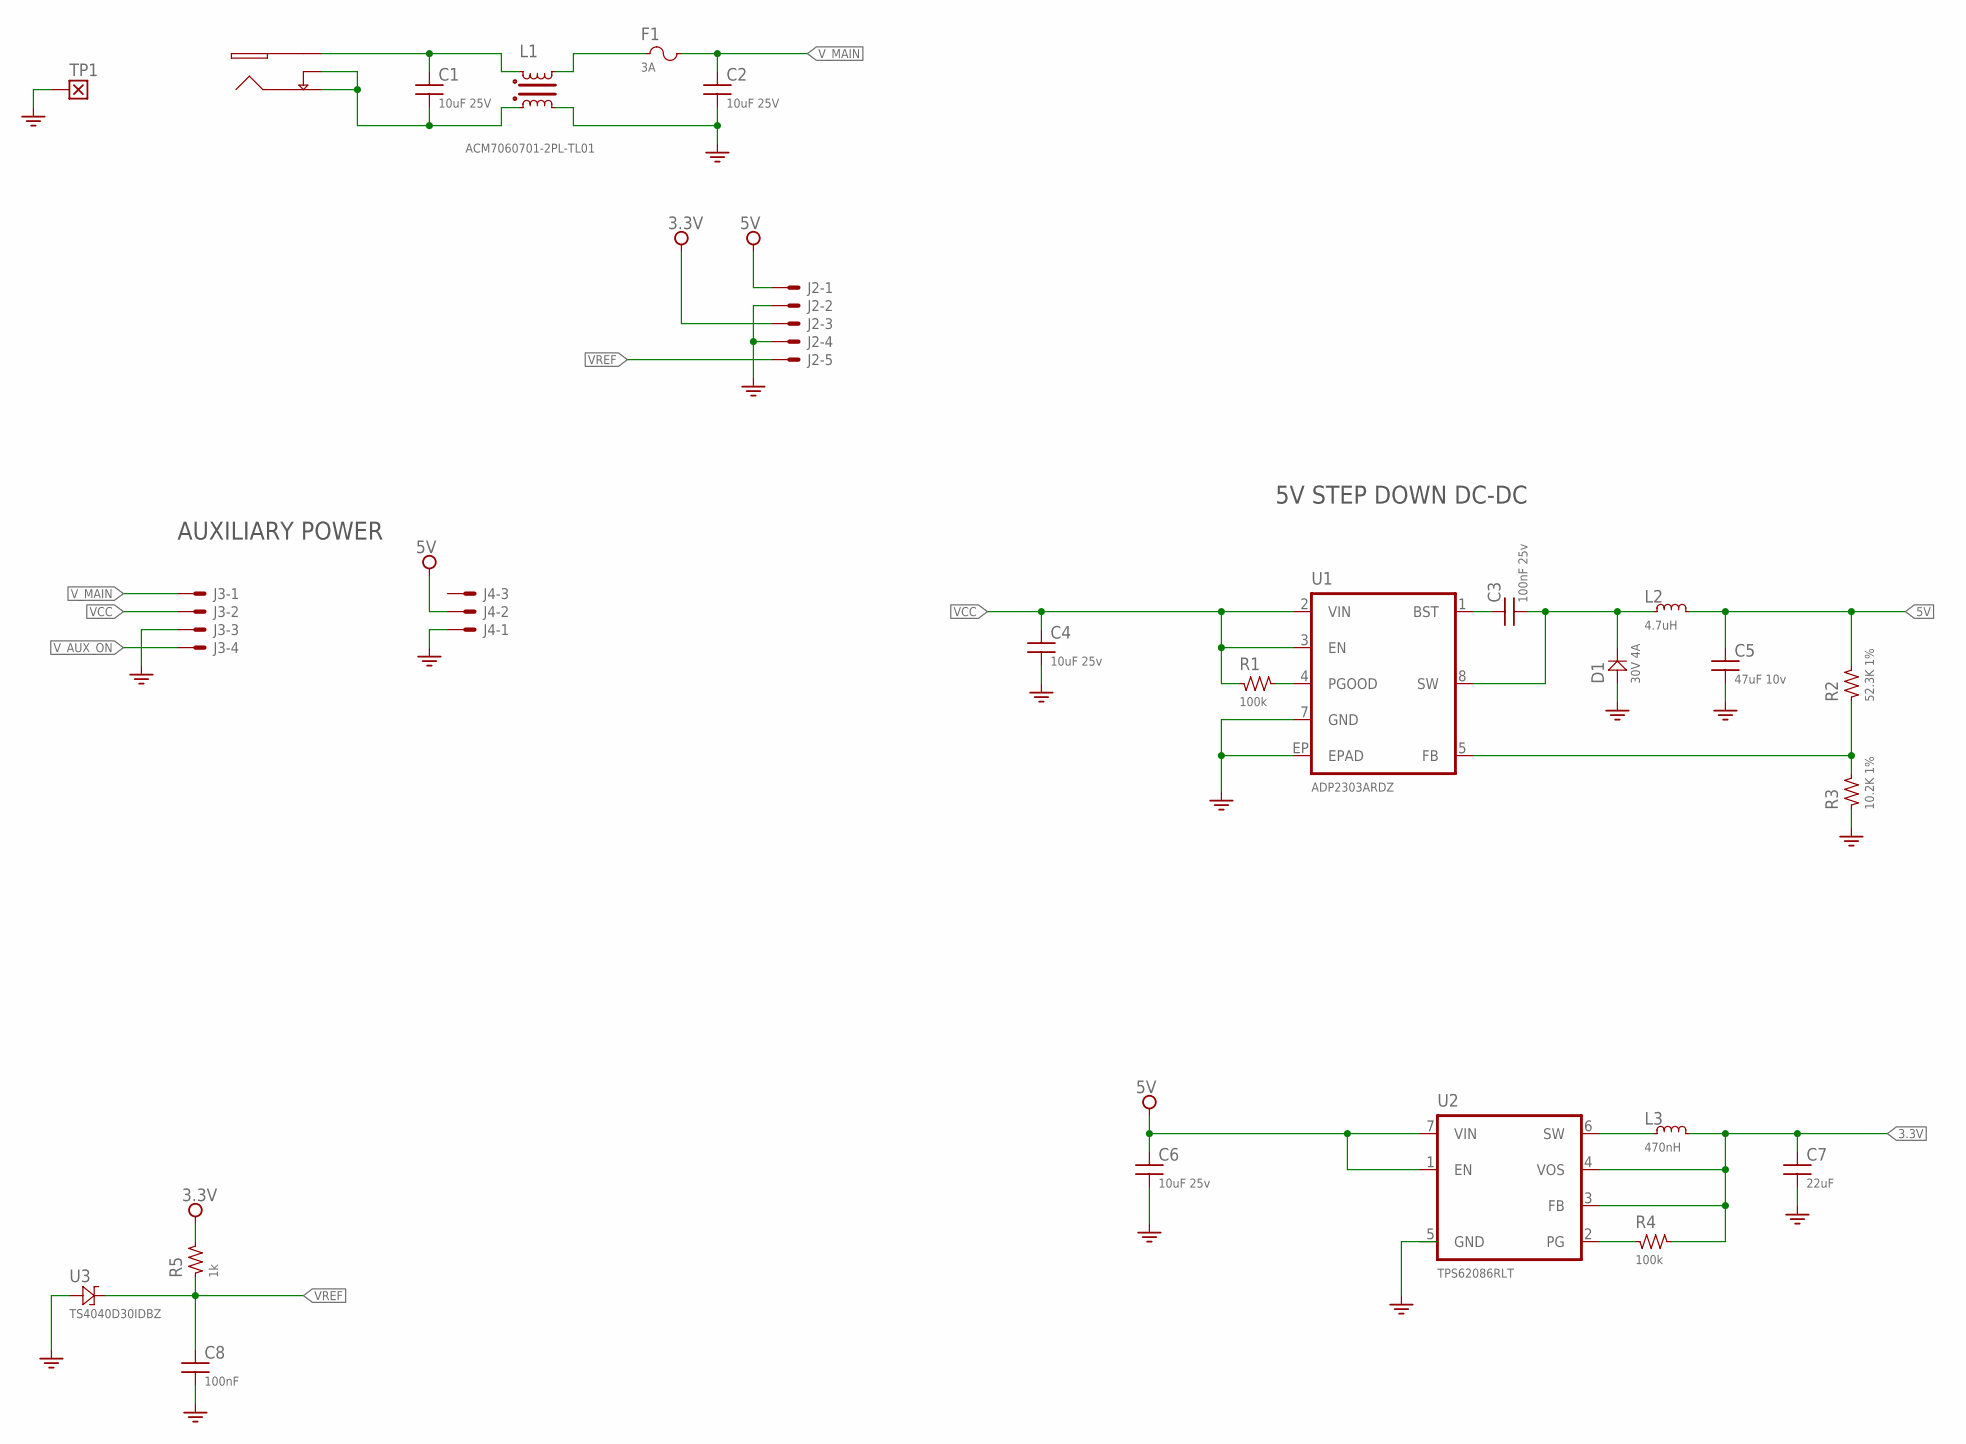
[picture p103: schematic psu_test.sch]

Parts:
C1, C2: 10uF 25V; SMD_0805
C3: 100nF 25v; SMD_0603
C4, C6: 10uF 25v; SMD_1206
C5: 47uF 10v; SMD_1206
C7: 22uF; SMD_1206
C8: 100nF; SMD_0603
D1: 30V 4A; DIODE_DO214-AA; PART_NO SSB43L-E3/52T
F1: 3A; SMD_1206
J1: CUI-PJ-013C
J2: SNG-100-HEADER-05-HDR-V; HDR_M_5
J3: SNG-100-HEADER-04-HDR-V; HDR_M_4
J4: SNG-100-HEADER-03-HDR-V; HDR_M_3
L1: ACM7060701-2PL-TL01; ACM7060; PART_NO ACM7060-701-2PL-TL01
L2: 4.7uH; IND_4020; PART_NO CLF10040T-4R7N
L3: 470nH; IND_4045
R1, R4: 100k; SMD_0603
R2: 52.3K 1%; SMD_0603
R3: 10.2K 1%; SMD_0603
R5: 1k; SMD_0603
TP1: TEST_POINT-TP_75X75; TP_75X75
U1: ADP2303ARDZ; SOIC8-EP
U2: TPS62086RLT; QFN-7
U3: TS4040D30IDBZ; SOT23

Connections:
3.3V: C7.1, J2.3, L3.2, R4.2, R5.2, U2.3 (FB), U2.4 (VOS)
5V: C5.1, C6.1, J2.1, J4.2, L2.2, R2.2, U2.1 (EN), U2.7 (VIN)
GND: C2.2, C4.2, C5.2, C6.2, C7.2, C8.2, D1.A, J2.2, J2.4, J3.3, J4.1, L1.OA, R3.1, TP1.1, U1.7 (GND), U1.EP (EPAD), U2.5 (GND), U3.2 (A)
unnamed: C1.2, J1.2 (GND), J1.3 (SW), L1.IA
unnamed: R1.2, U1.4 (PGOOD)
unnamed: C1.1, J1.1 (V+), L1.IB
unnamed: C3.1, U1.1 (BST)
unnamed: F1.1, L1.OB
unnamed: C3.2, D1.K, L2.1, U1.8 (SW)
unnamed: R2.1, R3.2, U1.5 (FB)
unnamed: L3.1, U2.6 (SW)
unnamed: R4.1, U2.2 (PG)
VCC: C4.1, J3.2, R1.1, U1.2 (VIN), U1.3 (EN)
VREF: C8.1, J2.5, R5.1, U3.1 (K)
V_AUX_ON: J3.4
V_MAIN: C2.1, F1.2, J3.1

Notes on the sheet:
5V STEP DOWN DC-DC
AUXILIARY POWER

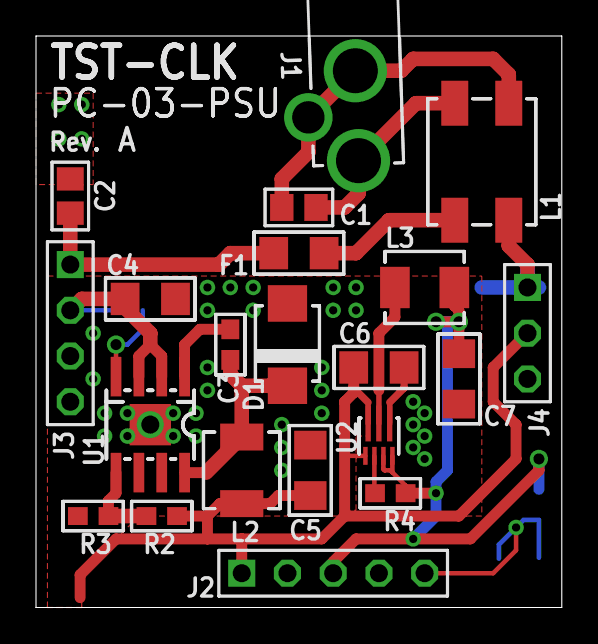
[picture p104: board psu_test.brd from above]

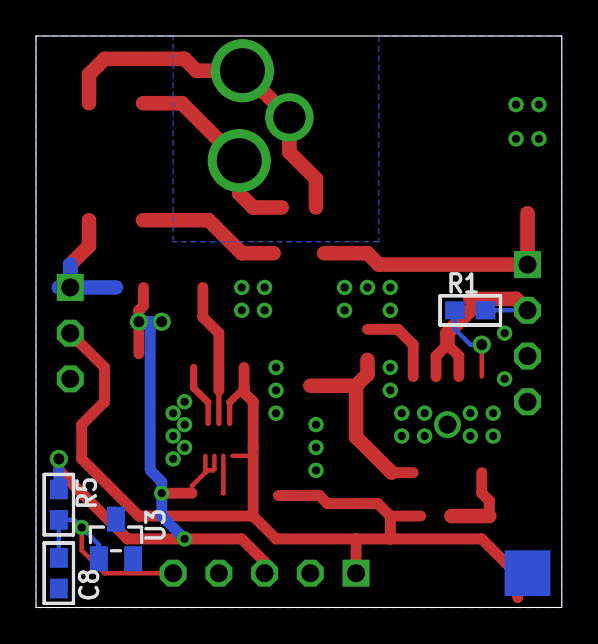
[picture p105: board psu_test.brd from below]

Board: 2 copper layers, 29.2 x 31.8 mm, 27 parts (5 on the bottom side), 15 nets.

Other parts of the board:
U$1: INFO_COMPACT
