bfrigon/alarm-clock-hardware/pcb/tests/psu2/psu.brd

## EAGLE design pcb/tests/psu2/psu.brd (2014-10-19)

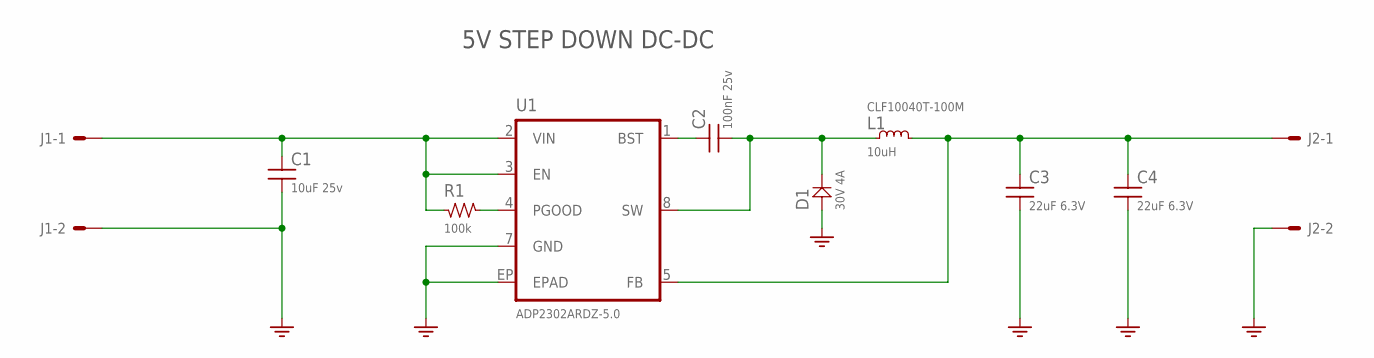
[picture p106: schematic psu.sch]

Parts:
C1: 10uF 25v; SMD_1206
C2: 100nF 25v; SMD_0603
C3, C4: 22uF 6.3V; SMD_1206
D1: 30V 4A; DIODE_DO214-AA
J1, J2: SNG-100-HEADER-03-HDR-V; HDR_M_3
L1: 10uH; IND-10X10; PART_NO CLF10040T-100M
R1: 100k; SMD_0603
U1: ADP2302ARDZ-5.0; SOIC8-EP

Connections:
5V: C3.1, C4.1, J2.1, L1.2, U1.5 (FB)
GND: C1.2, C3.2, C4.2, D1.A, J1.2, J2.2, U1.7 (GND), U1.EP (EPAD)
unnamed: R1.2, U1.4 (PGOOD)
unnamed: C2.1, U1.1 (BST)
unnamed: C2.2, D1.K, L1.1, U1.8 (SW)
VCC: C1.1, J1.1, R1.1, U1.2 (VIN), U1.3 (EN)

Notes on the sheet:
5V STEP DOWN DC-DC

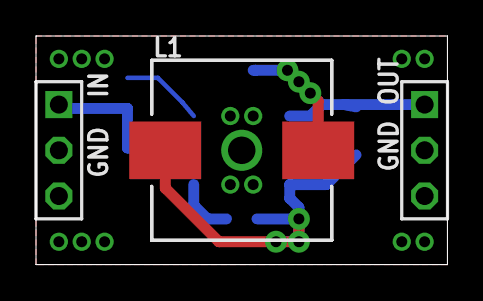
[picture p107: board psu.brd from above]

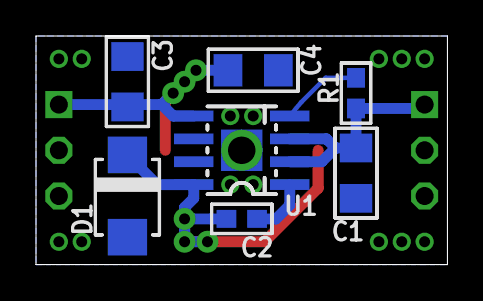
[picture p108: board psu.brd from below]

Board: 2 copper layers, 22.9 x 12.7 mm, 10 parts (7 on the bottom side), 6 nets.
