bfrigon/alarm-clock-hardware/pcb/tests/audio/usbspk.brd

## EAGLE design pcb/tests/audio/usbspk.brd (2014-10-19)

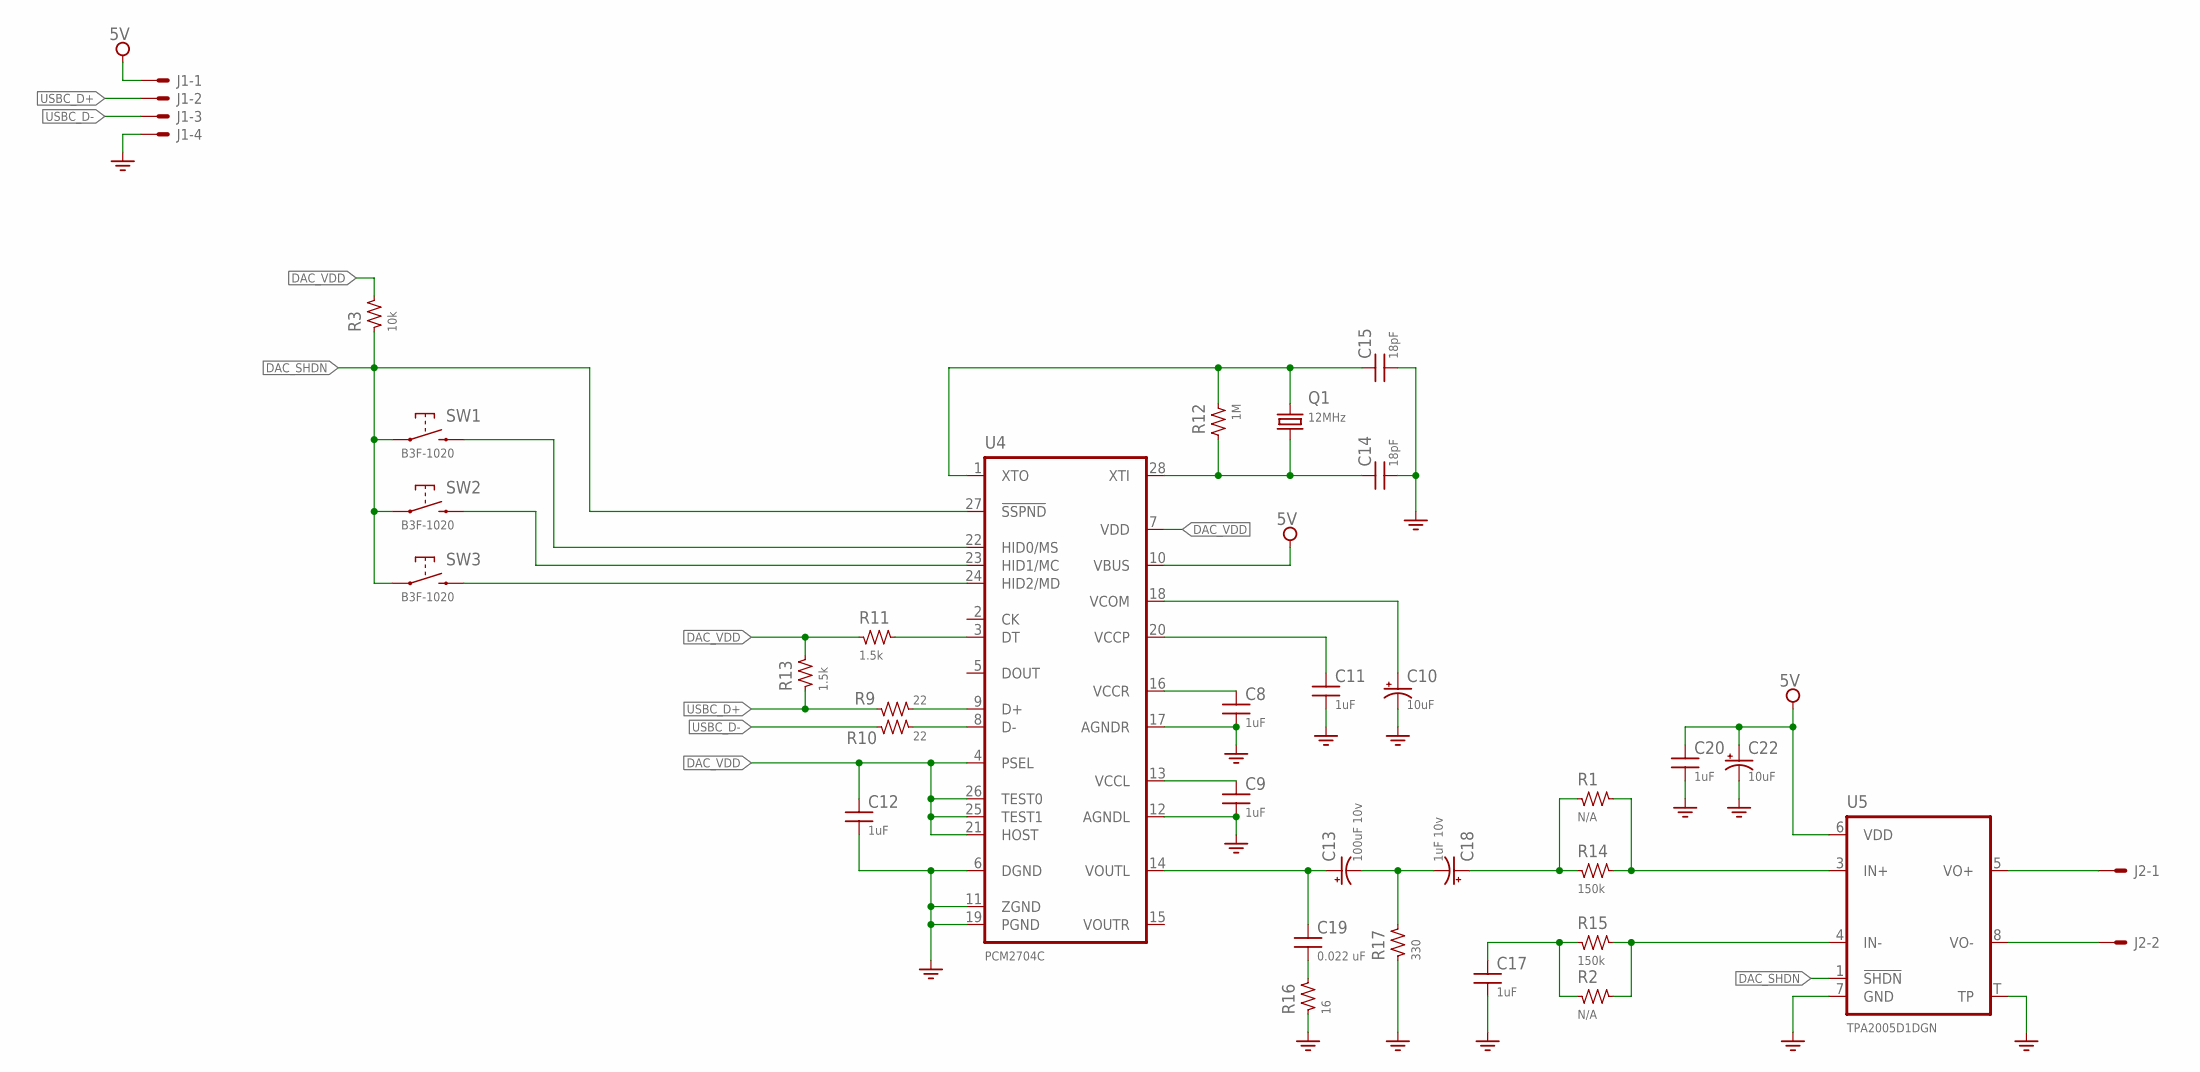
[picture p109: schematic usbspk.sch]

Parts:
C8, C9, C11, C12, C17, C20: 1uF; SMD_0603
C10, C22: 10uF; CAP_S0805
C13: 100uF 10v; CAP_S1210
C14, C15: 18pF; SMD_0603
C18: 1uF 10v; CAP_S0805
C19: 0.022 uF; SMD_0603
J1: SNG-100-HEADER-04-HDR-V; HDR_M_4
J2: SNG-100-HEADER-02-FL-V; 22-23-2021
Q1: 12MHz; HC49/S; PART_NO 9C-12.000MEEJ-T
R1, R2: N/A; SMD_0603
R3: 10k; SMD_0603
R9, R10: 22; SMD_0603
R11, R13: 1.5k; SMD_0603
R12: 1M; SMD_0603
R14, R15: 150k; SMD_0603
R16: 16; SMD_0603
R17: 330; SMD_0603
SW1, SW2, SW3: B3F-1020; B3F-10XX
U4: PCM2704C; TSSOP28
U5: TPA2005D1DGN; PPSOP8

Connections:
5V: C20.1, C22.+, J1.1, U4.10 (VBUS), U5.6 (VDD)
DAC_SHDN: R3.1, SW1.3 (1), SW1.4 (1), SW2.3 (1), SW2.4 (1), SW3.3 (1), SW3.4 (1), U4.27 (!SSPND), U5.1 (!SHDN)
DAC_VDD: C12.1, R3.2, R11.1, R13.2, U4.4 (PSEL), U4.7 (VDD), U4.21 (HOST), U4.25 (TEST1), U4.26 (TEST0)
GND: C8.2, C9.2, C10.-, C11.2, C12.2, C14.2, C15.2, C17.2, C20.2, C22.-, J1.4, R16.1, R17.1, U4.6 (DGND), U4.11 (ZGND), U4.12 (AGNDL), U4.17 (AGNDR), U4.19 (PGND), U5.7 (GND), U5.T (TP)
unnamed: R9.2, U4.9 (D+)
unnamed: R10.2, U4.8 (D-)
unnamed: C9.1, U4.13 (VCCL)
unnamed: C10.+, U4.18 (VCOM)
unnamed: C11.1, U4.20 (VCCP)
unnamed: C8.1, U4.16 (VCCR)
unnamed: C18.+, R1.1, R14.1
unnamed: R11.2, U4.3 (DT)
unnamed: SW1.1 (2), SW1.2, U4.22 (HID0/MS)
unnamed: SW2.1 (2), SW2.2, U4.23 (HID1/MC)
unnamed: SW3.1 (2), SW3.2, U4.24 (HID2/MD)
unnamed: C13.+, C19.1, U4.14 (VOUTL)
unnamed: J2.1, U5.5 (VO+)
unnamed: J2.2, U5.8 (VO-)
unnamed: R1.2, R14.2, U5.3 (IN+)
unnamed: R2.2, R15.2, U5.4 (IN-)
unnamed: C17.1, R2.1, R15.1
unnamed: C13.-, C18.-, R17.2
unnamed: C19.2, R16.2
USBC_D+: J1.2, R9.1, R13.1
USBC_D-: J1.3, R10.1
XTI: C14.1, Q1.2, R12.2, U4.28 (XTI)
XTO: C15.1, Q1.1, R12.1, U4.1 (XTO)

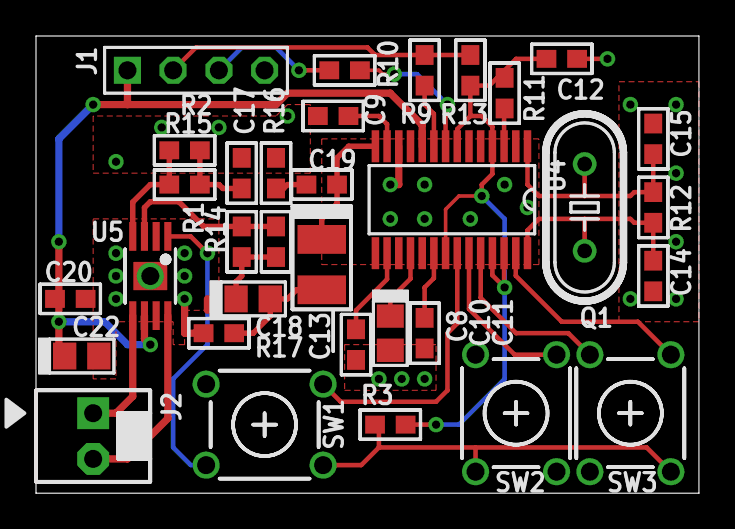
[picture p110: board usbspk.brd from above]

Board: 2 copper layers, 36.8 x 25.4 mm, 34 parts (1 on the bottom side), 27 nets.

Other parts of the board:
U$1: INFO_COMPACT
