bfrigon/alarm-clock-hardware/pcb/tests/display-model-a-prog/display_prog.brd

## EAGLE design pcb/tests/display-model-a-prog/display_prog.brd (2014-09-07)

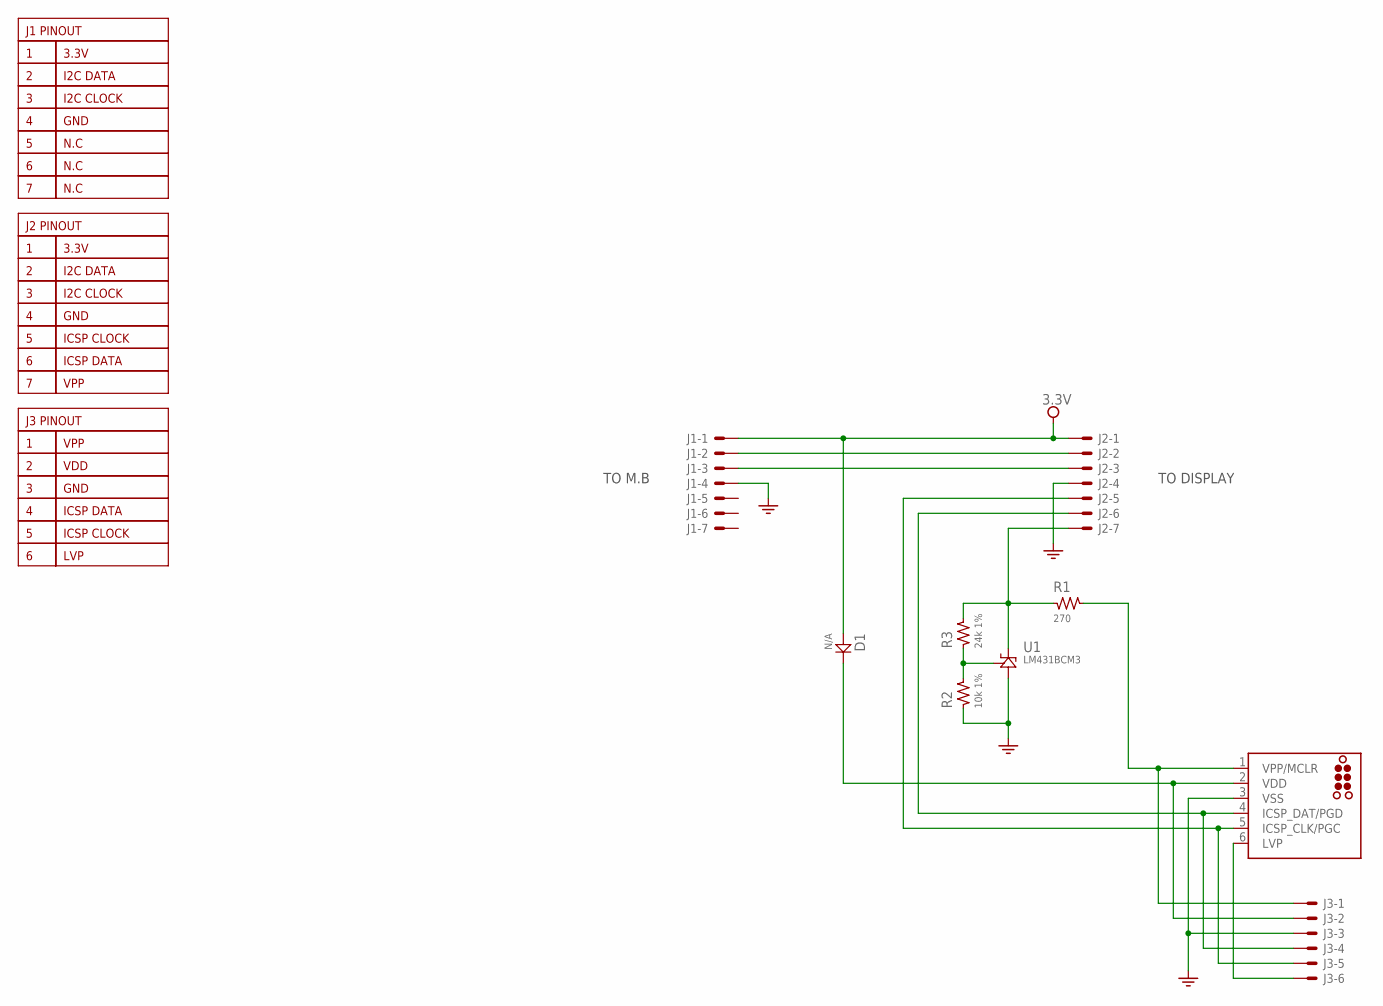
[picture p111: schematic display_prog.sch]

Parts:
D1: N/A; DIODE_0603
J1, J2: SNG-2MM-HEADER-07-V; DF3X-7P-2DSA
J3: SNG-100-HEADER-06-FL-V; 22-23-2061
J4: TC2030-MCP
R1: 270; SMD_0603
R2: 10k 1%; SMD_0603
R3: 24k 1%; SMD_0603
U1: LM431BCM3; SOT23

Connections:
3.3V: D1.A, J1.1, J2.1
GND: J1.4, J2.4, J3.3, J4.3 (VSS), R2.1, U1.3 (A)
ICSP-CLK: J2.5, J3.5, J4.5 (ICSP_CLK/PGC)
ICSP-DAT: J2.6, J3.4, J4.4 (ICSP_DAT/PGD)
unnamed: J3.1, J4.1 (VPP/MCLR), R1.2
unnamed: R2.2, R3.1, U1.2 (ADJ)
unnamed: J2.7, R1.1, R3.2, U1.1 (K)
unnamed: J3.6, J4.6 (LVP)
SCL: J1.3, J2.3
SDA: J1.2, J2.2
VDD_MON: D1.K, J3.2, J4.2 (VDD)

Notes on the sheet:
TO DISPLAY
TO M.B

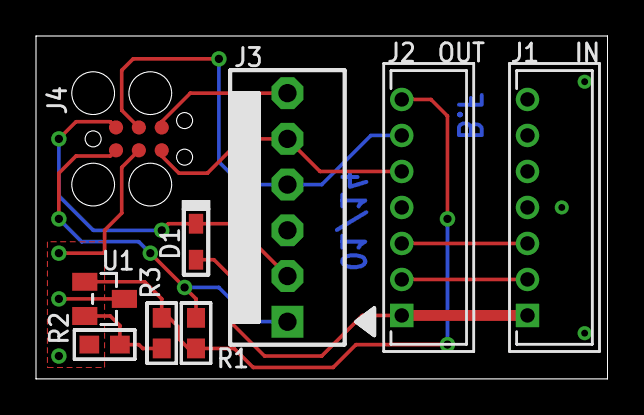
[picture p112: board display_prog.brd from above]

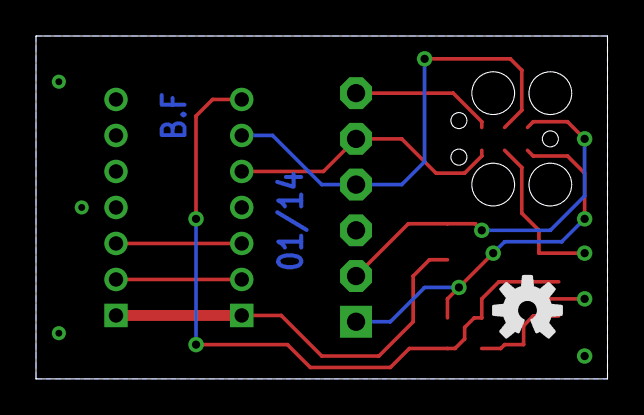
[picture p113: board display_prog.brd from below]

Board: 2 copper layers, 31.8 x 19.1 mm, 12 parts (3 on the bottom side), 11 nets.

Other parts of the board:
U$1: OPENHW_LOGO_150
U$2: INFO_AUTHOR
U$3: INFO_DATE
