bfrigon/alarm-clock-hardware/(commit log)

2014-09-07 Added decoupling caps
    [base.brd, base.sch]
2014-09-09 Cleaned up project tree
    [base.brd, base.sch, bom.csv, bom.ods, controller.brd, controller.sch, digit.brd, digit.sch]
2014-09-18 Added Model B drawings
    [base.brd, base.sch, digit.brd, digit.sch, dots.brd, dots.sch]
2014-10-19 Corrected drawings of touch panel PCB
    [base.brd, base.sch, controller.brd, controller.sch, digit.brd, digit.sch, dots.brd, dots.sch]
2014-10-23 Overlay design
    [touch.brd]
2014-10-28 Changed files for laser cutting to DXF instead of SVG
    [digit.brd, digits_segments_cuts.dxf, enclosure_cuts_back.brd, enclosure_cuts_back.dxf]
2014-12-29 Display base pcb (rev C), Touch panel (rev B)
    [base.brd, base.sch, controller.brd, controller.sch, digit.brd, digit.sch, dots.brd, dots.sch]
2015-01-04 Changed page format on schematics to US letter (8.5" x 11")
    [base.sch, controller.brd, controller.sch, digit.brd, digit.sch, display.brd, display.sch, display_prog.sch]
2015-01-05 Updated mechanical drawings for model B
    [controller.brd]
2015-01-06 BOM for audio test board
2015-01-07 Updated overlay to reflect the changes on touch pcb (rev B)
2015-01-09 Updated drawings to reflect changes on touch keypad PCB (leds on snooze, time and alarm button)
2015-01-25 Added a temperature sensor IC (U9) to controller PCB
    [controller.brd, controller.sch]
2015-02-08 Added battery interface PCB drawings (PC-08, DWG-12)
2015-02-08 modified dimensions of left panel PCB to fit speaker holder
2015-02-08 Added description to each Eagle project directories
    [base.sch, controller.brd, controller.sch, digit.sch, display.sch, dots.sch]
2015-02-08 Created skeleton for PC-08 : Battery interface
    [battery-interface.brd, battery-interface.sch]
2015-02-09 Fixed dimensions error in CLK-DWG-05 (Left panel PCB)
    [left.brd]
2015-02-11 Swapped USBC and USBB, USBC will be used for the PCM2704
    [controller.brd, controller.sch]
2015-02-12 Fixed dimensions error in PC-04 (Left panel PCB)
    [left.brd]
2015-02-12 Switched motherboard (PC-03) to 4 layers design
    [controller.brd, controller.sch]
2015-03-19 Converted motherboard and left-panel project files to Kicad
    [audio.sch, controller.brd, controller.sch, left-panel.kicad_pcb, left-panel.sch, left.brd, left.sch, motherboard.kicad_pcb]
2015-04-06 Changed crystal location for PCM2704
    [audio.sch, motherboard.kicad_pcb, motherboard.sch, peripherals.sch, psu.sch]
2015-04-12 Added bill of material for CLK-PC-03
2015-04-12 Tidy up motherboard schematic
    [audio.sch, motherboard.kicad_pcb, motherboard.sch, peripherals.sch, psu.sch]
2015-04-12 Added BOM for CLK-PC-04
2015-04-12 Updated schematic for CLK-PC-04
2015-04-12 Added components count on CLK-PC-03 BOM
    [left-panel.sch]
2015-04-12 Added 3D views of PC-03 and PC04
    [left-panel.kicad_pcb, motherboard.kicad_pcb]
2015-04-12 Fixed incorrect sheet size for CLK-SCH-03 (Motherboard)
    [audio.sch, peripherals.sch, psu.sch]
2015-04-12 Add gerber files
    [base.gbl, base.gbo, base.gbs, base.gko, base.gtl, base.gto, base.gts, base.xln]
2015-04-12 Added gerber files for PC-04 (Left panel)
    [left-panel.gbl, left-panel.gbo, left-panel.gbs, left-panel.gko, left-panel.gtl, left-panel.gto, left-panel.gts]
2015-04-12 Converted PC-08 (Battery interface) project files to Kicad
    [battery-interface.brd, battery-interface.kicad_pcb, battery-interface.sch]
2015-04-12 Updated drawing for PC-08 (Battery interface)
2015-04-14 Added Debug connector in drawings
2015-04-14 Fixed wrong cap value for C24 and part # for C7,C9
    [audio.sch, motherboard.kicad_pcb, psu.sch]
2015-05-03 Wrong polarity on battery connector label
    [motherboard.kicad_pcb]
