bfrigon/alarm-clock-hardware/(notices)

Notices in the files:
parts and their libraries:
Connectors: ©2009 ROFA.cz
